miclle/discora/hardware/enclosure/README.md

# Discora V4 · 三主体 PLA 外壳

当前操控布局采用 [ADR-0047](../../docs/decisions/0047-control-spacing-and-knob.md)，四键左移4 mm、旋钮右移4 mm并向提手移2 mm，十字增至28 mm。主体配套版本为 **ADR-0046 P3 短渐扩口 + ADR-0045 P2 圆角梯形开放侧口**。三主体、声道连通、左右镜像、装配路径和切片已检查；完整件的打印、支撑清理、装配、强度、温升、密封及声学仍待实测。P3 喇叭安装座试片已打印并确认装配无问题。

- [正式打印套件：11 件 STL、6 盘 3MF](print/README.md)
- [唯一彩色尺寸与装配图册：12 页 A3](drawings/Discora-V4-drawing-book-color.pdf)
- [可编辑 FreeCAD 模型](Discora.FCStd)
- [打印设置、装配顺序与验收](../../docs/enclosure-printing.md)
- [图册内容与生成方式](../../docs/enclosure-drawings.md)

## 当前结构

P1 合并前壳、提手、护网及操控安装座；P2 合并后壳、侧壁、圆角梯形开放侧口、底托与固定座；P3 承担双声腔、独立转弯导管、喇叭安装座和电子托架。P2 是外部箱体，不构成 P3 导管壁，不对 P2/P3 接口增加密封圈或跨件粘接。

P3 双声腔背面齐平，可直接贴打印板。后侧洞洞板固定点为（A，O），世界坐标 X=54、Y=58.56 mm。安装框后缘及螺柱采用斜面与永久连接筋承接，保留已经试装通过的座面、8 个螺柱及盲孔。两根各 Ø1.8 mm 的喇叭线从顶部出线，安装座外周及出线处采用可移除封堵。见 [ADR-0039](../../docs/decisions/0039-p3-flat-back-printing.md)、[ADR-0041](../../docs/decisions/0041-p3-speaker-sealing-and-wire-exits.md)、[ADR-0042](../../docs/decisions/0042-p3-printable-frame-transitions.md)。

主通路名义面积 400 mm²、中心线路径约 46.8 mm，末端最后 4 mm 渐扩至约 587.22 mm²；圆角 R2.2，横截面口沿名义厚 1.8 mm。P2 外口为圆角梯形，外口包络约 38.48×28.20 mm、R5.6；P2/P3 保持 0.7 mm 滑配间隙。原内凹饰片、连接筋及 P2 长短管已经取消。结构尺寸不代表已完成声学调谐。见 [ADR-0043](../../docs/decisions/0043-independent-speaker-ducts-and-open-outlets.md)、[ADR-0045](../../docs/decisions/0045-trapezoid-exterior-outlets.md)、[ADR-0046](../../docs/decisions/0046-p3-terminal-mouth.md)。

P2 四处 P3 固定座保留 8×8×4 mm 三角筋，后斜面两处背锁座保留短加强筋；图册第 10、11 页给出尺寸与工具通路。下方背锁通道深 78.8 mm，需细长螺丝刀，螺钉头径不超过 4 mm。实际扭矩和反复拆装寿命待验。

## 打印件清单

| 成品 ID | 功能 | 数量 |
| --- | --- | --- |
| `FrontShell` / P1 | 前壳、提手、护网、屏幕及四键安装座 | 1 |
| `RearShell` / P2 | 后壳、侧口、底架、电池与光驱固定结构 | 1 |
| `SpeakerCarrier` / P3 | 双声腔、独立导管、喇叭座、功放与洞洞板托架 | 1 |
| `PlayPauseKey` / `EjectKey` / `PrevKey` / `NextKey` | 橙色键体、齐平白色符号 | 4 |
| `ButtonRetainer` | 四键焊线支架 | 1 |
| `DisplayRetainer` | OLED 可拆压框 | 1 |
| `DriveRetainer` | 光驱可拆压条 | 1 |
| `Knob` | 黑色十字旋钮、齐平白色指示条 | 1 |

共 11 件刚性 PLA；软脚垫、OLED 自带玻璃、电子模块、螺钉、绑带和导线另购。正式 3MF 保留材料分区、摆放及支撑设置；P2 两项支撑限制关闭，P3 开启，不能互相套用。

## 尺寸与布局

单位 mm；X 向右、Y 向后、Z 向上，中心面 X=0。除既有操控布局外，外壳、提手、格栅和声学结构按左右镜像设计；内部 SATA 和电子接口按实际位置避让。

| 对象 | 当前名义尺寸或位置 |
| --- | --- |
| 整机 | 宽 170 × 深 93 × 高 243.263，含脚垫；不含脚垫高 240.263 |
| 主体壁厚 | 前壳、后壁、侧壁、底板及后斜顶 5；局部安装结构另计 |
| 前／后斜肩 | 水平宽 44，斜宽 53.976，角度 35.395° |
| 提手 | 净开口 90×24，上下横梁各 10.5，顶面 Z=241.263，厚 5 |
| 碟口 | 水平投影 124×5.5，中心 Y=79.05，竖直退碟 |
| 中央格栅 | Ø130 正面圆口；护网底片 Ø136、内凹 2.5、厚 2.5；孔径 Ø1.88、孔距 2.9 |
| 单只喇叭包络 | X/Y/Z=45/41/80，中心 X=±26、Z=76，贴合面 Y=10；前深 2、后深 39 |
| 喇叭安装座 | 开口 71.5×39.3（Z×X）、R12.5；孔距 70×36；Ø2.3 盲底孔深 10.5 |
| 单侧声腔及导管外包络 | 79.3×57.5×89，Z=31.5…120.5；这不是净声学容积 |
| UJ-898 | 最大包络 128×10.8×130，Y=76.2…87、Z=29.5…159.5；后壁垫片预留 1 |
| SATA 接头与线缆 | 接头 37.7×7、后伸 20.4；线缆侧伸 14.5，侧壁净空 1.5；实际弯折待验 |
| 电池 | 平排 5600 mAh，112×70×20，X=±56、Y=6…76、Z=8…28 |
| 洞洞板 | 主板形 100×55×1.6；含左耳整体宽 111，右前缺口 16.75×32；板底 Z=142.8 |
| PCB 音量模块 | 板 35×26.2×1.5；含插头／引脚总厚 15，整体绕轴转 90° |
| OLED | PCB 35.4×33.5×1.2；玻璃内退 1，四点定位、可拆压框 |

光驱测量见 [UJ-898](../MATSHITA-UJ-898/README.md)；喇叭数据及试片结果见 [喇叭](../Speaker-80x45-4ohm-10W/README.md)；板卡与线束见[洞洞板布局](../../docs/perfboard-layout.md)。模型中的最大硬件包络、工具包络和线缆预留用于几何检查，不能代替实际接口、线规和弯折测量。

## 验证与重现

当前 CAD SHA-256：`2d704f403a48870832338c8d0ac6c0f71b357f08b3bdcb7c0f777cb0e19f9003`。

- [正式打印包检查](print-release-checks.json)：11 个闭合网格、六盘 1180 层、材料与支撑参数、文件摘要、零网格修复。
- [整机检查](validation.json)：44 个成品对象、有效实体、已定义干涉及左右对称检查。
- [七条拆装路径](assembly-paths.json)：断线、卸紧固件及对应前置拆卸条件下通过；抬升和旋转采样不等于连续运动证明。
- [当前洞洞板与线束检查](current-perfboard-checks.json)：三点固定、导线预留、60 mm 维护位及按序拔插；实际线束应力和手指握持未测。
- [P3 声道及末端](p3-terminal-mouth-checks.json)：有效连通气路、独立声腔、完整出口投影、座面保持和原 18 处悬空复核。
- [P2 开放侧口](p2-trapezoid-outlet-checks.json)：侧口收口支撑审核；通过 P3 报告的 P2 零差集衔接至当前版本。

历次 ADR 与检查报告保留设计取舍和对应版本的证据，不作为当前打印文件入口。图册以当前保存实体重新投影，通过 [操控布局检查](control-layout-checks.json) 衔接历史图册证据；旋钮的材料面序由当前双色导出检查记录。

整机生成入口为 [build.FCMacro](build.FCMacro)，保存模型后用 [validate.FCMacro](validate.FCMacro) 及相关检查脚本验证。导出、切片命令见[打印说明](../../docs/enclosure-printing.md#重现)，出图命令见[图纸说明](../../docs/enclosure-drawings.md#更新图册)。日常复查输出到 `tmp/`，不要覆盖含调整前基线的历史报告。所有切片脚本仅在本机运行，不连接打印机。
