miclle/discora/hardware/Potentiometer-B50K-Switch/README.md

# B50K 双联带开关电位器／PCB 插接模块

## 当前选型：PCB 插接模块（2026-11-14）

用户改选照片中的 B50K 插接模块，并确认以下尺寸。此前裸电位器商品链接及特性表属于历史选型，**不是新模块的商品来源或额定值证明**。

| 项目 | 用户确认值 |
| --- | --- |
| PCB 宽 × 沿轴深度 × 板厚 | 35 × 26.2 × 1.5 mm |
| 垂直 PCB 的总厚度 | 15 mm，已含引脚和插好后的插头；不额外叠加插头厚度 |
| 轴 | 总长 15 mm，其中花轴长 10 mm |
| 对齐 | 轴线沿 PCB 宽度居中；PCB 靠轴端板边与电位器安装面齐平 |

照片中 PCB 与轴平行。CAD 将组件绕固定轴线转 90°，使板宽沿前斜面上下方向展开，避开主控元件包络。安装前断开线束，先将组件和螺母固定，再按实物关断止挡对准旋钮指示条压入；插拔时托住 PCB。拆卸时先取下整个前壳，再拆旋钮、螺母并将模块向内退出，不在机内直接后拔。板上两个孔没有尺寸依据，不增加假定孔位或螺柱。

主体 9.5×14.5×11.2、轴径 Ø5.8、螺纹 Ø6.8×5、螺母及主体引脚侧偏心 2.7 mm 沿用旧选型名义值，尚未作为新模块实测确认；PCB 示意贴靠原主体引脚面。插座及板底引脚使用矩形预留体，不代表真实针序、轮廓或焊盘。干涉检查填满完整 35×26.2×15 包络，不利用简化形状空隙；远端线束走线、拔插操作行程及电气兼容性仍需实物确认。

当前机械适配和检查见 [ADR-0036](../../docs/decisions/0036-pcb-volume-module.md)、[检查报告](../enclosure/volume-pcb-checks.json)。新模块尚未实物装配或通电验收。

## 历史裸电位器资料

记录日期：2026-11-10。用户选定用于 Discora 音量调整的[淘宝商品及 SKU](https://item.taobao.com/item.htm?id=630267024761&skuId=4742190163296)。页面自动读取失败；型号和尺寸来自用户提供的数据及[商品参考图](supplier-reference.png)，不视为独立核验的厂家图纸。

## 尺寸依据

单位 mm。用户确认可旋转花轴外径为 5.8，轴心到主体引脚侧外壁距离为 2.7；随后补充螺母对边 9.8、厚 1.9。

| 项目 | 用户提供尺寸 |
| --- | --- |
| 型号／结构 | B50K，双联，8 脚，带开关 |
| 从主体安装面到轴端 | 15 |
| 螺纹段 | 长 5，外径 6.8；牙距未提供 |
| 可旋转花轴 | 长约 10，齿顶外径 5.8；齿数／齿形未提供 |
| 主体 | 长 11.2 × 宽 9.5 × 高 14.5 |
| 引脚 | 在宽 9.5 的侧面，向外伸出 3.5；精确脚距和排布未提供 |
| 轴偏置 | 轴心距引脚侧外壁 2.7 |
| 六角螺母 | 对边 9.8，厚 1.9；对角由正六边形推导约 11.316 |

CAD 将 14.5 解释为沿轴方向的主体高度，9.5 为引脚面的横向宽度，11.2 为从引脚侧到对侧的长度。局部 X 向右、Y 向壳内、Z 沿斜面朝上：主体 X=−4.75…4.75、Y=3.6…18.1、Z=−2.7…8.5；引脚朝斜面下方。该方向是安装设计，不是从图片推断的引脚编号。

## 电气、机械与耐久特性原图

用户随后补充了[商品特性表原图](supplier-characteristics.png)，包含电气、机械和耐久三部分。**表中总阻值为 10K，而本次选定型号为 B50K；两者不是同一标称阻值，尚未确认该表是否覆盖所选 SKU。** 下表只转录图片，不将其全部升格为 B50K 的已确认规格，也不改动已选型号。原图哈希与差异说明已补入 `source.json`。

| 图片项目 | 图片所列值／说明 |
| --- | --- |
| 总阻值／容差 | 10K；±20% |
| 阻值曲线 | B taper；未附完整曲线图 |
| 电阻体额定功率 | B taper：0.05 W；其它 taper：0.02 W |
| 最大工作电压 | 50 V AC / 10 V DC；与开关额定值是不同条目 |
| 残留电阻 | R1-2 ≤10 Ω；R2-3 ≤20 Ω；编号不能直接映射实物引脚 |
| 旋转杂音 | ≤100 mV；测量电路／条件未随图提供 |
| 双联同步误差 | “/”，未提供指标 |
| 绝缘与耐压 | 绝缘电阻图示 >100 MΩ，DC 250 V；耐压 AC 250 V，1 分钟 |
| 开关接触电阻 | ≤100 mΩ |
| 开关额定负载 | 1 A at DC 12 V；尚未确认适用本次 B50K |
| 总旋转角度 | 300° ±10° |
| 旋转力矩 | 20～200 gf·cm |
| 开关旋转角度／作动力 | ≤50°；≤500 gf·cm |
| 止挡强度 | 图示 >4 kgf·cm |
| 轴推拉强度 | 原图写作 >10 kgf·cm，推拉力使用力矩单位存在疑点，保留原文待供应商确认 |
| 轴摆动 | ≤0.7 × L / 20 mm（p-p），L = shaft length；L 的具体取值基准未提供 |
| 旋转寿命 | 图示 >10,000 次；试后阻值变化 ±15% 内、旋转杂音 ≤150 mV |
| 开关寿命 | 图示 >10,000 次 |
| 工作温度 | −10～+70 °C |
| 焊接耐热条件 | 自动焊：260±10 °C、3±1 秒；手工焊：300±5 °C、3±1 秒；测试位置见原图 |

以上均为供应商图示值，非 Discora 实测。1 A / DC 12 V 是开关条目，不能用电阻体的 50 V AC、耐压 AC 250 V 或绝缘测试 DC 250 V 替代。该表未解决 B50K 型号对应、整机启动电流或主电源开关选型问题；本次只归档，不改变供电方案。CAD 的连续 360° 外包络检查保守覆盖图示 300°±10° 行程，不以此声明实际电位器可无限旋转。

## 项目接入与状态

- 选型及几何适配为 `implemented`；实际安装、接线和音量／开关功能尚未 `bench-tested`。
- 此元件替代此前“拆下功放原电位器”的机械占位方案；与功放原焊盘的电气替换关系仍待核对。
- 照片标注双联 8 脚、带开关；不从照片指定 L/R、滑动端或开关脚号。上电前用万用表确认两组三端及开关触点、旋转方向、阻值变化和断开位置。
- 补充特性表给出开关 1 A / DC 12 V，但该表为 10K 且与 B50K 的对应未确认，不把开关直接定义为整机电池主电源开关；本次没有修改供电接法或固件。
- B50K 标识不替代实测阻值曲线、双联跟踪误差与功放输入兼容性验证。

## 安装

前壳通孔 Ø7.2，外侧凹位底径 Ø24.8、深 1.6，入口 0.4 倒角扩至 Ø25.6；主体安装面在深度 3.6，因此凹位底与主体之间仍保留 2 mm 夹持面。螺纹 5 − 面板 2 − 螺母 1.9 = 1.1 mm 伸出余量，不含另加垫圈。主体侧隙名义 0.3；引脚 3.5 mm 包络外再留 3.8 mm 焊线区域。矩形主体槽辅助限转，螺母承担夹紧，实际锁紧力及 PLA 抗蠕变待验证。

旋钮改为 Ø24×1.4 薄底盘、跨度 24／臂宽 6.8 的细圆角十字。底盘下沉 1 mm，顶面高出面板 12.9，零件总高 13.9；凹位底间隙 0.6、径向间隙 0.4。短锥形根部封闭螺母腔，底部 Ø12 避让腔包容螺母及螺纹。顶部 0.7×2.2 mm 指示条采用深 0.6 mm、与顶面齐平的白色 PLA 实体，与黑色主体双色打印。

按用户要求取消侧面螺钉孔，直接压入花轴。Ø6.0 基孔内有六条 0.6 mm 宽压配筋，筋尖内切直径 5.6；对 Ø5.8 花轴圆柱包络形成最大 0.1 mm 径向名义过盈，实际由花轴局部压溃／咬合筋尖，不伪造未知的齿形和齿数。孔顶距轴端 0.3、顶部最薄 1.2。先用 5.5／5.6／5.7 三档筋尖直径试片核对松紧，再试印完整旋钮验证开关力矩、保持力及反复旋转；不能只凭 CAD 过盈声明压配成功。

模型、检查及装配顺序见 [ADR-0032](../../docs/decisions/0032-b50k-cross-knob.md)。图像原样保存，来源与哈希见 [source.json](source.json)。
