miclle/discora/hardware/TPA3118D2/README.md

# TPA3118D2 功放板资料

整理日期：2026-11-03。用户已有并选为当前首选的 [淘宝商品](https://item.taobao.com/item.htm?id=591057362413)，随附图片标识为 SKU 009169。图片来自用户导入的卖家资料；与实物的版本对应关系仍待核对。2026-11-07 台架 PCM5102A → 本功放 → 双喇叭已完成短时立体声试听，完整功率、散热和整机验收未完成，见[音频记录](../../docs/records/2026-11-07-cybertrack-audio-crosscheck.md)。

## 保留文件

| 文件 | 用途与边界 |
| --- | --- |
| [卖家参数表](amplifier-supplier-specifications.jpg) | 保留商品标称及来源证据，不作为实测指标 |
| [背面尺寸图](amplifier-back-dimensions.jpg) | PCB 标称 66 × 53 mm，背面接口丝印和安装孔位置参考；不提供精确孔距或整板总包络 |
| [正面接口图](amplifier-front-connections.jpg) | 音量旋钮、3.5 mm／三针音频输入、电源口和左右喇叭端子位置参考 |
| [原件校验与整理记录](readback.json) | 原图名称、当前名称、字节数、SHA-256 和归档统计 |

## 使用边界

- 参数表中的“2 × 45 W”“DC12V–28V（推荐 24V）”“3A”等均为卖家标称，负载、失真、持续输出及散热条件未核实；不据此确定工作电压或电源规格。
- 需实物核对芯片丝印、PCB 版本、电源极性、输入引脚顺序、端子、总高度及安装孔距。照片不能替代实物逐项检查。
- 66 × 53 mm 是卖家标注的 PCB 尺寸，不包括旋钮等突出部分；2026-11-05 的 [V4 紧凑布局](../enclosure/README.md)已改用横置 66 × 53 mm PCB，板上元件高度暂留 15 mm、两侧接头各留 15 mm；这些额外尺寸是设计预留，未实测。
- 既定连接为 DAC 模拟 L/R 输出接功放输入，BTL 喇叭端按各自正负极接线；具体电源与接入验收以 [硬件清单中的功放选型](../../docs/hardware.md#功放选型tpa3118d2短时试听通过) 和 [音频验收说明](../../docs/audio-output.md) 为准。

## 分离音量电位器的布局规划

此前允许将板上原电位器拆下并引线安装；2026-11-10 用户改为选定独立的 [B50K 双联带开关电位器](../Potentiometer-B50K-Switch/README.md)。前壳与十字旋钮已按用户提供的尺寸适配，见 [ADR-0032](../../docs/decisions/0032-b50k-cross-knob.md)。机械模型不证明与本板原电位器的阻值、曲线或焊盘一致；两组三端、开关触点、排线和原板接入方式仍需实物核对，尚未拆焊或完成新电位器通电验收。补充的 10K 特性表标注开关 1 A / DC 12 V，但与所选 B50K 对应未确认，本次不确定其整机供电用途。

冗余宣传主图已移出项目。整理前四张原图及逐文件清单保存在仓库外归档 `discora-hardware-2026-11-03`，具体位置见本次交付记录。保留图片仅重命名，内容及权利标识不变；不将卖家资料视为本项目实测证据。

2026-11-14 用户改选带 PCB 插座的 B50K 模块（35×26.2×1.5，含插接总厚15）；机械适配见 [ADR-0036](../../docs/decisions/0036-pcb-volume-module.md)。插座不改变上述电气核对要求，也不证明开关可直接承担整机供电。
