miclle/discora/hardware/OLED-1.3-128x64/README.md

# 1.3 英寸 OLED 模块资料

整理日期：2026-11-03。来源为用户导入的中景园厂商资料及商品图片，对应采购记录的 [淘宝商品](https://item.taobao.com/item.htm?id=535844615619)。商品页未独立核实，所选 SKU 和到货实物仍待确认。以下内容属于供应商资料，不代表 Discora 已完成硬件验收；2026-11-04 已实现 SH1106 显示驱动，2026-11-08 用户确认实物为 SH1106，通信及无介质画面通过。

## 保留文件

| 文件 | 用途与边界 |
| --- | --- |
| [模块规格书](datasheets/ZJY130I0400WG02.pdf) | 带 PCB 的四针 IIC 模块；第 6 页为结构图，第 7 页为接口和地址选择图片 |
| [SH1106 控制器手册](datasheets/SH1106.pdf) | 控制命令、显存及通信协议参考；不能单凭随附手册确认实物芯片 |
| [裸屏规格书](datasheets/1.3-ZJY130-2864KSWLG01.pdf) | 裸屏及 FPC 的尺寸、电气和接口资料；不等于带 PCB 的模块尺寸或供电条件 |
| [商品规格图](oled-module-specifications.webp) | 型号、显示区域、板尺寸及 SKU 差异的卖家说明 |
| [正反面与接口图](oled-module-interfaces.webp) | 排针顺序、地址选择焊桥、板卡外观；保留原始错误标注供追溯 |
| [尺寸与接线图](oled-module-dimensions-wiring.webp) | 安装孔、显示区域、排针和侧视包络参考 |
| [原件校验与整理记录](readback.json) | 原始文件名、当前路径、字节数、SHA-256 和归档统计 |

## 供应商资料与待确认项

- 模块结构图标注 SH1106、128 × 64、IIC，PCB 35.4 × 33.5 mm，显示区域 29.42 × 14.7 mm；这些是图纸值，不是实测尺寸。
- 模块规格书第 6 页标注 SH1106，第 24 页注意事项却出现 SSD1306；商品规格图还提到可向客服选择 SSD1306。不能把不同型号的命令和初始化序列混用，最终以所选 SKU、实物及显示测试确认。
- 模块图示排针顺序为 VCC、GND、SCL、SDA；商品图另说明可提供 GND、VCC 顺序的版本，接线前须看实物丝印。
- 商品接口表将 SCL、SDA 写成 SPI 信号，与模块 IIC 标注不一致；不能据此改接为 SPI。
- 模块结构图标注 3.3 V，商品图写 3.3–5 V；板级稳压、上拉电源和信号电平均待确认，商品供电范围不等于 ESP32-S3 GPIO 可承受的电压。
- 驱动采用 7-bit 地址，默认 0x3c、可配置 0x3d；不填含读写位的 0x78／0x7a。2026-11-04 已实现 GPIO10 SDA／GPIO11 SCL 的 SH1106 驱动，2026-11-08 的 0.12.2 配置在 0x3c 初始化成功，用户确认无介质画面文字清晰完整，见[记录](../../docs/records/2026-11-08-buttons-oled.md)。

## 外壳机械适配

2026-11-10 已按[尺寸与接线图](oled-module-dimensions-wiring.webp)的结构图更新 CAD：PCB 35.4 × 33.5 × 1.2 mm，四孔 Ø3、孔距 30.4 × 28.5，玻璃 34.5 × 23 × 1.4，有效区 29.42 × 14.7，以及 14 × 4 下缘缺口。有效区中心比 PCB 中心高 2.05 mm，保持机身 X=0 居中；内喉口 30.42 × 15.7、R0.6，外口 32.82 × 18.1、R1.8；玻璃前面内退 1.0 mm。

内侧沉槽、四个 Ø2.6 定位柱、可拆压框和弯针接头包络已加入模型；压框两侧用名义 M2×6 锁紧，避免近外表面安装时螺钉穿透正面。侧视 11.3 mm 按玻璃前面至针尖解释；接头塑壳截面、插线空间和螺钉／工具尺寸另标为设计预留。详见 [ADR-0028](../../docs/decisions/0028-oled-mechanical-mount.md)及[保存模型检查](../enclosure/oled-checks.json)。这仍是供应商图纸与 CAD 证据，实际模块尺寸、插头、打印孔补偿和螺钉配合待试装。

## Discora 接线规划

2026-11-04：规划 ESP32-S3 **3V3 → VCC、GND → GND、GPIO11 → SCL、GPIO10 → SDA**。GPIO10／11 已在主控供应商图纸引出，未占用当前音频与按键引脚；接线对应 `implemented` 的 SH1106 驱动，播放器配置默认启用；2026-11-05 的未接屏配置探测超时；2026-11-08 已接屏并重新启用，0x3c 初始化与无介质画面通过，随后盘尾 TRACK 01／STOPPED 也获确认；完整动态显示待验收，见 [显示说明](../../docs/oled-display.md)。

上电前确认模块支持 3.3V、实物 VCC/GND 顺序、板载上拉连接到 3.3V，以及主控供电余量。SDA/SCL 不得上拉到 5V，不能从 DAC 的 A3V3 给屏幕供电。控制器、实际地址和显示效果仍待核对。逐线说明及唯一展示的整机接线图见 [整机文档](../../docs/wiring.md#13-英寸-oled-四线接线implemented实屏待验收)。

OLED 可以从开发板 3V3 取电；接入后检查负载下电压、主控复位与稳压器温升。它与 DAC 的 5V 分支可以共享同一上游电源，不要求两个独立电源。开发板的 5Vin／IN-OUT 限制只涉及相应 5V 路径，不能把 5Vin 当成 OLED 的 3.3V 接点，详见 [开发板取电说明](../../docs/wiring.md#开发板取电3v35vin-与-in-out)。

## 已归档内容

`02-1.3OLED程序源码/`、`03-OLED取模教程/` 及 `.DS_Store` 已移出项目。跨平台例程、配套库、构建产物、IDE 配置和 Windows 取模工具不作为本项目依赖。抽查 Arduino 例程声明只供学习、其他用途需作者许可；不直接复制到固件或作为公开仓库源码发布。

整理前完整原件及逐文件清单保存于仓库外归档 `discora-hardware-2026-11-03`，具体位置见本次交付记录。保留 PDF 和图片仅重命名或保持原路径，内容及原有权利声明不变；资料留存不代表新增再分发授权。采购与验证边界见 [硬件清单](../../docs/hardware.md)。
