miclle/discora/hardware/ESP32-S3-N16R8/README.md

# Discora — ESP32-S3 N16R8 板卡资料

整理日期：2026-10-31。本目录只保留 Discora 接线、引脚分配和尺寸核对所需的资料。供应商图纸标注 `ESP32-S3-COREBOARD` / `V1.4`；当前实物的 PCB 修订版尚未确认，不能直接套用乐鑫官方 DevKitC-1 的板级定义。第三方资料保留原始字节，其标识和权利不变。

## 保留文件

| 文件 | 用途与边界 |
| --- | --- |
| [V1.4 原理图](ESP32-S3-SCH-V1.4.pdf) | USB、供电、串口桥及排针连接的主要参考；不代表实物逐网一致 |
| [另一版本原理图](ESP32-S3-SCH.pdf) | Discora 首次上板记录已引用；与 V1.4 文件不同，保留用于图纸对照与历史追溯 |
| [毫米尺寸图](ESP32-S3-Metric.pdf) | 板轮廓、排针间距和图示天线伸出；不含整板高度、安装孔径和装配公差 |
| [芯片技术规格书](ESP32-S3开发板.pdf) | 实际内容为 ESP32-S3 系列芯片技术规格书 v2.2，不能替代板级图纸 |
| [正面参考照片](ESP32-S3-front.jpg) / [背面参考照片](ESP32-S3-back.jpg) | 随资料导入的板卡外观、接口和丝印参考；未确认与当前 Discora 实验板为同一实物 |
| [结构化板卡摘录](board-data.json) | 图纸排针、标称尺寸、资源限制及本项目候选音频引脚；不继承其他项目的验证结论 |
| [原件校验清单](readback.json) | 六份原件的 SHA-256、大小及压缩包成员比对结果 |
| [清理记录](cleanup-record.json) | 删除文件的路径、大小、哈希及原因；此清单不包含可恢复的文件内容 |

## Discora 使用的接口

方位以元件面朝向观察者、天线在上、USB 口在下为准；背面视图左右相反。

| 接口或资源 | 图纸连接 / 当前用途 |
| --- | --- |
| COM / USB1 | 图纸经 CH343P 接 UART0 GPIO43/44；Discora 用作电脑烧录及日志口 |
| USB / USB2 | D− 接 GPIO19，D+ 接 GPIO20；Discora 用作原生 USB Host |
| USB-OTG | 0 Ω 支路与 D2 并联，连接 USB2 VBUS 与板上 5V；**不是 GPIO3 接地选项** |
| USB-JTAG | 另一条 GPIO3 配置支路，经 R11 10 kΩ 接 VDD33 |
| IN-OUT | 与排针 5Vin 支路 D3 并联；与 USB-OTG 为不同支路 |
| GPIO4 / 5 / 6 | 当前 I²S 诊断的候选 BCLK / LRCK / DATA；可配置，尚未完成 DAC 接线验收 |
| GPIO35 / 36 / 37 | N16R8 八线 PSRAM 资源，不能因图纸引到排针便用于外设 |
| GPIO0 / 3 / 45 / 46 | 启动绑带，保留；GPIO48 为板载 RGB，GPIO39–42 涉及 JTAG |

完整排针顺序见结构化摘录和原理图。供应商毫米图的底板标称长宽为 57.15 × 27.94 mm，含图示天线总长 63.39 mm，两排针中心距 25.40 mm，22 针首末间距 53.34 mm。它们不是当前实验板的实测包络。

旧索引误将 USB-OTG 归入 GPIO3 接地配置，本次已按原理图纠正。供电桥接会改变隔离路径；实际接线和已测边界以 [组装说明](../../docs/assembly.md)、[首次上板记录](../../docs/records/2026-10-31-m1-first-boot.md) 和 [空 Hub 记录](../../docs/records/2026-10-31-m1-empty-hub.md) 为准。音频接线见 [DAC 输出准备](../../docs/audio-output.md)，工程进度见 [当前状态](../../docs/status.md)。

## 外设取电与 5Vin 注意事项

V1.4 图纸的 J1-21（5Vin）经 D3 向板内 5V 供电，`IN-OUT` 并联旁路 D3。**仅 COM USB 供电且 IN-OUT 断开时，不能默认从 5Vin 排针向外供电。**IN-OUT 接通会取消这一路二极管隔离，不是稳压或限流；不要为取电直接短接，也不要与 USB-OTG（D2 旁路）混淆。实物版本、焊装和通断须核对。

OLED 可从 3V3 取电；DAC 使用已确认的 5V 支路。先核对输入供电和稳压余量，测量空载及接入模块后的电压、观察复位和温升。无可用 5Vin 输出时，可从同一已确认的稳压 5V 电源分支供 DAC 并共地；不同电源正极不直接并联。完整条件见 [整机供电说明](../../docs/wiring.md#开发板取电3v35vin-与-in-out)。

## 已清理的内容

- 供应商 ZIP/RAR 套包：所需图纸已独立保留，V1.4 原理图和毫米图已重新逐字节核对包内成员一致。
- MicroPython 固件、Python/Arduino 例程和环境安装说明：Discora 使用自己的 ESP-IDF 固件。
- 商品宣传图、通用模组对比图、重复的 mil 尺寸图，以及本地过时元数据。
- 随目录导入的其他项目启动、内存和 BOOT 停止验证报告及日志：不能作为 Discora 验收证据。

Discora 自身的实验记录保留在 `docs/records/`。本次只整理资料，没有连接设备、烧录或新增硬件验收结论。

## GPIO7 退盘输入

Discora 0.9.0 默认查询/播放器使用 GPIO7（图纸 J1-7）作为内部上拉输入，常开轻触按键接到 GND。它与 GPIO4/5/6 音频默认值不冲突；基本按键触发及实际退盘已获用户成功反馈；板卡逐网、电气测量及其余场景未验收。见[接线与配置](../../docs/eject-button.md)。

## GPIO8／GPIO9 换轨输入

Discora 0.9.1 播放器模式使用 GPIO8（J1-12）上一曲、GPIO9（J1-15）下一曲，分别常开按键接 GND、内部上拉。查询模式禁用；软件时钟播放器已部署，三路 GPIO 初始化通过，实体按键换轨未验收，排针位置依据供应商资料，以实物丝印为准。见[换轨接线与配置](../../docs/track-buttons.md)。

## 四键相邻排针（0.12.1）

当前四键 profile 使用右排 J2-4～7，依次 GPIO1 播放／暂停、GPIO2 上一曲、GPIO42 下一曲、GPIO41 退碟；J2-1 为公共地。连续四个信号可合成排线，GPIO41／42 配成普通上拉输入，不与外部 JTAG 共用；无需改变 eFuse 或供电焊桥。旧查询／播放器默认针序仍保留，部署须选择匹配的四键 overlay。实物接线与测试待后续，见[四键说明](../../docs/playback-controls.md)。
