miclle/discora/docs/hardware.md

# 实验硬件与电源

## 硬件清单（选型与验收分开记录）

当前台架接法及实验结论见[工程状态](status.md)；商品标称、电气测量和最终机内装配分别记录。

| 部件 | 候选 | 现状与注意 |
| --- | --- | --- |
| MCU | ESP32-S3 开发板，4 MB Flash 或以上 | 选有 USB OTG 引出的型号；部分接口仅为 USB-UART |
| 光驱 | [MATSHITA DVD-R UJ-898](../hardware/MATSHITA-UJ-898/README.md) | 已有；吸入式、SATA/ATAPI、支持光盘刻录；2026-11-11 实物照片与 A–F 尺寸已归档，2026-11-12 CAD 已按实测适配，采用后壁贴靠和两螺钉压条，实物装配仍待验证 |
| 桥接器 | SATA → USB 光驱适配器 | 已有；确认可透传 SCSI/MMC |
| DAC | PCM5102 / PCM5102A 立体声 I²S 模块 | 已记录 PCM5102 商品，见下方采购清单；用户已确认到货，已保存正反面参考图，确切模块待核对，线路输出需接有源设备 |
| 功放 | TPA3118D2 双声道模拟输入 Class-D 功放板 | 用户已有；已接 PCM5102A 完成短时立体声试听，额定功率、温升及整机验收仍待测 |
| 喇叭 | 80 × 45 × 42 mm 全频大动态钕磁单元 | 单只标称 4 Ω、10 W、峰值 18 W；用户资料已记录，商品参数及新箱体声学未验收，概念 CAD 已有双声腔 |
| 5V 供电 | DCE001 固定 5V 降压模块 × 2 | 用户已选定，分别供主控与光驱；接入为 planned，自然散热按商品要求在 2A 内，光驱峰值与温升待测，见[模块资料](../hardware/DCE001-5V/README.md) |
| 电池包 | 18650 三串两并，5600mAh 成品包 | 用户已选定淘宝 SKU，报价 ¥59.22；标称 11.1V、约 62.16Wh，接入为 planned，详见[电池资料](../hardware/Battery-3S2P-5600mAh/README.md) |
| 输入 | 12 × 12 mm 轻触按键 × 4，音量操控另计 | 播放／暂停、上一曲、下一曲、退碟；用户提供整体厚 6、凸起高 2.8、引脚长 3.7 mm，见[按键尺寸与照片](../hardware/Tactile-Switch-12x12/README.md)；6 mm 已确认包含凸起，本体按 3.2 mm；四键 CAD 已实施，实际圆头、引脚和装配待核对，非 M0 必需 |
| 音量 | [B50K 带开关 PCB 插接模块](../hardware/Potentiometer-B50K-Switch/README.md) | PCB 35×26.2×1.5、含插头／引脚总厚15、轴长15／花轴长10；绕轴90°安装；原主体、轴径与螺纹沿用名义值，电气及实物配合待验收 |
| 刻录源 | microSD 模块 | 仅 M4 研究时需要 |

## 硬件采购清单

| 记录日期 | 商品名称 | 商品链接 | 用途 | 数量／实付价格 | 采购与验收状态 |
| --- | --- | --- | --- | --- | --- |
| 2026-11-03 | PCM5102 音频立体声数模转换器 DAC 解码板 | [淘宝商品（967516294822）](https://item.taobao.com/item.htm?id=967516294822) | 用于 ESP32-S3 I²S 转双声道模拟线路输出 | 未提供 | 用户已确认到货；已保存参考图和 31 × 17 mm 图示尺寸，短时台架立体声输出已实测；独立电气指标与完整稳定性未验收 |
| 2026-11-03 | 1.3寸OLED显示屏12864液晶屏模块IIC接口 sh1106 sd1306串口屏 | [淘宝商品（535844615619）](https://item.taobao.com/item.htm?id=535844615619) | 拟用于曲目与播放状态显示 | 未提供 | 已接入 SH1106 驱动，用户确认无介质及盘尾停止画面；完整动态显示待验收 |
| 2026-11-03 | TPA3118D2数字功放板2.0双声道2\*45W发烧音频放大板高清DC24V | [淘宝商品（591057362413）](https://item.taobao.com/item.htm?id=591057362413) | 接 DAC 模拟 L/R 输出，驱动左右无源喇叭 | 未提供 | 用户确认已有；短时台架试听通过，功率／温升等指标待测 |
| 2026-11-05 | 全频大动态钕磁喇叭／双单元无源音箱 | [淘宝商品（1021101388923）](https://item.taobao.com/item.htm?id=1021101388923) | 拟使用其中的左右单元，为 CD 机重新设计箱体 | 未提供 | 已记录用户参数及三张参考图；下单、到货状态未提供，电气与声学未验收 |
| 2026-11-05 | 12V 18650 锂电池组，5600mAh 成品包 | [淘宝商品／SKU 5651022295757](https://item.taobao.com/item.htm?id=733234510026&skuId=5651022295757) | 便携播放供电，外围另配 Type-C 充电及稳压模块 | 数量未确认；用户提供报价 ¥59.22，非已确认实付 | 用户已选定；下单及到货未确认，容量、持续电流、保护功能和装配未验收 |
| 2026-11-07 | DCE001 迷你 DC-DC 降压模块，输入 5.5–30V、固定输出 5V | [京东商品（10228520023322）](https://item.jd.com/10228520023322.html) | 电池降压，主控和光驱各用一块 | 选定 2 块；实付未提供 | 用户已选定；已读取所选 SKU 并保存用户参数截图，下单、到货及带载未确认，见[模块资料](../hardware/DCE001-5V/README.md) |

商品名称与链接由用户提供；此前淘宝商品页未能读取，DCE001 京东所选规格已于 2026-11-07 读取，参数截图已归档；供应商标称均不等于实测验收。具体芯片型号（PCM5102 / PCM5102A）、板级供电、I²S 引脚与电平、模拟输出接口及跳线设置，按卖家资料和到货实物核对；接线与验收步骤见 [音频输出准备与到货验收](audio-output.md)。

显示屏商品名称按用户提供的标题记录，其中同时出现 OLED、液晶屏及 `sh1106`、`sd1306` 字样；商品标题不作为芯片身份依据。当前已按 SH1106 128×64、I²C 0x3c 驱动，并获得无介质及盘尾停止画面的用户确认；接线为 3.3V、GPIO10／11。独立芯片鉴定和所有动态画面未完成，见 [OLED 显示说明](oled-display.md)。

2026-11-03 已整理用户导入的 [OLED 模块资料](../hardware/OLED-1.3-128x64/README.md)、[DAC 芯片手册](../hardware/PCM5102-DAC/README.md) 和 [功放板图片](../hardware/TPA3118D2/README.md)。保留原件内容、来源说明及摘要校验，跨平台例程和取模工具归档到仓库外。OLED 资料存在芯片、接口和供电标注不一致；DAC 手册正文为 PCM510xA 系列，尚不能确认实物芯片后缀。资料核对不改变硬件验收状态。

2026-11-10 新增音量元件：[淘宝 B50K／SKU 4742190163296](https://item.taobao.com/item.htm?id=630267024761&skuId=4742190163296)，用户选型、尺寸及图片已归档；数量、实付及到货状态未提供。

## 功放选型：TPA3118D2（短时试听通过）

2026-11-03，用户确认已有 TPA3118D2 和 TPA3116D2 两款功放板，并决定先选 **TPA3118D2** 用于 Discora。随后本板与 PCM5102A、双喇叭完成短时原始 CD 立体声试听，记为 `bench-tested`；完整功率、热与整机可靠性未验收，见[音频对照](records/2026-11-07-cybertrack-audio-crosscheck.md)。

- **选型理由**：当前 [V4 小型双喇叭布局](../hardware/enclosure/README.md)优先考虑安装空间、散热与实际聆听音量，尚无需要大功率持续输出的实测依据。优先验证现有 TPA3118D2；TPA3116D2 保留为较大外接音箱或后续实测需要更大输出时的备选。不能仅凭芯片型号断言成品板更小、底噪更低、更省电或音质更好。
- **商品标称**：标题中的“2 × 45 W”“DC24V”为用户提供的商品描述，卖家页面未能读取，未核实其负载、失真、散热或持续输出条件，不能作为实测功率或直接上电依据。
- **芯片规格参考**：[TI TPA3118D2 官方资料](https://www.ti.com/product/TPA3118D2)列出 24 V、8 Ω 下的 2 × 30 W 配置；具体条件与功率／失真曲线见 [TI 数据手册](https://www.ti.com/lit/ds/symlink/tpa3118d2.pdf)。这是芯片级资料，不证明本板可达到相同输出，也不替代板级供电和散热核对。
- **接入方案**：ESP32-S3 → I²S → PCM5102 / PCM5102A → 模拟 L/R → TPA3118D2 → 左右喇叭。该芯片为模拟输入 Class-D 功放，不能直接连接 I²S。功放使用足额电源支路，不从 ESP32 开发板取大电流；模拟输入信号地按实际板卡接线。BTL 喇叭输出的 L−、R− 不得互连或接 GND。

| 待确认项 | 当前记录 |
| --- | --- |
| 板卡型号／版本、芯片丝印及数量 | 待确认，需实物正反面核对 |
| PCB 长宽、含散热片／端子的总高度、安装孔位 | [供应商图片](../hardware/TPA3118D2/amplifier-back-dimensions.jpg)标称 PCB 66 × 53 mm，实物及完整包络待确认；V4 已改为横置 66 × 53 mm PCB，占位厚度与 15 mm 元件高度预留仍待实测 |
| 板级供电范围、极性、端子与电源额定电流 | 待确认；最终工作电压未定 |
| 模拟输入接口／引脚、增益、音量调节、静音控制 | 待确认 |
| 喇叭阻抗、额定功率、灵敏度与最大允许输出 | 单只商品标称 4 Ω、10 W、峰值 18 W，见[单元资料](../hardware/Speaker-80x45-4ohm-10W/README.md)；功率测试条件、灵敏度及实际允许输出待确认 |
| 左右声道、底噪、开关机爆音及失真 | 短时试听左右清晰、无明显杂音；底噪、爆音及失真指标未测 |
| 目标音量下电流、温升、连续播放及光驱动作时干扰 | 测试结果待确认，未完成整机联调 |

确认板级接线、电源与喇叭参数后，从低音量的独立左右测试音开始，再测试真实 CD 播放。记录实际板卡、供电、负载、音量／增益、测试时长与结果；音频验收入口见 [音频输出准备与到货验收](audio-output.md)。

整机连接与各供电支路见 [整机接线说明与示意图](wiring.md)。

## 喇叭与箱体重设计

2026-11-05 记录用户提供的全频大动态钕磁喇叭：单只长 80 × 宽 45 × 总高度 42 mm，42 mm 指最前方振膜到最后方磁铁的总高度；单只标称 4 Ω、10 W、峰值 18 W。商品资料称原箱体内含两只单元，箱体约长 235 × 高 115 × 宽 65 mm，不含功放。详细来源、三张原图及待测项见 [喇叭资料](../hardware/Speaker-80x45-4ohm-10W/README.md)。

用户认为原商品箱体过大，已开展独立箱体 CAD 设计；实物装配仍为 planned。V4 以竖放的宽 45 × 高 80 mm 双单元包络布置，P3 已按实测 2 / 39 mm 前后深度和四孔间距制作试装座，当前整机尺寸统一见 [CAD 说明](../hardware/enclosure/README.md)，功放横置于喇叭上方，主控置于光驱上部前方，DAC 侧立；提手保留，光驱底面朝后壁，中央底托配两螺钉压条，SATA 接头按实测放在光驱下端，整机 170×93×243.263 mm，左右后腔与外壳轮廓保持对称；音量控制改用带 PCB 的 B50K 双联带开关模块，安装位更新见 [ADR-0036](decisions/0036-pcb-volume-module.md)，十字旋钮保留，电气引线尚待核对；PLA 结构已合并为前壳、后壳、喇叭／电路板支架三个主体，两侧孔并入后壳，前障板功能并入支架；CAD 与 0.4 mm 喷嘴切片通过，实物打印与拆装未验收；见 [CAD 说明与几何检查](../hardware/enclosure/README.md)。盆架角部、固定孔配合、振膜行程和接线余量仍待试装，新箱体的声学表现未验收，不能用台架短时试听替代。

## USB 接线与电源注意

2026-11-05，用户选定 [5600mAh 成品电池包](../hardware/Battery-3S2P-5600mAh/README.md)，参数依据用户提供的商品图和报价，未独立核实在线 SKU。该包为三串锂电原始电压输出，不能当作恒定 12V 电源；Type-C 三串充电、12V 升降压模块尚未定型，边充边播未确认。2026-11-07 已选定两块 [DCE001 固定 5V 降压模块](../hardware/DCE001-5V/README.md)，分别供主控和光驱，接入为 planned；两路输出不得并联，USB VBUS 防回灌路径及光驱带载能力待确认，见 [ADR-0018](decisions/0018-dual-5v-buck.md)。用户已明确选择平排 112 × 70 × 20mm，V4 已适配其商品标称包络并重跑静态几何检查；线材、插头、固定方式及外围电源板仍未完成实物装配验证。机械取舍见 [ADR-0015](decisions/0015-flat-battery-enclosure.md)。取舍见 [ADR-0014](decisions/0014-5600mah-battery-pack.md)。

组装拓扑、UART0、Type-C Hub 角色和首次上电顺序见 [M1 组装说明](assembly.md)。用户已有 ESP32-S3、UJ-898、Type-C Hub 和电源；板卡、Hub、桥接器的具体型号与接线仍待确认。

- ESP32-S3 原生 USB OTG D− / D+ 常对应 GPIO19 / GPIO20；必须核对**具体开发板原理图**是否已经连接到板载 USB 接口。
- USB Host 需要向光驱/桥接器提供合规 **5V VBUS**。不能直接将 USB 光驱挂在 3.3V GPIO 或未经校验的开发板弱供电上。
- 使用独立供电、带电流余量的 USB 接口或供电 Hub 作为最初的实验路径；保持 USB 数据连接与公共地正确。
- 上电、吸盘、加速旋转和读盘过程中测量 5V 是否跌落，监控 ESP32-S3 brownout/reboot。
- 确认桥接器在 Full-Speed 模式下可枚举；检查接口是 BOT (0x50) 还是不受首版支持的 UAS (0x62)。
- 原生 USB PHY 用于 Host 时，日志走 UART0；如板上没有独立 USB-UART，需要 3.3V 逻辑的外接转接器。PD 供电口不等于 Host 数据口。
- 音频 L/R 从 DAC 输出；需要驱动 4Ω/8Ω 无源喇叭时增加双声道功放。
- 光驱电机供电、模拟音频接地布线和功放电源噪声应分别评估。

## 成本目标

目标是相比 Linux SBC 显著降低控制器成本，但**不预先承诺具体人民币 BOM 金额**。明确记录 MCU、USB 供电、DAC、功放、接口、PCB 及光驱成本；已拥有的零件仍应标明重置成本。

## 必填硬件测试记录

| 字段 | 记录 |
| --- | --- |
| ESP32-S3 开发板与内存规格 | 具体板型待确认；目标 COM 读取到 ESP32-S3 rev v0.2、16 MB Flash，芯片报告内置 8 MB PSRAM，PSRAM 未独立测试 |
| ESP-IDF 版本 | 首次 UART0 启动为 v5.4 |
| 光驱固件/型号 | INQUIRY 返回 MATSHITA DVD-R UJ-898，固件 HC10 |
| 桥接器 VID:PID 与芯片 | `13fd:0840`，桥接芯片具体型号待确认；Hub 为 `05e3:0610` |
| USB 速度/MSC 协议 | 光驱 Full-Speed，interface `08/02/50`（MSC / SFF-8020i / BOT），LUN 0 |
| 供电电压/最大实测电流 | 待测 |
| 测试 CD-R/RW 品牌/额定速率 | 待测 |
| DAC/功放型号 | 台架 PCM5102A + TPA3118D2 已有短时立体声证据；板级完整电气与热指标待测 |

## USB 故障与后续对照

移除 Hub 后仍曾发生寻道失败；后续既有整盘成功，也有 DATA STALL／03/02/00、CSW 超时和根端口断连，不能合并归因。最新一次真实有界恢复成功与限制见[STALL 诊断](records/2026-11-09-usb-stall-diagnostic.md)，下一步按[路线图](roadmap.md)逐项比较介质、负载供电及数据连接。现有数据不支持直接认定更换某一硬件就能修复。

## 音频与按键接线

台架使用 GPIO15→BCK、GPIO16→LCK、GPIO7→DIN，PCM5102A 模块 SCK 接 GND，DAC 模拟 L／GND／R 接功放，已完成短时立体声试听。仓库默认 GPIO4／5／6 与该台架 profile 不同，配置和模块核对见[音频输出](audio-output.md)，不照默认构建推断当前实物接线。

四键方案使用 GPIO1 播放／暂停、GPIO2 上一曲、GPIO42 下一曲、GPIO41 退碟，常开接 GND。GPIO7 保留给 DAC DIN，禁止混用旧 GPIO7 退盘接法。当前基本操作已获用户确认；接线、J2 排针位置、profile 与剩余专项验收统一见[四键控制](playback-controls.md)。
