miclle/discora/docs/decisions/0028-oled-mechanical-mount.md

# ADR-0028：OLED 结构图适配与靠外安装

- 日期：2026-11-10。
- 状态：implemented（CAD）；实物和打印装配未验收。
- 来源：[OLED 尺寸与接线图](../../hardware/OLED-1.3-128x64/oled-module-dimensions-wiring.webp)的“结构图纸”；尺寸为供应商名义值。
- 本次修正：用户指出显示面陷入太深。上一版玻璃前面位于外斜面内侧 5.4 mm，只检查法向视线，斜视仍被孔壁遮挡。本版向外移 **4.4 mm**，玻璃前面内退 **1.0 mm**，采用背面沉槽、窗口倒角及可拆压框。

## 图纸值与定位

局部原点为有效区中心在外斜面上的投影：X 向右、Z 沿斜面朝上（排针方向）、Y 沿法向朝壳内。原点全局坐标仍为 **X=0、Y=18、Z=177.789474 mm**，斜面倾角 35.395°。有效区、PCB、玻璃和安装结构保持左右居中；四键与旋钮位置不变。

| 项目 | 图纸尺寸 / mm | 当前局部位置 / mm |
| --- | --- | --- |
| PCB | 35.4 × 33.5，厚 1.2 | X=±17.7；Z=−18.8…14.7；深度 2.4…3.6 |
| 四安装孔 | 4×Ø3，中心距 30.4 × 28.5；铜环外径标注 Ø4.5 | X=±15.2；Z=−16.3 / 12.2；距相邻板边 2.5 |
| 下缘缺口 | 宽 14、深 4，两侧各 10.7 | X=±7；Z=−18.8…−14.8 |
| 玻璃面板 | 34.5 × 23，厚 1.4；距板左边 0.45、顶边 5.25 | X=±17.25；Z=−13.55…9.45；深度 1.0…2.4 |
| 有效显示区 | 29.42 × 14.7；距板左边 2.99、顶边 7.35 | X=±14.71；Z=±7.35；比 PCB 中心高 2.05 |
| 四针 | 间距 2.54；首针距板左边 13.89，距顶边 2 | X=−3.81 / −1.27 / 1.27 / 3.81；Z=12.7；VCC / GND / SCL / SDA |
| 侧视总深度 | 11.3，从玻璃前面到针尖 | 玻璃前面深度 1.0，针尖深度 12.3 |

`DisplayHeader` 保留宽 10.16、高 2.54 的接头截面预留；这些不是图纸给出的塑壳尺寸，不虚构未标注的针截面。四针中心及顺序存于对象属性。`Window` 表示 OLED 自带玻璃，没有额外保护片、胶层或密封结构。

## 内侧沉槽与窗口倒角

玻璃沉槽 **34.9 × 23.4**，从深度 **0.8** 朝壳内开出，玻璃边缘每侧留 0.2，玻璃前面距槽底 0.2。PCB 沉槽 **36 × 34.1**，从深度 **2.2** 开出，板边每侧留 0.3；四个孔周承压面位于深度 2.4，避免玻璃承担锁紧压力。其余斜面仍厚 5 mm，沉槽周边前缘名义厚 0.8 mm，需打印试片确认薄边强度。

外表面开口 **32.82 × 18.1、R1.8**，向内 0.8 mm 收至 **30.42 × 15.7、R0.6** 的喉口；喉口相对有效区每边放宽 0.5。该倒角为真实切除几何，不移动显示内容来伪装安装深度。

视线检查从深度 1.0 的完整 29.42 × 14.7 有效区面向外扫掠：横向／纵向角度各取 −45°、0、45°的九种组合，另检查纵向 ±55°和与机身正前方对应的 ±54.605°。各指定方向均无壳体遮挡；这是 nominal CAD 的整面投射检查，不等同于 OLED 本身的光学视角、装配公差或任意角度保证。

## 四孔定位与可拆压框

原来直接锁 PCB 的四个盲孔柱改为 **Ø4.5 承压座＋Ø2.6 定位柱**。支承面深度 2.4，定位柱高 1.6；配 Ø3 PCB 孔，名义径向间隙 0.2。左右构造源仍用原生 `Part::Mirroring`。

新增一件 `DisplayRetainer`，为下方开放的 U 形压框。四个环形承压面只接触 PCB 背面孔周 Ø4.5 区域，内孔 Ø3.2 避开定位柱；接触面深度 3.6，背梁位于 6.4…8.4，PCB 背面与背梁之间留 2.8。中央、排针和底部缺口保持开放；实际焊点和器件高度仍需实物核对。

压框两侧在 **X=±20.5、局部 Z=−7** 锁紧，孔位下移以避开主控元件前方的工具轴线。名义 **2 枚 M2×6**，压框通孔 Ø2.2；前壳 Ø5 螺柱支承面深度 6.4，Ø1.6 盲底孔从深度 2.0 至 6.4，孔深 4.4。压框厚 2，螺钉名义进入柱体 4，孔底余量 0.4；螺钉头预留 Ø4×1.6，工具通路 Ø4×20。螺钉 SKU、螺纹、孔补偿和锁紧扭矩需试片确定。

三主体不变，刚性 PLA 打印件由 11 件增至 **12 件**。压框平整背面朝下打印，四个承压环向上；模型承压面为名义贴合，应核对 PCB 厚度与打印尺寸，不得通过过度拧紧把 PCB 压弯。

## 接头和拆装

接头深度 3.6…12.3；针尖后继续保留 **12.16 × 6 × 4.54** 的插线空间（X × 内法向深度 × 沿斜面高度）。实际插头、焊点、线径和弯曲半径仍待测量。

OLED 随前壳一起拆下。先断线、卸两枚压框螺钉，沿内法向取下压框，再沿同方向把模组从四个定位柱上取下；两步各检查 0…25 mm、每 0.5 mm 一步的 51 个姿态。装配按相反顺序，先确认玻璃不压前缘、四孔定位平整、插线不受压，再锁紧压框。

## 验证与交付

[check-oled.py](../../hardware/enclosure/check-oled.py)从保存模型独立读回板形、孔位、缺口、玻璃深度、沉槽、倒角两端尺寸、定位柱和压框，并检查视线、左右对称、螺钉头／工具、接头预留及两步取出路径。[oled-checks.json](../../hardware/enclosure/oled-checks.json)记录实际结果和周围净距。

与上一版比较，前壳、玻璃、显示内容、PCB 和接头这五个既有成品对象改变，新增压框；其余 28 个成品对象保持。整机干涉、对称、四键、背锁和拆装检查，以及 12 件网格／四盘本地切片均应以本版模型摘要为准。唯一六页图册的第 6 页同步模组、安装中剖和压框参数。

CAD、预览和切片不替代实际打印、薄边强度、面板光学、线束与螺钉装配验收；固件和电气接线不在本次修改范围内。
