miclle/discora/docs/status.md

# 当前工程状态

**正式机械交付：** [11 件 STL／6 盘 3MF](../hardware/enclosure/print/README.md)与[12 页图册](enclosure-drawings.md)已统一至当前 P2/P3，文件读回、1180 层统计、材料及支撑配置检查通过；完整件实装和声学待测。

2026-11-14 P2/P3 当前配套：P3 最后 4 mm 更新为圆角梯形短渐扩口，出口约 587.22 mm²，原 400 mm² 主通路、已试装安装座及双背板贴板面保留；P2 沿用圆角梯形外口。新口投影无遮挡、0.7 mm 间隙保持，气路连通、左右镜像、静态碰撞及七条拆装路径通过。P3 287 层重新核对，无声腔／导管内支撑，原 18 处悬空位置复查通过；P2 保持原 440 层结果和开放侧口支撑。当前 CAD、配套文件与证据见 [ADR-0046](decisions/0046-p3-terminal-mouth.md)，P2 沿用 [ADR-0045](decisions/0045-trapezoid-exterior-outlets.md)。完整件打印、支撑拆除、气密和声学仍待实测，不再打印试片。

更新时间：2026-11-14。本文只维护当前结论；完整经过与失败窗口见[实验记录索引](records/README.md)，未完成工作见[路线图](roadmap.md)。

`planned` 表示计划，`implemented` 表示源码已实现，`bench-tested` 表示指定条件下有实验或用户反馈，`verified` 表示满足相应完整验收条件。编译、日志计数、用户听感和实物验收分别记录，不互相替代。

## 当前源码与最近部署

- 当前源码版本：**0.12.8-read-speed-probe**，增加默认关闭的读取限速实验；4×／2× 候选分别请求 708／354 kB/s，命令在完整 TOC 校验后、开放播放前执行。协议与失败回退测试、完整主机检查、17 项 bench 工具检查以及默认查询／4×／2× 三配置 ESP-IDF v5.4 构建通过，见[限速记录](records/2026-11-09-read-speed-probe.md)。
- 最近部署版本：**0.12.8-read-speed-probe，2× 实验配置**，9063 主控、UJ-898／HC10、`13fd:0840` Full-Speed 桥接器。两档限速命令均被接受；用户反馈 4× 噪声差别不明显、音乐正常，**2× 噪声明显降低、音乐正常**。实际主轴倍速没有测量，短窗口不代表整盘稳定性。
- 部署配置：GPIO15／16／7 I²S，25% 数字幅度，2 MiB PSRAM 队列、3 秒预填、欠载重缓冲、每次启动一次的寻道恢复；四键 GPIO1／2／42／41、SH1106 0x3c（GPIO10／11）。READ CD CSW 仍为 3 秒，读取批量与供数节奏未改；CD-Text 探测关闭。
- 2× 候选仅写入应用 `0x10000`，写入校验及独立新应用／原前 65536 字节核验通过；启动 ELF SHA-256 `8ec852dda8635ce0eb608990fa8c24bb7006f2eed8234370055c710e26e1b7c8`。0.12.6 原应用与两轮写入前备份均保留，恢复路径见[限速记录](records/2026-11-09-read-speed-probe.md)。
- 本轮默认／4×／2× 各约 100 秒的第 1／7／13 曲及暂停恢复对照均无读取失败、软件欠载或 I²S 写入错误。2× 完成 985 次读取；最后已停止、I²S 关闭，串口释放。该次限速对照在末曲 EOF 前结束。
- 此前 0.12.7 的默认关闭 CD-Text 探测及介质变化保护保留在源码；当前 13 曲盘查询返回空文字包，曲名解码／滚动尚未实现，见[CD-Text 记录](records/2026-11-09-cdtext-probe.md)。0.12.6 的中文 OLED 与进度条已有用户实屏确认。

此前 0.12.5 的四键基本操作已获用户确认；原验证范围及退碟 CSW 未捕获的限制保留在[恢复边界实现及部署记录](records/2026-11-09-usb-offline-recovery.md)。仓库默认构建仍为查询模式；复现上述有声配置须使用[四键控制说明](playback-controls.md)中的 profile，并追加[限速说明](cd-player.md)中的 2× profile，不能把默认引脚 GPIO4／5／6 或旧退盘 GPIO7 接法直接套用。

## 验证结论

| 能力 | 已有证据 | 未完成边界 |
| --- | --- | --- |
| USB 枚举与基础查询 | UJ-898／HC10、13fd:0840 已实测；历史连续 61.2 秒、13 次 TUR 就绪 | 冷启动、受控插拔及异常清理待验；见[查询记录](records/2026-10-31-m1-optical-probe.md) |
| TOC／CD-DA 数据 | 单张 13 轨 TOC 与电脑一致；600 秒／105840000 字节与电脑完整摘要一致；软件时钟整盘 594221040 字节两端摘要一致 | 不推断其它盘或桥接器兼容；见[连续读取](records/2026-10-31-m2-stream.md)、[软件时钟整盘](records/2026-11-01-m3-whole-disc.md) |
| 模拟立体声 | 用户确认 CD → 光驱 → ESP32-S3 → PCM5102 DAC → TPA3118D2 反复播放通过，见 [#4](https://github.com/miclle/discora/issues/4) | 此次反馈未指定限速配置或测试时长。DAC 端时钟计数与短时双声道听感见[音频对照](records/2026-11-07-cybertrack-audio-crosscheck.md) |
| 连续播放 | 2026-11-08 单次恢复候选三轮均完成 13 轨、594221040 字节、31586 次读取；无读取失败、欠载或写入错误，26 次事件溢出均在轨尾 | 三轮均未触发恢复，不证明间歇故障修复；见[整盘跟进](records/2026-11-08-track13-followup.md) |
| 读取限速降噪 | UJ-898／HC10 接受 4×、2×；用户确认 2× 噪声明显降低、音乐正常 | 默认关闭。实际主轴倍速未测，见[限速对照](records/2026-11-09-read-speed-probe.md) |
| PSRAM 欠载重缓冲 | 受控 15 秒供数暂停后自动恢复已实测 | 不等于无缝播放，也不修复 USB 失联；见[缓冲记录](records/2026-11-07-buffered-playback.md) |
| 真实寻道恢复 | 2026-11-09 诊断候选在 DATA STALL／03/02/00 后首次捕获一次重读成功；处理约 16.019 秒，发生一次欠载及重缓冲 | 原始故障根因未确认；0.12.5 新增取消／断连分类分支只有离线覆盖；见[STALL 诊断](records/2026-11-09-usb-stall-diagnostic.md) |
| 四键基本操作 | 0.12.5 播放／暂停／上一曲／下一曲／退碟获用户确认 | 长按、上电按住、组合键、无盘／重插盘及暂停中首尾循环的实体键场景待专项验收；见[验收反馈](records/2026-11-09-usb-offline-recovery.md#四键基本操作验收2026-11-09用户实测反馈) |
| 盘尾复位与循环选曲 | 0.12.3 的 UART 共用核心已验证首尾循环、暂停保持、末轨完整 EOF 后回首曲停止、再次 toggle 从首曲播放；用户确认尾音完整 | UART 证据不替代实体键手势或整盘稳定性；见[盘尾验证](records/2026-11-09-disc-rewind-reconnect.md) |
| OLED | 0.12.6 中文显示及进度条获用户实屏确认；历史无介质与盘尾英文画面也有用户反馈 | 各异常状态、计时精度及长时间有声并行未完整验收；见[中文进度验收](records/2026-11-09-oled-progress.md)、[盘尾验证](records/2026-11-09-disc-rewind-reconnect.md) |
| 外壳及供电集成 | 三主体 PLA 外壳、四键及背锁已有 CAD／网格／切片检查；提手高出斜肩已由 25 增至 45 mm，开口收至 90×24 mm、上下横梁各 10.5 mm，见 [ADR-0031](decisions/0031-taller-handle.md)；P2 采用开放梯形侧口、P3 采用独立导管，见 [ADR-0046](decisions/0046-p3-terminal-mouth.md)；后壳侧视轮廓保持对称，前壳以 5 mm 等厚贴合并取消顶部台阶，见 [ADR-0033](decisions/0033-uniform-front-side-seam.md)；后壳主体厚 5 mm，按光驱实测更新为 170×93×243.263 mm；光驱底面靠后壁，采用中央底托及两螺钉压条，实测线缆侧伸 14.5 并留 1.5 余量，见 [ADR-0035](decisions/0035-measured-drive-rear-wall-mount.md)；双路固定 5V 降压方案已记录；B50K 已改用 PCB 插接模块，完整包络绕轴90°并扩大内槽；四键左移4 mm、旋钮右移4 mm并向提手移2 mm，十字扩大至28 mm，见 [ADR-0047](decisions/0047-control-spacing-and-knob.md)，见 [ADR-0036](decisions/0036-pcb-volume-module.md) | 洞洞板托架与 XH2.54 线束维护空间已纳入 CAD；P3 按喇叭实测增加安装开口和每只四处盲底孔，几何与切片通过。用户已打印喇叭试片并确认装配无问题（`bench-tested`），见 [ADR-0038](decisions/0038-measured-speaker-trial-mount.md#2026-11-14-试片结果)。P3 后横梁收齐后，Bambu Studio 首层检查确认双声腔背面直接贴板，见 [ADR-0039](decisions/0039-p3-flat-back-printing.md)。完整 P3 与整机的实物配合、承载、散热和负载供电待验证；见[外壳](../hardware/enclosure/README.md)、[布局](perfboard-layout.md)、[供电决策](decisions/0018-dual-5v-buck.md) |
| CD-R／CD-RW 刻录 | 研究目标，未实现 | 须先通过桥接兼容性、最低写速与实测吞吐门槛 |

## 仍然有效的失败证据

- **根端口失联**：2026-11-07 曾在首条读取前及约 23 分 20 秒时断开；后者无在途命令且仍有约 11.82 秒缓冲。不能归因于软件欠载，见[两轮整盘失败](records/2026-11-07-full-disc-usb-disconnect.md)。Mac 的一次快速整盘读取成功不等于 S3 实时播放通过，见[USB 诊断与电脑对照](records/2026-11-07-usb-disconnect-diagnostics.md)。
- **读取／寻道失败**：2026-11-08 在 LBA 233783、244135 返回 03/02/00；后续成功窗口不覆盖失败，见[整盘失败](records/2026-11-08-full-disc-read-failure.md)和[末轨跟进](records/2026-11-08-track13-followup.md)。
- **DATA STALL 后 CSW 超时**：0.12.3 在 LBA 242415 未到自然 EOF；后续诊断在另一位置 clear 后仅 245 µs 即收到失败 CSW，不能据此证明延长 CSW 期限有效。根因与下一步单变量对照见[STALL 诊断](records/2026-11-09-usb-stall-diagnostic.md)。

## 软件验证与证据保存

2026-11-10 限速固件提交前审查未发现可确认缺陷；审查轮完整主机 ASan／UBSan 再次通过，已有三配置构建产物及摘要复核通过。本轮只更新相关文档，无新增固件改动或烧录；详见[审查记录](records/2026-11-09-read-speed-probe.md#提交前审查2026-11-10)。

2026-11-09 CI 跟进：[文档整理提交 5a949ad 的运行](https://github.com/miclle/discora/actions/runs/42632993933)中 13 个 ESP32-S3 构建配置全部通过，主机测试因循环换轨表达式混用 `int`／`size_t` 被 GCC 的 `-Werror=sign-compare` 拒绝。该表达式来自 `657ac8c`，前一提交的 CI 也有同一失败。现将末轨索引运算显式统一为 `size_t`，不关闭警告或改变换轨语义。GCC 对照检查确认旧表达式失败、新表达式通过；完整主机 ASan／UBSan、17 项 bench 工具检查及 ESP-IDF v5.4 四键有声／OLED 配置的 `set-target esp32s3`／`build` 通过。新源码未烧录，设备部署记录不变；修复提交的远端结果以对应 CI 为准。

0.12.5 已有完整主机检查及默认查询／四键有声／独立寻道三配置的 ESP-IDF v5.4 构建证据。停止／换曲后拒绝旧读取恢复、超时清理期间断连分类已获离线覆盖；真实故障分支尚待验收。具体环境、摘要和限制保存在[对应记录](records/2026-11-09-usb-offline-recovery.md)，本页不把历史构建结果视为未来改动的验证。

2026-10-31 的 M1 原始日志、原 ELF 及首次烧录前备份曾被 `set-target`／`fullclean` 误删；后取的 M1 Flash 只能回退到 Discora M1，不能恢复首次烧录前固件。历史摘录与摘要保留，但原文件不可复核，见[证据可用性更正](records/2026-10-31-m1-offline.md#原始证据可用性更正2026-10-31)。后续日志、镜像及备份放在忽略目录 `.local/bench/`；其保留与清理规则见[贡献约定](../CONTRIBUTING.md#文件与实验产物维护)。
