miclle/discora/docs/perfboard-layout.md

# 机内洞洞板、固定托架与 XH2.54 线束

更新：2026-11-14。**机内装配 CAD 已实现，实物试装待验收。** ESP32-S3、PCM5102 和两块 DCE001 共用洞洞板，功放仍在下层。状态、孔位和拆装依据见 [FreeCAD 模型](../hardware/enclosure/Discora.FCStd)、[检查报告](../hardware/enclosure/current-perfboard-checks.json)和 [ADR-0037](decisions/0037-perfboard-carrier-and-front-harness.md)。

[装配图册](../hardware/enclosure/drawings/Discora-V4-drawing-book-color.pdf)第 8 页为载板板形与装配布局，第 9 页为前壳线束和 60 mm 维护位。

## 板形与托架

机身坐标 X 向右、Y 向后、Z 向上，单位 mm。文档原 100 × 55 mm 基准板水平转 180°，原 u/v 原点落在机身右前，换算为 **X=57−u、Y=20+v**，载板底面 **Z=142.8**、标称厚 **1.6**。绝对坐标用于 CAD，裁线须和现有实物板、焊点和铜皮逐一核对。

| 部位 | 名义边界 |
| --- | --- |
| 基准矩形 | X=−43…57，Y=20…75 |
| 音量板避让缺口 | 右前角 X=40.25…57，Y=20…52，16.75 × 32 |
| 2 芯插座延伸边 | 左侧 X=−54…−43，Y=40.86…50.86，11 × 10 |
| P3 洞洞板托架 | 三个支承与螺钉座、后连梁及左侧插座承压面，与双声腔支架一体 |
| 名义固定位置 | （G₂，A）、（Q，N）、（A，O）；载板 Ø2.2 通孔、托架 Ø1.6 导孔，名义 M2×4 |

后侧固定点从（A，P）朝机身前方移 2.54 mm 至（A，O），机身坐标为 X=54、Y=58.56 mm。后横梁与声腔背面齐平，详见 [ADR-0039](decisions/0039-p3-flat-back-printing.md)。

三处固定点使用空孔附近的铜箔区域，留出 Ø5 mm 承压环和顶部刀杆通道。扩孔前确认该圆周内没有排母、线路或焊点。板底预留 2 mm，三处压脚及边缘支承接触区留空。后缘到光驱名义净距 1.2 mm；板底的走线包络到功放元件为 1.2 mm。若实物已裁成 100 × 55 mm，左侧 2 芯插座的候选位置会超出现有板边。

| 部件 | 原布局 u / v | 本体平面尺寸 |
| --- | --- | --- |
| ESP32-S3 | 17.71 / 1.73 | 63.39 × 27.94 |
| PCM5102 | 6.29 / 33.87 | 31 × 17 |
| DCE001 A | 53 / 35 | 17.5 × 12 |
| DCE001 B | 77.5 / 35 | 17.5 × 12 |

ESP32-S3 与 DAC 采用 8.5 mm 排母、1.6 mm 模块 PCB 和 7 mm 元件的名义叠高。DCE001 本体及绝缘支承共按 7.5 mm，附近短线和支承按 25 × 22 × 12 mm 预留。两块半孔模块用绝缘材料固定并接短引线，孔距、焊点高度、安装方式与散热仍需按实物确认。

## 原模块排母与板上接线

按用户确认的**元件面、左上为原点**绘图：

- **X 向右：A～Z，再 A～P，共 42 列。** 图中将第二段写为 A₂～P₂，实物仍是 A～P；例如 E₂ 表示第二段 E，不是第一段 E。
- **Y 向下：A～Z，再 1～4，共 30 行。** 不反向编号、不交换两轴。
- 所有接线坐标统一写为 **（X，Y）**。例如（N，R）就是 X=N、Y=R 的交点。

[原模块排母图](diagrams/discora-wiring.html#perfboard-layout)展示完整原板孔阵列，右侧放大 DAC 和 P1。接插件与螺钉孔以本页表格为准，淡色孔仅供定位。

孔距 2.54 mm；几何试算中候选载板的首孔仍暂取 u=v=3 mm。若 X/Y 对应原点起第 n 列／第 m 行，孔中心为 `u=3+(n−1)×2.54`、`v=3+(m−1)×2.54`。u/v 是 100 × 55 mm 基准轮廓的毫米坐标，不是整块原板的已测边距；原板切线仍需按实物核对，不能把总图边框当作切线。

| 插座 | 候选孔位（板上 X / Y） | 首针与依据 |
| --- | --- | --- |
| ESP32 J1 | Y=K，X=J～E₂ | X=J 为 J1-1，向右经过 Z、A₂，至 E₂ 为 J1-22；转向后位于机身后排 |
| ESP32 J2 | Y=A，X=J～E₂ | X=J 为 J2-1，向右至 E₂ 为 J2-22；转向后位于机身前排 |
| DAC 输入 | X=N，Y=N～S | 从上向下依次 VIN、GND、LCK、DIN、BCK、SCK |
| P1：DAC 独立 5V | （Q，Q）、（Q，R） | 前者 +5V，后者 GND；8 × 12 mm 外壳／引线区暂定 |

主控两排中心距为 10×2.54=25.40 mm；每排 22 针首末距为 53.34 mm。主控首针离天线端 8.15 mm、侧边 1.27 mm 按供应商尺寸图推导，模块包络为 u/v=17.71/1.73。DAC 暂将排针距右板边设为 1.27 mm、六针沿 17 mm 边居中（两端各 2.15 mm），包络为 6.29/33.87；**DAC 的这些边距是布局假设，不是已测尺寸**，须试插后确认或调整。

| 信号 | 主控／入口孔（X / Y） | DAC 孔（X / Y） |
| --- | --- | --- |
| BCK | GPIO15 / J1-8：Q / K | N / R |
| LCK | GPIO16 / J1-9：R / K | N / P |
| DIN | GPIO7 / J1-7：P / K | N / Q |
| 公共地 | GND / J2-1：J / A | N / O |
| SCK 接地 | DAC SCK：N / S | DAC GND：N / O |
| DAC 独立 +5V | P1-1：Q / Q | VIN：N / N |
| DAC 电源 GND | P1-2：Q / R | GND：N / O |

P2 音频接头仍在板外线束中。DCE001 本体不分配半孔焊盘孔号。上表没有定义背面导线的实际路径，裁剪和焊接前按实物核对。背面焊接仍保留同一个孔的 X/Y 身份，不重新编号。历史台架图的观察方向及排母位置均不同，只供追溯，不能与新表混用。

## 三组接插件

以下孔位为元件面，丝印第二段用下标 ₂ 表示。编号顺序须根据手中接头锁扣及线序确认，插合包络包含 PCB 侧插座与插头。

| 用途 | 载板侧插座 | 候选孔位（X，Y） | 信号 |
| --- | --- | --- | --- |
| 四键 | 5 芯侧插，朝机身左侧 | （J₂，B～F） | 公共地、播放／暂停、上一曲、下一曲、退碟 |
| OLED | 4 芯直插，向上拔，线向前转 | （H₂～K₂，J） | 3V3、GND、GPIO11 SCL、GPIO10 SDA，按 OLED 丝印逐芯对照 |
| B50K 开关 | 2 芯直插，向上拔，线向前转 | （O₂～P₂，J） | 两根开关触点线，音量 L/R 经独立线束接功放 |

四键 P3 保留 GND、GPIO1、GPIO2、GPIO42、GPIO41 的定义，原 ESP32 排母焊脚（J，A）和（M～P，A）接到机内的 5 芯座。开关触点的电气用途及载流能力未验收。

CAD 给 5 芯侧插、4 芯直插和 2 芯直插的插合包络分别为 **18 × 16 × 8、13.5 × 8 × 11、8.5 × 8 × 11 mm**（机身 X/Y/Z）。另建出线转弯及拔出通道。孔位按 2.54 mm 洞洞板排位，JST 原厂 XH 系列图纸为 2.50 mm；到手先比孔距及插合外形。见 [JST XH 图纸](https://www.jst-mfg.com/product/pdf/eng/eXH.pdf)。

## 光驱连接与供电

ESP32 的 USB 和 COM 插座在整机运行时留空。按 V1.4 针表，光驱桥接器 D− 接 GPIO19（J2-20，（C₂，A）），D+ 接 GPIO20（J2-19，（B₂，A）），GND 接主控 GND，例如 J2-21（D₂，A）。DCE001 A 接 5Vin（J1-21，（D₂，K））和 GND（J1-22，（E₂，K））；B 接桥接器 VBUS 和光驱支路地，两路共地且正极分开。差分线保留原线对，剥开末端尽量短。模型有数据线与 DAC 至功放的走线预留，实际桥接连接、供电线及 DAC 5V 来源按[整机接线](wiring.md#电池双路-5v-降压规划planned)核对。

## 拉开前壳与拔插

[60 mm 维护位预览](../hardware/enclosure/perfboard-service.png)中蓝色为四键、紫色为 OLED、橙色为音量开关。

1. 断电、卸下四枚背锁螺钉，从正面托住前壳沿 −Y 平移。前壳和载板仍通过三组 XH 线束连接。
2. 拉开 **60 mm** 后，各插头都有 **12 × 10 mm** 的直线工具／手指入口包络。先向上拔音量开关并把线移到前壳侧，再向上拔 OLED，最后向机身左侧拔四键插头。音量开关的余线经过 OLED 的拔插入口。
3. 断开其余前壳线束后再将前壳移走。拆载板时先断主控数据、供电及 DAC 音频线，松开三枚 M2 螺钉后可从支承面上取下载板，也可先将 P3 随板整体向前拆出。

模型树 **05 · 洞洞板线束和拔插预留** 默认隐藏，可打开三组线束的合壳、60 mm 维护位以及插拔包络。三组柔性路径按 2 mm 步长检查，CAD 中心线路径约为四键 121 mm、OLED 115 mm、音量开关 201 mm。制作线束时在该长度上另计端子压接、实际出口和固定余量。打印后核对弯曲半径、前壳拉开余量、卡扣握持和合拢时压线情况。功放到音量旋钮的模拟线束及最终电源线还需按实物留量。

复算命令：

```bash
mkdir -p tmp/perfboard-baseline
"$DISCORA_FREECAD_PYTHON" hardware/enclosure/check-perfboard.py   --output tmp/perfboard-current-checks.json
```

## 历史机箱包络复核（2026-11-07）

当时依据 [Discora.FCStd](../hardware/enclosure/Discora.FCStd)，模型 SHA-256 为 `360b79141afac0870da58e5b7ca17ba631e3d888896ddd13e4742edac3664306`。当时仅只读计算，没有改动模型。以下结果只对应所列历史模型。当前模型和维护检查见上文。

包络数据保存于 [layout.json](../hardware/perfboard/layout.json)，结果见 [analysis.json](../hardware/perfboard/analysis.json)。用可导入 FreeCAD／Part 的 Python 运行 `hardware/perfboard/check-layout.py` 可复算；脚本不保存源 CAD。

试算条件：载板厚度暂按 1.6 mm、底面 Z=143.6、下方导线／焊点占用 2 mm；主控和 DAC 在载板以上按 8.5 mm 排母＋1.6 mm 模块 PCB＋7 mm 元件，共 17.1 mm。DCE001 按 4.5 mm 本体＋3 mm 支撑，共 7.5 mm；其支撑／短引线预留区向上按 12 mm。除供应商本体尺寸外，这些均为**未实测的设计预留**。

| 检查 | 结果与边界 |
| --- | --- |
| 四个模块的平面包络 | 均位于 100 × 55 mm 板内，彼此不重叠；不包括完整连接器或原板实物孔位对照 |
| 放入现有机箱 | 与前壳／屏幕安装座、显示接头、音量电位器等碰撞；不通过 |
| 前壳及显示／操控组件临时上移 20 或 22 mm | 对列出的保留部件，无超过 0.001 mm³ 的交叠，也无小于 1 mm 的净距；这只是上部空间试算 |
| 保留现有喇叭／电子支架 | 载板、底部导线及主控包络仍与支架碰撞；上层托板与连接柱必须重做 |

历史临时平移前壳实验未完成壳体闭合、连接柱、碟口导向、操控位置及提手的重新设计；旧 MCU／DAC 占位由候选替换，现有支架单列为不通过项。检查不覆盖最终线束、螺钉工具、低排母选型、支架强度、拆装路径、温升或射频。若后续调整外壳，应维持左右外轮廓、提手、格栅和声学结构对称，不能单侧鼓包。
