miclle/discora/docs/eject-button.md

# 轻触按键退盘

`0.12.1-buttons-row` 将退碟 GPIO 配置化；四键有声方案使用 **GPIO41**，GPIO7 保留给 DAC DIN。默认查询配置仍保留历史 GPIO7，不能将其接法用于 GPIO15/16/7 有声配置。引脚迁移见[连续排针记录](records/2026-11-08-buttons-row.md)，当前部署与实体验收见[0.12.5 记录](records/2026-11-09-usb-offline-recovery.md#四键基本操作验收2026-11-09用户实测反馈)，完整四键接线见[四键控制](playback-controls.md)。

当前 0.12.5 四键有声配置的基本退碟为 **bench-tested（用户实测通过，2026-11-09）**。用户确认退碟正常；日志仅捕获请求和命令发出，未捕获退碟 CSW。空闲／播放中等各状态、长按及重插盘场景尚未完整验收。

历史基本退盘已有 **bench-tested（用户实测反馈，0.9.0 默认查询配置）** 证据：用户确认按键触发及实际光盘退出，但该动作未采集串口返回。此历史证据不等同于当前播放器全部退盘场景通过；详见[退盘实现记录](records/2026-11-01-button-eject.md)和[0.9.0 部署及用户反馈](records/2026-11-01-button-eject-deploy.md)。

## 接线

选用**常开、按下接通、松开复位**的轻触按键。四键有声 profile 使用 **GPIO41**，内部上拉，低电平有效。

```text
ESP32-S3 GPIO41 ───── 常开轻触按键 ───── ESP32-S3 GND
```

- 按键一个触点接开发板丝印 `41` / `IO41` / `GPIO41`，另一个触点接 `GND`。不接 5V，也不必另外接 3.3V。
- 四脚轻触按键通常是两组内部相连的脚；断电用万用表确认选中的两脚是“松开不通、按下导通”，不要凭外观选两只脚。
- 先断电接线，保持线短。内部上拉已由固件启用；若实际长线环境有干扰，可在所选 GPIO 与 3.3V 之间加 10 kΩ 上拉后重新验证。
- 依据本项目 [V1.4 板卡资料](../hardware/ESP32-S3-N16R8/README.md)及[排针摘录](../hardware/ESP32-S3-N16R8/board-data.json)，GPIO41 为 J2 第 7 针：元件面朝向观察者、天线向上、USB 向下时的右排，从顶部数。五芯线束 GND 使用同排 J2 第 1 针。**以实物丝印为准，板修订号尚未逐网核实。**
- GPIO41 不占用当前有声 I²S GPIO15/16/7、USB GPIO19/20 或 UART GPIO43/44。部署须加载匹配当前 GPIO15/16/7 音频接线的有声四键 profile。

## 固件配置与行为

`menuconfig → Discora eject button → Enable active-low eject button` 对应 `CONFIG_DISCORA_EJECT_BUTTON`，`CONFIG_DISCORA_EJECT_GPIO` 选择引脚（默认 7，四键 overlay 覆盖为 41）。新配置默认开启，适用于默认查询、CD 软件时钟和 CD I²S 模式；有界 READ CD bench 与独立测试音模式自动禁用。已有 sdkconfig 应核对该项并重新构建、烧录；接线本身不会使旧固件拥有退盘功能。

输入任务约每 10 ms 采样，以实际单调时间做 30 ms 消抖。上电先等一次稳定松开，长按不重复触发，释放也要稳定 30 ms 才能重新触发。未识别光驱、断连、传输故障或退盘处理中不保留新的退盘请求；已排队请求在断连时清除，不转移给下一个设备。没有定时、上电或 UART 自动退盘入口。

单次流程：

1. 输入任务只投递一个请求；唯一 USB client 在当前命令结束后领取，绝不在中断或按键任务中操作 USB。
2. 检查可用 CD/DVD 身份及连接健康状态，不要求存在有效音频 TOC，所以无盘或数据盘也能请求退盘。
3. 清除 TOC；播放模式使介质失效、取消连续播放并丢弃旧队列，最多等 1 秒由输出任务确认 I²S 已关闭。未确认关闭或发生断连则不执行机械命令。
4. 发送 `PREVENT ALLOW MEDIUM REMOVAL (0x1E, Prevent=0)`，成功后发送 `START STOP UNIT (0x1B, IMMED=0, LoEj=1, Start=0)`。两个命令都没有数据阶段，LUN 为 0；不提供任意 CDB、装盘、写入或擦除入口。
5. 驱动拒绝时读取并保留真实 sense；传输错误沿用 BOT 恢复/隔离策略，不自动重放退盘。重新查询目录后也保持停止，需要显式播放操作。

正在执行的读取不被按键强行取消，因此异常时按键到退盘可能受已有 READ CD / sense 超时影响。退盘的每次 CSW 接收等待上限为 30 秒，STALL 后保留既有一次 CSW 接收重试；这不是总操作耗时保证。其余 CBW 和控制传输仍使用原有截止。USB 已故障时按键不能替代重新连接。

## 上板验收

保持光驱正常独立供电；首次使用不需要连接 DAC。记录 ESP32 板型号、固件/IDF 版本、光驱型号/版本、桥接 VID:PID 与介质。

1. 启动日志应包含 `GPIO41 active-low internal pull-up; debounce=30ms`，等待目标 UJ-898 / HC10 的 INQUIRY 身份成功。
2. 空闲有盘时按一下，应记录一次 `press accepted GPIO41`，随后 ALLOW 与 eject 的真实 CSW；肉眼确认碟片实际退出。
3. 长按 2 秒只执行一次；释放后再次按可发起新请求。上电一直按住不应退盘，松开后再按才触发。
4. 播放时退盘应停止输出和读盘，重新插盘只刷新目录、不自动播放；分别检查软件时钟和已验证接线的 I²S 模式。
5. 无盘、数据盘、断连时按键及重连后不误退盘分别记录。遇到传输超时保留原日志，不把“命令完成”或“无盘”独立当成机械退盘证据。

`eject command completed; physical disc removal requires observation` 只表示有效成功 CSW；按键接通、真实机械动作与供电稳定性必须另行观察。当前 UJ-898 + `13fd:0840` 已获用户实际按键退盘成功反馈；未采集此次 CSW，不据此认定上述全部场景通过。
