miclle/discora/docs/decisions/0047-control-spacing-and-knob.md

# ADR-0047：操控件外移与 28 mm 十字旋钮

- 日期：2026-11-15。
- 状态：implemented，CAD 与软件验证完成范围见报告；整机尚未打印。
- 依据：用户要求分析四键和旋钮外移及旋钮加大，确认尚未打印，要求由 CAD 验证后继续落实。

## 布局

四键组向左移 4 mm，前后两排中心分别为 X=-63/-45、Y=9/26。列距 18 mm，沿斜面行距 20.854 mm。旋钮轴心移至 X=52、Y=20、Z=179.211，向右移 4 mm，朝提手方向的水平投影移 2 mm，对应沿斜面约 2.453 mm。

十字跨度 28 mm、臂宽 6.8 mm，端部 R3.4。底盘 Ø24 mm、下沉 1 mm、顶面高出面板 12.9 mm。延长臂下侧采用 45°过渡接回底盘。轴孔、六条压配筋、螺母空腔与中心半径 7 mm 内的安装核心沿用原几何。

四键定位座、压板与开孔随键帽整体移动，B50K 完整模块、轴和内槽随轴心移动。操控细节仍为既有左右对称例外，前壳其余区域、后壳及声学结构通过镜像复查。

## 线束和维护

按键线束末端两点随四键左移。音量开关线束末端四点随模块移动并额外向外绕 1 mm，避免旧折线穿过模块。当前回环中心线长度约为四键 122.0 mm、OLED 114.8 mm、音量开关 205.7 mm。实际裁线须包含端子短尾及接线余量。

前壳拉开 0…60 mm、每 2 mm 一个位置的线束检查通过。依次断开音量开关、OLED、四键接头后，前壳沿机身 -Y 拆出。模块退出检查以已拆下的前壳为基准。

## 验证与交付

- 四键 0…0.8 mm、每 0.2 mm 的按压采样无碰撞；四键安装组件至后壳最近净距由 0.7 增至 4.7 mm。
- B50K 完整插接包络到主控元件净距由 2.21 增至 6.21 mm。
- 28 mm 旋钮连续整圈包络无干涉，至机身前沿净空下界 1.116 mm；凹位径向和底部间隙分别为 0.4 和 0.6 mm。
- 保存模型与已验证候选的 62 个成品及线束形状逐件一致，静态、对称和拆装报告据此衔接；正式模型重新运行线束、旋钮包络与网格检查。
- 正式前壳及旋钮重新切片。其余打印件按不变形状或刚体平移复用原项目。图册从当前模型重新投影和渲染。
- 证据见 [布局变更](../../hardware/enclosure/control-layout-checks.json)、[当前旋钮](../../hardware/enclosure/control-layout-current-checks.json)、[模块安装](../../hardware/enclosure/control-volume-checks.json)、[线束](../../hardware/enclosure/current-perfboard-checks.json)及[打印包](../../hardware/enclosure/print/manifest.json)。

本轮未导出试片。按键回弹、旋钮插入力和保持力、线束实际弯折、整机打印装配仍待实物验证。
