miclle/discora/docs/decisions/0040-wide-chambers-flush-side-ports.md

# ADR-0040 P3 局部加宽与 P2 齐平侧孔

日期为 2026-11-14。用户授权直接修改正式零件，采用完整件几何和切片验证。

## 结构

P2 两侧管段收至侧壁内面 X=±80 mm，取消原来向内伸出的 14.7 mm。外侧 5 mm 范围的侧壁、内凹饰片和四条连接筋逐件差集为零。

P3 在 Z=38…118 mm 区域对称扩宽至 X=±79.3 mm，每侧增加 14.3 mm，留 0.7 mm 滑动间隙。上下安装区避让原后壳螺丝座和加强筋。加宽区域的背板、顶底壁和侧壁厚 2.5 mm，前壁采用相对打印底板约 63.4° 的斜面，法向厚度 2.5 mm。每增加 0.2 mm 打印高度，内侧斜边横向推进 0.1 mm。双声腔和后横梁背面仍为 Y=62.5 mm。P3 侧口改为与 P2 内口相同的 63×18 mm 胶囊形，中心 Y=49、Z=80。

P3 的已试装喇叭安装区域、安装座、前障板、四处固定耳、洞洞板支架和电子模块通过几何差集复核。P1 与其余成品零件差集为零，双色件逐面几何和颜色资源保留。P3 仍从前方装入和抽出。

## 验证

- `wide-chamber-checks.json` 记录与修改前模型的差集、外侧饰片保留及背板面积。每侧贴板平面面积 6929 mm²。
- `validation.json` 检查三个主体各为一个有效实体、整机静态碰撞、左右镜像、喇叭安装和左右空气通路。
- `assembly-paths.json` 检查支架、前壳、电池、光驱和接头维护。声腔按中央部分及加宽部分分别构造连续保守扫掠，覆盖实际退让外形。前壳及光驱转动沿用报告中的离散采样边界。
- `wide-chamber-port-checks.json` 检查两侧接口均为 0.7 mm 间隙、端口归属和对称性。
- `wide-chamber-perfboard-checks.json` 复核螺钉工具、线束和插拔预留。此报告使用当前模型副本作基线以执行现有接口检查，跨版本不变性由 `wide-chamber-checks.json` 单独验证。
- `wide-chamber-print-checks.json` 记录 Bambu Studio 2.9.1.70、P2S 0.4 mm、Generic PLA、0.20 mm 层高、仅底板树状支撑及仅关键区域支撑的完整件结果。两个 3MF 内嵌 G-code 摘要与实际切片文件一致。

P2 估计 8 小时 28 分 30 秒、278.96 g。P3 估计 5 小时 2 秒、164.57 g。首层 Z=0.20 mm 左右背板采样区域分别有 228 和 221 条底面走线，支撑走线均为零。P3 声腔内部采样包络中没有支撑挤出移动。切片器标为 Bridge 的两条 77.485 mm 前壁路径，其前一层位置全部处于实体壁包络内，下方为壁内填充。最终前壁斜面逐层收拢。

P2 饰片周围仍有位于侧壁厚度范围内的浅支撑，从内侧可直接到达侧孔背面。完整件打印和拆除力仍待实物验证。切片日志保留安装版本官方结束代码的 `T65535` 解析提示，两个切片进程均成功退出。

## 文件与边界

正式模型为 `hardware/enclosure/Discora.FCStd`，重建源为 `build.FCMacro`。完整 STL 位于 `tmp/cad-wide-chambers/print/RearShell.stl` 与 `SpeakerCarrier.stl`，带切片 3MF 分别位于同目录上级的 `RearShell/RearShell.3mf`、`SpeakerCarrier/SpeakerCarrier.3mf`。

CAD 与切片验证已完成。解除锁屏后，用户协助在 Bambu Studio 中完成最终加宽版切片并切到首层、第 110 层（22.0 mm）及完整走线状态；画面核对双背板直接贴板、侧孔附近支撑位于外侧。截图及工程保留在 `tmp/cad-wide-chambers/SpeakerCarrier/`。没有发送打印任务。现有十一页图册对应 ADR-0039 版本，侧孔和声腔尺寸以本记录为准；随后新增顶部出线孔的当前打印文件见 [ADR-0041](0041-p3-speaker-sealing-and-wire-exits.md)。

0.7 mm 间隙用于滑动装配；后续按用户选择保留开放接口，不加软密封，详见 ADR-0041。PLA 收缩、完整件配合、支撑拆除力和气密仍待实物验证。声腔容积及通道长度已改变，声学调谐与听感仍待测量。
