miclle/discora/docs/records/2026-11-14-p3-channel-layout-study.md

# P3 声腔与侧导管布局比较

> 后续已按用户授权落实为 [ADR-0043 配套 P2/P3](../decisions/0043-independent-speaker-ducts-and-open-outlets.md)。本记录保留当时的研究状态与未改 P2 的对照，不作为当前打印文件入口。

日期：2026-11-14。状态：**布局研究及候选 CAD／切片已完成，未替换正式 P2/P3，未确定声学调谐，也不是新的打印发布版。**

## 输入与目的

用户指出当前喇叭后腔经侧向空腔较直接地通往侧孔，并补充原箱出口约 20 × 20 mm、折返路径中有两段各约 50 mm、其中一处转向约 90°。这些是原箱的参考测量；不能据此认定整管都是 400 mm²，也不能把两段长度之和当作含转角、端部修正的有效管长。

用户明确要求以 Discora 的结构与声道合理性为优先，不追求绝对无支撑，不照搬原箱，也不追加打印试片。喇叭试装通过的安装座、双芯线单根 Ø1.8 mm、可拆装要求继续保留。

直通本身并不能证明声学错误。倒相结构需要同时考虑单元、净腔容积、端口截面和有效长度；折弯只是容纳管长的一种方法。参考 [KICKER 箱体设计资料第 8–9 页](https://www.kicker.com/app/misc/support/tech/tech_papers/docs/BoxDesigns.pdf)。本研究没有单元 T/S 参数、阻抗或频响测量，不判断两个候选的低频响应孰优。

## 当前模型测量

基线为 ADR-0042，SHA-256：`b7a0ae893055d53e53d775522b112aef683b7cced73069f6f60b74c9f59b85f8`。

临时封住喇叭前口、侧出口和出线孔后，每侧封闭空气域约 **291.38 cm³**；再将整个 CAD 喇叭包络作为实心扣除，余量约 **183.76 cm³**。前者未扣单元，后者把盆架等内部空隙也全部扣掉，二者是空间预算口径，均不当作实测净声学容积。没有把侧腔整体当作已有的等截面倒相管。

## 比较与选择

| 方案 | 空间／结构结果 | 判断 |
| --- | --- | --- |
| 保留当前开放侧腔 | 主腔空间最大、零件少；安装框开口允许后腔进入侧腔，不能用视觉上的绕行距离充当管长 | 保留为比较基线，不能仅因直通而判定声音不好 |
| 外侧独立导管，单次 90° 转向 | 候选直段截面 400 mm²、名义轴线路径 46.8 mm；主腔预算减少约 24.39 cm³；避开已试装安装座、喇叭包络与线材走廊 | **选择为下一版布局方向**，有明确入口、管段与出口；400 mm² 和 46.8 mm 是研究参数，不是已定调谐尺寸 |
| 按 400 mm²、100 mm 作长管预算 | 仅管内空气就需 40 cm³，另计管壁与转角；相当于当前两种预算口径的约 13.7%／21.8% | 未建成完整候选；没有足够依据为凑原箱长度付出这些空间，不据此宣称长管无法容纳或声音更差 |

## 单次转弯候选

每侧导管布置在外侧空腔内。入口位于 Z=98 mm，距顶壁内面 20 mm；沿侧边向下，到 Z=65 mm 转向侧出口。有效出口相对原侧孔中心 Z=80 mm 下移 15 mm。两侧镜像，喇叭、安装座、P3 固定及电子件位置不变。隔板围成独立导管，仍保留一个相连的主后腔，不另造多级耦合小腔。

管道净宽 20 mm，名义直段法向面积 400 mm²。沿竖直管段将屋脊在 Y 方向缓变 1.5 mm，肩部作相反补偿，保持直段面积；打印时逐段合拢，避免整个约 42 mm 长的管顶在同层封口。此处为了修复实际切片问题，没有通过内部支撑、封堵、缩孔或削弱支撑检测实现。

候选主腔（扣导管、未扣单元）约 **266.99 cm³**；扣完整喇叭包络后约 **159.37 cm³**。管内空气约 **18.12 cm³**，数值按分析封口平面截取；名义 46.8 mm 轴线路径不含 P2 外壁、端部修正或弯头修正。

当前布局与候选的真实 CAD 剖面

箭头只表示连通方向，不是声场、速度场或声线追踪。灰色为保守喇叭包络；它不表示真实磁路、盆架或内部空气的形状。

## P2 出口是必要的联合修改项

P3 候选与现有 P2 **没有实体碰撞**，但原饰片会遮住新导管的出口投影。在 X=-82.5 mm 截面，候选 400 mm² 投影内的直通自由面积仅约 **99.52 mm²**。这不等于 P2 整个开口的通流面积，也未把侧向绕行计入，但足以说明不能直接配用旧 P2，或把“无碰撞”当作“无阻挡”。

下一版应由 P3 承担完整导管，P2 在其外侧提供不遮挡的出口及保护结构；出口位置、饰片与边缘过渡共同调整。0.7 mm 拆装间隙不充当导管的一段管壁。此研究没有为解决声道而增加永久胶合接缝。

## 候选验证及交付边界

- CAD：有效单实体、左右镜像；原安装框及其余非组对象差集为零；喇叭占位无碰撞；现有线材走廊通过；临时封闭唯一管道入口后，主腔与导管确实断开，没有绕过管道的旁路。
- 装配：沿用既有保守扫掠与离散采样方法，7 条拆装路径通过；这不证明实物装配。
- Bambu Studio CLI：P2S／0.4 mm／Generic PLA／0.20 mm，沿用原树状支撑设置。287 层没有切片器告警、新增无支撑孤岛或超过既有阈值的新增悬挑区域；保守声腔包络内支撑挤出线段为零。单次转弯管顶初稿的约 41.63 mm 桥接路径已消除。
- 候选 P3 切片估计 5h 37m 4s、180.86 g；原 P3 约 5h 4m 14s、161.60 g。导管带来的额外材料和时间是本方案的代价，不能以无腔内支撑为由忽略。
- 剖面和 G-code 检查仍不能证明实际气密、桥接表面、气流噪声或声音质量。转角及入口边缘还需在定稿阶段细化；**没有声学仿真结果，也没有新 P2 的联配打印发布文件**。

汇总证据：[p3-channel-study.json](../../hardware/enclosure/p3-channel-study.json)。候选及复现脚本均在忽略目录 `tmp/cad-p3-channel-study/`：`measure.py`、`candidate.py`、`outlet.py`、`slice.py`、`review.py`、`finalize.py`；拆装检查使用仓库 `check-assembly.py`。运行环境为 FreeCAD 1.1.4 所带 Python，包含 Part、MeshPart、Shapely 和 Matplotlib；运行目录为仓库根目录。候选未在 GUI 重开核对外观，剖面图来自保存模型的真实 B-rep。

候选模型 `Discora-P3-L-Duct-Study.FCStd` 和 `SpeakerCarrier/Discora-P3-L-Duct-Study.3mf` 仅用于布局／切片审查。正式 `hardware/enclosure/Discora.FCStd` 仍为 ADR-0042；该正式版的打印检查有效，但不能视为已完成本轮声道定型。没有发送打印任务。
