miclle/discora/docs/records/2026-11-14-p3-overhang-audit.md

# P3：18 条未支撑区域逐处核对

> 后续更新：本页记录的旧 P3 悬空问题已在 [ADR-0042](../decisions/0042-p3-printable-frame-transitions.md) 中修复并重新切片。以下告警及打印文件属于初版历史证据，当前请使用 ADR-0042 文件。

日期：2026-11-14。结论：**18 条告警对应 10 个实际位置，当前切片中没有一处可以直接按可靠桥接放行。完整 P3 需先调整几何。** 本次仅审计，正式 CAD、STL 和 3MF 未修改；不打印试片、不发送打印。

## 定位方法与完整性

使用正式顶部出线版 3MF、相同 P2S 0.4 mm / Generic PLA / 0.20 mm 配置，保持仅底板、仅关键区域的自动树状支撑。命令行基准复现 `18 of 26 region(s) uncovered, 1442.03 mm2, lowest_z=10.8`。

从同一 3MF 创建临时诊断副本，仅添加指定位置的支撑屏蔽体，再分别切片：左右安装框各屏蔽一次，告警均从 18 降至 17；8 个螺柱分别屏蔽，均从 18 降至 16。合并屏蔽这 10 个位置，未支撑计数为零。这证明已覆盖原始全部 18 条，而不是凭截图猜测位置。

**屏蔽体只用于定位，绝不是消除缺陷的方法。所有诊断副本位于 `tmp/p3-overhang-audit/`，不得用于打印。** 正式文件及支撑参数保持原样。

[Bambu Studio 对应版本的检测源码](https://github.com/bambulab/BambuStudio/blob/v02.09.01.70/src/libslic3r/PrintObject.cpp#L5947-L6340)按逐层候选区域累计；单区面积至少 3 mm²、支撑覆盖不足 5% 才计入，累计至少 20 mm² 时通知。候选列表并不保证物理位置唯一；本件每个螺柱对应两条同位置计数，不能把它们当成两个螺柱。源码同时收集 cantilever 和 sharp-tail 候选，与本次重复计数相符；实际位置及数量以逐个屏蔽试验为证据。

## 18 条逐项对应

下列编号是本次审计编号，并非 Bambu Studio 的内部 ID。X、Z 为 CAD 坐标；层高为背面朝下的打印高度。成对编号表示同一物理位置的两条计数，已在 JSON 中逐条展开。

| 审计编号 | 实际位置 | CAD 位置 / mm | 层 / 高度 mm | 单独屏蔽后剩余告警 | 结论 |
| --- | --- | --- | --- | --- | --- |
| 01 | 左安装框后缘 | 框外侧直边 X≈−50 | 54 / 10.8 | 17 | 需调整几何 |
| 02 | 右安装框后缘 | 框外侧直边 X≈+50 | 54 / 10.8 | 17 | 需调整几何 |
| 03、04 | 左喇叭外侧下螺柱 | X=-44，Z=41 | 206 / 41.2 | 16 | 需调整几何 |
| 05、06 | 左喇叭外侧上螺柱 | X=-44，Z=111 | 206 / 41.2 | 16 | 需调整几何 |
| 07、08 | 左喇叭内侧下螺柱 | X=-8，Z=41 | 206 / 41.2 | 16 | 需调整几何 |
| 09、10 | 左喇叭内侧上螺柱 | X=-8，Z=111 | 206 / 41.2 | 16 | 需调整几何 |
| 11、12 | 右喇叭内侧下螺柱 | X=8，Z=41 | 206 / 41.2 | 16 | 需调整几何 |
| 13、14 | 右喇叭内侧上螺柱 | X=8，Z=111 | 206 / 41.2 | 16 | 需调整几何 |
| 15、16 | 右喇叭外侧下螺柱 | X=44，Z=41 | 206 / 41.2 | 16 | 需调整几何 |
| 17、18 | 右喇叭外侧上螺柱 | X=44，Z=111 | 206 / 41.2 | 16 | 需调整几何 |

## 为什么不能直接桥接

### 01–02：两侧安装框后缘

第 54 层首次生成安装框后缘。实际 G-code 的外侧长边有 **83.6 mm 连续走线**，前一层挤出包络在其下方为空，线段两端也没有前一层材料承接。其它框边与腔壁局部相连，不足以让这条长边可靠起印。不能用“框很薄”或 `Bridge` 分类代替承接检查。

建议保留已通过试装的前部座面、入口和盆架避让，将框后部改成逐层展开的斜面，辅以必要的永久连接筋，从已成形腔壁承接。不能直接把完整框圈延长到背板：原框后缘 Y=52 mm、声腔内背面 Y=60 mm，后方约 8 mm 通路需要保留，否则可能切断内外隔间的导音路径。具体斜面、筋位和通道净空仍须设计后验证，本次未宣称方案已验证。

### 03–18：8 个喇叭盲孔螺柱的后端

第 206 层同时出现 8 个约 Ø8 mm 的底端孤岛。它们与前一层的安装框不相接；每个圆盘内部虽有约 5.28 mm 的 `Bridge` 走线，但两端落在同层的悬空圆周上，没有下层承接，因此不能按“小跨距可桥接”放行。

建议从已有安装框向螺柱后侧增加逐层长出的永久斜筋，消除底端孤岛；保留座面、孔距、Ø2.3 mm 导孔、10.5 mm 孔深及盲底，不改已试装的盆架轮廓。斜筋必须避开喇叭、端子和线束，并检查不会显著收窄声道。它们是零件本体，不是需要从声腔内拆除的打印支撑。

## 其它部位及验收边界

- 这 18 条告警不来自新增出线孔或侧导音孔；这不是对所有未告警悬挑的额外打印保证。
- 原首层双背板贴板、声腔内零支撑等局部检查仍成立，但不足以推出“完整 P3 可以打印”。此前报告的笼统通过结论在打印说明、状态页及 JSON 中已更正。
- 本次没有开启腔内支撑，也没有把支撑屏蔽写入正式 3MF。建议通过本体几何解决这些起印问题。
- 修改后的验收应包含：全部 18 条原问题消失且没有新增孤岛、关键悬挑逐层有承接、声腔内无难拆支撑、左右对称、原座面和孔位保持、喇叭与线束拆装净空、后方导音通路连续、首层双背板仍直接贴板。切片无告警不能单独代替这些检查。

## 证据

- [结构化核对表与逐次计数](../../hardware/enclosure/p3-overhang-audit.json)，包含正式 CAD、STL、3MF、G-code 的 SHA-256。
- 实际走线叠图：`tmp/p3-overhang-audit/overhang-regions.png`。灰色为前一层、蓝色为当前层、绿色为支撑。
- 原始切片日志、逐位置诊断 3MF、`diagnostic.py` 与 `gcode_audit.py` 位于 `tmp/p3-overhang-audit/`。
- 走线承接分析使用 G-code 线宽构建前一层包络，并增加 0.03 mm 容差；它不模拟熔融挤出，也不证明实物桥接质量。
