miclle/discora/docs/decisions/0024-rear-access-front-cover-fasteners.md

# ADR-0024：前壳螺丝改为背面操作

- 日期：2026-11-08
- 状态：implemented（CAD）；打印配合、工具和连接强度待实测。
- 依据：用户要求取消前壳正前方外露螺丝孔，改到背后。

**2026-11-14 上方孔座加强。**在 X=±29、Z=179 的两个上方深孔座上侧，各用一条 X 向宽 4 mm 的短三角筋把孔座接到后斜面内侧，关于 X=0 镜像。筋条融合后，新增材料沿 Y 约长 11 mm。下方两处深孔座沿深度方向与 5 mm 侧壁融合，现有结构没有独立三角筋。

四处深孔均通过 Ø4 mm 刀杆包络检查。上方两条筋距该包络最近 1.50 mm，原 Ø4.4 mm 工具孔保留。断线并卸下背锁螺钉后，前壳总成沿 −Y 前移 140 mm，按 1 mm 步长检查无干涉；新增筋到前壳总成的最小采样净距 2.878 mm，按步长推得的连续净距下界为 2.378 mm。整件后壳仍为一个左右对称的实体。锁紧强度、工具实际配合和拆装寿命待试装。 [工具通路](../../hardware/enclosure/fastener-checks.json) · [加筋净距](../../hardware/enclosure/backlock-rib-checks.json)

## 结构

取消原来 X=±65、Z=18 / 140 的四个正面通孔和沉头孔。前壳正面恢复完整 5 mm 面板，内侧增加四个盲孔连接柱；P2 增加从后方接近的螺丝座和导向通道。仍为三个主要结构件，不新增独立后盖。

四处均沿 Y 从后向前锁紧，左右对称：

| 位置 | 轴线 X / Z | 外表面轴心 Y | 螺钉承压座 Y | 轴向通道深度 |
| --- | --- | --- | --- | --- |
| 后壁下方两处 | ±67.4 / 18 | 80 | 14.2 | 65.8 |
| 后斜面两处 | ±29 / 179 | 60.296 | 39.2 | 21.096 |

上方开口位于后斜面，因轴线沿 Y，表面轮廓为斜切椭圆。其通道在光驱、DAC 和主控上方，并避开四键压板和碟口。下方通道沿侧壁位于电池两侧。没有采用穿过整个机身的超长螺钉；采用深孔接近短螺钉。

名义连接：螺钉直径 2、头下长 8 mm；通孔 Ø2.2，头部及工具通道 Ø4.4，按螺钉头径不超过 4 mm 检查；前壳盲底孔 Ø1.6，有效啮合约 4.8 mm。前柱与后座间留 0.4 mm；连接柱外径 4.6、避让孔 Ø5.1。具体螺钉牙型、打印底孔补偿、长度和扭矩需样件确定，不作为采购验收。

下方深孔要求细长螺丝刀至少约 66 mm 有效伸入长度，轴径须适合 Ø4.4 通道。模型用 Ø4 实体圆柱检查螺钉头及工具通路；实际批头、刀杆和手柄未建模。下方导向壁与侧壁连成一体，上方通道与后斜面连成一体，仍须检验打印支撑清理和承载。

## 拆装与验证

拆卸时从后方取出四个深孔内的螺钉、断开前壳操控线，再把整个前壳向前退出。前壳不再先上抬，避免连接柱横向卡在定位孔里。支架、侧孔、电池、光驱的拆卸次序沿用既有方案。

`fastener-checks.json` 检查原四处正面孔已补实、盲孔未穿透、四条工具通道无实体交叠。`validation.json` 检查静态交叠、对称和三主体连通；后斜面归属核对扣除新增背锁开孔后进行。`assembly-paths.json` 对前壳向前退出以 1 mm 步长检查，其余路径保留既有检查方法。闭合网格、本地切片、配色重开和图册同步更新。

以上仅为 CAD 与本地切片证据。实际拧紧强度、反复拆装寿命、打印孔径及工具可用性需要实物核对；线缆和紧固件未作为完整实体装配建模。
