miclle/discora/docs/decisions/0037-perfboard-carrier-and-front-harness.md

# ADR-0037：一体洞洞板托架与前壳可拔线束

- 日期：2026-11-14
- 状态：CAD 已实现，实物装配待验收

## 决定

在原 100 × 55 mm 机内候选的基础上，将焊有 ESP32-S3、PCM5102 和两块 DCE001 的洞洞板水平转 180°，在机身右前角避让 B50K 和线束，在左边保留一小段板边安装 2 芯插座。P3 上层改为一体托架，三枚名义 M2×4 定位，左侧插座下方增加承压面。侧置 DAC 的旧支撑已从 P2 移除。整机外轮廓及声学结构保持左右对称。

装配后主控 USB／COM 插座留空。光驱桥接器的 D−、D+、GND 直连 GPIO19、GPIO20、主控 GND，DCE001 A 供主控 5Vin，DCE001 B 供光驱／桥接器 VBUS。B50K 开关触点、OLED 和四个按钮各使用一组载板端 XH2.54 可拔接插件。音量调节的双声道模拟线束接功放，开关触点的电流用途和新 B50K 的额定值仍待确认。

## 前壳维护

断电并取出四枚背锁螺钉，托住前壳，沿机身前方平移到 60 mm 维护位。三组线束在合壳时各有一个 U 形回环，拉开时释放余量。到位后先向上拔音量开关并移开线，再向上拔 OLED，最后向机身左侧拔四键插头。随前壳移动的功放音量模拟线束也需要留出服务余量或能从该位置断开。

位置、孔位、校核与复现见[洞洞板布局](../perfboard-layout.md)和[检查报告](../../hardware/enclosure/perfboard-checks.json)。候选孔、插头和线束依据名义包络，实物脚距、给线长度、焊点高度、手指握持、装配应力及螺钉配合仍需试装。

图册已同步当前模型：第 8 页为洞洞板板形、孔位及布局，第 9 页为合壳／60 mm 维护位及拔插顺序，见[图册说明](../enclosure-drawings.md)。
