miclle/discora/docs/decisions/0032-b50k-cross-knob.md

# ADR-0032：B50K 带开关电位器与圆角十字旋钮

- 日期：2026-11-10。
- 依据：用户选定双联 8 脚 B50K 带开关电位器，提供主体、轴、偏心位置、引脚及六角螺母尺寸，并要求薄圆盘＋圆角十字造型；后续要求取消旋钮侧螺钉，收细十字并将底盘略微下沉。
- 状态：CAD 已实现；几何、拆装及切片证据见下列报告。实物装配、锁紧、音量与开关电气功能未验收。

> 2026-11-14：电位器组件及内槽已由 [ADR-0036](0036-pcb-volume-module.md) 的 PCB 模块方案替代；外部旋钮、轴心和夹持基准保留。以下裸电位器参数和报告是历史证据。

## 元件与安装基准

来源及全部尺寸见 [B50K 元件记录](../../hardware/Potentiometer-B50K-Switch/README.md)。旋钮轴心仍在 X=48、Y=18、Z≈177.789 的前斜面，屏幕、四键及主体外形不移动。沿斜面局部 X 向右、Y 向内、Z 向上；主体 9.5×14.5×11.2，轴心到朝下的引脚侧外壁为 2.7。

原 Ø8.8 占位孔改为 Ø7.2，容纳 Ø6.8 螺纹。因螺纹长 5，原 5 mm 前壳没有螺母锁紧余量，内侧开主体沉槽。外侧另设底径 Ø24.8、深 **1.6 mm** 的圆形凹位，入口 0.4 mm 倒角扩至 Ø25.6；主体安装面同步内移至 3.6 mm，凹位底与主体之间仍保留 **2 mm** 夹持面，其余斜面仍厚 5。主体侧隙名义 0.3；引脚侧开口容纳 3.5 mm 引脚并再留 3.8 mm 焊线区域，不虚构 8 脚脚距。引脚及线材区域是保守矩形包络。

六角螺母按对边 **9.8**、厚 **1.9** 建模。安装面在局部 Y=3.6，螺纹向外到 Y=−1.4，螺母位于 Y=−0.3…1.6，尚余 1.1 mm 螺纹长度；不含未指定的垫圈。矩形主体槽提供辅助限转，螺母夹紧需要实物确认；不把 PLA 薄壁的几何有效当作抗蠕变或承载验证。

## 旋钮

- 黑色薄底盘 Ø24、厚 1.4；圆角十字跨度最终改为 **24**，四个端部与底盘外径齐平、臂宽从 9 收至 **6.8**，端部 R3.4、内角 R0.8、顶边 R0.5；握持部底边 R0.25，避免与同径底盘相切产生网格接缝。
- 底盘底面下沉到面板内 **1 mm**，上表面仅高出面板 0.4；底面到凹位底留 0.6，径向留 0.4。入口倒角使边缘形成细窄环形过渡。
- 电位器和轴向内移 1.6，旋钮顶面由 14.5 降至 **12.9**，旋钮自身总高仍为 13.9，不截短金属轴。
- 根部有高 3.2、半径由 7.2 收至 6.2 的短锥形过渡，封闭细十字臂之间的螺母腔；腔顶处径向壁厚大于 0.57。底部 Ø12 避让腔仍让开六角螺母及螺纹。
- 取消侧孔、攻丝和紧定螺钉。Ø6.0 基孔内增加 **6 条压配筋**，各宽 0.6，主接触段长 6、入口渐变长 1；筋尖内切直径 **5.6**，对 Ø5.8 花轴包络形成最大 **0.1 mm 径向名义过盈**。实际花轴压入后筋尖允许局部压溃／咬合；并非已知齿数的匹配花键，也不是带锁扣槽的卡簧结构。
- 轴端到孔顶 0.3，顶部最薄 1.2。顶面指示标记改为 **0.7×2.2、深 0.6 mm 的白色 PLA 实体**，与黑色顶面齐平。黑色主体与白色标记为同一 `Knob` 对象中的两个不重叠实体，合并后连续；使用双色 3MF 共同打印。
- 压配筋参数是试配起点。`export-volume-fit-samples.py` 导出筋尖直径 5.5／5.6／5.7 三种试片；先选可手压插入、可传递开关力矩且无明显晃动的一档，再调整 `volume_shapes(grip_tip_diameter=...)` 并重建。试片用于比较松紧，不代表完整旋钮已通过扭矩、拔出力或寿命验收。

保留 32 个成品对象和 10 件刚性 PLA 打印件；`Encoder` 名称为历史对象 ID，此处是实际电位器的轴／螺母组合包络，并非电子编码器。螺母与轴合并表示不意味着采购件焊接为一体；真实安装必须先锁螺母再装旋钮。

## 装配和电气边界

前壳卸下后，从内侧将主体放入沉槽、螺纹穿过 Ø7.2 孔；在凹位内锁紧螺母，再对准最小音量／开关位置与指示线，沿轴压入旋钮；压入时支撑电位器主体，不通过 PCB 或焊脚承受装配推力。先确认 0.6 mm 凹位底间隙、0.4 mm 径向间隙、整个旋转角度、末端开关动作和焊线不受拉扯，再合壳。拆卸按反序执行。

选定 B50K 替代此前拆焊原功放电位器的机械占位；功放焊盘、两组三端和开关触点对应仍需实测。本次不修改固件与供电线路，不指定未经核对的引脚编号，补充特性表标注开关 1 A / DC 12 V，但其总阻值为 10K，与 B50K 的适用关系未确认，不将该开关触点当作已定型电池主开关。

## 验证

- `volume-checks.json`：按保存实体核对用户尺寸、偏置、夹持面、螺母、轴孔与顶部余量、引脚／焊线和工具空间；连续圆柱包络检查整圈旋转；31 个 0.5 mm 间隔姿态检查电位器沿轴退出。对照首次音量适配前基准，28 个其它成品保持，前壳差异限定在安装区域，双色键帽面序保持。
- `validation.json`：整机静态干涉（六条压配筋与花轴圆柱包络的限定过盈单独记录）、三主体连通、外形尺寸、退碟与通气、左右对称性。电位器沉槽属于既有操控布局例外，纳入 `CowlTool` 的精确镜像豁免；不会将整个右半壳排除检查。
- `assembly-paths.json`：带新电位器的前壳拆装及既有内部件路径。
- `knob-span-checks.json`：24 mm 十字修订前后 31 个其它成品的 B-rep 一致；半径 7 mm 安装核心保持，测量双向跨度、臂宽及原旋转包络，重新检查实际静态干涉。
- `volume-fit-checks.json`：三档压配试片的闭合网格、源脚本摘要及本地切片；未发送打印。
- `dual-color-knob-checks.json`：黑白两个闭合网格、无体积重叠、保存的分面材质及 Bambu Studio 的材料分配；0.4 mm 喷嘴／0.12 mm 层高生成 5 层白色标记路径。31 个其它成品几何保持，标记区域外的旋钮几何保持；未实物打印。
- `print-checks.json`：当前模型单色包络网格及三主体／两个压框支架的单色切片；旋钮与四键分别使用双色记录；切片不代表压配保持力、夹紧力、表面质量或实体耐用性验收。
- 图册、操控区预览及 `volume-detail.png` 从同一保存模型生成。FreeCAD GUI 服务不可连接，保留其它 GUI 资源并更新旋钮分面材质数组，检查键帽面序；未完成 GUI 关闭重开颜色读回。

电气型号与外观图不能替代花轴齿形、主体安装面细节、脚位、实际线径弯折和制造公差。优先打印旋钮及安装试片，再确认整件打印。
