miclle/discora/docs/decisions/0033-uniform-front-side-seam.md

# ADR-0033：对称后壳与等厚贴合前壳

- 日期：2026-11-11
- 依据：用户要求消除前斜面侧缘上部变薄与后壳顶部凸出的收口，后壳侧视左右对称，前壳贴在后壳上，允许前壳斜面起点高于后壳。
- 状态：CAD 实现；几何、对称、拆装路径、背锁通路、网格及本地切片检查通过，实物配合未验收。

> 后续：[ADR-0034](0034-five-mm-rear-shell.md) 将后壳主体加厚至 5 mm 并外扩，当前尺寸以该记录为准；本文保留 3 mm 版历史证据。

## 侧轮廓与分件

早期接缝从前内壁折角直接连到提手后侧外根部，比外斜面更陡，导致侧缘向上收窄；保存实体在 Y=37 处沿斜面法向测得约 3.104 mm。第一轮改成 5 mm 平行接缝，但保留原后斜面高度，在提手背面形成 2.581 mm 竖直台阶。用户随后要求取消这个凸出的收口。

最终以后壳独立侧轮廓为基准：

| 位置 | Y / mm | Z / mm |
| --- | --- | --- |
| 后壳前斜面起点 | 5 | 162.419020 |
| 后壳对称顶点 | 42.5 | 189.063757 |
| 后壳后斜面终点 | 80 | 162.419020 |
| 前壳外斜面起点 | 0 | 165 |
| 前壳外斜面终点／提手前根部 | 37.5 | 191.644737 |

后壳侧轮廓以 Y=42.5 为对称轴，前后斜肩水平宽均为 37.5、高差均为 26.644737、斜角均为 35.394796°。前壳以 5 mm 法向厚度覆盖后壳前侧，斜面起点比后壳高 2.580980 mm；其内斜面在提手后平面直接接到后壳顶点，无竖直台阶或额外尖角。左右机身侧面按 X=0 镜像处理。

前壳外表面、提手上部外轮廓与开口、操控件和硬件位置保持。后斜面及后壁上沿下降 2.580980 mm，仍保持后顶板 3 mm 法向厚度；碟口水平位置与开口不变，导向框上沿随内顶面降低。提手根部中央内轮廓随屋顶交汇重建，侧缘仍保持 5 mm。整机宽深高仍为 142 × 80 × 236.645 mm。

左右侧孔及内凹饰片整体向后移 2.5 mm，使其中心位于后壳侧轮廓的 Y=42.5；P3 对应的声腔侧向开孔同步移动，喇叭及声腔外包络保留。孔口、短管、四点连接和饰片自身尺寸不变，P2/P3 仍保留 0.3 mm 轴向名义间隙。内部 DAC 支撑与背锁等功能结构不要求沿侧视中线镜像。

## 检查与边界

- [专项检查](../../hardware/enclosure/side-seam-checks.json)：后壳外侧薄层（含可见导音孔）沿 Y=42.5 镜像差集为零；两侧 10 个法向截线均为 5 mm，后壳最高点正好为接缝终点；前后壳无体积交叠，后顶板与光驱包络最小距离为 2.501 mm。前后壳及 P3 之外的 29 个成品对象几何不变，双色件面序与 GUI 材质资源顺序保留。
- [整机检查](../../hardware/enclosure/validation.json)：32 个成品有效，三个主体各为一个连续实体，左右对称、静态干涉、退碟、空气通路与接头净距检查通过。
- [拆装检查](../../hardware/enclosure/assembly-paths.json)与[背锁检查](../../hardware/enclosure/fastener-checks.json)：前壳与光驱拆装路径、螺钉和工具通路通过；离散姿态不等于连续运动证明。上方背锁通道随新后斜面缩短，螺柱、螺钉座与紧固件位置保留。
- [打印检查](../../hardware/enclosure/print-checks.json)：三个主体重新切片；两个单色小件凭相同 STL、配置、切片器版本及原 G-code 摘要复用，四键与旋钮沿用各自双色记录。未连接打印机。
- [侧视前后对比](../../hardware/enclosure/side-seam-comparison.png)与尺寸图册已更新。GUI 接口不可用，模型、投影和检查均从保存文件读回。

接缝仍为名义贴合，打印补偿、提手承载、支撑清理、真实线束和实际拆装需实物确认；侧孔几何连通不等于声学调谐或气密验收。本次不改变固件与电气连接。
