miclle/discora/docs/decisions/0021-five-mm-front-panel.md

# ADR-0021：前壳面板与提手统一为 5 mm

- 日期：2026-11-08
- 依据：用户确认竖直面板和顶部斜面均改为 5 mm，并允许机身深度由 78 增至 80 mm。
- 状态：CAD 实现；保存模型的厚度、干涉、对称、装配路径和配色检查及本地切片通过，实物未验收。

> 2026-11-08 后续：[ADR-0023](0023-four-button-front-panel.md) 将单键改为四键，增加 P1 定位座与可拆压板。三个主体、5 mm 前面板和 80 mm 深度保留；当前共 33 个成品对象、11 个刚性 PLA 打印件。下面的单键布局和件数为本阶段历史记录，当前报告已更新。

> 后续 [ADR-0024](0024-rear-access-front-cover-fasteners.md) 取消前壳正面螺丝孔，改为四处背面深孔锁紧；前壳拆卸改为卸螺钉后向前退出。当前报告按新连接更新。

> 2026-11-09：[ADR-0026](0026-recessed-front-grille.md) 将护网正面内凹 2.5 mm，背面保持 Y=5，因此护网局部厚度改为 2.5 mm；其余前壳与顶部斜面仍厚 5 mm。

> 2026-11-11：[ADR-0033](0033-uniform-front-side-seam.md) 将两侧接缝改为平行于前斜面的 5 mm 内偏移线，修正侧缘上部收窄；后壳侧轮廓改为以 Y=42.5 对称，后斜面降低 2.581 mm，取消顶部台阶；侧孔居中于新对称轴。前壳外形与整机最大包络不变。

## 几何与布局

前壳竖直面板、顶部斜面主体采用 5 mm 法向壁厚，格栅厚度也改为 5 mm，提手厚度仍为 5 mm。屏幕安装座保留加强结构，侧缘与提手根部沿原有直线接缝过渡；不把融合安装座或根部过渡区当作等厚平板测量。后斜面与侧后壁保留 3 mm 名义壁厚，后斜面和碟口导向仍归 P2，提手归 P1。

外宽 142 mm，深度 80 mm，总高 216.644737 mm（不含脚垫 213.644737 mm）。前后斜面角度均为 35.394796°，水平宽均为 37.5 mm、实际斜宽 46.002087 mm，高差 26.644737 mm。提手 Y=37.5…42.5，左右侧孔中线同步为 Y=40。

电池改为 Y=6…76，前内壁 Y=5、后内壁 Y=77，保留前后各 1 mm 间隙。声腔、喇叭、内部板卡及相关安装结构向后让位 2 mm，声腔接口重新对齐侧孔；光驱 Y=63…72.5、碟口中心 Y=67.75，Z 坐标保留。外部按钮、屏窗、旋钮位置不变；电位器本体沿斜面内法向后退 2 mm，轴占位相应加长 2 mm，实际选型和轴长仍需实测。前壳通孔延长以穿透 5 mm 面板。

## 验证

[validation.json](../../hardware/enclosure/validation.json) 用保存实体的法向截线核对 5 处竖直面、5 处斜面、格栅和提手的 5 mm 厚度，检查三主体单一实体、26 个成品对象、静态干涉、左右镜像、退碟、通气与接头预留。[assembly-paths.json](../../hardware/enclosure/assembly-paths.json) 重新检查拆装：前壳上提 40 mm 后前移，支架和电池向前拆出；光驱先前移 11.5 mm，再侧转 −30°并前移 15.75 mm 后抽出。前壳及光驱转动为离散姿态检查，其余报告注明的平移采用连续保守扫掠。

[appearance-checks.json](../../hardware/enclosure/appearance-checks.json) 检查 FreeCAD GUI 关闭并重新打开后的颜色。[print-checks.json](../../hardware/enclosure/print-checks.json) 对新模型重新导出七件网格、完成四盘本地 PLA 切片。历史 `repartition.json`、`seam-checks.json` 保留对应阶段模型摘要，不作为本版材料量的报告。

面板和护网增厚不代表已验证声学、承载或打印支撑清理。真实线束、电位器、紧固件、提手和实物配合仍需验证；不改变固件及电气方案。
