miclle/discora/docs/decisions/0031-taller-handle.md

# ADR-0031：提手竖直部分加高 20 mm

- 日期：2026-11-10
- 依据：用户对照[参考效果图](https://cdn.sanity.io/images/gtd4w1cq/production/60fae3c6c35bc7aca00800b5c6dec681bb8084d9-4000x2250.webp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)，指出 Discora 提手高度比例偏低。
- 状态：CAD 已实现；几何、拆装及打印检查见对应报告，实际握持和承载未验收。

## 尺寸取舍

提手高出斜肩的竖直部分从 25 增至 **45 mm**，约占 142 mm 机身宽度的 31.7%（此前 17.6%）。参考图含透视，不将图中像素比例当成产品尺寸；45 mm 是本轮外观调整值。

提手仍宽 142、厚 5，位于 Y=37.5…42.5；保留 X=0 左右对称及居中长圆孔。最初加高时采用 90×36 mm 开口，用户指出上横梁偏薄后，收至 **90×24 mm**。开口中心保持 Z=214.145、X=0，端部 R12；最低点 Z=202.145、最高点 Z=226.145，上下横梁最薄处均由 4.5 增至 **10.5 mm**。长圆孔包络不等于同尺寸矩形握持空间。

肩部仍为 Z=191.645，提手顶升至 Z=236.645。整机包络为 **142×80×236.645 mm**（含脚垫），不含脚垫高 **233.645 mm**。前后斜面、屏幕、四键、旋钮、背锁连接、后壳和内部布局保持原位置；提手继续与 P1 一体打印。

## 验证与限制

- `hardware/enclosure/handle-checks.json` 对照调整前模型，检查其它 31 个成品几何不变、前壳差异仅在提手区域、提手左右镜像一致，并核对双色键帽的面序。
- `validation.json` 检查保存模型的有效实体、三主体连接、干涉、镜像、退碟通路及加高后的提手净空。
- `assembly-paths.json` 复查既有拆装路径；`print-checks.json` 记录网格、256³ 打印空间与本地切片。加高前壳的自动排版失败；调试日志显示树状支撑排版每边预留 12 mm，可用宽度仅 232 mm，小于零件长边 233.645 mm。保持正面朝下并在打印板内旋转 90°以避开后缘保留区，打印包络为 233.645×142×42.5 mm；关闭 P1 自动排版与自动定向，保留经过网格检查的居中位置，再由切片器检查实际支撑和路径。图册及整机预览使用同一保存模型。

提手前后厚度仍为 5 mm，上横梁最薄名义截面由 4.5×5 增至 10.5×5 mm；不能将截面积增加直接换算为承载提升比例。加高仍会改变侧向受力力臂。几何与切片通过不等于承载能力已验证，仍需确认 PLA 层间强度、握持舒适度、根部抗弯、支撑清理与实物跌落行为。
