miclle/discora/docs/decisions/0016-three-part-pla-enclosure.md

# ADR-0016：外壳收敛为三个主要 PLA 结构件

- 日期：2026-11-05
- 状态：模型已实现，CAD 与切片检查通过；实物打印、装配和承载未验收。
- 继承：[ADR-0015 平排电池](0015-flat-battery-enclosure.md)的 142 × 78 × 202 mm 外包络及硬件位置；替代其独立侧壳、后盖、底架、前障板和上固定耳方案。

> 2026-11-08：[ADR-0019](0019-matched-top-shoulders.md) 统一顶部前后斜面，替代本记录的旧总高与侧孔 Y 坐标；三主体分件原则保留；同日 [ADR-0020](0020-rear-roof-shell-ownership.md) 又将后斜面及碟口导向划入 P2，替代本记录的相关归属和顶部取光驱路径。当前检查报告已按新模型更新。

> 2026-11-08 后续：[ADR-0023](0023-four-button-front-panel.md) 将单键改为四键，增加 P1 定位座与可拆压板。三个主体、5 mm 前面板和 80 mm 深度保留；当前共 33 个成品对象、11 个刚性 PLA 打印件。下面的单键布局和件数为本阶段历史记录，当前报告已更新。

> 后续 [ADR-0024](0024-rear-access-front-cover-fasteners.md) 取消前壳正面螺丝孔，改为四处背面深孔锁紧；前壳拆卸改为卸螺钉后向前退出。当前报告按新连接更新。

> 2026-11-09：[ADR-0026](0026-recessed-front-grille.md) 将齐平护网改为 Ø130 圆口内凹 2.5 mm，厚度 2.5 mm；三主体分件不变。

> 2026-11-10：[ADR-0029](0029-integral-side-ports.md) 将左右导音孔与饰片并入 P2，短管止于声腔外侧以保留 P3 前向拆装路径，取消两侧安装螺钉；当前共 10 件刚性 PLA 打印件。下文侧孔后装约束为历史设计。

## 决策

用户希望减少 PLA 打印件，设备为拓竹 P2SC，有效成型空间 256 × 256 × 256 mm，具有 0.4 和 0.2 mm 喷嘴。采用三主体：P1 前壳合并提手、格栅装饰圈、通孔护网、屏幕座和碟口导向；P2 后壳合并侧壁、后壁、底架、电池托盘、光驱导轨和 DAC 支撑；P3 喇叭支架合并双声腔、前障板、喇叭预留框、功放／桥接器／主控托板与连接柱。

两个喇叭及电子板仍为可安装的采购件。前障板的隔离、定位功能保留在 P3 中，没有独立打印件。硬件安装孔尚待实物测量，模型只保留已知包络和支撑位置。

左右侧孔保留两个镜像小件。其横向管段伸入声腔，会阻碍 P3 向前装入；不能只按成品静态无干涉就将侧孔焊死在壳体上。侧孔从外侧插入、各两螺钉固定，拆 P3 前先拆侧孔。连同键帽和旋钮，共 7 件刚性 PLA 零件；脚垫与透明窗片另计。

P1 和 P3 各用四处前向连接，取消旧后盖孔。P1 从原位先上抬 40 mm，再向前移出；P3 前向抽出，光驱从顶部抽出，电池松绑后向前取出。移动前需卸紧固件、断开对应线束。连接底孔为名义设计，牙型、长度、打印补偿和密封材料须试片确认。

## 为打印和接线作的调整

- 护网正面与前壳平齐，厚度由 1.2 增至 2 mm；装饰圈外径增至 130.5 mm，与壳体、护网有实际体积连接。保留 Ø1.88 孔和 2.9 mm 孔距。
- P3 主控托板增加连接柱和横梁，柱移至功放左右接线预留区之外；不是在成品组中保留悬空实体。
- 电池托盘并入底架，增加四处绑带槽；光驱导轨并入后壳，左右各留 0.3 mm 名义侧隙。
- 左右侧孔竖直中心线由 Y=44 向前移 3.5 mm 至 Y=40.5，与提手的 Y=38…43 厚度中线对齐；开口、声腔接口和固定连接同步移动。
- 侧孔环和声腔接口各留 0.3 mm 名义间隙；上方固定柱避让 DAC 输入预留区及导音管。
- 前壳正面朝下、后壳背面朝下、P3 声腔背面朝下打印。三主体均需可移除支撑，不宣称免支撑。

## 证据和边界

[外壳说明](../../hardware/enclosure/README.md)链接同一 FCStd 摘要的静态检查、拆装检查及切片报告。26 个成品对象有效，三个主体各为一个实体；左右对称、成品干涉、退碟和预留接线区通过。除既有操控布局外，外部轮廓保持 X=0 对称；内部左侧 DAC、桥接器位置是记录的例外。

支架、光驱、电池和侧孔采用连续保守扫掠，前壳路径采用 0.5 / 1 mm 步长的实体抽样，不把它写成连续证明。检查没有完整导线、螺钉工具或软材料变形模型。

使用本机 Bambu Studio 的 P2S / 0.4 mm / 0.20 mm 层高配置完成 PLA 切片，七个网格闭合并适合 256³ 空间；0.2 mm 喷嘴未切片。估计时间和耗材见[打印说明](../enclosure-printing.md)，不是实际成型数据。未向打印机发送任务。

仍需试片和实测确认提手强度、支撑可清理性、螺钉反复拆装、孔位、气密、声学、散热、电池线材与外围板、桥接连接及真实进退碟。没有修改供电拓扑、固件或电气连接。
