miclle/discora/docs/decisions/0029-integral-side-ports.md

# ADR-0029：左右导音孔与饰片并入后壳

- 日期：2026-11-10
- 依据：用户要求左右导音孔及饰片与后壳一体打印，省去额外装配。
- 状态：CAD 已实现；验证结果见下列当前模型报告。实物打印、支撑清理、气密和声学未验收。
- 替代：[ADR-0016](0016-three-part-pla-enclosure.md) 中侧孔必须后装的分件约束，保留三个主要结构件及既有内部硬件位置。

> 后续 [ADR-0030](0030-side-inset-support-and-port-sizing.md) 将饰片改为四点连接、厚 2 mm；原分件与管口尺寸保留，净通流面积随加强筋减少。

## 几何与装配

左右导音孔及内凹饰片融合到 P2 `RearShell`，成为一个连续实体。隐藏构造组保留 `LPort` 和原生镜像 `RPort`，成品及打印清单不再包含它们；刚性 PLA 打印件从 12 件减至 10 件。两侧固定耳、凹槽、沉头孔和底孔取消，旧孔位置恢复连续侧壁。

原侧孔外环高 73.4、宽 28.4，位于 74 × 29 的侧壳开口中，存在装配间隙；现外环改为 74.6 × 29.6、厚 3 mm，与开口四周各重叠 0.3 mm，确保真实材料连接。饰片仍为 12 × 56 mm、外表面内凹 1.5 mm，中心维持 Y=40、Z=80，左右按 X=0 镜像。

原管段伸至 X=±59，会阻挡 P3 向前拆装。现短管止于 X=±65.3，声腔外侧壁为 X=±65，轴向留 0.3 mm 名义间隙；管口仍为 63 × 18，管段外轮廓 67 × 22。现有声腔开口为 67.6 × 22.6，最近实体距离约 0.424 mm。保留声腔内外空气连通，但不宣称原导音长度、调谐或密封性能保持；尚未建模密封垫，间隙漏气和声学效果需样件确认。

装配时直接把 P3 总成从前方推入后壳并固定四颗支架螺钉，取消两侧插入与锁紧步骤。拆卸时先取下前壳、断线并卸四颗支架螺钉，P3 向前抽出；导音孔和饰片始终留在后壳。光驱、电池及前壳的既有拆装路径保持。

## 证据

- [side-port-checks.json](../../hardware/enclosure/side-port-checks.json)：P2 有效且只有一个实体，侧孔完整归属、原四处螺孔补实、间隙及镜像检查；与修改前模型比较，其余 31 个成品对象保持。
- [validation.json](../../hardware/enclosure/validation.json)：32 个成品对象、三主体连通、静态碰撞、侧向空气路径、左右对称、退碟和接头预留。
- [assembly-paths.json](../../hardware/enclosure/assembly-paths.json)：侧孔作为 P2 固定部分参与检查；P3 前向连续保守扫掠无碰撞。前壳仍为离散姿态检查，光驱转动段仍为 0.5° 采样，不声称连续证明。
- [print-checks.json](../../hardware/enclosure/print-checks.json)：十件闭合网格、256³ mm 空间及 5 mm brim 余量、本地单色切片。四键继续使用已有双色 3MF 流程，未发送打印任务。

后壳仍以后壁外面朝下打印；侧孔和饰片周围的支撑需从外侧开口及后壳前方清理。切片成功不代表窄筋、支撑可达性、层间强度或实物装配通过。没有修改固件、供电、操控布局或其它硬件位置。
