miclle/discora/docs/decisions/0030-side-inset-support-and-port-sizing.md

# ADR-0030：侧饰片四点加强与导音孔尺寸边界

- 日期：2026-11-10
- 依据：用户指出侧饰片连接偏少，并要求按已选喇叭分析开口大小、必要时调整；用户确认没有更多喇叭参数。
- 状态：CAD 已实现，见当前几何和切片报告；实物承压、打印清理与声学未验收。
- 继承：[ADR-0029](0029-integral-side-ports.md) 的后壳一体打印、左右镜像及 P3 前向拆装间隙。

## 连接调整

上一版 56 × 12 mm 饰片厚 1.5 mm，仅靠中部左右两条连接筋，每侧截面 1 × 2 = 2 mm²；两端距中央连接边约 27 mm。实体连通及切片成功并不能证明这些细筋耐受手指按压或支撑清理。

现保留中部横向连接，并在上、下端各增一条纵向连接，形成四点支撑。四处连接的名义截面均为深 2 × 宽 3 = 6 mm²；这是截面积增加，不解释为强度提高三倍。饰片向内加厚到 2 mm，外表面仍内凹 1.5 mm，56 × 12 mm 外形保持。加强筋从外侧面内退 2 mm，末端到内退 4 mm，仍在短管的 5.7 mm 内伸范围内，不侵入 P3 拆装路径。左右保持 X=0 镜像。

外侧导音口仍为 67 × 22 mm，短管内口为 63 × 18 mm；不增加打印件或装配步骤，也不改变喇叭、声腔及其它硬件位置。

## 根据已选喇叭的分析

[现有单元资料](../../hardware/Speaker-80x45-4ohm-10W/README.md)只有 80 × 45 × 42 mm 包络、每只标称 4 Ω／10 W，缺少 Fs、Qts、Vas、Sd、Xmax、磁路／盆架排量和频响。80 × 45 mm 是外框尺寸，不能直接作为有效振膜面积 Sd，也不能用外框面积的某个比例确定倒相孔。

从模型按不同深度截取流道并扣除饰片、管壁和连接筋，单侧最窄采样截面从 **411.37 mm²（4.11 cm²）** 降到 **384.24 mm²（3.84 cm²）**，减少 **6.59%**。按面积换算的圆直径从 22.89 降到 22.12 mm，仅便于比较面积；长窄、多通道开口的阻力、端部修正和共振不能等同于该圆管。最窄区由两个通道变为四个通道。

内腔构造长方体为 61 × 50.5 × 84 mm，体积 0.258762 L。把喇叭的完整长方体占位当实心扣除，剩余 0.107562 L；真实盆架并非实心长方体，这两个数只是空间预算，**均不是已测得的声学净容积**。真实安装面、密封垫、线材排量和声腔接口尚未闭合；P2/P3 之间还有 0.3 mm 名义装配间隙，不能按理想密闭箱加单根管直接给出调谐频率。

因此，本轮没有可靠依据把导音口进一步缩小，保留外轮廓与短管尺寸，仅接受结构加强带来的约 6.6% 净面积减少。当前仍称未调谐侧向通道，不宣称低频增强或适配该单元的倒相设计已经完成。孔径、管长、净容积与单元参数必须一并确定：扬声器厂商 [Stetron 的箱体说明](https://www.stetron.com/effectofanenclosure/)说明了这一依赖；[KICKER 的箱体设计说明](https://www.kicker.com/how-to-build-a-subwoofer-box)指出缩小通流面积会增加气流速度及端口噪声风险。这里只采用一般原理，没有套用其低音单元的具体尺寸建议。

样件阶段先落实喇叭安装与密封，再以相同音量比较开放、部分遮孔和封闭状态，检查低频响应及气流噪声；优先取得阻抗／频响测量，再决定是否缩孔或更改管长。临时遮孔可使用可移除材料，不增加本次 CAD 的装配件。

## 检查与边界

- [port-reinforcement-checks.json](../../hardware/enclosure/port-reinforcement-checks.json)：四处连续连接截面、饰片厚度、修改仅增加侧孔区域材料、对其它成品无新增干涉、不同深度净开口面积和空间预算。
- [side-port-checks.json](../../hardware/enclosure/side-port-checks.json)：一体后壳、对称、原侧孔螺孔补实与 0.3 mm 轴向间隙；其余 31 个成品对象保持。
- [validation.json](../../hardware/enclosure/validation.json)、[assembly-paths.json](../../hardware/enclosure/assembly-paths.json)：当前模型静态、导音探针及拆装路径检查。
- [print-checks.json](../../hardware/enclosure/print-checks.json)：加强后的后壳重新切片；其余单色盘仅在 STL 字节、配置摘要和切片器版本全部相同后复用前次结果。四键沿用双色记录。

没有负载、材料各向异性或疲劳试验，不给出可承受按压力；没有声学测量，不认定开口大小已最优。

FreeCAD GUI 的本次 `reload_document` 超时，RPC 报告界面派发停滞；桌面处于锁屏状态，无法补做界面检查。未重启应用。FCStd 在重载前已保存，以上几何、网格、切片与图册检查均直接读取该保存文件。
