miclle/discora/docs/decisions/0023-four-button-front-panel.md

# ADR-0023：前斜面四键与独立键帽

- 日期：2026-11-08
- 状态：implemented（CAD）；尚未实物打印或装配验收。
- 依据：用户要求播放／暂停、上一曲、下一曲、退碟四键；提供 12 × 12 mm 本体平面尺寸、整体厚 6 mm、凸起 2.8 mm、引脚长 3.7 mm，并确认 **6 mm 包含 2.8 mm 凸起**。原图和尺寸来源见[按键资料](../../hardware/Tactile-Switch-12x12/README.md)。

> 后续 [ADR-0024](0024-rear-access-front-cover-fasteners.md) 取消前壳正面螺丝孔，改为四处背面深孔锁紧；前壳拆卸改为卸螺钉后向前退出。当前报告按新连接更新。

> 2026-11-09：[ADR-0025](0025-open-button-wire-retainer.md) 根据引脚面照片和直接焊线要求，将下述整片压板／中央圆柱支点替换为两侧敞开的双点支承架。下面原压板的 0.8 mm 余量为历史方案，当前脚端后设计预留为 2 mm。

## 布局与传力

保留 5 mm 前壳、80 mm 机身深度、屏幕和音量旋钮位置。四键集中在屏幕左侧，避免移动内部主控、桥接器或光驱。前排 Y=9：X=−59 为播放／暂停，X=−41 为退碟；后排 Y=26：X=−59 为上一曲，X=−41 为下一曲。列距 18 mm，行距沿斜面为 20.854 mm（Y 投影 17 mm）。键心均在 Z=165+(27/38)Y 的前斜面上。按键属于外壳左右对称约束的操控例外。

采用四个独立打印键帽和凹刻功能图标。面板孔 Ø10.5，帽身 Ø10，径向名义间隙 0.25；键帽外露 1.2，背面止退沿 Ø12.8、厚 0.8。面板自身保持 5 mm。以外表面为深度 0、沿法向朝内为正：键帽从 −1.2 至 6.0；开关凸起从 6.0 至 8.8；12 × 12 mm 开关本体从 8.8 至 12.0，因此本体厚 3.2。

圆形按压头直径尚未测得。模型使用 **Ø12 × 2.8 的保守包络**，不是声称实物直径为 12 mm。面板孔由独立键帽决定，实物圆头留在面板内侧。CAD 检查键帽向内 0…0.8 mm 的五个姿态，排除同键未压缩的按压头包络；这只验证设计余量，不确认实物开关行程、按压手感或公差链。

## 定位与固定

四个 15.6 × 15.6 mm 定位座和压板螺柱并入 P1。开关方孔 12.4 × 12.4，单侧名义间隙 0.2；开关顶面四角抵住定位台阶。Ø13.2 内腔容纳键帽止退沿，Ø12.4 过孔为按压头留空间。

一件可拆压板位于法向深度 16.5…18.5，四个 Ø4 中央支点从深度 12 支承本体背面。两处名义 M2 连接使用 Ø2.2 通孔／Ø4.2 沉头和 Ø1.6 底孔；螺钉牙型、长度、扭矩及打印孔补偿未定。压板局部避让 DAC 原有输出接头预留，额外留 0.5 mm。

引脚暂按从本体背面再伸出 3.7 mm 预留，至深度 15.7，距压板名义平面 0.8 mm。**引脚尺寸基准、排列、截面和焊点尚未确认；中央支点必须以实际无引脚的承压面为准。** 模型未虚构四根引脚位置，不把该轴向预留视为已验证的焊接／线缆空间。若支点与实际引脚冲突，需要改压板支点；不得直接据此制作 PCB 孔位。

装配时，从前壳内侧依次装键帽、开关，再固定压板；先核对回弹、焊点和线缆空间，再合上前后壳。四键和压板随 P1 一起拆下。外壳仍为三个主体；计四键帽、压板、旋钮及两侧孔，共 11 个刚性 PLA 打印件。

## 验证边界

保存后的 FCStd 重新读回进行静态交叠、主体连通、对称、退碟、接头预留、拆卸路径、键帽余量和闭合网格检查。脚本与结果见 `hardware/enclosure/` 的 `validation.json`、`button-checks.json`、`assembly-paths.json`、`print-checks.json`；配色通过 GUI 关闭并重开读回。保留的屏幕与旋钮位置不变。

以上为 CAD／本地切片证据，不替代实际开关直径、行程、引脚和安装承压面测量，也不代表电气功能、实际打印或装配通过。固件与接线状态分别由对应控制文档记录，本决策不修改这些状态。
