miclle/discora/docs/decisions/0025-open-button-wire-retainer.md

# ADR-0025：四键直接焊线与镂空支架

- 日期：2026-11-09
- 依据：用户补充开关引脚面照片，确认按键直接焊导线。
- 状态：implemented（CAD）；实际焊接、支承接触、回弹和打印强度待实测。

## 调整

保持四键位置、独立键帽、前壳定位座和两颗固定螺钉。只改变 `ButtonRetainer`：取消覆盖四键背面的整片底板和四个中央 Ø4 圆柱，改为中间连接梁、三条横梁及八个小支承面，仍为一个可拆打印件。其他 32 个成品对象的几何不变，前壳和外观轮廓不变。

每键由两个 2×3 mm 矩形支承面接触塑料底面，沿键心左右 ±3.8 mm 放置。中央留出 5.6 mm 宽避让区域，避免压住照片中的中央局部凹凸。支承面位于斜面内法向深度 12 mm，支柱延伸到 16.5 mm；连接梁厚 2 mm，深度 16.5…18.5 mm。中间纵梁宽 3 mm，两条按键横梁宽 3 mm，螺钉横梁宽 4.8 mm。支架外包络约 34×23.854 mm，原两孔中心距 28 mm 保留。

开关安装时，两排引脚朝向前斜面的上下方向（各开关局部 ±Z），不横向朝屏幕。每侧连续开放整个 12.4 mm 宽的区域，不依赖未测量的脚距，不增加穿线小孔。

## 焊线与空间

引脚仍暂按本体背面另伸出 3.7 mm，末端为法向深度 15.7 mm。八个引脚侧区域的检查范围为局部 X=−6.2…6.2、Z=±4…±8、深度 12.3…17.7 mm，脚端后额外预留 2 mm。它是设计余量，不是实测焊点、热缩管或导线弯曲半径。

上一曲键靠 DAC 的一侧不能向机身深处任意延长线束：更深的宽区域会进入已有 DAC 输出接头预留。按当前范围检查避开了该接头；导线应向机身中央引出，并在装配时实测线径、绝缘和弯折。未确定线径，不宣称完整线束路径已验收。

先对开关焊线、检查绝缘，再装入前壳定位座并固定支架；两侧开口可让线束直接退出，拆卸不需要将焊好的线穿过封闭孔。支架只承压塑料本体，不以金属引脚或焊点承受按压力。应先打印局部样件检查支承平整、装配松紧及回弹，不以拧紧螺钉补偿尺寸误差。

## 验证边界

`button-checks.json` 检查双支承面、中央避让、八个引脚侧区域、DAC 输出接头预留和键帽 0…0.8 mm 的五个姿态。整机静态交叠、左右对称、拆卸路径、保存后配色、打印网格与图册随模型复核。照片只支持两侧各两脚与底面局部形状的识别，不提供脚距、引脚尺寸或塑料高度差的测量值。实际开关行程、焊点／线束、螺钉配合和支架强度仍需样件验收。
