miclle/discora/docs/decisions/0019-matched-top-shoulders.md

# ADR-0019：顶部前后斜面统一角度和宽度

> 同日后续：[ADR-0021](0021-five-mm-front-panel.md) 将前壳主体加厚至 5 mm、机身深度增至 80 mm；本记录中的旧尺寸与材料转移报告保留为阶段历史，当前尺寸和验证以 ADR-0021 及模型报告为准。

- 日期：2026-11-08
- 状态：CAD 实现；保存实体的尺寸、干涉、左右对称与既有拆装路径检查通过；实物未验收。
- 依据：用户要求前后斜面角度、宽度一致，并选择较陡、允许顶部增高的方案。

> 同日后续：[ADR-0020](0020-rear-roof-shell-ownership.md) 将后斜面和碟口导向并入 P2，并将光驱整件改为前向拆装；本记录的斜面尺寸与外包络保留。

## 决策

保留原前斜面斜率 27/38，即相对水平面 35.394795845°。机身深度 78 mm、提手厚度 5 mm，前后斜面各分配水平宽度 (78−5)/2 = 36.5 mm；高差均为 25.934210526 mm，实际斜宽均为 44.775364606 mm，横向宽均为 142 mm。前后共用参数，内表面按 3 mm 法向壁厚偏移，侧壁上沿和碟口导向随之更新。

保留后端檐口 Z=165 与光驱包络位置，为后斜面下的光驱留空间。前端檐口相应升至 Z=165，肩部 Z=190.934210526，提手顶 Z=215.934210526；整机宽深仍为 142 × 78 mm，总高增加 13.934 mm，不含脚垫高 212.934 mm。

提手移至 Y=36.5…41.5，左右侧孔、声腔接口、安装耳和螺孔同步移至中线 Y=39。前斜面角度保留，按钮、屏幕、旋钮及其安装源件沿 Z 上移 15 mm；斜面内布局和自身几何保留。碟口中心仍为 Y=65.75，水平投影仍为 124 × 3.2 mm，光驱仍为 Y=61…70.5、Z=32…161。

## 检查与边界

[validation.json](../../hardware/enclosure/validation.json) 从保存模型读回两侧斜面，核对角度、水平宽度和实际斜宽一致。26 个成品对象有效，三主体各一个连续实体；成品交叠、退碟、空气通路、接头预留和握持空间检查通过。8 项左右镜像差集为零，4 组原生镜像有效；8 项操控／显示源件相对旧版上移 15 mm 后差集为零。

[assembly-paths.json](../../hardware/enclosure/assembly-paths.json) 重新检查既有拆装顺序：前壳先抬高 40 mm 再前移，采用 0.5 / 1 mm 步长抽样；其余项目采用报告注明的连续保守扫掠。紧固件、绑带和线束按前提拆除，不代表带线整机可直接拆装。

本次不变更供电或固件。100 × 55 mm 洞洞板候选尚未并入 CAD，其安装空间不能据此视为通过。真实线束长度、光盘可抓取范围、提手承载、打印补偿和实际装配仍需实测。
