miclle/discora/docs/decisions/0014-5600mah-battery-pack.md

# ADR-0014：采用 5600mAh 成品电池包，外围处理充电和稳压

- 日期：2026-11-05
- 状态：用户已选定商品；电池接入为 planned，未采购确认或实测验收

> 后续更新（2026-11-07）：[ADR-0018](0018-dual-5v-buck.md) 已选定两块 DCE001 固定 5V 模块，分别供主控与光驱；下文“具体模块尚未选定”保留为本决策当时状态。充电和功放稳压模块仍未定型，5V 接入及带载能力未验收。

## 背景与决策

便携播放目标为日常音量 3–4 小时并兼顾体积。用户认为摄影成品电池价格过高，要求电芯已焊接封装，接受自行接入 Type-C 充电和升降压模块。

选用[淘宝 5600mAh 电池包，SKU 5651022295757](https://item.taobao.com/item.htm?id=733234510026&skuId=5651022295757)，用户报价 ¥59.22。商品图为 6 节 2800mAh 18650、标称 11.1V，推定 3S2P，标称能量约 62.16Wh。相比报价 ¥81.72 的 6800mAh 款，价格低 ¥22.50；选择较低成本方案，续航仍以整机实测为准。电芯及保护板不自行组装。

## 后果与待验证边界

电池原始电压不是稳定 12V，外围另配三串 Type-C 充电管理、12V 升降压和 5V 降压；具体模块尚未选定。边充边播尚无证据。XT30 接头变更、持续放电及均衡保护仍待确认，不因用户选定商品而标记为已到货或 verified。

选型时块状图示为 58 × 41 × 67mm，可选平排为 112 × 70 × 20mm，均大于当时 V4 的 82 × 21 × 22mm 旧占位。后续用户已明确选择平排；模型已按该标称包络重排并同步图册，详见 [ADR-0015](0015-flat-battery-enclosure.md)。该机械适配不改变电气接入为 planned、外围模块尚未定型的状态。完整参数、估算和验收项见[电池资料](../../hardware/Battery-3S2P-5600mAh/README.md)。
