miclle/discora/docs/decisions/0018-dual-5v-buck.md

# ADR-0018：采用两块 DCE001 固定 5V 降压模块

- 日期：2026-11-07
- 状态：用户已选定型号和数量；接入为 `planned`，未确认采购或实测验收

## 背景与决策

[ADR-0014](0014-5600mah-battery-pack.md) 已确定成品三串电池包，主控和光驱均需 5V 支路。用户选定[京东商品 10228520023322](https://item.jd.com/10228520023322.html) 的固定 5V DCE001，决定使用两块：A 供 ESP32-S3 开发板，B 供光驱／桥接器。

两块输入来自同一电池保护输出，各自降压、独立配线；两路输出正极不并联。选择两块便于分别安排主控和电机负载的电源回路，不代表共享电池的干扰已隔离。DAC 最终电池供电归属、功放稳压及充电模块不在此次决定内。

## 后果与待验证边界

所选 SKU 输入为 5.5–30V、输出固定 5V。商品标称 3A，但不加散热要求在 2A 内；光驱启动峰值和封闭机壳温升未测，光驱支路适用性仍需验证，必要时更换足额模块。17.5 × 12 × 4.5mm 为商品尺寸，未完成 CAD 安装布局。

接入前必须核对光驱辅助电源与数据口 VBUS 是否互通、主控 USB-OTG／IN-OUT 焊桥及 COM 供电路径，避免两路输出经 USB 并联或向电脑回灌。USB 电源隔离接法仍待确认，不能把两块模块直接接到现有台架就视为完成。当前台架供电、接线及固件不因本记录改变，已有 USB 失联也未被证明解决。

供应商参数、原图和带载验收要求集中在[模块资料](../../hardware/DCE001-5V/README.md)，整机规划入口见[接线说明](../wiring.md#电池双路-5v-降压规划planned)。
