miclle/discora/docs/records/2026-11-05-dac-no-sound.md

# 2026-11-05：DAC 接入后的无声排查

本文按发生顺序保留早期失败与当时判断，文中“下一步”不是当前操作要求。2026-11-07 后续对照已在更换 DIN 连接后完成约 60 秒清晰立体声 CD；当前结论见[对照记录](2026-11-07-cybertrack-audio-crosscheck.md)。未将历史无声推定为 DAC 损坏。

## 初始条件与当时结论

用户反馈已按整机图连接 PCM5102 DAC、光驱及音乐 CD，最初耳机直插 DAC 的 3.5 mm 口，随后改接功放，并确认功放供电、喇叭连接及低音量已准备好。具体 VIN 接点、电压、焊桥连通性、实际功放型号及独立音源测试结果仍待核对；用户接线反馈不能替代电气测量。

原板上 `0.10.0-oled` 为软件时钟播放器，不输出 I²S，且上电 stopped。切换独立测试音后，左右各约 2 秒的 I²S 运行计数正常，但用户明确反馈“两次都没有声音”。因此声音验收失败，不能将软件提交成功标为 DAC 或功放通过；尚未定位无声的电气原因。

## 光驱与原固件状态

本次只读串口窗口重新确认：ESP-IDF v5.4；MATSHITA DVD-R UJ-898 / HC10；桥接器 VID:PID `13fd:0840`，Full-Speed / BOT；音乐 CD 目录为 13 条音频轨、0 条数据轨，lead-out LBA 252645。介质标题及桥接芯片具体型号未重新确认。

`status` 为 `state=stopped sink=software-clock-no-I2S media=1 track=1 reads=0`。目录读取成功不代表音频播放成功；没有 READ CD，光驱不持续旋转不能单独判作故障。OLED 仍返回探测超时，但播放器状态正常响应。

原始日志在忽略目录 `.local/bench/2026-11-05-dac-no-sound/`。

## 备份与测试音部署

- 核对唯一目标 COM：VID:PID `1a86:55d3`、序列号 `5CF9109063`，ESP32-S3 rev v0.2；打开前未被占用。
- Secure Boot / Flash Encryption 均关闭。备份 `[0x0, 0x110000)`，SHA-256 为 `9660aae6dbfc37ca023a38bffe45aaa516764b9333cce47003aba567565834f9`；原应用与已记录的 0.10.0 clock 镜像逐字节相同，设备分区表与测试音候选一致。
- 使用 [2026-11-04 已构建验证的 tone 镜像](2026-11-04-oled.md)，256032 字节，SHA-256 为 `ba1ccaeeb8ae5bdc9c02de6321284cd9f9a6e77227990ce53ebba6ddcd031be8`；镜像格式与摘要检查通过。本次未修改固件源码，未重新构建。
- 仅在 `0x10000` 写入应用；写入校验及独立 `verify_flash` 通过。未写 bootloader、分区表、NVS 或 eFuse。
- 启动确认独立测试音、GPIO4 BCLK / GPIO5 LRCK / GPIO6 DATA、上电 stopped；USB optical service inactive。该配置不运行光驱、三个按键或 OLED 服务。

备份、候选、写入／校验与启动日志在忽略目录 `.local/bench/2026-11-05-dac-tone/`，不提交二进制产物。

## 有界左右测试

用户明确确认低音量准备好后，依次发送 `left`，约 2 秒后 `stop`，停顿后 `right`，约 2 秒后 `stop`。目标测试音为左 441 Hz、右 882 Hz，峰值 4096（约 −18 dBFS）；频率为软件目标，不是波形测量。

两次均观察到 `state=playing tx=running`，最终 `state=stopped tx=closed handle=0`。累计 `pcm_submitted=730296`、`dma_blocks=406`、`opens=2 closes=2`；`write_errors=0`、`event_overflows=0`、`bad_dma_sizes=0`、`underruns=0`。这些只证明固件与 I²S 驱动的运行窗口，不证明引脚波形、模拟电压或声音。

用户反馈两次均无声。已停止并释放串口，设备暂留测试音固件，上电不会自动出声；未切换到 CD I²S，也未重复运行测试音。

## 下一步

先核对 VIN 的实际接点，测量带电 VIN→GND、A3V3→AGND、XSMT→GND；尤其不能默认 COM USB 供电时开发板 5Vin 排针可向外供电。再根据测量结果核对供电与静音焊桥，并用独立音源验证功放／喇叭。断电后检查连通性，不在未确认供电状态时盲目改焊桥。通过独立左右测试音后，再恢复 CD I²S 播放验证。

## 用户补充：VIN 接在开发板 5Vin

用户随后确认 DAC VIN 实际接在 ESP32 的 5Vin，且功放和喇叭已用其他音源验证能出声。重新查看供应商 V1.4 原理图确认 D3 的方向：5Vin 可向板内 5V 输入；IN-OUT 断开时，板内 5V 无法通过 D3 反向给该排针供电。因此若实物符合此版本、仅 COM USB 供电且 IN-OUT 断开，当前接法不能为 DAC 正常供电。实物焊桥状态与电压仍未测，尚不能把缺电标为已确认根因。

建议断电后移除 DAC VIN 到 ESP32 5Vin 的连线，改由已确认适合该模块的稳定 5V 支路供给 VIN，电源负端与 DAC GND、ESP32 GND 共地；不将新电源正端同时并到开发板 5Vin。不改接 3V3，不盲目短接 IN-OUT。等待实际改线及电压结果后再做有界测试音；本次未再次操作串口。

## 独立 5V 改线后的复测

用户确认 DAC 已改接独立 5V 电源并与 ESP32 共地，明确要求再次播放测试音；尚未提供电压测量值。核对同一串口身份及未占用后，在现有测试音固件上再次执行左 441 Hz、右 882 Hz 各约 2 秒，中间停止，结束后停止并释放串口，未重新烧录。

本轮累计 `pcm_submitted=732060`、`dma_blocks=407`、`opens=2 closes=2`；写入错误、事件溢出、异常 DMA 长度及软件欠载均为 0。最终 `state=stopped tx=closed handle=0`，无 panic 或 brownout 日志。用户随后明确反馈“都没有声音”，改接独立 5V 后仍未通过声音验收；电源轨电压和解除静音状态仍待测，不能仅凭改线认定供电已正常。

日志与命令时间保存在 `.local/bench/2026-11-05-dac-tone/external-5v-1793885512094252000/`。

用户再次要求复测后，重复左右各约 2 秒并停止，未改固件或接线。该轮 `pcm_submitted=732060`、`dma_blocks=407`、`opens=2 closes=2`，写入错误、事件溢出、异常 DMA 长度及软件欠载均为 0，最终 stopped／closed，串口已释放；用户随后反馈“还是没有声音”，并询问电压和静音焊桥检查方法。证据在 `.local/bench/2026-11-05-dac-tone/repeat-1793885595104722000/`，保留此前两轮无声反馈。下一步为用户测量 VIN、A3V3、XSMT 并断电检查 H3 连通性，尚无测量结果。

## 用户电压测量反馈与串口暂时不可用

用户报告 VIN→GND 为 5V、A3V3→AGND 为 3.3V，而 XSMT→GND 没有电压。后续在检查 H3 的指导后，用户报告 XSMT→GND 已为 3.3V；具体改焊动作、H 端测量值及连通性未提供。上述均为用户测量反馈，支持 XSMT 已达到解除静音的电平条件，不等于声音已验收。

准备再次执行有界左右测试时，串口身份检查未找到目标 `1a86:55d3 / 5CF9109063`；系统仅列出三个非目标端口。脚本在打开端口或发送命令前退出，因此本次没有播放测试音、没有重新烧录。需将 ESP32 的 COM 口接回电脑后继续验证。

用户接回 COM USB 后，重新核对唯一目标身份且端口未占用，确认测试音固件 stopped，再执行左 441 Hz、右 882 Hz 各约 2 秒并停止。最终 `pcm_submitted=732060`、`dma_blocks=407`、`opens=2 closes=2`，写入错误、事件溢出、异常 DMA 长度及软件欠载均为 0；最终 stopped／closed，串口已释放。没有重新烧录；这是用户报告 XSMT=3.3V 后首次实际执行的左右测试，用户再次反馈没有听到声音。证据在 `.local/bench/2026-11-05-dac-tone/xsmt-high-1793887848994448000/`。

复查生产适配器使用 Philips I²S、44.1 kHz、16-bit stereo；TI PCM510xA SLAS859C 表 11 支持 44.1 kHz / BCK 1.4112 MHz 的三线 PLL 组合，要求 SCK 保持接地。配置层面未发现该组合不兼容的证据，但尚未测量真实引脚波形，驱动计数不能证明信号到达 DAC。下一步先测 FMT 对 GND（目标低电平），断电检查 SCK→GND 连通性，再核对实物接线和焊点；本次不重复播放或更换固件。

## BCK 误接 RST，修正后的复测

用户随后确认 SCK 与 GND 在通断档持续蜂鸣，FMT→GND 为 0V。逐项检查 GPIO4→BCK、GPIO5→LRCK、GPIO6→DIN、ESP32 GND→DAC GND 时，用户发现 BCK 原先误接到 RST，已改接并确认四条连接均导通。这是用户提供的接线故障与修正证据；未获得实物照片或引脚波形。

用户要求再次播放后，核对唯一 Discora 串口身份及未占用状态，在既有测试音固件上执行左 441 Hz、右 882 Hz 各约 2 秒，中间停止，最后停止并释放串口。最终 `pcm_submitted=732060`、`dma_blocks=407`、`opens=2 closes=2`；写入错误、事件溢出、异常 DMA 长度及软件欠载均为 0，最终 stopped／closed。未重新烧录，用户随后再次反馈没有听到声音。BCK 接线修正尚未解决无声，下一步需核对实物照片及 DAC 端的实际时钟信号，先确认用户仪表能力后安排有界测量窗口。

日志和命令时间在 `.local/bench/2026-11-05-dac-tone/bck-corrected-1793888720274389000/`。BCK 误接会使 DAC 缺少预期位时钟，能够解释无声，但此时仍不把修正接线或软件计数标为声音验收通过。

## 时钟脚直流电压辅助测量窗口

用户提供的仪表照片为 VICTOR VC890D，面板未见 Hz 档；DAC 背面实物照片中 H1/H2/H4 接 L、H3 接 H 的方向看起来符合目标，但照片不能证明焊接连通性。用户已完成四条 ESP32↔DAC 连接的通断验证，不重复要求相同检查。直流电压档只能辅助观察时钟脚平均电压，不能证明频率、占空比或波形有效。

用户确认准备好后，核对同一 Discora COM 身份及空闲状态，启动双声道测试音约 30 秒供测量 DAC BCK／LRCK 对 GND 的直流电压，自动停止后释放串口。最终 `pcm_submitted=5302584`、`dma_blocks=3002`、`opens=1 closes=1`，写入错误、事件溢出、异常 DMA 长度及软件欠载均为 0，最终 stopped／closed。电压读数及听音结果待用户反馈；未重新烧录。日志与命令时间在 `.local/bench/2026-11-05-dac-tone/clock-voltage-1793889138769719000/`。

用户随后报告 LRCK=3.3V、BCK=0V，但尚未确认读数是在播放窗口内还是停止后取得；该组合也可能是关闭通道后的静态电平，不能直接判断运行时无时钟。用户要求一次只测一个点，避免来回换表笔；后续按单测点窗口执行，不重复已完成的接线通断检查。

单独 BCK 窗口：双声道测试音运行约 60 秒，启动提示后用户报告 DAC BCK→GND 为 **1.64V**（VC890D 直流 20V 档）。这是播放期间的平均电压反馈，与 3.3V 时钟的约半电源平均值相符，但不是频率或波形验证，不据此认定 DAC 已正确锁定。窗口自动停止、串口已释放；最终 `pcm_submitted=10591056`、`dma_blocks=6000`、`opens=1 closes=1`，写入错误、事件溢出、异常 DMA 长度及软件欠载均为 0。证据在 `.local/bench/2026-11-05-dac-tone/bck-only-1793889321623623000/`。下一轮仅测 LRCK，等待用户准备。

单独 LRCK 窗口：用户准备好后，双声道测试音运行约 60 秒；启动提示后用户报告 DAC LRCK→GND 同样为 **1.64V**。窗口自动停止、串口已释放；最终 `pcm_submitted=10594584`、`dma_blocks=6002`、`opens=1 closes=1`，写入错误、事件溢出、异常 DMA 长度及软件欠载均为 0。证据在 `.local/bench/2026-11-05-dac-tone/lrck-only-1793889430794977000/`。两个时钟脚的直流平均电压与时钟活动相符，但仍无频率、边沿或 DAC 锁定证据；下一步准备在固定 DIN 测点比较测试音数据与数字静音。

DIN 固定测点对照：用户准备后，在同一串口连接中先输出双声道测试音，收到 **DIN→GND=1.52V** 的反馈后切换数字静音（时钟保持运行），用户报告 **0V**。收到第二段读数后主动停止，各段有 60 秒上限；实际测试音命令到静音命令约 28.5 秒，静音到停止约 35.4 秒。最终 `pcm_submitted=11287836`、`dma_blocks=6391`、`opens=2 closes=2`，写入错误、事件溢出、异常 DMA 长度及软件欠载均为 0，最终 stopped／closed，串口已释放。证据在 `.local/bench/2026-11-05-dac-tone/din-compare-1793889551950181000/`。

上述对照支持 DIN 测点电平随 PCM 内容变化，不能证明数据位序、时序或 DAC 解码正确。下一步计划断开功放音频线，在固定 LROUT→AGND 测点用交流电压档比较测试音与静音，区分 DAC 板上模拟输出与外接音频链路；仪表交流带宽、精度未验证，不凭单个读数判定 DAC 损坏。

## 左声道模拟输出交流电压对照

用户在关闭功放、拔掉 DAC 3.5 mm 音频线、VC890D 切换交流 2V 档并固定 LROUT→AGND 测点的步骤后确认准备好。首次窗口用户未及时读表，按其要求结束并重开；首轮日志保留在 `.local/bench/2026-11-05-dac-tone/left-analog-1793891732285620000/`，不作为电压测量证据。

重开后左 441 Hz 测试音阶段，用户报告 **0V**；收到反馈后在同一连接切到数字静音，用户仍报告 **0V**。随后停止并释放串口；最终 `pcm_submitted=11681208`、`dma_blocks=6614`、`opens=2 closes=2`，写入错误、事件溢出、异常 DMA 长度及软件欠载均为 0，最终 stopped／closed。测试音到静音命令约 35.3 秒，静音到停止约 30.9 秒，各段上限 60 秒。证据在 `.local/bench/2026-11-05-dac-tone/left-analog-retry-1793891816130765000/`。

在用户确认的测量接法下，未观察到脱离外接音频负载的左输出交流电压随测试音变化。该结果支持继续检查 DAC 板供电／转换链路，但仪表带宽与精度未核验、I²S 频率和时序未测，不能单独断言模块损坏或数字链路完全正常。下一步需要 DAC 正面元件照片来识别可安全接触的板级测点，不要求直接探测密集芯片引脚；暂不重复相同测试音。

## 芯片附近去耦电容测量

用户提供正面元件照片后，在图上标出 LCK 字样右侧、220 排阻正下方第一颗横放电容；黑表笔接左端、红表笔接右端，直流 20V 档、未播放测试音。用户报告 **+1.87V**。该读数与 PCM5102A 内部约 1.8V 逻辑电源相符，但该电容至 LDOO 的实际网络尚未经连通性确认，不能仅据照片及电压把所有数字供电或芯片状态判为正常。测量为用户反馈，本次未打开串口。

## 2026-11-06：右侧候选电容检查

另在照片上标出芯片右侧、音频插座中间大焊脚左边的横放电容（其下方还有一颗电容，再下方为 102 电阻），仅作为待确认网络的候选测点。断电通断检查时，用户报告右端对 GND 不蜂鸣、共用档显示 `.472`；该显示不当作 0.472Ω，也不认定右端直接接地。用户报告左端对 GND 持续蜂鸣。上述仅确认接地端反馈，尚未通过至芯片 VNEG 的连通性核定该电容网络。

用户切回直流电压档、上电后报告右端对 GND 为 **0.46V**；此时测试音尚未启动，作为未播放时的基线记录，不据此判断负压电源故障。随后安排同一测点的有界播放窗口，等待运行中读数。

同一测点双声道测试音窗口运行约 60 秒，达到上限后自动停止，串口释放；最终 `pcm_submitted=10591056`、`dma_blocks=6000`、`opens=1 closes=1`，写入错误、事件溢出、异常 DMA 长度及软件欠载均为 0，最终 stopped／closed。用户在运行中读数问题下回复“0.46V，没有变化”，记录为用户报告的运行中结果，与此前未播放基线相同；不是由工具直接采集的电压。证据在 `.local/bench/2026-11-06-dac-voltage/capacitor-right-1793894608695196000/`。

候选点没有观察到负压，但该点尚未确认为 VNEG，不能据此认定电荷泵损坏。现有万用表的平均电压读数也无法验收 I²S 频率及位时序；下一步优先确认是否具备逻辑分析仪／示波器或已知正常的 DAC 对照条件，避免继续依据照片猜测未确认网络。

## 2026-11-06：64fs 软件对照准备

用户指出 DAC 为新购，继续排查不应默认模块损坏，并授权继续推进软件复核与可回退对照。现有电容测点未核定网络，不能据 0.46V 归因于 VNEG 故障。用户已确认重新接好已验证能出声的功放、调低音量并移开表笔；本轮计划单纯听音，不重复既有四条接线通断或更换万用表测点。

复核 ESP-IDF v5.4 的 `i2s_std.c`、`i2s_hal.c` 与 Philips slot 默认值，现有 PCM16LE stereo、MSB-first、1-bit shift 配置未发现明确错误；DMA 按 data bit width 分配，时钟按 slot width 计算。TI PCM5102A 数据手册表 11 同时支持 44.1 kHz 下的 32fs 和 64fs，因此后者仅作为对照，不能事先声明为修复。

新增默认关闭、仅独立测试音可用的 `CONFIG_DISCORA_DIAG_I2S_64FS`，将 slot 和 WS 宽度一起设为 32，目标 BCLK 2.8224 MHz；保留采样率、16 位 PCM、测试音、幅度、GPIO 和 DMA 大小。默认及 CD 路径仍为 16-bit slot。主机 ASan/UBSan 检查通过：原十一组保留，I²S 适配器分别执行默认、64fs 及非诊断保护三种配置，共十三次测试可执行文件运行；此结果仅为离线证据。

此前临时目录中的 ESP-IDF 已被清理，重新取得官方 tag v5.4（`67c1de1eebe095d554d281952fde63c16ee2dca0`），避免用现有 v5.5.1 改变实验条件。新构建、备份与设备日志存放 `.local/bench/2026-11-06-dac-64fs/`。

核对唯一目标 UART `1a86:55d3 / 5CF9109063` 且未占用，Secure Boot / Flash Encryption 均关闭。已备份 `[0x0, 0x110000)`，SHA-256 `ec0631415dd3290b91291407ab278e72103eb81b19e6e1a7e4a03786060883be`；原应用与已知 32fs 测试音镜像逐字节一致。此阶段未写入新应用，设备停留 bootloader，待构建完成后应用级写入与校验。

### 构建与部署

两种独立测试音配置均完成 `idf.py set-target esp32s3` 与 `idf.py build`，使用官方 v5.4、Xtensa GCC 14.2.0 和隔离的 sdkconfig／build 目录；源码版本标识保持 0.10.0-oled。生成配置逐行比较，仅 `CONFIG_DISCORA_DIAG_I2S_64FS` 不同。两镜像均 256064 字节：32fs SHA-256 `8e4d65cb4ea20d7c0c93cea3c184434d33d55506a1ddd6e61b25bfa146622f33`；64fs SHA-256 `5e82dfaf7b88d6ae3f8b10a639da8cf0828d12d61c7fc4a647dc7600c9496827`。新功能未提交或推送，未运行远端 CI。

核对设备分区表与构建一致、镜像 checksum／validation hash 有效后，仅在 0x10000 写入 64fs 应用，独立 `verify_flash` 通过；未写 bootloader、分区表、NVS 或 eFuse。启动日志确认 ESP-IDF v5.4、GPIO4/5/6、`slot_bits=32 nominal BCLK=2822400Hz`，初始 stopped／closed、计数为零。该数值是软件配置目标，尚无引脚频率测量证据。原应用备份与新 32fs 构建均保留，便于回退；设备暂为 64fs 独立诊断，不运行光驱、按键或 OLED。

### 64fs 听音结果

用户确认功放接好后，执行左右各约 10 秒的有界测试，中间停止，结束后停止并释放串口。最终 `pcm_submitted=3707928`、`dma_blocks=2094`、`opens=2 closes=2`，写入错误、事件溢出、异常 DMA 大小及软件欠载均为 0，最终 stopped／closed。证据在 `.local/bench/2026-11-06-dac-64fs/listen-1793895637689814000/`。用户明确反馈“两次都没有声音”，64fs 配置未改善听音结果；不能据此排除时序／电气问题或认定模块损坏。

用户确认手边没有示波器、逻辑分析仪或另一块 I²S DAC。后续不重复上述时隙宽度对照，也不要求重复已验证的四条连线通断。完整断电后的启动状态尚未形成受控记录，可在回退后单独验证；该操作不能替代引脚波形测量。

### 回退完成

64fs 对照失败后，已把应用恢复为实验前原始 32fs 镜像（SHA-256 `ba1ccaeeb8ae5bdc9c02de6321284cd9f9a6e77227990ce53ebba6ddcd031be8`），仅写 0x10000，并完成独立校验。启动确认名义 BCLK 1.4112 MHz、stopped／closed、计数零；串口已释放。写入／校验／启动日志分别为同目录 `restore-write.log`、`restore-verify.log`、`restore-boot.log`。64fs 选项保留在源码中供复现，未成为默认配置。

下一步已请用户关闭功放与 DAC 独立电源、拔掉 ESP32 所有 USB，完整断电 10 秒，再先供 DAC 5V、后接 COM，暂不接光驱 USB，最后低音量开启功放；等待实际操作确认后再启动有界测试音。串口复位本身不会切断 DAC 的独立 5V，因此不算已执行这项冷启动对照。

### 完整断电重启后的听音窗口

用户明确确认已按上述顺序完成完整断电及重新上电，并准备听音。重新核对唯一目标 UART 身份与未占用状态，启动日志确认原版名义 BCLK 1.4112 MHz、stopped，再执行左、右各约 10 秒测试并停止；打开 COM 时 MCU 会复位，因此本窗口不等同于捕获 MCU 最初上电瞬间，DAC 断电操作为用户反馈。

最终 `pcm_submitted=3709692`、`dma_blocks=2095`、`opens=2 closes=2`；写入错误、事件溢出、异常 DMA 大小及软件欠载均为 0，最终 stopped／closed，串口已释放。未再次烧录；证据在 `.local/bench/2026-11-06-dac-64fs/cold-start-1793896039424155000/`。听音结果待用户反馈，不能由软件计数推定有声。

用户随后反馈完整断电重启后的左右测试“两次都没有声音”，本次冷启动操作未改善听音结果。下一步仅检查模块板内 BCK 排针至 PCM5102A 第 13 脚的直流通路，不重复 ESP32 至模块排针的既有四条通断。TI 数据手册第 5 页确认 BCK=13；按用户原照片方向与右下角 pin-1 标记定位，13 脚位于大芯片左侧从上往下第 3 根。拟在整机断电后使用 200Ω 档读取具体阻值，串联电阻可能使结果非零；尚无测量结果。生成的照片标注箭头偏移，已明确告知用户不能按其圆圈落笔，改用原图方向与文字简图；该生成图不作为硬件证据。

### BCK 板内通路测量反馈

用户报告 200Ω 档读数为 **22.1Ω**，并明确纠正生成图箭头看起来指向左侧第 6 根，实际按文字测量的是大芯片左侧从上往下第 3 根（PCM5102A pin 13，BCK）。该反馈与 22Ω 串联通路相符，支持 BCK 排针至芯片接通；不证明时钟频率、边沿或接收正确。生成标注图继续作废，不用于后续定位。

下一单点拟测模块 LCK／LRCK 排针至大芯片左侧从上往下第 5 根（pin 15，LRCK），保持整机断电和 200Ω 档；尚无此项读数。不重复外部线束通断，不启动播放。

### LRCK、DIN 板内通路反馈

用户按完全断电、200Ω 档的步骤，报告 LCK／LRCK 排针至大芯片左侧从上往下第 5 根（pin 15）为 **22.4Ω**；随后报告 DIN 排针至左侧第 4 根（pin 14）同样为 **22.4Ω**。结合 BCK 的 22.1Ω，三条板内输入通路均有与 22Ω 串联电阻相符的用户测量反馈，但不构成波形或 DAC 接收验收。

下一单点拟测 GND 至大芯片左侧从上往下第 2 根（pin 12，SCK），保持完全断电与 200Ω 档，以确认芯片端 SCK 的接地通路；此前只确认过 SCK 排针与 GND 导通。尚无该项读数。

### SCK、FMT、XSMT 芯片端通路反馈

用户在完全断电、200Ω 档下依次反馈：GND 至芯片左侧第 2 根（pin 12，SCK）为 **23Ω**；GND 至左侧第 6 根（pin 16，FMT）为 **00.2Ω，即 0.2Ω**；XSMT 通孔至左侧第 7 根（pin 17）为 **00.2Ω，即 0.2Ω**。SCK 与约 22Ω 串联接地路径相符，FMT 低阻接地，XSMT 通孔至芯片接通；这些是用户报告的静态通路证据，不能替代运行中的数字电平、波形或 DAC 解码验收。

下一单点为芯片 pin 1（按原照片方向，大芯片右侧最下面一根、圆点标记旁）CPVDD 对 GND 的直流电压。TI PCM5102A 数据手册第 5–6 页将其定义为电荷泵供电，推荐 3.1–3.3–3.46V。计划切换直流 20V 档后仅给 DAC 接通独立 5V，不启动测试音；尚无该测点读数。此前 A3V3=3.3V 不作为已在 CPVDD 引脚实测的替代证据。

### CPVDD 引脚电压与 VNEG 测量准备

用户在直流 20V 档、仅 DAC 独立 5V 供电时报告芯片右侧最下方 pin 1（CPVDD）对 GND 为 **3.28V**，在 TI 推荐的 3.1–3.46V 范围内。该项为芯片引脚位置的用户测量反馈，与此前未核定电容网络的读数区分记录。

随后用户确认已把红表笔移至芯片右侧从下往上第 5 根（pin 5，VNEG）、黑表笔保持 GND、直流 20V 档，接回 COM USB，准备进行时钟运行窗口测量。核对唯一目标 UART、空闲状态及原版 32fs 测试音启动日志后，已启动有界约 60 秒 stereo 窗口；本次未重新烧录。VNEG 的运行中读数待用户反馈，证据目录 `.local/bench/2026-11-06-dac-64fs/vneg-pin5-1793897483790911000/`。

VNEG 窗口达到预设上限后已自动停止，串口释放；最终 `pcm_submitted=10511676`、`dma_blocks=5955`、`opens=1 closes=1`，写入错误、事件溢出、异常 DMA 大小及软件欠载均为 0，最终 stopped／closed。运行中电压读数尚未收到；停止后的读数不能冒充该窗口的运行中测量。

### VNEG 读数存在测量不确定性

用户在运行窗口读数问题下回复“数字会变，有 0、-0.01 ~ 0.05”，随后明确补充“不确定测量有没有问题”。因此将该反馈记为 **VNEG 测量待确认**：不能把近零读数当作已确认的 VNEG 电压，更不能据此判定电荷泵或 DAC 损坏。设备已停止，串口释放。

下一步先核实实际落笔位置：请用户完全断电后，以表笔指示刚才接触的那根脚拍清晰近照，画面保留整颗芯片、右下角圆点与右侧一排引脚；不重复带电探测，不使用此前偏移的生成标注图。尚未取得此照片。

### 用户更换 DAC 后复测

用户主动报告已更换另一块 DAC，并明确要求重新测试。此前旧模块的供电、跳桥及板内通路测量不自动沿用为新模块的实测证据；本次未取得新模块型号／照片及单独电压记录。

核对唯一目标 COM 身份与空闲状态，确认当前原版 32fs 测试音固件的名义 BCLK 1.4112 MHz 和 stopped 状态后，执行左、右各约 10 秒有界测试，中间停止，结束后停止并释放串口。未更改或重新烧录固件。最终 `pcm_submitted=3722040`、`dma_blocks=2102`、`opens=2 closes=2`，写入错误、事件溢出、异常 DMA 大小及软件欠载均为 0，最终 stopped／closed。证据在 `.local/bench/2026-11-06-dac-64fs/replacement-dac-1793898234558735000/`。实际听音结果待用户反馈，不能以软件计数判定新 DAC 有声或旧 DAC 损坏。

用户随后明确反馈更换 DAC 后“两次都没有声音”。更换模块未改善本轮听音，但新模块的静音／格式跳桥及供电未独立核定，不能把此次对照解释为已排除 DAC 设置或确认 ESP32 故障，也不能据此判定任一模块损坏。

下一步仅核对新模块 XSMT 通孔对 GND 的直流电压：DAC 供电、万用表直流 20V 档，无需播放、不探测芯片细脚。旧模块 XSMT=3.3V 的反馈不沿用到新模块。新板读数待反馈。

### 新 DAC 补焊 H3 后复测

用户澄清新 DAC 首轮测试前尚未焊 H 端，因此首轮更换后无声不能用于排除模块静音设置。随后用户确认“已焊好，重新测试”；尚未提供新板 XSMT 电压、具体焊桥照片或其它焊桥的独立核定证据，不能把焊好直接写成电平验收通过。

按用户要求，核对唯一目标 COM 身份与空闲状态、原版 32fs 测试音固件的名义 BCLK 1.4112 MHz 及 stopped 状态后，再执行左右各约 10 秒，间隔停止，最终停止并释放串口。没有重新烧录。最终 `pcm_submitted=3720276`、`dma_blocks=2101`、`opens=2 closes=2`；写入错误、事件溢出、异常 DMA 大小及软件欠载均为 0，最终 stopped／closed。证据在 `.local/bench/2026-11-06-dac-64fs/replacement-dac-h3-1793898835060683000/`。听音结果待用户反馈。

用户反馈新 DAC 补焊 H3 后的左右测试仍“两次都没有声音”。新板 XSMT 的实际电压仍未提供，不能把补焊操作当作已验证解除静音。下一步仅请求新板 XSMT 通孔对 GND 的直流电压（直流 20V 档、DAC 供电、无需播放），不重复芯片细脚测量。设备保持原版测试音 stopped，串口释放。

### 新 DAC 控制电平反馈

用户在新板供电、直流 20V 档下报告 XSMT 通孔对 GND 为“3，28”（记录为 **3.28V**），随后报告 FMT 通孔对 GND 为 **0V**。这两项分别符合解除静音高电平和 Philips I²S 格式低电平要求；均为新模块通孔位置的用户测量，不自动沿用旧模块芯片端通路证据。

下一单点检查新板 SCK 排针到 GND 的断电电阻，使用 200Ω 档。旧模块 SCK 接地测量不替代新模块实测。当前设备仍停止、串口释放，未重复播放或烧录。

### 新 DAC SCK 接地与时钟计数诊断准备

用户报告新板 SCK 排针对 GND 在完全断电、200Ω 档下为“00.9”，记录为 **0.9Ω**，支持新板 SCK 接地。新板 XSMT=3.28V、FMT=0V、SCK 接地三项已获得用户测量反馈。用户同时确认已接回 COM、DAC 独立 5V 供电、功放关闭、表笔移开。

为取得 MCU 端实际时钟活动证据，新增默认关闭、仅独立诊断可用的 PCNT `clocks` 命令。复核官方 ESP-IDF v5.4 驱动：PCNT 配置追加 GPIO 输入及矩阵输入路由，不覆盖既有 I²S 输出；显式关闭驱动添加的上拉，每次采集重新使能 pad 输入，处理 I²S 重开可能清除输入使能的情况。以两组 ±30000 限值事件累加硬件计数，在不少于一秒的实际耗时内计数上升沿；异步轮询不会阻塞音频供数。此项不验收 DAC 端波形、DIN 格式或模拟输出。

主机 ASan/UBSan 检查通过，共十六次可执行文件运行，包括探针门控、取消、输入重启用、资源复用、读取失败，以及部分初始化／启动失败后禁止重复分配。探针配置和关闭探针的基线配置均完成 `idf.py set-target esp32s3` 与 `idf.py build`（ESP-IDF v5.4 / Xtensa 14.2.0）。首次构建因条件化 CMake 依赖导致 PCNT 头文件缺失而失败，改为声明原生组件静态依赖后构建通过；未掩盖失败日志。

再次核对唯一目标 UART 和未占用状态、Secure Boot／Flash Encryption 关闭，备份 `[0x0,0x110000)` 的 SHA-256 仍为 `ec0631415dd3290b91291407ab278e72103eb81b19e6e1a7e4a03786060883be`，原应用逐字节匹配此前原始测试音镜像。构建、备份和后续采集日志位于 `.local/bench/2026-11-06-clock-probe/`；没有提交或推送。

### MCU 时钟计数部署与实测

探针应用大小 264288 字节，SHA-256 `ae50f86a3115370318f525107ebf1196a8bf0c7a04dedf9b2d49225a7a0d009b`。核对分区表、镜像 checksum／validation hash 后，仅在 0x10000 写入应用，独立 `verify_flash` 通过；未写 bootloader、分区表、NVS 或 eFuse。启动确认 ESP-IDF v5.4、`slot_bits=16 nominal BCLK=1411200Hz`、`clock_probe enabled`、初始 stopped／closed、GPIO4/5/6。当前设备暂留此 0.10.0-oled 探针配置，不运行 USB 光驱、按键或 OLED；原始无探针镜像与备份保留。

在用户确认功放关闭、DAC 供电条件下，完成首次停止状态、三次 stereo、一段数字静音、输出停止后和重开 stereo 的计数采集。记录在 `.local/bench/2026-11-06-clock-probe/capture-1793899832821522000/`，原始脉冲数、实际耗时与换算值见 `captures.json`：

| 窗口 | GPIO4 BCK 估计 Hz | GPIO5 LRCK 估计 Hz |
| --- | ---: | ---: |
| stopped-before | 3456.372 | 4012.153 |
| stereo-1 | 1411179.002 | 44099.693 |
| stereo-2 | 1411196.909 | 44100.393 |
| stereo-3 | 1411196.733 | 44100.480 |
| silence | 1411178.585 | 44099.402 |
| stopped-after | 0.000 | 0.000 |
| stereo-reopened | 1411178.761 | 44099.314 |

运行时 BCK 约 1.41118–1.41120 MHz、LRCK 约 44.0993–44.1005 kHz，与目标 32fs / 44.1 kHz 相符；切数字静音后时钟保留，停止后计数归零，重开恢复。首次 I²S 尚未初始化的 stopped-before 出现数千次输入边沿，应视为当时未驱动输入路径的杂散活动，不能解释为有效音频时钟，不隐去该结果。该计数受共同 MCU 时基和 API 开销影响，不作为独立频率精度、占空比、边沿质量、DAC 端时序或 DIN 解码验收。

最终 `pcm_submitted=1811628`、`dma_blocks=1015`、`opens=3 closes=3`，写入错误、事件溢出、异常 DMA 大小及软件欠载均为 0，最终 stopped／closed，串口释放。此次功放关闭，不进行听音验收。下一步只补测新模块 A3V3 对 AGND，旧模块曾有 3.3V 反馈但不沿用至新模块；尚无新板该项读数。

### 新 DAC 左声道输出测量

用户报告新板 A3V3 对 AGND 为 3.28V。按功放关闭、拔掉 DAC 音频线、交流 2V 档固定 LROUT 对 AGND 的步骤，用户确认准备好。现有固件已响应 `left` 和 `status`，确认 `state=playing tone=left-441Hz tx=running`。本次串口记录目录为 `.local/bench/2026-11-06-clock-probe/new-dac-lrout-1793926542178492000/`。

左声道窗口自动停止并释放串口。用户报告播放期间新板 LROUT 对 AGND 的交流电压为 **0.13～0.15V**。功放断开时该测点首次有明确非零读数。随后另开有界数字静音窗口，在同一测点、同一量程请求对照读数。串口报告 `state=playing tone=silence tx=running`，日志目录为 `.local/bench/2026-11-06-clock-probe/new-dac-lrout-silence-1793926635164065000/`。

用户在数字静音运行中报告同一测点为 **0.07～0.08V 交流**。收到读数后停止，串口已释放。测试音期间读数较高，静音仍有残余读数，仪表带宽和测量背景待区分。下一步沿实际音频线检查功放端插头的左声道信号。

### 新 DAC 音频线末端左声道

用户按交流 2V 档，在功放端拔出的插头上固定测量尖端对套筒。左 441 Hz 与数字静音两次均报 0.09V。串口确认两段分别以 left-441Hz 和 silence 运行，各段结束后 stopped／closed，写入错误与软件欠载为零。日志分别在 `.local/bench/2026-11-06-clock-probe/cable-tip-left-1793926879398174000/` 与同目录下 `cable-tip-silence-1793926929472738000/`。板上 LROUT 曾报 0.13～0.15V（测试音）及 0.07～0.08V（静音）。插头端读数相同，线缆与插座仍待单独核对。下一项为完全断电后测量模块 AGND 到线末端套筒的电阻。

### 整机 CD 第 1 轨试听尝试

用户要求接通整机直接测试播放。先前测得 AGND 至线末套筒 2.4Ω、LROUT 至尖端约 1Ω，单独线缆尖端对套筒在 2kΩ 档超量程。按用户要求转入实际音乐 CD。已备份探针应用并核对原镜像，采用 11 月 4 日已构建的 0.10.0-oled CD I²S 镜像，SHA-256 为 `d694a943489b7e969cc3c9b75f429341eafe67cae4d6224ce35d67ca176d7f4d`。仅写入 0x10000，独立校验通过。

播放器以 I²S 输出模式启动。约 90 秒观察期间 13fd:0840 重新枚举 28 次，每轮识别 MATSHITA UJ-898 HC10，TEST UNIT READY 均返回失败，28 次 sense 均为 06/29/00（上电或复位类提示）。播放器始终 media=0、track=0、reads=0、delivered=0，未取得目录，因此未发送 play，实际音乐试听待完成。串口已释放，当前设备保留 CD I²S 应用，启动状态 stopped。原始记录位于 `.local/bench/2026-11-06-cd-listen-1793927398432657000/play.log`。

用户要求重试后，沿用板上 CD I²S 播放器。此次取得目录，play 被接受。第 1 轨连续运行约 31 秒，最终累计完成 303 次读取，向 I²S 提交 5561892 字节，write_errors、underruns 均为 0。最后 stop 成功，通道关闭，串口释放，用户反馈整段未听到声音。日志在 `.local/bench/2026-11-06-cd-retry-aTlqfB/play.log`。

### ESP32-S3 测试音音量与引脚样本回读

独立测试音应用以 44.1 kHz、Philips I²S、双声道 16 位、32fs 运行。光驱服务未启动。使用原 441 Hz 左声道测试音表和生产 I²S 发送函数。前约 4.5 秒保持峰值 4096（−18.1 dBFS），后约 4.5 秒在入队前将样本乘以 4（峰值 16384，−6.0 dBFS），右声道目标为零。功放端听感由用户反馈，两段均无声。

临时诊断应用用 ESP32-S3 的另一个 I²S 外设作为从机，经 GPIO 输入矩阵回读 GPIO4/5/6 的 BCK、LRCK 和 DATA。两段各采集 256 个立体声帧。两次的首帧都有一个样本落在右槽，接收器均在发送过程中启用。每段随后连续 255 帧逐样本匹配正弦表和右声道零值。实测左声道峰值分别为 ±4096、±16384。发送完成 900 个 DMA 块，写入错误和软件欠载均为零。上述数据验证了 MCU 引脚侧两次采样窗口中的声道排列、样本值与振幅，DAC 引脚处的信号和模拟输出仍待定位。

测试应用自动停止。恢复测试前的 CD 播放器后，已按原镜像独立校验应用分区。临时构建、串口采样、比较脚本和恢复校验记录在 `.local/bench/2026-11-06-tone-audit/`。

### ESP32-S3 测试音从启动起连续回读

在发送使能前启动第二个 I²S 外设，采样 GPIO4、GPIO5、GPIO6 的输入路径。左 441 Hz、右 882 Hz、双声道和数字静音四种模式分别运行约 4 秒。每种模式从相位 0 开始回读 399 个完整块，每块 441 个立体声帧。共 703836 帧，1596 个块的 CRC32 均与相同位置的期望样本匹配，四段首帧及其后的启动序列符合预期。各模式平均块间隔为 9999.96～9999.97 µs，以 MCU 定时器记录。完整块覆盖每段约 3.99 秒，停止前不足一块的尾部未计入比较。采样证据止于 MCU 引脚，未测 DAC 端边沿和模拟输出。

发送结束后四次通道均已关闭，写入错误和 DMA 事件溢出均为零。已恢复并独立校验测试前的 CD 播放器应用。固件副本、串口原始日志、按块比对和恢复校验位于 `.local/bench/2026-11-06-tone-continuity/`。

### 更换 ESP32-S3 后复测独立测试音

新板的 USB 串口序列号与旧板不同。芯片识别为 ESP32-S3 rev v0.2，16 MB flash、8 MB PSRAM。先备份将涉及的 flash 区域，再临时运行与前一块板相同的 32fs 音量对照应用，光驱服务未启动。通过 UART 分别启动左声道 441 Hz、右声道 882 Hz，每段约 9 秒，各段后半程将 PCM 振幅提高至 4 倍。两个声道均按时停止，写入错误、软件欠载及发送事件队列溢出均为零。用户反馈换板后左、右两段均未听到声音。

每个声道、每个音量在 MCU 引脚侧采样 256 帧，每次从机中途启动的首帧均与参考序列不同，紧随的 255 帧全部匹配。后一段的有效采样峰值从左 4096、右 4088 分别升至左 16384、右 16352。测试后已恢复这块新板测试前的引导程序、分区表和应用所涉扇区，三个区段分别校验通过。串口日志与回读比对结果在 `.local/bench/2026-11-06-new-s3-7goX3s/`。

### DAC 板端 DIN 回读

保留 GPIO6 到 DAC DIN 的发送线，从 DAC 排针的 DIN 焊点另引一线至 ESP32-S3 的 GPIO15 输入。第二个 I²S 外设使用 GPIO15 作为数据输入，BCK 和 LRCK 分别取自 ESP32-S3 本地 GPIO4 和 GPIO5。功放关闭，独立生成左 441 Hz、右 882 Hz 的双声道测试音。连续回读 399 个完整块（175959 个立体声帧，约 3.99 秒），从相位 0 开始的全部块 CRC32 与预期匹配。DAC 板端 DIN 焊点收到预期数据，DAC 端两条时钟及芯片内部解码仍待验证。

测试已自动停止，临时写入的三个 flash 区段均已恢复并独立校验，校验后设备停留在下载模式。日志及比对结果在 `.local/bench/2026-11-06-dac-din-MKl8ts/`。

### DAC 板端 BCK 回读

将 GPIO15 回读线的 DAC 端从 DIN 移至 BCK 焊点。第二个 I²S 外设使用从 DAC 焊点返回的 BCK 作为接收位时钟，LRCK 与 DATA 取自 ESP32-S3 本地 GPIO5、GPIO6。功放关闭，播放独立双声道测试音。从相位 0 开始的 399 个完整块（175959 个立体声帧，约 3.99 秒）均与预期 CRC32 匹配。该结果确认测试期间 DAC 的 BCK 焊点能提供可用于解码的位时钟。DAC 板端 LRCK 尚待单独回读。

测试自动停止，原固件受影响的三个 flash 区段已恢复并逐段校验，设备停留在下载模式。日志和比对结果在 `.local/bench/2026-11-06-dac-bck-PYRiDH/`。

### DAC 板端 LCK 回读

GPIO15 回读线接 DAC 排针 LCK 焊点，第二个 I²S 外设使用这个信号划分左右声道，位时钟与数据分别来自 ESP32-S3 本地 GPIO4、GPIO6。功放关闭。左 441 Hz、右 882 Hz 测试音从起始相位连续回读 399 个完整块（175959 个立体声帧，约 3.99 秒），全部块的 CRC32 与预期相符。至此，DIN、BCK、LCK 均已在 DAC 排针处分轮回读；这些测试没有采集 DAC 的模拟输出。

原固件的三个受影响 flash 区段均已恢复并独立校验，设备停留在下载模式。日志和比对结果在 `.local/bench/2026-11-06-dac-lck-G7duYW/`。

### 新主控与新 DAC 的左声道强测试音对照

拆除 GPIO15 临时线，功放关闭，DAC 的 3.5 mm 口空载。万用表固定在交流 2 V 档，测 LROUT 对相邻 AGND。左声道 441 Hz 正弦峰值为 16384（约 −6 dBFS），用户报告 0.160～0.285 V；切换到持续发送零样本的数字静音后，用户报告 0.006～0.007 V。两段均由 UART 确认运行，表笔及量程保持不变。这组结果显示板上左声道测点的交流读数随测试信号明显变化；仪表未验证频谱，且该次未测音频线末端。

测试结束后已停止输出并恢复新主控原固件，受影响的三个 flash 区段均独立校验通过。串口和恢复校验日志在 `.local/bench/2026-11-06-lrout-strong-UwEHi8/`。

### 强测试音与数字静音在线末端的交流读数

同一诊断镜像、同一交流 2 V 档，3.5 mm 线插在 DAC 上，功放端悬空。用户测线末端尖端对套筒，左声道 441 Hz 强音一项报 0.008～0.028 V，数字静音报 0.007 V。强音窗口约 100 秒后自动停止，第一项回复在停止后收到，读表时刻没有独立时间戳。数字静音另行启动，读数在运行期间收到。此前拔线时板上 LROUT 对 AGND 的强音读数为 0.160～0.285 V。两次强音测点和插线状态均不同，无法仅据此判断衰减位置。

两段均确认停止，原固件恢复并校验通过。日志在 `.local/bench/2026-11-06-plug-strong-oIi7eG/` 和 `.local/bench/2026-11-06-plug-silence-KOpcFM/`。

### 线末端强测试音复测

用户要求重播相同的左声道 441 Hz 强测试音，并确认红表笔在 3.5 mm 插头尖端。播放期间收到交流读数 0.095～0.309 V，随后停止。此前同一测点数字静音为 0.007 V。此次读数的时间已确认，说明线末端在空载时有随测试音升高的交流信号；该测量未涵盖插头接入功放后的状态。已恢复并校验原固件。日志位于 `.local/bench/2026-11-06-strong-replay-fK55z1/`。

### 更换 3.5 mm 线并直连耳机

新主控独立播放左 441 Hz、右 882 Hz，各约 10 秒。此次采用约 −18 dBFS 电平，未启用 4 倍振幅。用户报告耳机两段均未听到。线材和负载同时更换，耳机输入阻抗未知。串口确认两段均进入 playing，随后停止，写入错误和软件欠载均为零。原固件已恢复并独立校验。日志位于 `.local/bench/2026-11-06-headphone-v89gIZ/`。

### 新线接功放 AUX 的听音对照

沿用上次直连耳机时的新线、诊断镜像和电平（约 −18 dBFS），将线接到功放 AUX。左声道 441 Hz、右声道 882 Hz 各播放约 10 秒，用户反馈喇叭两段均无声。串口确认两段分别进入 playing 后停止，写入错误和软件欠载均为零；本轮未测接入功放时 DAC 的模拟输出。原固件已恢复并校验。日志在 `.local/bench/2026-11-06-new-cable-aux-atpWHf/`。

### 2026-11-07 三线直连功放试听

按 LROUT → INL、AGND → 功放输入 GND、ROUT → INR 三线直连，沿用 AUX 试听的测试镜像与约 −18 dBFS 电平。先播左 441 Hz，再播右 882 Hz，各约 10 秒。用户确认听到右边的高音，对左边是否出声没有把握。右路在该接法下已获听音确认，左路待确认。此对照同时绕过两个 3.5 mm 插座和线缆，无法单独归因于某个插座。两段均已停止，原固件恢复校验通过。日志在 `.local/bench/2026-11-07-three-pin-yo4KgP/`。

### 2026-11-07 三线直连同频复听

使用相同的 882 Hz PCM 波形和约 −18 dBFS 数字电平，先右后左各播放约 10 秒。用户提出引脚接触可能不稳并要求重播。按同一条件重播后，用户报告两段均未听到测试音，只听到一直存在的干扰声。此前对右侧高音的听感此次未复现；接触不良尚未证实。复听日志在 `.local/bench/2026-11-07-equal882-replay-cYN4wx/`。

### 2026-11-07 三线直连状态下的 CD 试听反馈

开始准备时，串口尾号 8636 的开发板已备份、写入并校验临时 CD 播放器。读取目录前该板从电脑断开；恢复程序未能打开串口，未执行恢复写入。原始备份及日志在 `.local/bench/2026-11-07-three-pin-cd-UUvXWb/`。重新连接同一板时可据此恢复。

之后电脑识别到串口尾号 9063 的开发板，其现有固件已是 CD I²S 播放器。该板读到 13 条音轨，实际读取第 1 轨约 31 秒。停止时累计 301 次读取、向 I²S 提交 5528376 字节，写入错误和软件欠载均为零，最终 stopped／closed。用户报告全程只有原先持续存在的干扰声，未听到可辨认音乐。日志在 `.local/bench/2026-11-07-cd-oldboard-v2R0FA/play.log`。

同一块 9063 开发板再次播放 CD 第 1 轨约 31 秒，累计完成 301 次读取，向 I²S 提交 5528376 字节。停止后通道关闭，写入错误和软件欠载均为零。用户再次报告只有持续干扰声，没有可辨认的音乐。日志在 `.local/bench/2026-11-07-cd-relisten-yMg6su/play.log`。

同一块 9063 开发板随后又进行了三轮第 1 轨试听，每次约 31～32 秒。三轮均完成读取并向 I²S 提交音频，写入错误和软件欠载为零，最终停止并关闭通道。最后一轮换上 3.5 mm 线缆。用户确认这几轮均只有持续干扰声，未辨认出音乐。对应日志依次为 `.local/bench/cd-replay-us7DQc/play.log`、`.local/bench/cd-replay-KArP47/play.log`、`.local/bench/cd-cable-Ipsnqf/play.log`。
