miclle/discora/docs/records/2026-11-07-cybertrack-audio-crosscheck.md

# 2026-11-07 CyberTrack 面包板音频对照

用户授权先备份 CyberTrack 的固件和配置，再用已能出声的面包板验证 Discora 音频输出；随后授权用这块板测试 CD。执行器功率已由用户确认断开。

## 最终结论与当前设备状态

**CD → ESP32-S3 → PCM5102A → TPA3118D2 → 双喇叭的基础立体声播放已调通，状态为 bench-tested。** 最终换板后使用 COM 尾号 8636 的 ESP32-S3，GPIO15/16/7、16-bit slot；原 DIN 连接存在数据传递／取样异常，更换为已验证的线后，右声道测试音对应正确，双声道测试音响度接近，原始立体声 CD 约 60 秒左右连续清晰。未分辨原线芯、端子或焊点的具体故障，不能推定 DAC 损坏。

- 成功 CD 窗口：60010 ms、10592820 字节、570 次读取；写入错误、软件欠载、stale 均为 0，一次初始 USB 枚举，播放期间无掉线。用户确认无明显杂音。
- 范围：同张 13 轨音乐 CD 第 1 轨的短时播放；前轮 USB 掉线仍保留为失败证据，完整曲目／整盘、冷启动与重复启停未验收。
- 8636 板：保留临时 CD 诊断候选，最后为 stopped；GPIO4 测量线已移除，原应用备份保留。不是已恢复的 0.10.0 OLED 部署。
- CyberTrack 板：原 2.0.3-ct78 固件及配置已恢复，完整 Flash 校验一致；不作为 Discora 产品依赖。
- 成功应用 SHA-256：`0cb0a6b211d6064d8f0c3334bd740961e5f1a200999cb3a26e08e29f688dafe5`。本地源码为 `.local/bench/cybertrack-audio-j_7896v7/cd-stereo-src/`，构建产物为同目录下 `cd-stereo-build/discora.bin`；在 8636 板写入 factory 应用偏移 `0x10000`，保留原启动及配置区域。

候选对原始左右声道分别缩放至 25%，约 60 秒自动停止，关闭按键和 OLED；这些临时入口、增益／截止控制未合入仓库主固件。源码默认 GPIO4/5/6，成功接法为 GPIO15/16/7，详见[配置差异](../audio-output.md#已通过的接法与默认配置差异)。所有本地备份、构建与原始日志均在忽略目录，不包含在提交中；未保存或提交 CD 音频转储。

下文按时间顺序保留失败、恢复和当时待办，历史“当前”不覆盖本节最终状态。

## 备份和写入范围

设备身份与 CyberTrack 历史部署记录一致。原应用版本为 2.0.3-ct78，16 MiB Flash 已完整读取，每 1 MiB 与设备端 MD5 独立核对。完整备份 SHA-256 为 `63a6347916085d7a58002c9233eb658a75f0e621be8e9d84442cd136aafe2148`。

备份、构建和串口日志保存在本地忽略目录 `.local/bench/cybertrack-audio-j_7896v7/`，文件访问权限限制为当前用户；配置内容不进入仓库。有效应用位于 0x20000，仅临时覆盖应用所需扇区。每轮恢复后核验覆盖区、配置区和其余全部 Flash，重启前与该轮基线一致。

临时程序使用 BCLK=GPIO15、LRCK=GPIO16、DATA=GPIO7，GPIO8/9/10/11/12/13/17/18/21 控制输出置低。第一阶段使用原生 USB 日志；CD 阶段改为独立 UART0 串口，以释放原生 USB 给光驱。功放芯片型号尚未确认。

## 测试音结果

- A 轮采用 CyberTrack 板级源码中的 24 kHz、32 位单声道左槽格式，生成 882 Hz，PCM16 等效峰值为 4096。用户确认听到声音。主机收到开始回执，但没有收到预期的自动停止回执，随后恢复原应用并完成全 Flash 校验。此轮只记录听感成功，自动停止未验收。
- 补充进度和输出刷新日志后，B 轮使用当前 Discora `audio_i2s.c/h` 的逐字节副本，44.1 kHz、16 位立体声、16 位槽、Philips I²S，在左右槽填入相同的 882 Hz、峰值 4096。用户确认听到声音。运行约 12 秒后收到自动停止回执，提交 2122092 字节、写入错误 0、结果 ESP_OK。
- B 轮结束后恢复原 CyberTrack 应用，重启前完整 Flash 与备份一致。以上结果证明 Discora 的 I²S 输出实现能在这套面包板硬件上播放合成测试音；没有验证 PCM5102A 模块及其到原功放的模拟链路，也没有验证立体声分离。

测试候选位于本地独立源码快照，主项目 I²S 实现没有为此改写。ESP-IDF v5.4 下 set-target esp32s3 和 build 完成。临时测试入口和板级保护代码单独构建，不运行语音、网络或机器人控制业务。

## CD 对照准备

CD 候选沿用 Discora 真实 USB/READ CD 和播放链路，使用面包板音频 GPIO，关闭默认退盘键、换轨键及 OLED，以免占用已有音频和执行器引脚。单声道混合在音频输出前执行，左右有符号 16 位样本扩宽相加后除以 8，等价于 (L+R)/2 再乘 25% 增益，结果复制到两个 I²S 槽。源校验位于混合之前，未保存 CD PCM。

CD 候选已完成 set-target esp32s3 和 build。电脑经独立 COM 连接，原生 USB 接入独立供电的光驱，实际结果见下文。

独立 COM 已通过芯片身份核验。首次加载辅助程序及后续大块 Flash 写入出现校验错误，自动恢复也遇到同样错误；改用 57600 baud、256 字节 RAM/Flash 传输块后，成功恢复原应用并通过写后摘要校验。随后沿用小块传输再次部署 CD 候选。该问题属于本次串口传输证据，不能据此推定之前音频故障的原因。

首次 CD 实机运行成功识别 UJ-898 / HC10、13fd:0840 Full-Speed BOT，并取得同一张 13 轨目录，lead-out LBA 252645。play 被接受，但第一个 LBA=0、8 扇区 READ CD 在约 1618 ms 后发生 ESP_ERR_INVALID_STATE，随后设备重新枚举并报告 06/29/00。没有完成音频读取，I²S 提交字节为 0，未开始音乐试听。原应用恢复及整片 Flash 对该轮基线校验通过。日志位于本地目录下 `cd-1794019827381393000/`，其中 `play.log` 为串口原始记录。

延长启动后的等待时间后进行一次重试。光驱取得同张 13 轨目录，第 1 轨进入 playing，用户在播放期间明确确认“听到音乐了”。播放约 31 秒后已停止，I²S 通道关闭，累计完成 300 次读取并提交 5514264 字节，写入错误和软件欠载均为 0；stale=1 保留，停止时清空队列。该轮日志位于本地目录下 `cd-1794019981790224000/play.log`。

本轮听感验收覆盖面包板单喇叭、左右混合、25% 数字幅度、CD 第 1 轨的短时播放。它支持 Discora 的 USB/CD 读取、PCM 消费和 44.1 kHz I²S 输出在这套硬件上能够实际播放音乐。PCM5102A 与原功放组合的无声原因仍待定位，不能直接判定模块损坏或宣称立体声／整盘验收通过。

CD 重试结束后，原 CyberTrack 应用已恢复，重启前完整 Flash 与该轮原应用／新鲜配置快照／未修改尾区逐段校验一致。随后 UART0 启动日志再次识别到 2.0.3-ct78。备份和测试程序仅保存在本地忽略目录，未提交或推送。

## CyberTrack 主控接 PCM5102A 与原功放

用户确认断电后移除原 Discora 主控到 DAC 的三根信号线及面包板原音频小板的 I²S 信号线，改为 GPIO15→BCK、GPIO16→LCK/LRCK、GPIO7→DIN、公共 GND。PCM5102A 使用独立 5V，通过 3.5 mm 线缆接原功放（用户在本轮结束后明确），低音量，执行器功率断开。

候选音频源码与有声 B 轮逐字节一致，仅将主控制台从原生 USB 切换为 UART0，完成独立 set-target esp32s3 和 build。使用新的配置快照并核对原应用后，临时写入应用区，44.1 kHz／16 位立体声／16 位槽、882 Hz、PCM16 峰值 4096、左右相同信号运行约 12 秒。用户报告“完全安静”。日志确认自动停止，累计提交 2113272 字节，写入错误 0，结果 ESP_OK。记录位于本地目录 `pcm-1794020781152251000/`。

此对照进一步降低主控或通用 I²S 发送逻辑作为首要原因的可能性，但此次新接线的 DAC 排针信号尚未独立采集。剩余范围包括换接的 I²S／地线、PCM5102A 的配置与供电、模拟输出到原功放的连接及功放输入状态，不能单凭本轮无声判断 PCM5102A 芯片损坏。

本轮结束后原 CyberTrack 应用已恢复；重启前配置区、应用覆盖区和其余 Flash 均独立校验通过，与该轮基线一致。

用户随后确认已将 SCK 接到 DAC GND，要求再次测试。沿用相同主控、GPIO15/16/7、44.1 kHz／16 位立体声／16 位槽、左右同为 882 Hz、PCM16 峰值 4096、3.5 mm 输出接原功放，约 12 秒后自动停止。用户反馈“仍然完全安静”。提交 2111508 字节、写入错误 0、结果 ESP_OK。此轮说明新增 SCK 接地后声音未恢复，未单独测量 DAC 其他配置脚或模拟输出。日志位于本地目录 `pcm-1794021073057553000/`。

SCK 接地复测结束后已恢复 CyberTrack 原应用，重启前配置区、应用覆盖区和其余 Flash 均通过独立校验。

用户随后将 DAC 输出从 3.5 mm 线缆改为直接连接原功放输入接线端，再次要求复测。按三线直连 INL／GND／INR 的上下文执行相同候选，GPIO15/16/7、44.1 kHz／16 位立体声／16 位槽、左右 882 Hz、峰值 4096，约 12 秒后自动停止。用户反馈“完全安静”。累计提交 2111508 字节、写入错误 0、结果 ESP_OK。日志位于本地目录 `pcm-1794021256055071000/`。绕过插座和线缆后仍未恢复声音，不能将 3.5 mm 路径作为本轮唯一解释；该结果未独立验证 DAC 模拟输出和功放输入电压。

三线直连复测后已恢复 CyberTrack 原应用，重启前配置、应用覆盖区和其余 Flash 均通过独立校验。

用户进一步确认把原功放输入 GND 接至 DAC AGND 后，要求再次运行相同 882 Hz 对照。两声道约 12 秒后自动停止，提交 2113272 字节、写入错误 0、结果 ESP_OK，用户反馈“仍然完全安静”。本次只确认改接音频地后的听感，未测功放输入端的实际信号。日志位于本地目录 `pcm-1794021447706483000/`。

AGND 改接复测后，原 CyberTrack 应用已恢复，重启前配置区、应用覆盖区和其余 Flash 均通过独立校验。

用户要求按当前接法再次复测，沿用同一候选和数字音量，882 Hz 双声道约 12 秒后自动停止。用户明确反馈“听到清晰高音，并随测试结束消失”。提交 2111508 字节、写入错误 0、结果 ESP_OK，日志位于本地目录 `pcm-1794022127491863000/`。本次确认当前 PCM5102A→原功放→喇叭链路能传出受控测试音；用户随后确认左右两边均有声音，相邻两轮之间接线、电源、焊桥和音量均未手动调整。重复稳定性仍待确认，不能据此将恢复归因于某根线或判定单一根因。尚未在这套 PCM5102A 输出链路上验证 CD 音乐。

本次双喇叭有声复测结束后，CyberTrack 原应用已恢复；重启前配置区、应用覆盖区和其余 Flash 均通过独立校验。

## PCM5102A 与原功放的 CD 音乐试听成功

用户要求在刚刚双声道测试音出声的接法下测试 CD，沿用 CyberTrack 主控 GPIO15/16/7、PCM5102A、三线直连原功放输入且输入地接 AGND、SCK 接 GND。使用已在面包板原音频硬件上成功的 CD 候选，44.1 kHz／16 位立体声槽，左右混合后 25% 数字幅度复制至两个槽。

同张 CD 第 1 轨运行约 31 秒后明确停止，用户确认“听到了音乐”。累计完成 300 次读取、提交 5514264 字节，写入错误和软件欠载均为 0，stale=1 保留，最终 stopped、I²S closed。日志位于本地目录 `cd-1794022337209752000/play.log`。

本轮实际验证当前主控→PCM5102A→原功放→喇叭链路能够短时播放 CD 音乐。由于使用左右混合输出，原生左右声道分离、完整曲目／整盘、反复启停与冷启动稳定性尚未验证。此前间歇无声的根因仍未确定。

PCM5102A CD 试听成功后，CyberTrack 原应用已恢复；重启前配置区、应用覆盖区和其余 Flash 均通过独立校验，完整备份保留。

## 独立左右声道测试

用户要求原生左右声道分开试听，先左后右。独立临时候选沿用已出声的 I²S 实现、GPIO15/16/7、44.1 kHz／16 位立体声／16 位槽；882 Hz、PCM16 峰值 4096，只在所选声道写入测试音，另一声道全零。主机测试校验两种缓冲区对应槽全零且有效槽幅度相同，set-target esp32s3 与 build 通过。

首轮左声道约 12 秒自动停止，提交 2107980 字节、写入错误 0、ESP_OK。用户确认有声音，但无法明确辨别来自哪边，因此声道对应关系尚未通过。日志包含 IDLE0 任务看门狗告警，无重启且最终明确停止；此前双声道有声候选日志中也存在同类告警，不应将写入错误为零表述为日志无异常。日志位于本地目录 `split-1794023314664954000/play.log`。

用户要求换成便于感知振膜的信号，故取消尚未开始的右声道，停止主机等待进程并执行恢复。原 CyberTrack 应用及本轮配置、其余 Flash 已全部独立校验通过。后续独立候选改用 200 Hz、峰值 8192、半秒响／半秒静音；音频任务每 100 ms 主动让出一个 tick，避免诊断循环长期占用 CPU。主机检查所选槽、另一槽全零、静音半周期和幅度上限通过，构建通过；物理测试结果另行记录。

200 Hz 间歇候选在同一次启动中依次执行左声道、按用户要求重复左声道、右声道，每段约 12 秒。每段提交 2123856 字节、写入错误 0、ESP_OK，均有明确停止日志；该候选本轮日志无 task_wdt 告警。左声道复测用户确认“只有左边”，随后右声道测试确认“只有右边”。另一槽全零，因此本轮验证的是独立左右输出，而非复制单声道。日志位于本地目录 `pulse-1794023573457724000/play.log`。

当前 CyberTrack 主控→PCM5102A→原功放→两只喇叭的声道分离与对应关系通过本次短时实测。此结论不覆盖 CD 原生立体声内容、反复冷启动稳定性，也未定位此前间歇无声的根因。

独立左右测试结束后，原 CyberTrack 应用已恢复；重启前配置区、应用覆盖区和其余 Flash 均通过独立校验，完整备份保留。

## CD 原始左右声道各 60 秒对照

用户要求延长 CD 左右分开试听，约定从第 1 轨开头先左后右、每段约 60 秒，另一槽全零。新临时候选保留 CD 原始所选声道，以 25% 数字幅度输出，移除此前 `(L+R)/8` 混合复制；输出任务内增加 60 秒限时停止，仅在 stopped 时允许切换声道。固定的不同左右有符号样本验证缩放、通道保留和另一槽全零通过，set-target esp32s3 与 build 通过。

首次主机脚本误将 `track 1` 当作仅选轨，但该命令实际会进入 prefill 并自动播放，导致播放早于听音门控。启动时间校验发现不符，主动 stop，确认 I²S closed。此轮约 18 秒，提交 3173436 字节、写入错误与 underruns 为 0，不计入约定的 60 秒试听结果。日志位于本地目录 `cd-split-1794023977350223000/play.log`。已修正主机脚本：保持上电的第 1 轨 stopped 状态，门控后才显式 play；固件 stop 会将读取位置复位到本轨开头，后续右声道不再调用会自动播放的选轨命令。

首次提前播放的失败轮次结束后，原 CyberTrack 应用、配置区及其余 Flash 已独立恢复校验通过。修正主机脚本后重新执行，日志位于本地目录 `cd-split-1794024157964710000/play.log`。沿用原 CD 候选的 USB／光驱路径和现有 PCM5102A→原功放三线接法，无需变更接线或音量。

第 1 轨原始左声道与原始右声道分别从轨首输出，均在首次 I²S 启动后 60010 ms 触发固件限时停止。每段提交 10592820 字节，合计 21185640 字节；每段完成 570 次读取，合计 1140 次。最终 I²S closed、opens=2/closes=2、write_errors=0、underruns=0、stale=0，日志无任务看门狗告警。用户先确认“只有左边，音乐正常”，后确认“只有右边，音乐正常”。

本轮确认当前 CyberTrack 主控、PCM5102A、原功放与喇叭组合能分别播放 CD 原始左右声道，各约 60 秒、25% 数字幅度，另一槽全零。完整原生双声道同时播放、完整曲目／整盘、冷启动及反复启停稳定性仍未在本轮验收；此前间歇无声的根因仍未知。

本次左右各 60 秒 CD 试听结束后，CyberTrack 原应用已恢复；重启前配置区、应用覆盖区及其余 Flash 全部通过独立校验。原始完整备份保留。

## 换回串口尾号 8636 主控的同二进制对照

本节及后续 `8636-cd-native-20261107/…` 日志路径均相对于仓库 `.local/bench/`，不位于前述 CyberTrack 备份目录内。

用户更换主控并确认 GPIO15→BCK、GPIO16→LCK、GPIO7→DIN，要求运行刚才成功的 CD 程序。实时识别串口 VID:PID=1a86:55d3、序列号 5C82128636、芯片 MAC=b8:1f:3f:d6:08:88，16 MiB Flash／8 MiB PSRAM；与 CyberTrack 主控不同。该板当前分区为 factory@0x10000/1 MiB、NVS@0x9000/0x6000。读出并独立校验完整 factory 分区，以及前 64 KiB 启动／分区／配置区，原应用版本为 0.10.0-oled。

使用上一轮 CD 原始左右各 60 秒测试的同一二进制，SHA-256=`523f9986c58b0b0645fbc14c4033e0d1b9ed5b39757d6a6006c953f5107c22f0`，仅按本板既有 factory 地址写入 0x10000，未移植 CyberTrack 的分区表或配置。首轮日志位于本地目录 `8636-cd-native-20261107/test-1794025509646851000/`。

首轮识别到桥接器 13fd:0840、MATSHITA UJ-898/HC10 和第 1 轨，但首次 READ CD 运行 1666 ms 后报 ESP_ERR_INVALID_STATE，媒体丢失并重新枚举，随后 sense=06/29/00。I²S opens=0、pcm_submitted=0，尚未输出音乐，不计为音频链路无声结论。主机停止测试后恢复该板原 0.10.0-oled 应用，factory 分区和前 64 KiB 均独立校验通过。该轮明确失败在 CD 数据源进入音频输出之前，不能据此认定 DAC 或功放故障。

第二轮对照日志位于本地目录 `8636-cd-native-20261107/test-1794025639279076000/`，候选二进制未改变。左声道完成 60010 ms、提交 10592820 字节、570 次读取，用户确认左边音乐连续，但有较多杂音，感觉与光驱转动频率相关。该相关性为用户听感，未以电压／频谱测量确认，不能直接定为电源或地线耦合。

右声道启动后 4570 ms 出现 READ CD ESP_ERR_INVALID_STATE，媒体丢失并重新枚举，随后 sense=06/29/00。右段提交 816732 字节，累计提交 11409552 字节、620 次读取，write_errors=0、underruns=0、I²S opens=2/closes=2；用户反馈右段“没有听到声音”。右段未完成 60 秒且听音未通过，不能依据 MCU 提交数据宣称右声道正常。

本次更换主控的同二进制对照未通过：左段能持续出音乐但有杂音，右段短时输出后因 USB 源丢失停止且用户未听到声音。该板上的两次播放尝试均观察到光驱掉线／重新枚举，已停止重复试听。尚未确认掉线和杂音是否同源。测试结束后恢复此板原 0.10.0-oled 应用，完整 factory 分区及前 64 KiB 启动／分区／配置区域独立校验通过；CyberTrack 已恢复的板子未被再次写入。

用户要求继续定位右声道。单独重试右声道 CD（`8636-cd-native-20261107/right-1794026071924051000/`）仍在约 5 秒输出后因媒体丢失停止，提交 829080 字节、写入错误 0、软件欠载 0，光驱再次枚举并报告 sense=06/29/00；未完成 60 秒。

随后使用先前在 CyberTrack 上确认两边可听到的同一 200 Hz 间歇低音二进制，绕开 USB/CD 源，在 8636 板分别测试右、左声道。右段日志 `right-pulse-1794026165009172000/`、左段 `left-pulse-1794026259135852000/`，每段约 12 秒、提交 2123856 字节、write_errors=0、ESP_OK，均明确停止。用户对两段分别确认“完全没有声音”。因此当前无声并非只发生在右声道，且不能由 CD 读取中断单独解释；该结果仍不确定 DAC 端波形、供电／共地或模拟输出路径的故障位置。

为获得新证据，在临时低音程序中加入现有 PCNT 时钟探针，保持 GPIO15/16/7 和既有 I²S 实现，使用数字静音运行约 2 秒；set-target esp32s3 与 build 通过。记录位于 `padcheck-1794026457312439000/`：GPIO15 计数 1424546、窗口 1009471 us，约 1411180.71 Hz；GPIO16 计数 44517、窗口 1009465 us，约 44099.60 Hz。测量限于 MCU GPIO 输入回读，不证明 DAC 端电压幅度、线路连通、DIN 时序或模拟输出正常。用户已被询问换主控后 DAC GND 是否确实接至当前板 GND，待确认。

本阶段为便于继续排查，保留了当前板的低音／时钟诊断固件，开机保持 stopped；末次写入及前 64 KiB 启动／配置区校验通过。原 0.10.0-oled factory 完整备份仍保留，此时不应描述为已恢复原固件或正在运行 CD 播放器。CyberTrack 板未改动。

用户随后明确确认 DAC GND 已直接接至当前 ESP32-S3 GND；该项按用户确认记录，未重复要求测量。为验证实际 DAC BCK 接点而非仅 MCU 自回读，临时诊断扩展为 GPIO15 源时钟参考、GPIO4 外部输入计数。GPIO4 在启动时显式配置为 INPUT，关闭上下拉；启动寄存器转储确认 InputEn=1、OutputEn=0。set-target esp32s3 与 build、应用写入和启动／配置校验通过，日志位于 `8636-cd-native-20261107/endpoint-1794026679415084000/`。未启动测量，已请用户断电后新增 DAC BCK 接点→GPIO4 的临时线，原 GPIO15→BCK 连线保留，待用户接好确认。临时线在位时不能恢复会驱动 GPIO4 的原应用；应先移除临时线。

用户确认临时线已从 DAC BCK 接点接至 GPIO4，并已上电、功放关闭。未改写固件，测量前再次从启动转储确认 GPIO4 InputEn=1、OutputEn=0。数字静音下计数约 1 秒，随后关闭 I²S：GPIO15 1424523 edges/1009456 us，约 1411178.89 Hz；GPIO4（DAC BCK 接点回线）1424534 edges/1009451 us，约 1411196.78 Hz。两处频率相符，确认在该测量窗口内 BCK 时钟到达用户接取的 DAC BCK 排针接点；不代表波形幅度／完整性或芯片内部接收已验收。日志位于 `8636-cd-native-20261107/endpoint-bck-1794026816429292000/`。

BCK 测量已明确停止，未重刷原应用。下一项仅将临时线 DAC 端移至 LCK/LRCK、GPIO4 端不动，以同一程序检查 DAC 端帧时钟，待用户接好确认。

用户确认临时线 DAC 端已移至 LCK/LRCK。沿用外部输入诊断，GPIO15 1424523 edges/1009456 us，约 1411178.89 Hz；GPIO4（DAC LCK/LRCK 回线）44517 edges/1009451 us，约 44100.21 Hz，符合 44.1 kHz 帧时钟。测量已停止，日志位于 `8636-cd-native-20261107/endpoint-lrck-1794027632312249000/`。至此两根时钟均已在用户接取的 DAC 排针接点测得预期频率，但未验收波形电压／完整性或 DAC 芯片内部接收。

下一步改为 DIN 外部输入对照：GPIO7 作为发送端回读参考，GPIO4 继续为输入；分别发送全零 PCM 和固定 PCM16LE（左槽 0、右槽 1），预期 DIN 从无上升沿变为每帧一个上升沿。两段各有约 1 秒计数窗口，约 2 秒后自动关闭 I²S。临时诊断 set-target esp32s3 与 build 通过，写入及启动／配置校验通过，启动再次确认 GPIO4 InputEn=1、OutputEn=0，尚未启动测量。部署记录 `8636-cd-native-20261107/dincheck-1794027718227558000/`。已请用户断电后将临时线 DAC 端从 LCK/LRCK 移到 DIN，GPIO4 端及原 GPIO7→DIN 线保留，待确认。此状态下仍不能刷回会驱动 GPIO4 的原应用。

用户确认临时线已从 DAC DIN 接点接到 GPIO4 并上电后，执行两段固定数据对照，均自动停止，写入错误 0。日志位于 `8636-cd-native-20261107/endpoint-din-1794027979735093000/`。全零段：GPIO7 0 edges/1009471 us、GPIO4 0 edges/1009461 us。固定数据段（左槽 0、右槽 1）：GPIO7 44537 edges/1009924 us，约 44099.36 rising edges/s；GPIO4 0 edges/1009917 us。主控 DIN 输出回读符合每帧一个上升沿，但用户连接的 DAC DIN 外部测量回线上未检测到上升沿。此差异将下一项检查限定为 GPIO7→DIN 数据线、DIN 接点与 GPIO4 测量回线的连接／接触，不能直接归因为 DAC 损坏，也不能将零上升沿等同于已测得 0 V。

已请用户断电确认 DAC DIN 同时接着 GPIO7 数据线和 GPIO4 测量线，GPIO4 不能替代 GPIO7；重插或更换数据线并确认测量线接触后再上电。两根时钟不重复测量，待用户反馈。当前保留输入 GPIO4 的 DIN 诊断固件、stopped，临时测量线在位时不得恢复会驱动 GPIO4 的原应用。

用户确认两根线原本均接着，已重插或换线后上电。未改写固件，复测同一 DIN 回线：全零段 GPIO7 和 GPIO4 均为 0；固定数据段 GPIO7 44537 edges/1009925 us（约 44099.31 rising edges/s），GPIO4 0 edges/1009917 us。两段均明确停止、写入错误 0。记录位于 `8636-cd-native-20261107/endpoint-din-reseat-1794028105583429000/`。结果未改变，尚不能区分数据路径不通与测量线／接点未有效取样。

为检验测量回路，已请用户断电后仅将临时测量线的 DAC DIN 端移至当前 ESP32-S3 GPIO7 接点，GPIO4 端不动，原 GPIO7→DAC DIN 数据线保留，以同一程序进行发送端物理回环对照。待接好确认后测量；GPIO4 保持输入，功放保持关闭。

用户确认临时线已改为 GPIO7→GPIO4 直接回环，原数据线仍接 DAC。同一程序全零段两端均 0；固定数据段 GPIO7 44537 edges/1009925 us（约 44099.31 Hz），GPIO4 44537 edges/1009916 us（约 44099.71 Hz）。两处脉冲数一致，测量后明确停止。日志位于 `8636-cd-native-20261107/gpio7-loopback-1794028336333578000/`。此对照确认主控物理 GPIO7 接点、该临时线和 GPIO4 测量输入能传递／检测测试数据；与 DAC DIN 接点两次 0 edges 对照，问题范围收窄至原 GPIO7→DAC DIN 连接及其取样接点，不据此判定线芯、端子或板焊点中的具体故障。

已请用户断电取下原 GPIO7→DAC DIN 线，利用刚刚验证成功的回环线：GPIO7 端保留，将 GPIO4 端改接 DAC DIN，GPIO4 留空；其余线路不动。待恢复供电、功放低音量后，仅重试右声道低音。现有固件支持该试听，无需重新烧录。

用户确认已取下原 DIN 数据线，将验证过的回环线改为 GPIO7→DAC DIN，GPIO4 留空，功放已准备试听。沿用板上现有诊断固件，无烧录，运行仅右声道 200 Hz、半秒响／半秒停、峰值 8192 的低音约 12 秒。日志明确 RIGHT stopped，提交 2123856 字节、写入错误 0、ESP_OK。记录位于 `8636-cd-native-20261107/right-after-din-1794028466210279000/play.log`，实际听感待用户反馈；不能仅凭日志宣布换线修复。

换线后的右声道低音，用户选择“只有左边响，或两边都响”。该反馈表明听到了声音，但选项合并了两种不同声道表现，不能据此宣称右声道对应正确或左右均通过。已请求用户仅澄清刚才是左边单独、两边都有，还是无法分辨，不重播、不改线；软件仍为仅右槽有低音、左槽全零。

用户对换线后的首次低音进一步澄清为“听到了低音，但无法分清哪边”，随后主动要求重播观察。沿用现有固件、当前 GPIO7→DAC DIN 新连线及数字幅度，无烧录，右声道 200 Hz 间歇低音约 12 秒自动停止；提交 2123856 字节、write_errors=0、ESP_OK。日志位于 `8636-cd-native-20261107/right-after-din-repeat-1794028639204371000/play.log`。用户明确确认“只有右边”。

当前证据确认：在 8636 主控上，将已验证的回环线改作 DIN 数据线后，右声道合成测试音已实际从右喇叭正常发出。结合此前 DAC DIN 回读无上升沿、主控直接回环正常，支持原 DIN 连接／接触路径存在问题；尚未区分具体线芯、端子或接点。换线后的左声道和 CD 试听尚未复测，USB 掉线及杂音仍为未解决项，不将本次测试音通过扩大为完整 CD 播放验收。测试结束为 stopped，GPIO4 已由用户留空，诊断固件和原应用备份均保留。

用户要求同时测试左右声道。独立临时候选在既有低音／DIN 诊断上新增 b 命令，两槽同时写入相同 200 Hz 间歇低音，单声道峰值保持 8192、半秒响／半秒停、约 12 秒限时；原单声道与输入 GPIO4 诊断保留。实际 C 生成函数主机检查确认双槽内容相同、各自与原单声道幅度相同、静音半周期全零，set-target esp32s3 与 build 通过。

在当前 GPIO15/16/7、换好的 DIN 线、PCM5102A 与原功放接法下，双声道同时输出约 12 秒后明确 BOTH stopped，提交 2123856 字节、write_errors=0、ESP_OK。用户确认“左右都有清晰低音，响度接近”。日志位于 `8636-cd-native-20261107/both-1794028793170201000/`。本轮验证该板换线后两路可同时清晰出声且主观响度接近；不代表完整频响／失真测量或 CD、USB 稳定性通过。当前保留支持双声道的诊断固件、开机 stopped，应用写入与前 64 KiB 启动／配置区域校验通过，原应用备份保留。

## 换 DIN 连接后的原始立体声 CD 试听

用户要求左右同时播放 CD。临时 CD 候选保留原始左右声道，分别按 25% 数字幅度缩放后送入对应槽，不混合、不复制，新增 bench-stereo 选择，沿用 60 秒自动停止。使用不同左右正负样本验证独立缩放、单侧静音模式和立体声输出，通过 set-target esp32s3 与 build；应用和启动／配置区域独立校验通过。

首次立体声运行记录 `8636-cd-native-20261107/cd-stereo-1794030196771432000/`：提交 823788 字节（约 4.67 秒音频）、51 次读取后媒体丢失，USB 桥接器重新枚举并报告 06/29/00，I²S closed、write_errors=0、underruns=0，未完成 60 秒。用户确认听到声音、没有杂音，但来不及区分声道。

随后沿用板上同一候选、未重新烧录，重试记录 `8636-cd-native-20261107/cd-stereo-retry-1794030335017579000/`。日志包含启动过程，不能将其视为已证明无复位的同一启动会话。第 1 轨原始立体声完成 60010 ms 后自动停止，提交 10592820 字节、570 次读取；write_errors=0、underruns=0、stale=0、opens=1/closes=1。日志仅一次 USB 初始枚举，没有播放期间重新枚举、fault 或任务看门狗告警。用户明确确认“左右都有连续清晰音乐，没有明显杂音”。

本轮确认当前 8636 主控 GPIO15/16/7→PCM5102A→原功放／两喇叭，在换好的 DIN 连接下能短时播放原始立体声 CD。约 60 秒听感通过；之前掉线未根治，完整曲目／整盘及冷启动、反复启停稳定性未验收。当前保留原始立体声 CD 诊断固件，stopped；原 0.10.0-oled 完整 factory 备份仍保留，GPIO4 留空。
