miclle/discora/docs/decisions/0013-speaker-envelope-enclosure.md

# ADR-0013：按 80 × 45 × 42 mm 喇叭包络优化 V4 箱体

- 日期：2026-11-05
- 状态：概念 CAD 已实现，静态几何已检查；实物安装和声学验收未完成

> 后续状态：本文保留此前 142 × 74 × 202 mm 收紧方案的决策与检查记录。已选平排电池的适配将深度调整为 78 mm，并重新布置光驱、桥接器及后盖固定座；当前模型和新检查见 [ADR-0015](0015-flat-battery-enclosure.md)。

## 背景

用户提供的全频钕磁单元为 80 × 45 × 42 mm，单只标称 4 Ω、10 W、峰值 18 W；42 mm 是振膜最前端至磁铁最后端的总高度。原商品箱体约 235 × 115 × 65 mm，用户要求为 CD 机重新设计箱体。来源见[单元资料](../../hardware/Speaker-80x45-4ohm-10W/README.md)。

V4 原来的单只宽 24 × 高 84 × 入箱深 16 mm 仅为估算。适配真实包络后的初步方案深度为 110 mm，重新排布后曾收紧到 160 × 78 × 236 mm。用户进一步要求宽、高、厚三个方向都优化，保留原操控左右布局、外壳与声学结构左右对称，并确认保留提手但缩小开口和压低顶部。

## 决策

1. 单元长边竖放，使用完整的宽 45 × 深 42 × 高 80 mm 长方体包络，不从照片虚构盆架、磁铁或安装孔形状。两只单元朝前，中心 X=±26、Z=76，Y=6…48。
2. 整机收紧至宽 142 × 深 74 × 高 202 mm（含脚垫与提手），相比 160 × 78 × 236 mm 分别减少 18、4、34 mm，外包络体积减少约 27.9%。缩窄两侧后，后盖固定座分到光驱上下；光驱降低至 Z=18…147，桥接器占位转为 24 × 24 × 10 mm 放在下方，电池占位前移。桥接器转向是否能用现有接口或短转接线实现仍待核对，不宣称已有硬件可直接按此装配。
3. 提手净开口从 104 × 29 缩至 90 × 16 mm，顶部降低至 Z=202。前斜面及播放键、屏幕、旋钮整体下降 13 mm，保留各自形状、左右位置及相互关系。握持舒适性、提手强度与进退碟均未实测。
4. 正面格栅开口为 Ø130 mm，前障板和预留框适配双单元包络。左右后腔按 X=0 镜像，单侧外包络宽 65 × 深 52 × 高 89 mm，Z=31.5…120.5；后壁内侧 Y=52.5，喇叭后方保留 4.5 mm。侧孔缩至高 74 × 宽 29 mm，中心 Y=44、Z=80。容积减少，不假定声音与大箱体相同；孔道、气密性和调谐待验证。
5. 功放横置于喇叭上方，主控横置于光驱上方，DAC 在左侧立放。PCB 标称长宽分别为 66 × 53、63.39 × 27.94、31 × 17 mm；厚度暂设 1.6 mm，元件高度预留为功放 15 mm、主控和 DAC 各 7 mm。外壳轮廓与声学结构保持镜像，功能操控及内部电子板不要求镜像。
6. 按用户允许的方式，计划将功放原音量电位器拆下，用排线接至外壳旋钮后方；本体暂留 14 × 14 × 12 mm。未实施拆焊，不凭图片指定引脚、排线长度或固定螺纹。
7. 功放两侧各留 15 mm、主控两端各留 5 mm、DAC 两端留 5／10 mm 接头空间，并检查旋钮排线路径。电池仍为原 82 × 21 × 22 mm 旧占位，尚未适配已选的 5600mAh 成品包；本轮外壳对称调整不包含电池及充电／供电板的布局验收。

## 对称规则落实

外壳以 X=0 为中心面，原按钮与音量旋钮布局为明确例外。模型将对称主体（含提手及居中开孔）与操控切孔拆成前后两个布尔特征；右侧壳、导音孔、声腔、喇叭包络和预留框改为关联左侧源件的原生镜像。此调整固定对称建模关系，保留 142 × 74 × 202 mm 外包络及现有操控位置，没有为制造视觉差异而改变已经对称的外形。

验证覆盖完成开孔后的壳体：仅扣除按钮／旋钮切孔及其镜像的精确体积，剩余区域必须对称；居中显示窗和五组镜像源关系也纳入检查。

## 验证与限制

FreeCAD 1.1.4 重新读取保存后的模型，检查 45 个成品对象的实体有效性、两两相交体积、120 × 1.2 × 300 mm 退碟扫掠，以及左右后腔到侧面的探针通路。相交容差为 0.001 mm³；16 项镜像差集与 8 项操控件差集（补偿整体下降 13 mm 后）均为 0。所列接头、排线预留与提手开口探针无干涉。数值及对应模型 SHA-256 见 [CAD 验证报告](../../hardware/enclosure/validation.json)。这些检查不包含未确定的桥接转接线，也不替代公差、散热及装配工具空间分析。

固定当前布局做有限比较：72 mm 深度干涉，73 mm 净距仅 0.25 mm，74 mm 为 1.25 mm；140 mm 宽度时光驱导轨接触侧壁，142 mm 时净距 1 mm。以选定部件间 1 mm 概念净距筛选，采用当前宽深。高度缩减依赖桥接转向和压低提手，不能将这些有限检查称为全局最优或实物装配通过。

真实安装面与孔位、振膜行程、接线突出、气密性、声学参数、打印装配和退碟姿态仍需实测。喇叭预留框及板卡支撑仅为布局示意，不能直接作为生产安装结构。
