miclle/discora/docs/decisions/0015-flat-battery-enclosure.md

# ADR-0015：底部适配 5600mAh 平排电池，机身深度调整为 78mm

- 日期：2026-11-05
- 状态：CAD 名义包络适配已实现并静态验证；电气接入及实物装配未验收
- 依据：用户明确选择平排；[用户提供的商品介绍图](../../hardware/Battery-3S2P-5600mAh/5600mah-pack-dimensions.webp)标称 112 × 70 × 20mm，未含已验证的线材和插头包络。

> 后续结构更新：同日 [ADR-0016](0016-three-part-pla-enclosure.md) 将外壳收敛为三主体，替代下文旧后盖连接与分件方案；下文 45 对象检查记录属于当时电池适配版本，当前验证报告已随三主体模型更新。电池位置和 142 × 78 × 202 mm 外包络保持。

## 决策

电池沿 X/Y/Z = 112/70/20mm 平放在底部，居中于 X=0，位置 X=−56…56、Y=4…74、Z=8…28。前后各 3mm 壳壁加 70mm 电池、各 1mm 名义净距，要求机身深度 78mm；因此在 [ADR-0013](0013-speaker-envelope-enclosure.md) 的 142 × 74 × 202mm 外形基础上增深 4mm，宽度和高度不变。总高含脚垫 202mm、不含脚垫 199mm，均包含提手；既有前斜面、操控布局和喇叭包络不变。

底部采用 118 × 70 × 2mm 托盘，底面 Z=6，左右各 2mm 厚、12mm 高侧壁，距电池各 1mm。托盘以 X=0 对称，电池顶面距左右声腔底面 3.5mm。托盘目前提供支承和左右限位，尚未按实物确定压持、缓冲及引线出口，不据此宣称可靠固定。

为释放底部空间并保持总体高度：

- 光驱上移 14mm 至 Z=32…161，中心 Y=65.75，厚度方向 Y=61…70.5；导轨与两侧内壁各留 1mm。碟口随光驱后移 1.75mm，光盘扫掠距提手后面 22.15mm。
- 桥接器原 24 × 24 × 10mm 占位侧立为 X/Y/Z = 10/24/24mm，置于 X=−61…−51、Y=6…30、Z=124…148；功放托板增加左侧延伸和支承。连接方向、线长和弯折空间仍未验证。
- 主控及托板向前、向下各移 1mm，PCB 为 Y=31.56…59.5、Z=148.7…150.3，元件预留顶面 Z=157.3；避开抬高后的光驱，同时保留与显示安装座的净距。
- 后盖下固定座移至 X=±64，上固定耳前部收窄至 X=±54…±63，后部向侧壁延伸至 X=±68；阶梯形让位距光驱导轨 1mm；上孔横距 116mm、下孔横距 128mm，孔高仍为 Z=157/10。光驱后面距上固定耳 1mm。

外壳、提手、侧孔、声学结构和电池托盘按 X=0 对称。桥接器与 DAC 位于左侧是利用内部剩余空间的布局选择，不引入新的外壳不对称；原按钮和旋钮仍为既有操控例外。

## 验证与边界

[validation.json](../../hardware/enclosure/validation.json) 对保存后模型重新读取验证：45 个成品对象实体有效、两两无超过 0.001mm³ 的重叠；120 × 1.2 × 300mm 退碟扫掠、侧面通路、既有接头设计预留和提手检查通过；18 项镜像差集为零，5 组原生镜像关联有效。与适配前模型相比，8 项外部操控／显示组件无平移的几何差集为零。记录中的选定关键净距均不小于 1mm；支承接触面不属于净距要求。

[单份五页彩色图册](../../hardware/enclosure/drawings/Discora-V4-drawing-book-color.pdf)同步外形尺寸、上下固定孔、剖视、电池包络及两层爆炸图，保留双基准高度对照和合并页面。

本次只适配商品标称电池外包络。电池线材、接头、保护板出线、最终固定方式及外围充电／稳压模块仍不完整；名义余量需结合实物尺寸、打印误差和装配方式再确定。桥接器必须可通过合适软连接接入光驱，此条件尚未验证。没有改变供电拓扑、接线或固件，也不据此确认电池容量、电流、续航、热安全、打印可制造性或实际进退碟。
