miclle/discora/docs/records/2026-11-01-m2-otg-direct.md

# 2026-11-01：OTG 直连就绪故障与电脑对照

结论：用户已移除 Hub，使用 USB-C 公头 → USB-A 母口 OTG 转接头直连光驱，辅助供电开启。直连识别到桥接器和 UJ-898，但反复离线，未取得就绪或目录。**寻道、完整首轨、60 秒缓冲均未进入，不能判断 Hub 是否导致此前的寻道失败。**

后续使用同一个新 OTG 改接电脑，已取得目录和三段与既有参考一致的数据，40 秒采样中桥接器保持同一枚举实例。电脑路径为 High-Speed，不代表 ESP32-S3 Full-Speed 已通过；下一轮先检查电脑初始化后接回 MCU 的就绪。

## 设备与软件

- ESP32-S3，芯片 rev v0.2、8 MB PSRAM；COM 仅匹配 `1a86:55d3`、序列号 `5CF9109063`，未操作其它项目串口。
- 拓扑：ESP32-S3 native USB → 新 OTG 转接头 → 光驱主数据 USB-A；辅助供电保持开启，Hub 已移除。用户确认连接；转接头的实际型号及带载供电波形未测。
- 桥接器 `13fd:0840`，Full-Speed，接口 `08/02/50`，IN `0x81` / OUT `0x02`、MPS 64、LUN 0；INQUIRY 为 `MATSHITA` / `DVD-R   UJ-898` / `HC10`、PDT `0x05`。
- 沿用音乐 CD。此次未取得 TOC，未重新确认其曲目或内容。
- 实验应用 `0.5.0-audio-prep`，复用上一轮已完成 set-target / build 的 `otg-direct` 配置，实际产物 SHA-256 见下表。烧录前重新核对 manifest、配置和源码基线，没有修改固件源码或重新构建。
- ESP-IDF v5.4 (`67c1de1eeb`)、Xtensa GCC 14.2.0；音频诊断及欠载注入关闭，计划运行 12 位置寻道、完整首轨及 60 秒软件缓冲。没有 I²S 输出或写入介质命令。

## 备份、实验和恢复

先读取 Flash `0x0–0x110000`（1114112 字节），确认当前应用与已保存的默认关闭实验 `0.4.3-underrun-bench` 逐字节一致，分区表一致。此备份不是完整 16 MB Flash 备份。仅向 `0x10000` 更新应用，未写 bootloader、分区表或 NVS；写入校验成功。

| 窗口 | 结果 |
| --- | --- |
| 0.5.0 直连实验，UART 至启动后 43.041 秒 | 单次 MCU 启动，16 次光驱枚举、15 次 device closed；16 次 TUR 失败后 sense `06/29/00`，TUR 成功 0、有效 TOC 0、READ CD 0 |
| 恢复 0.4.3 后独立采集 25.160 秒 | 单次 MCU 启动，9 次枚举、8 次 device closed；9 次相同 sense，TUR 成功 0、有效 TOC 0、READ CD 0；明确 `CDDA probe enabled=0` |
| 用户确认光驱完整断电重接后，0.4.3 采集约 30 秒 | 单次 MCU 启动，10 次枚举、10 次 device closed，10 次相同 sense；有效 TOC 0、READ CD 0 |

实验轮连续枚举间隔为 2740–2870 ms。身份查询成功，但就绪前反复断开，未进入 READ CD 短探测，也没有进入扩展阶段。为避免无意义地等待 420 秒上限，主机主动中断实验采集，`finally` 恢复已保存的 0.4.3 应用并完成校验和 25 秒采集。脚本退出码 130 来自此次主动中断，不是烧录失败；实验采集没有正常生成时长元数据，因此只报告原始 UART 时间戳，不推造主机精确采集时长。

两轮启动均通过串口 RTS 操作，不是主控完整断电冷启动。恢复默认后仍有相同现象，说明本次离线发生在 READ CD 之前；不能归因于音频读取、判定 Hub 是唯一原因，或直接认定转接头、电源、桥接器中某一项损坏。`06/29/00` 的原始响应与反复重新枚举共同保留，根因尚未定位。用户收到保持连接不动的要求，但窗口内是否存在实际操作尚无独立反馈。

## 后续检查

用户已回复“已重新上电”，确认按要求将光驱主数据头与辅助供电头同时拔下，等待 5 秒，再接回直连和辅助供电并开启输出。确认后另采集约 30 秒，仍有 10 次枚举、10 次离线，未取得就绪或目录，未发送 READ CD。未显式追加 RTS 脉冲，但打开 UART 后日志仍包含 MCU 启动，不把该轮称为严格保持 MCU 不复位的光驱单独冷启动。当前不能进入寻道验收。

请求之后另开 UART 观察，未显式发送 RTS 复位脉冲，但原始日志包含一次 MCU 启动，不将该观察称为“主控未复位”。66.365 秒采集仍未取得 TOC，最后因串口 `Device not configured` 结束；随后相同 COM 身份重新出现。这段是否包含用户断电操作及其时间尚未确认，不能把其中的断连计入受控无操作故障统计。

下一项隔离是供电来源对照：已询问当前辅助供电型号/输出规格，以及是否有持续 5V 的 USB-A 电源适配器，暂未改接。此问题不等于已确认电源故障；带载电压、峰值电流、数据线和桥接器仍未独立排除。

### 用户补充：插入主数据头后反复启停

用户报告：光驱接 OTG 时“转一下停一下”；从 OTG 的 USB-A 母口拔掉光驱主数据头、保持辅助供电时，光驱反而能持续旋转。这是用户观察，未测量电压、电流或转速，也不等于持续读取正常。接入主数据头同时改变 USB VBUS/地的连接及主机通信，不能据此单独排除供电，或认定是固件主动停止电机。

核对当前默认探测路径：只发送身份/就绪/sense/目录查询，没有 START STOP UNIT；`device closed` 是处理 USB `DEV_GONE` 后释放 handle，不是定时主动断开。确认重接后的原始日志另有启动后 606 ms 的 `HUB: Root port reset failed`；这是 ESP-IDF 的 root-port 日志，不表示外部 Hub 仍在链路中，也不足以确定掉线根因。

已请求无需换电源或改固件的复位键对照：COM 与辅助供电保持连接，在光驱主数据头拔出时按住 RST/EN，再接回主数据头，观察约 10 秒；松开 RST 后再观察约 10 秒，分别记录是否启停。供应商原理图中 RST 接 CHIP_PU，5V VBUS 不是由该按键切断。本次不打开串口，避免串口控制信号影响这组观察。

用户随后明确反馈：按住 RST 和松开后的两个阶段光驱都没有转。该轮没有复现此前接入时反复启停的现象，也没有电压或总线记录；旋转与否不等于有电/无电或就绪/未就绪，不能将其判为已排除主控影响或已确认供电故障。随后恢复“拔掉插在 OTG 母口的 USB-A 插头、只留辅助供电”的基线，用户确认光驱持续转动，且充电宝指示灯亮或不亮时都转动。因此不把该指示灯作为输出开启/关闭的判据；这也不是带载读盘供电合格的证据。

该对照仅帮助区分物理连接即出现的现象和主控运行后出现的现象；即使后者才失败，也仍需区分初始化/桥接兼容性与运行时供电压降，不能据此确认某个根因。当前辅助电源型号/规格仍待补充，没有改接或新增焊接。

随后改为电脑对照：保留当前新 OTG 转接头、光驱和辅助供电，只将 OTG 的 Type-C 端由 ESP32-S3 native USB 移至电脑，COM 保持连接，不接 Hub。用户已确认“OTG 已接电脑”，但确认后的两次 IORegistry 检查均只有 COM `1a86:55d3`，未出现光驱桥接器 `13fd:0840`；`drutil list` 没有光驱条目，`drutil status` 无介质信息。没有取得目录或执行音频读取，不能将这次电脑对照记为成功。设备信息见本地 `pc-after-user-confirm.json`。

已请求在 OTG 的 Type-C 端保持接电脑的情况下，将光驱两个 USB-A 插头都拔下 5 秒，再先恢复辅助供电、开启输出，最后接回 OTG 数据口；如果 macOS 提示配件访问则允许。用户随后再次回复“OTG 已接电脑”，此次检查已出现桥接器和光驱。没有独立确认具体操作时序或是否出现系统提示，因此不把恢复归因于某一个动作。主机替换同时改变 USB 主机和 VBUS 条件，不能单独区分 MCU 协议与供电原因。

### 电脑端成功窗口

- IORegistry 实际取得 `13fd:0840`、480000000 bit/s、High-Speed，枚举实例 `4298335283`；`drutil` 为 UJ-898 / HC10，13 轨 CD-ROM。
- 40.281 秒按约 1 秒间隔采样，桥接器每次均存在，实例未改变。只说明采样窗口未观察到掉线/重枚举，不代替长时稳定验收。
- `drutil toc` 的 13 个 INDEX 01 位置及 lead-out 换算 LBA 后与此前完全一致，lead-out LBA 252645。
- 通过 macOS Audio CD 的 AIFF-C / `sowt` 接口读三个 8 扇区窗口，每段 18816 字节。均为 44.1 kHz、16-bit、stereo，申请 `F_NOCACHE` 成功；没有 USB/SCSI 抓包或排除光驱内部缓存，不等同于三条可逐条追溯的 READ CD 命令。
- 三段摘要均与此前同位置参考一致，没有保存 PCM，文件已关闭。耗时包含文件打开及解析，不直接称为机械寻道延迟。

| 位置 | 绝对 LBA | 字节数 | 本轮耗时 ms | SHA-256 |
| --- | --- | --- | --- | --- |
| 轨 1 / 相对 0 | 0 | 18816 | 780 | `c858b21ce4b78945461aee9c8afc83c58d75f20f0971d70b4407538abb3f8af6` |
| 轨 13 / 相对 150 | 223917 | 18816 | 395 | `d638921c166885d310b28e6f9457c706d7c20f6d95299df64d865f3f7af90e91` |
| 轨 1 / 相对 150 | 150 | 18816 | 479 | `077f4fd78614582d1ef63501e42329222724ffe230882aa765f561f51bf2ee80` |

此次表明新 OTG 能在电脑上建立数据连接，并读取先前 MCU 失败的两个位置；没有证明 MCU 连接条件下供电或协议合格。

### 电脑初始化后接回 MCU：默认查询成功

用户确认按要求只将 OTG 的 Type-C 端接回 ESP32-S3，两个 USB-A 插头及辅助供电保持不动。0.4.3 默认关闭 READ CD 配置取得有效 13 轨目录；一次桥接器枚举、零 device closed、4 次 TUR 成功、READ CD 数 0。最初两次 TUR 后分别收到 `06/29/00` 和 `06/28/00`，随后就绪，没有据此断言物理掉电。

主机采集 78.193 秒，前段光驱仍接电脑；MCU 日志在 47.346 秒枚举光驱、57.736 秒首次就绪、57.826 秒目录有效，最后一次成功 TUR 在 73.276 秒。不能将整个 78 秒都记为 MCU 已连接稳定窗口。此轮 RTS 复位在光驱仍接电脑时执行，不是独立断电冷启动。

该结果显示在本次电脑初始化后保留辅助供电的条件下，MCU 基础查询可以成功；没有证明此前反复离线的根因。接着另存一轮备份和日志，在相同供电连接下复用 0.5.0 直连实验镜像，短探测通过，但仍在末轨 LBA 223917 返回命令失败、REQUEST SENSE 超时，完整首轨和缓冲未进入。结束恢复默认关闭实验的 0.4.3，5 次 TUR 成功。详见 [后续直连记录](2026-11-01-m2-otg-after-pc.md)。首次直连失败日志继续保留，不覆盖。

此前 0.4.2 的 600 秒顺序读取、105840000 字节与电脑摘要一致仍是独立历史结果，见 [长时记录](2026-10-31-m2-stream.md)。本次没有覆盖或扩大该结论。

## 原始证据

本地忽略目录 `.local/bench/2026-11-01-m2-otg-direct/` 保存原始 UART、备份、烧录日志、配置、源码及镜像。没有保存音乐 PCM。未执行提交或推送，已有 README / CAD 修改保留。

| 文件 | SHA-256 |
| --- | --- |
| `direct.log` | `2f2a2ac7e0395b754edef27ac8711fa7e8f5ecc7ebf0b29e7a210c876002622b` |
| `final-default.log` | `eb6e286441804df2539b6dc11a724782dfb480dbf28079850956b58e0a30a5d9` |
| `confirmed-powercycle.log` | `4f67d9b35459945b8ef5c08606e7bdbec1809b154b5d6636fd3c8ff929c35665` |
| `direct-build/discora.bin` | `0d14a381bb58050e997d31a96eb56cf08ebfd076030bdeb67a69dd61630fae47` |
| `restore-build/discora.bin` | `b1878225b49fdf2c07816343b0159f714d5fee29902b9b39337e9b6b340a5c7e` |
