miclle/discora/docs/records/2026-10-31-m1-empty-hub.md

# 2026-10-31：USB-OTG 桥接后的空 Hub 枚举

结论：**空 Hub 在 ESP32-S3 上成功以 Full-Speed 枚举（bench-tested）。** 尚未接回光驱和辅助供电，未执行光驱 INQUIRY、TUR 或 sense。

## 条件与证据

- 用户按前述桥接步骤复测，报告 `USB-OTG` 焊盘 A、B 对 GND 均为 **4.83 V**，当时只连接 COM，USB 口没有其它连接。焊盘电压为用户测量，不是自动采集。
- 仅打开 Discora 的目标 COM（USB Single Serial），没有打开其它项目的原生 USB 串口。串口采集代码未主动发出复位脉冲；打开端口后捕获到一次启动日志，不能据此把它记作真实断电冷启动。
- 用户随后确认空 Hub 上行已接到开发板 USB；Hub 下游全部拔空，光驱与充电宝断开。
- 固件仍为 v5.4 / `61b8229-dirty`，ELF SHA-256 `2a1a3d89bba7655f05edd8c508119a9fbad5a57394fd5a78b3096d44f2bfcb90`，没有为本次实验重新烧录或修改代码。

## 真实串口摘录

```text
I (15265) usb_probe: USB address=1 VID:PID=05e3:0610 speed=Full-Speed config=1 device_class=0x09
I (15265) usb_probe: interface=0 alt=0 class=0x09 subclass=0x00 protocol=0x00
W (15275) usb_probe: no supported Full-Speed BOT interface (hub/UAS/other/malformed); skipped
I (15275) usb_probe: device closed; free internal heap=369092
```

class `0x09` 是 Hub。M1 的 BOT client 跳过 Hub 接口是预期行为，不代表 Hub 枚举失败；底层 IDF Hub 驱动处理下游端口。日志中的 device closed 是探测 client 释放自身打开的 Hub handle，不是让 Hub 断电。

整个串口采集窗口为 180 秒，未观察到 panic、abort、brownout 或第二次启动记录。这不是长时稳定性、下游设备兼容性或带载供电验收。

原始日志当时存放于被忽略的 `firmware/build/bench-2026-10-31-9k2eyvtm/uart-empty-hub-195934.log`，3,813 字节，SHA-256 为 `d60c04c5897352d93e6bea43560072c785189123c5271290eda7c4a2b2f0d9dd`。首次未枚举记录继续保留在 [首次上板记录](2026-10-31-m1-first-boot.md)，不能用本次成功覆盖此前失败条件。

## 下一步

光驱适配器为双 USB-A 分叉供电线。接回充电宝前，先在完全断电状态确认两插头 5V 是否直连、是否存在隔离；USB-OTG 桥接改变了 VBUS 与板上 5V 的连接关系。不要把空 Hub 枚举成功当作批准未知双电源并联的依据。

供电路径确认后，再接光驱进行真实 BOT / INQUIRY / 介质查询；尚未开始 M2 CD-DA。

## 后续供电路径观察与实验范围调整

USB-A 触点不便测量，后续改用已桥接的 USB-OTG 焊盘观察。按指导拔下电脑 COM，仅保留开发板 USB→Hub、光驱数据→Hub、光驱辅助供电→充电宝；用户报告焊盘对 GND 为 **0 V**。这只说明该次状态下没有测得回送至开发板的电压，不能区分线材隔离、Hub 电源开关、充电宝输出状态等原因，也不能作为两路电源完全隔离的证明。

用户提供适配器商品链接 `https://item.taobao.com/item.htm?id=658676383469&skuId=4745196312366`；当前工具未能读取商品详情，浏览器站点安全策略阻止访问，未采用商品规格作为供电隔离证据。

用户随后明确选择暂缓线材内部测量，先按现有接法推进实际只读光驱探测。本轮不再把隔离确认作为开始查询的前置阻塞；供电隔离仍记录为未验证项，不以“通用供电线”替代证据。恢复 COM 后仅运行已部署的 INQUIRY / TUR / REQUEST SENSE；出现 brownout、panic 或反复重启时停止实验并断开测试电源。后续实际返回值另行记录，不预填光驱识别成功。

## 原始证据可用性更正（2026-10-31）

推进 M2 时，执行 `idf.py set-target esp32s3` 触发 fullclean，误删了放在 `firmware/build/` 内的 M1 原始串口/构建日志、统计文件及首次烧录前的备份。本文原有摘录、统计及校验值仍保留，但**不能再据原始文件复核这些历史窗口**；首次烧录前的原固件已无可用备份，不能声称仍可恢复。后续从设备重新读取的 M1 Flash 备份只用于回退到 Discora M1，不是首次烧录前固件的恢复。M1 应用从 Flash 提取后与本文历史 bin SHA-256 一致；原 M1 ELF 未恢复。

新的原始采集、烧录前备份、构建产物快照均放在被 Git 忽略的 `.local/bench/`，不再存放于会被构建清理的目录。详见 [M2 TOC 记录](2026-10-31-m2-toc.md)。
