miclle/discora/docs/records/2026-10-31-m1-offline.md

# 2026-10-31：M1 离线固件验证

## 适用范围

本轮交付为 M1 只读查询源码、离线测试及组装文档。工作区基线是 `61b8229`，本轮代码尚未提交，不能用该提交号独自标识本轮实现。下面记录具体源码和产物 SHA-256。

未连接或烧录 Discora 设备；已连接的其它项目串口没有被打开、复位或烧录。用户已有 ESP32-S3、UJ-898、Type-C Hub 和电源，但具体板卡、Hub、桥接器型号未确认。设备 VID:PID、光驱固件、介质、供电读数均为**未测**。

## 构建环境和结果

| 项目 | 记录 |
| --- | --- |
| 主机 | macOS arm64 |
| ESP-IDF | 官方 tag `v5.4`，commit `67c1de1eeb`；独立环境，不切换已有 v5.5.1 checkout |
| Python | 3.9.6；独立 v5.4 虚拟环境 |
| 编译器 | Xtensa GCC 14.2.0，`esp-14.2.0_20241119` |
| 目标 | esp32s3 |
| 配置 | UART0，secondary console none，main stack 6144，Hub / multi-level enabled；其余为 IDF 默认值 |
| 命令 | `idf.py set-target esp32s3 && idf.py build`，最后源码变更后再次 `idf.py build` |
| 结果 | 通过；应用 277,008 字节（`0x43a10`），app 分区 1,048,576 字节，约 74% 空闲 |
| 构建日志 | 本地 `firmware/build/m1-build.log`，不提交含主机路径的原始日志 |

环境准备遇到 Python 3.9 标准库 metadata 对新版 `ruamel.yaml` / `ruamel.yaml.clib` 包名识别不兼容。安装工具依赖时在该独立环境使用 `ruamel.yaml==0.17.40`、`ruamel.yaml.clib==0.2.8` 后依赖检查通过；未更改项目 SDK 基线或第三方组件依赖。旧 SDK 的 CMake 兼容性弃用提示不影响本次构建。

## 主机侧协议测试

运行 `python3 firmware/tests/run_host_tests.py`，以 C11、`-Wall -Wextra -Werror -pedantic` 和 AddressSanitizer / UndefinedBehaviorSanitizer 直接编译 `probe_protocol.c`。

结果：通过。覆盖 CBW 精确字节布局、SCSI/ATAPI 查询长度、无任意命令入口、描述符截断与错误长度、接口/端点筛选、CSW 长度/signature/tag/status/residue、标准 INQUIRY、固定与描述符 sense，以及 10,000 组按真实输入长度分配的异常字节缓冲。

测试输入是合成 fixtures，不是 UJ-898 响应，不是 CD-DA 或刻录日志。未测试原生 Host 调度、真实 USB STALL、传输截止/取消、断连恢复、Hub 或电源。

## SHA-256 快照

路径相对于 `firmware/`。重新构建的时间、工具环境、路径等可影响二进制，校验值用于识别本次产物，不承诺不同机器逐字节可重现。

| 路径 | SHA-256 |
| --- | --- |
| `main/main.c` | `9760c76909e37482a4faaa3fcf4c6a34bf13bd32dba9aff0468fbb22fc0f5aac` |
| `main/usb_probe.c` | `bb41898919fc7d68fe891151ed1b37323bd5d8f1a0ddc9a1d824070b2d76073f` |
| `main/usb_probe.h` | `ad4d0539894ac73e2b4f903196370ee2e71762361657469fa7ba55a3d558e8f7` |
| `main/probe_protocol.c` | `5b7b56270d29c02223d216d57f822d4ed8074e4fa655d420b158b2b2b05a2000` |
| `main/probe_protocol.h` | `82d3e21dbd904df4d9489d9683e12629904b07035ab9ac88e083913b4c17f49a` |
| `main/CMakeLists.txt` | `b26bfbbe61c9b1d0e1f7a5a345f98f2c5c6882d5cb7c762654a1948dc324d9cd` |
| `CMakeLists.txt` | `c2d8ea19549774436e8796e12f3d62f6e364d3369d9a38ed61cf491bdfb65671` |
| `sdkconfig.defaults` | `036df143f1a7ee65c4bfdbac1d5e60e770a15e00287d7bd39b84b402d2722480` |
| `build/discora.bin` | `f9a7f0efa33ade4ec661927009ecf0d50a1973b82e49f87ac7070c6788648a38` |
| `build/discora.elf` | `2a1a3d89bba7655f05edd8c508119a9fbad5a57394fd5a78b3096d44f2bfcb90` |

固件启动会打印应用版本与 ELF SHA-256，便于后续把真实串口日志关联到本次构建。

## 下一轮实机验收

按 [组装说明](../assembly.md) 和 [M1 验证矩阵](../validation.md) 执行。先确认独立 UART0 和 VBUS，再依次检查空载启动、无盘身份/真实 sense、Audio CD 就绪、至少 10 次插拔、至少 5 次冷启动。未能触发的故障路径保留“未测试”，不得填为通过。

## 原始证据可用性更正（2026-10-31）

推进 M2 时，执行 `idf.py set-target esp32s3` 触发 fullclean，误删了放在 `firmware/build/` 内的 M1 原始串口/构建日志、统计文件及首次烧录前的备份。本文原有摘录、统计及校验值仍保留，但**不能再据原始文件复核这些历史窗口**；首次烧录前的原固件已无可用备份，不能声称仍可恢复。后续从设备重新读取的 M1 Flash 备份只用于回退到 Discora M1，不是首次烧录前固件的恢复。M1 应用从 Flash 提取后与本文历史 bin SHA-256 一致；原 M1 ELF 未恢复。

新的原始采集、烧录前备份、构建产物快照均放在被 Git 忽略的 `.local/bench/`，不再存放于会被构建清理的目录。详见 [M2 TOC 记录](2026-10-31-m2-toc.md)。
