miclle/discora/hardware/enclosure/drawings/Discora-V4-drawing-book-color.pdf

# DISCORA 整机外观尺寸

## V4 / 01 彩色版

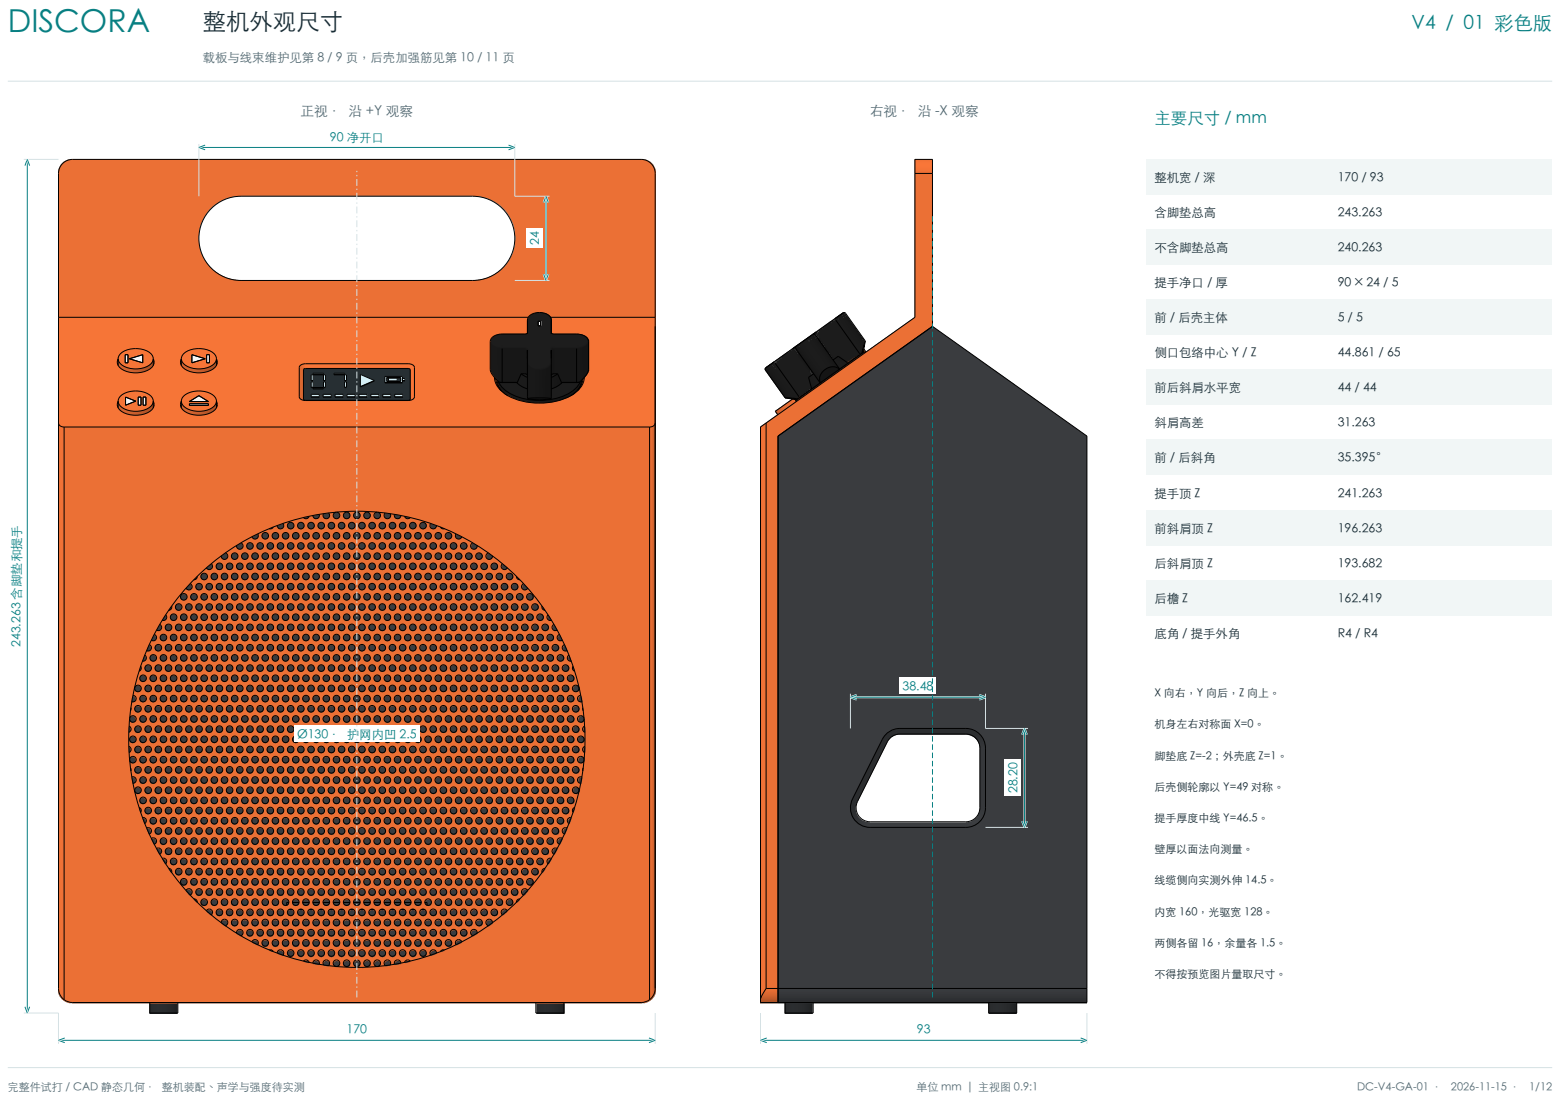
[picture p17: page 1]
载板与线束维护见第 8 / 9 页，后壳加强筋见第 10 / 11 页; 完整件试打 / CAD 静态几何 · 整机装配、声学与强度待实测; 单位 mm | 主视图 0.9:1; 243.263 含脚垫和提手; 90 净开口; Ø130 · 护网内凹 2.5; 主要尺寸 / mm; 整机宽 / 深; 含脚垫总高; 不含脚垫总高; 提手净口 / 厚; 前 / 后壳主体; 侧口包络中心 Y / Z; 前后斜肩水平宽; 斜肩高差; 前 / 后斜角; 提手顶 Z; 前斜肩顶 Z; 后斜肩顶 Z; 底角 / 提手外角; 机身左右对称面 X=0。; 脚垫底 Z=-2；外壳底 Z=1。; 后壳侧轮廓以 Y=49 对称。; 提手厚度中线 Y=46.5。; 壁厚以面法向测量。; 线缆侧向实测外伸 14.5。; 内宽 160，光驱宽 128。; 两侧各留 16，余量各 1.5。; 不得按预览图片量取尺寸。

# DISCORA 顶面、背面与操控开孔

## V4 / 02 彩色版

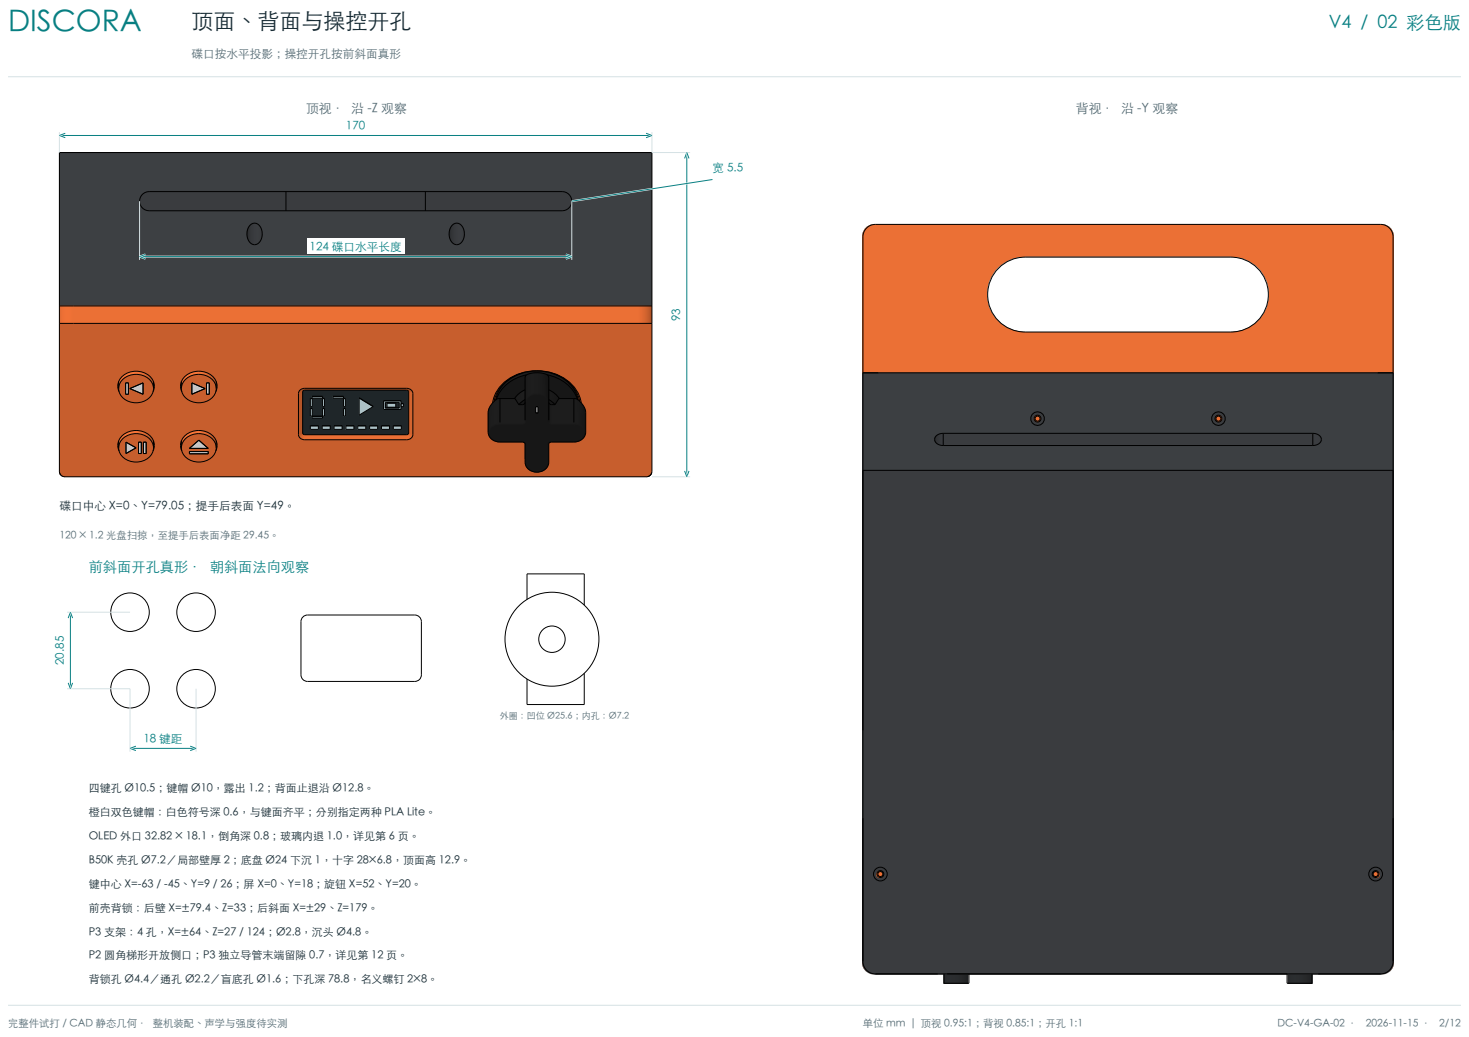
[picture p18: page 2]
碟口按水平投影；操控开孔按前斜面真形; 完整件试打 / CAD 静态几何 · 整机装配、声学与强度待实测; 124 碟口水平长度; 碟口中心 X=0、Y=79.05；提手后表面 Y=49。; 120 × 1.2 光盘扫掠，至提手后表面净距 29.45。; 前斜面开孔真形 · 朝斜面法向观察; 键中心 X=-63 / -45、Y=9 / 26；屏 X=0、Y=18；旋钮 X=52、Y=20。

四键孔 Ø10.5；键帽 Ø10，露出 1.2；背面止退沿 Ø12.8。

橙白双色键帽：白色符号深 0.6，与键面齐平；分别指定两种 PLA Lite。

OLED 外口 32.82 × 18.1，倒角深 0.8；玻璃内退 1.0，详见第 6 页。

B50K 壳孔 Ø7.2／局部壁厚 2；底盘 Ø24 下沉 1，十字 28×6.8，顶面高 12.9。

前壳背锁：后壁 X=±79.4、Z=33；后斜面 X=±29、Z=179。

P2 圆角梯形开放侧口；P3 独立导管末端留隙 0.7，详见第 12 页。

背锁孔 Ø4.4／通孔 Ø2.2／盲底孔 Ø1.6；下孔深 78.8，名义螺钉 2×8。

# DISCORA 整机爆炸图 / 外壳与内部

## V4 / 03 彩色版

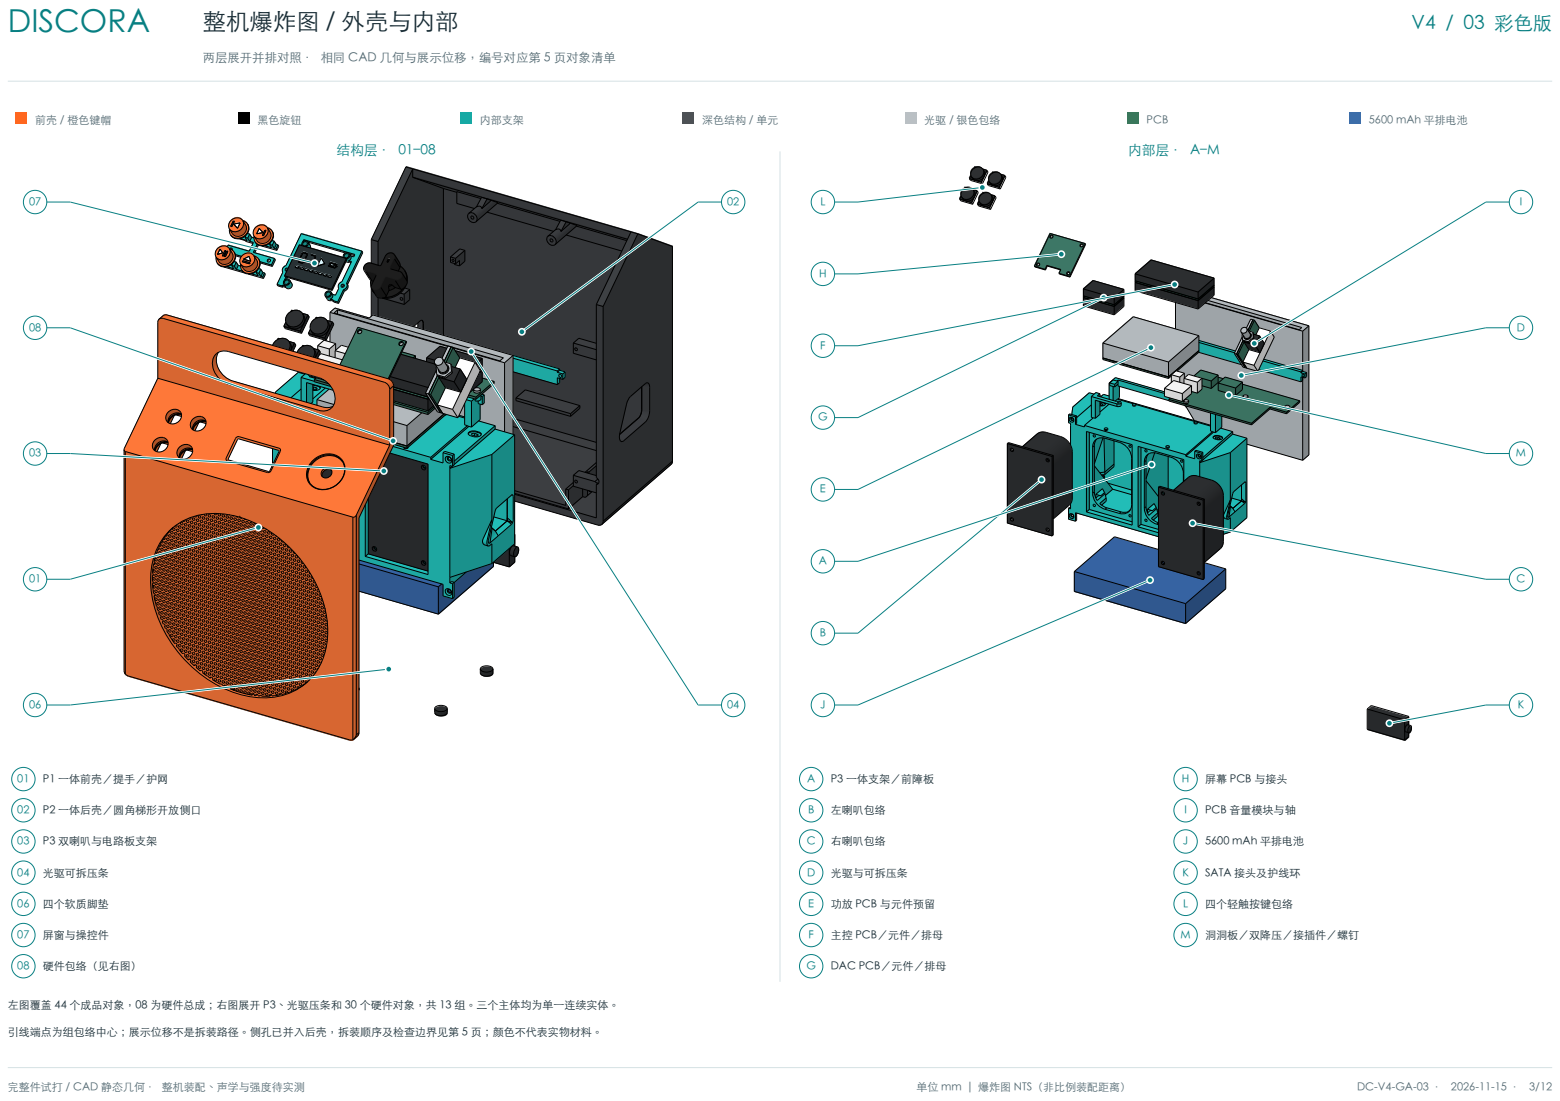
[picture p19: page 3]
完整件试打 / CAD 静态几何 · 整机装配、声学与强度待实测; 单位 mm | 爆炸图 NTS（非比例装配距离）; 前壳 / 橙色键帽; 黑色旋钮; 内部支架; 深色结构 / 单元; 光驱 / 银色包络; PCB; 5600 mAh 平排电池; 结构层 · 01–08; P1 一体前壳／提手／护网; P2 一体后壳／圆角梯形开放侧口; P3 双喇叭与电路板支架; 光驱可拆压条; 四个软质脚垫; 屏窗与操控件; 硬件包络（见右图）; 内部层 · A–M; P3 一体支架／前障板; 左喇叭包络; 右喇叭包络; 光驱与可拆压条; 功放 PCB 与元件预留; 主控 PCB／元件／排母; DAC PCB／元件／排母; 屏幕 PCB 与接头; PCB 音量模块与轴; SATA 接头及护线环; 四个轻触按键包络; 洞洞板／双降压／接插件／螺钉

两层展开并排对照 · 相同 CAD 几何与展示位移，编号对应第 5 页对象清单

左图覆盖 44 个成品对象，08 为硬件总成；右图展开 P3、光驱压条和 30 个硬件对象，共 13 组。三个主体均为单一连续实体。

引线端点为组包络中心；展示位移不是拆装路径。侧孔已并入后壳，拆装顺序及检查边界见第 5 页；颜色不代表实物材料。

# DISCORA 侧剖与内部空间

## V4 / 04 彩色版

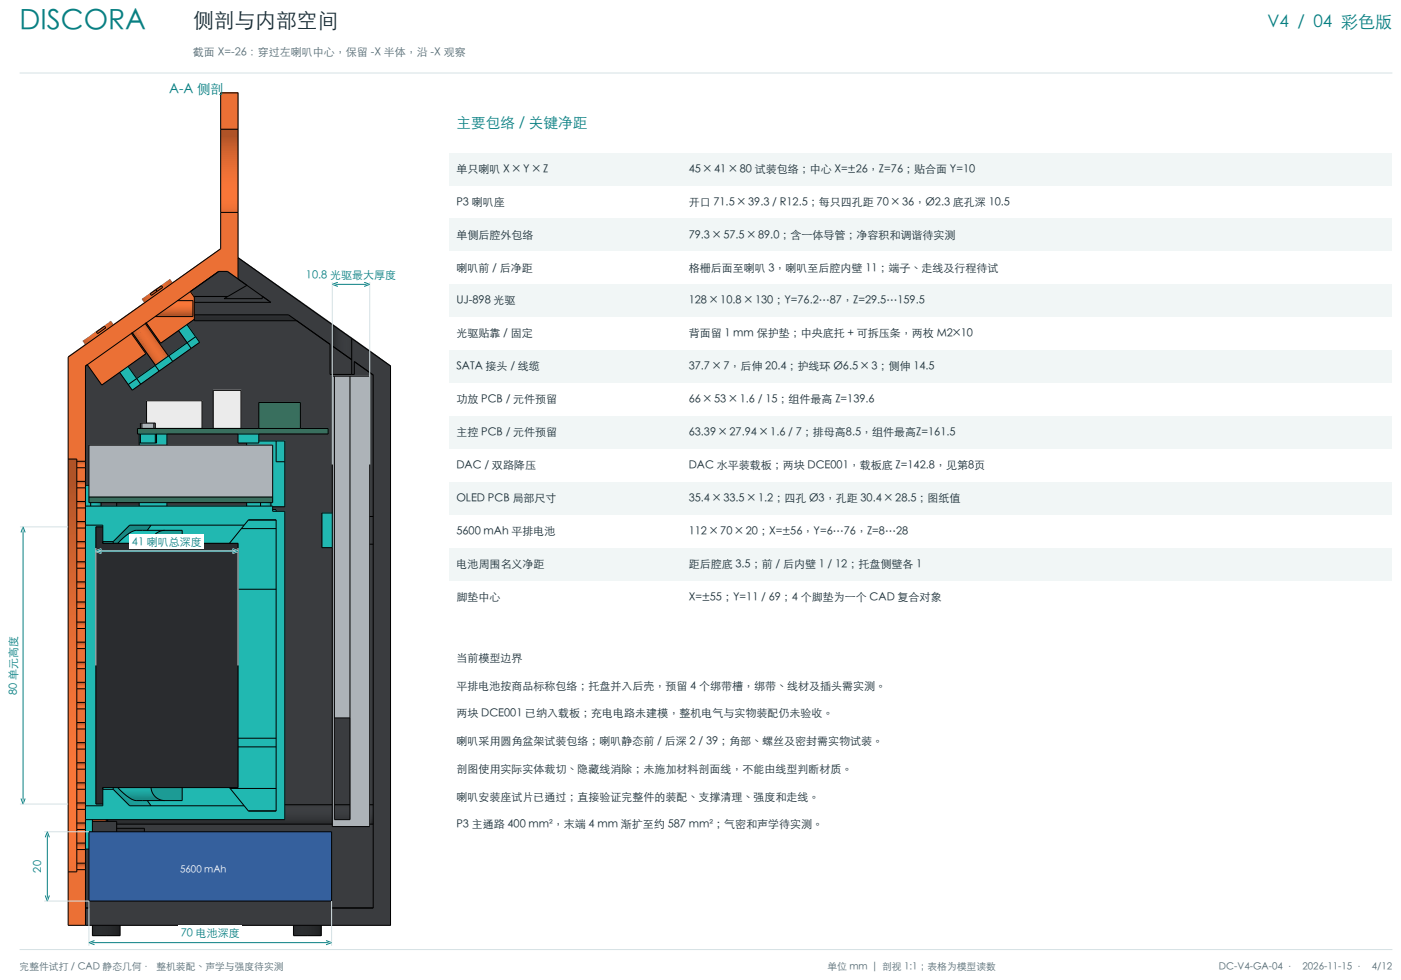
[picture p20: page 4]
完整件试打 / CAD 静态几何 · 整机装配、声学与强度待实测; 单位 mm | 剖视 1:1；表格为模型读数; 41 喇叭总深度; 10.8 光驱最大厚度; 元高度; 70 电池深度; 5600 mAh; 主要包络 / 关键净距; 单只喇叭 X × Y × Z; 45 × 41 × 80 试装包络；中心 X=±26，Z=76；贴合面 Y=10; P3 喇叭座; 开口 71.5 × 39.3 / R12.5；每只四孔距 70 × 36，Ø2.3 底孔深 10.5; 单侧后腔外包络; 79.3 × 57.5 × 89.0；含一体导管；净容积和调谐待实测; 喇叭前 / 后净距; 格栅后面至喇叭 3，喇叭至后腔内壁 11；端子、走线及行程待试; 光驱贴靠 / 固定; 背面留 1 mm 保护垫；中央底托 + 可拆压条，两枚 M2×10; SATA 接头 / 线缆; 37.7 × 7，后伸 20.4；护线环 Ø6.5 × 3；侧伸 14.5; 功放 PCB / 元件预留; 66 × 53 × 1.6 / 15；组件最高 Z=139.6; 主控 PCB / 元件预留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

截面 X=-26：穿过左喇叭中心，保留 -X 半体，沿 -X 观察

平排电池按商品标称包络；托盘并入后壳，预留 4 个绑带槽，绑带、线材及插头需实测。

两块 DCE001 已纳入载板；充电电路未建模，整机电气与实物装配仍未验收。

喇叭采用圆角盆架试装包络；喇叭静态前 / 后深 2 / 39；角部、螺丝及密封需实物试装。

剖图使用实际实体裁切、隐藏线消除；未施加材料剖面线，不能由线型判断材质。

喇叭安装座试片已通过；直接验证完整件的装配、支撑清理、强度和走线。

P3 主通路 400 mm²，末端 4 mm 渐扩至约 587 mm²；气密和声学待实测。

# DISCORA 对象清单、打印与拆装

44 个成品对象 · 尺寸为装配坐标系 X × Y × Z 的轴对齐包络，非展开尺寸

## V4 / 05 彩色版

完整件试打 / CAD 静态几何 · 整机装配、声学与强度待实测 | 单位 mm | 清单尺寸 mm；无制造数量承诺 | DC-V4-GA-05 · 2026-11-15 · 5/12
图号 · 对象 ID / 名称 | X × Y × Z

01 FrontShell
P1 前壳 / 提手 / 格栅 / 屏幕座 | 170 × 49 × 240.26
02 RearShell
P2 一体后壳 / 碟口 / 开放侧口 / 底架 | 170 × 88 × 192.68
06 Feet
脚垫复合件（4 个） | 118 × 66 × 3
07 Window
OLED 玻璃面板 | 34.5 × 19.56 × 14.46
07 StatusArt
显示内容示意 | 26.7 × 9.5 × 6.81
07 PlayPauseKey
播放／暂停键帽 | 12.8 × 13.46 × 12.47
07 EjectKey
退碟键帽 | 12.8 × 13.46 × 12.47
07 PrevKey
上一曲键帽 | 12.8 × 13.46 × 12.47
07 NextKey
下一曲键帽 | 12.8 × 13.46 × 12.47
07 ButtonRetainer
四键焊线支架（两侧敞开／双点支承） | 34 × 23.21 × 19.12
07 Knob
音量旋钮 · 黑白双色 | 28.56 × 29.94 × 26.34
07 DisplayRetainer
OLED 可拆压框（四点承压／两侧锁紧） | 47 × 33.55 × 23.5
D DriveRetainer
光驱可拆压条（两枚名义 M2×10） | 136 × 3 × 10
A SpeakerCarrier
P3 双声腔 / 前障板 / 电子托架 | 158.6 × 57.5 × 119.8
B LDriver
左喇叭总包络 | 45 × 41 × 80
C RDriver
右喇叭总包络 | 45 × 41 × 80
L PlayPauseSwitch
播放／暂停开关包络 | 12 × 13.26 × 11.84
L EjectSwitch
退碟开关包络 | 12 × 13.26 × 11.84
L PrevSwitch
上一曲开关包络 | 12 × 13.26 × 11.84
L NextSwitch
下一曲开关包络 | 12 × 13.26 × 11.84
I Encoder
B50K 轴／六角螺母 | 11.32 × 13.89 × 15.88
I VolumePot
B50K PCB 插接模块 / 含插头包络 | 15 × 43.71 × 41.63
图号 · 对象 ID / 名称 | X × Y × Z

D Drive
UJ-898 包络 | 128 × 10.8 × 130
K Bridge
SATA 接头 / 护线环 | 40.7 × 7 × 20.4
H DisplayPCB
OLED PCB／四孔与缺口 | 35.4 × 28 × 20.38
H DisplayHeader
OLED 弯针接头预留 | 10.16 × 7.11 × 8.56
E Amp
功放 PCB | 66 × 53 × 1.6
E AmpChip
功放元件预留 | 66 × 53 × 15
M Perfboard
洞洞板／右前缺口／左侧延伸 | 111 × 55 × 1.6
F MCU
主控 PCB | 63.39 × 27.94 × 1.6
F MCUChip
主控元件预留 | 63.39 × 27.94 × 7
F MCUSockets
主控排母高度包络 | 63.39 × 27.94 × 8.5
G DAC
DAC PCB | 31 × 17 × 1.6
G DACChip
DAC 元件预留 | 31 × 17 × 7
G DACSockets
DAC 排母高度包络 | 31 × 17 × 8.5
M BuckA
DCE001 A／主控5Vin | 17.5 × 12 × 7.5
M BuckB
DCE001 B／光驱及桥接器VBUS | 17.5 × 12 × 7.5
M XHButtons
四键5芯侧插包络 | 18 × 16 × 8
M XHOLED
OLED 4芯直插包络 | 13.5 × 8 × 11
M XHVolumeSwitch
音量开关2芯直插包络 | 8.5 × 8 × 11
M PerfboardScrew1
M2×4／G(2)-A | 4.3 × 4.3 × 5.55
M PerfboardScrew2
M2×4／Q-N | 4.3 × 4.3 × 5.55
M PerfboardScrew3
M2×4／A-O | 4.3 × 4.3 × 5.55
J Battery
5600 mAh 平排电池 | 112 × 70 × 20

### PLA 打印：3 主体 + 4 键帽 + 焊线支架 + 旋钮 + OLED 压框 + 光驱压条 = 11 件

P2SC / P2S配置 · 0.4喷嘴 / 0.20层高 / 3壁 / 15%填充 / 树状支撑；P3 双声腔背面直接贴板

P1 前壳 · 正面朝下 / 板内转 90° · 打印包络 240.26 × 170 × 49 mm · 切片估重 156.7 g（含支撑）

P2 后壳 · 背面朝下 · 打印包络 170 × 192.68 × 88 mm · 切片估重 286.8 g（含支撑）

P3 支架 · 声腔背面朝下 · 打印包络 158.6 × 119.8 × 57.5 mm · 切片估重 181.0 g（含支撑）

前壳：断电卸4枚背锁螺钉，托住并前移60；按开关、OLED、四键次序拔线后移走，见第9页。

光驱维护：拆 P3、两螺钉压条和电池；先前移 12，再前移 3 并抬高 9.5，进入接头拆卸位置。

SATA 向下脱离、向内取出；光驱再前移 13，侧转 -30°并同步前移 20，最后抽出；安装逆序。

光驱最大包络：抬升 31 姿态、侧转 61 姿态；前壳按 1 mm 抽样，其余直线段连续保守扫掠，实物未验收。

四键双色：0.4 喷嘴 / 0.12 层高；白色 0.6 深；使用双色 3MF。实际色彩、配合与按压行程待测。

音量模块：绕轴转 90°；拆卸先取下整个前壳，再拆旋钮和螺母，按第 7 页退出；旋钮保持原黑白双色 3MF。

FCStd SHA-256: 2d704f403a48870832338c8d0ac6c0f71b357f08b3bdcb7c0f777cb0e19f9003 | 来源：Discora.FCStd / build.FCMacro / drawings/geometry.json

# DISCORA OLED 沉槽与可拆压框

依据供应商结构图；玻璃面向外移 4.4；沉槽、倒角与压框来自保存 CAD；有效区虚线标注

## V4 / 06 彩色版

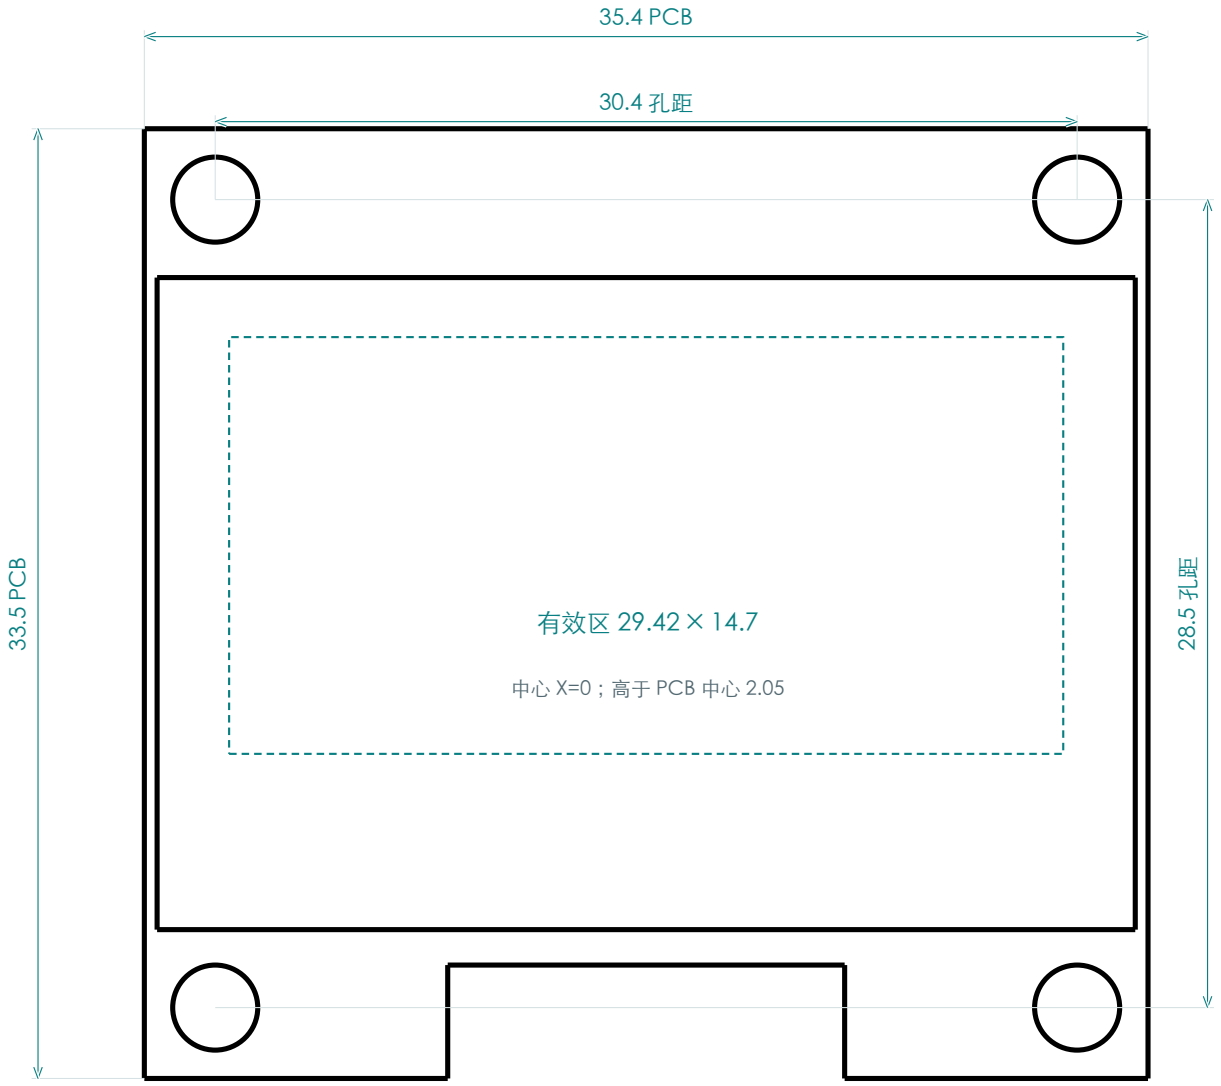
[picture p21: figure]
35.4 PCB; 33.5 PCB; 有效区 29.42 × 14.7; 中心 X=0；高于 PCB 中心 2.05

完整件试打 / CAD 静态几何 · 整机装配、声学与强度待实测 | 单位 mm | 模组正视 4:1；安装中剖 3:1 | DC-V4-GA-06 · 2026-11-15 · 6/12

### 模组正面 · 排针朝斜面上方

4 × Ø3 通孔；铜环外径图示 Ø4.5；底部缺口 14 × 4。

有效区距 PCB 左边 2.99、顶边 7.35；玻璃距左边 0.45、顶边 5.25。

### 安装中剖（局部）

11.3 图纸总深度

玻璃面距外斜面 1.0

玻璃 1.4 / PCB 1.2

外口 / 内喉口 | 32.82×18.1 / 30.42×15.7
倒角 / 前缘厚度 | 深0.8；圆角R1.8→R0.6
外斜面基准 | X=0，Y=18，Z=177.789
玻璃前面 / PCB 前面 | 法向向内 1.0 / 2.4
PCB 背面 / 针尖 | 法向向内 3.6 / 12.3
四孔定位柱 | Ø2.6；PCB 孔 Ø3
可拆压框 | 四点承压；背梁深6.4…8.4
压框双侧固定 | X=±20.5、局部Z=-7
盲孔 / 名义螺钉 | Ø1.6深4.4 / 2枚M2×6
针尖后的插线预留 | 12.16 × 6 × 4.54
工具通路预留 | Ø4 × 20；两处无交叠

深度从外斜面沿内法向量取。

玻璃与前缘间隙0.2；PCB 孔周四点承压。

按第9页先拉开、拔线并卸前壳；取下压框，

再沿内法向取出模组；两步均按0.5采样。

尺寸来源：oled-module-dimensions-wiring.webp。沉槽、倒角、定位柱和压框为外壳设计值。

接头塑壳截面、插线和工具包络是设计预留；线材弯折、实际螺钉、打印孔补偿及装配配合仍须实测。

Window 表示 OLED 自带玻璃面板；本版没有另设透明保护窗片。正前方及选定斜视方向无遮挡；不代表面板光学、密封或实物验收。

# DISCORA PCB 音量模块与安装槽

用户确认板尺寸及插接总厚度；插头 / 引脚为保守包络，未做实物验收

## V4 / 07 彩色版

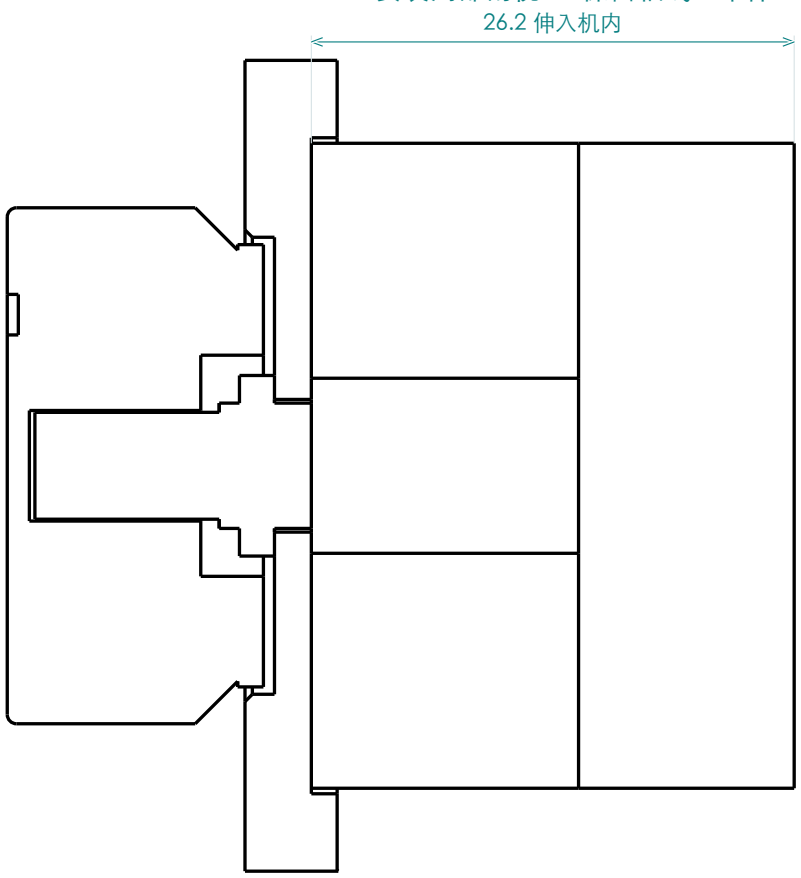
[picture p22: figure]
26.2 伸入机内

完整件试打 / CAD 静态几何 · 整机装配、声学与强度待实测 | 单位 mm | 板面投影 3:1；安装剖视 2.6:1 | DC-V4-GA-07 · 2026-11-15 · 7/12

### 板面投影 · 转向前的尺寸基准

35 PCB 宽

26.2 沿

轴深度

板厚 1.5；轴线沿板宽居中；前边与安装面齐平

### 安装局部剖视 · 保留轴线左半体

PCB 宽 / 深 / 板厚 | 35 / 26.2 / 1.5
完整插接总厚度 | 15，已含引脚及插好的插头
组件安装朝向 | 绕轴 90°，板宽沿斜面上下展开
局部包络 X / Y / Z | 15 / 26.2 / 35
内槽 X / Y / Z | 15.6 / 26.5 / 35.6
夹持面 / 内槽底厚 | 2 / 3.6；横向与后端余量0.3
轴总长 / 花轴长 | 15 / 10；轴径与螺纹沿用名义值
完整包络至支架 | 19.757
至主控元件预留 | 6.210
至后壳 | 10.970
至光驱 | 25.291
至洞洞板 | 5.264；十字28，轴心X52/Y20

拆卸：按第9页拉开60并断开前壳线束，取下整个前壳；再拆旋钮、螺母，沿轴退出模块。

安装：先锁螺母，再按实物关断止挡对准指示条并压入旋钮；插拔线束时托住 PCB。

原主体、轴径、齿形、螺纹和 PCB 相对轴的高度仍为名义假设；模拟音量线束与开关额定值待确认。

# DISCORA 洞洞板板形、布局与固定

从保存 CAD 读取 · 顶视沿 -Z；上方为机身后方 +Y，右方为 +X

## V4 / 08 彩色版

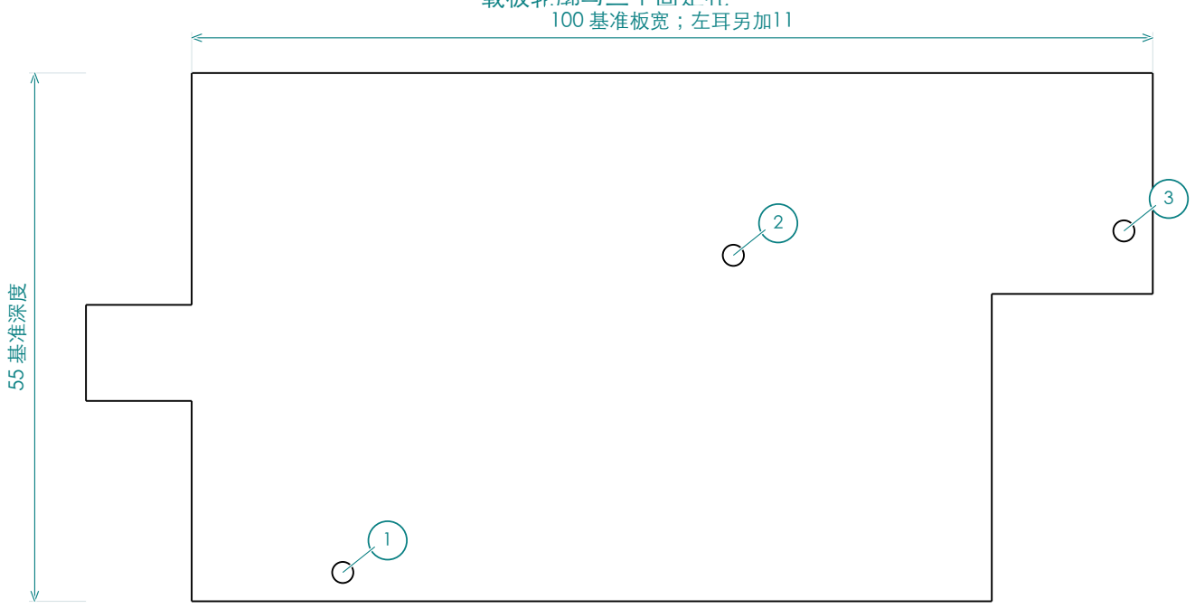
[picture p23: figure]
100 基准板宽；左耳另加11; 55 基准深度
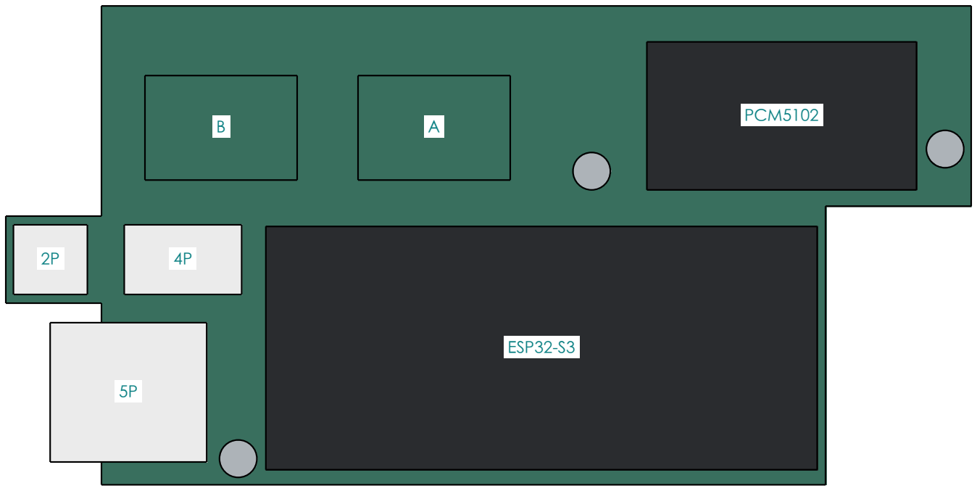
[picture p24: figure]
ESP32-S3; PCM5102

完整件试打 / CAD 静态几何 · 整机装配、声学与强度待实测 | 单位 mm | 板形与布局 1.5:1 | DC-V4-GA-08 · 2026-11-15 · 8/12

### 载板轮廓与三个固定孔

### 装配布局 · 接插件为插合包络

载板底面 / 厚度 | Z=142.8 / 1.6
右前避让缺口 | X40.25…57，Y20…52；16.75×32
左侧延伸耳 | X-54…-43，Y40.86…50.86；11×10
1 · G(2) / A | X=-27.28，Y=23.00
2 · Q / N | X=13.36，Y=56.02
3 · A / O | X=54.00，Y=58.56
固定孔与螺钉 | 板Ø2.2／托架导孔Ø1.6；3枚M2×4
排母 / 模块PCB / 元件 | 8.5 / 1.6 / 7；顶部Z=161.5
双路 DCE001 A / B | 本体各17.5×12；含支承高7.5
四键 5P | 18×16×8；向机身左侧拔
OLED 4P | 13.5×8×11；向上拔
开关 2P | 8.5×8×11；向上拔
板至光驱 / B50K | 1.200 / 5.264
板下走线至功放元件 | 1.200；板底走线深度预留2

孔名为原板元件面丝印：X向右A至Z再A至P，图中第二段加(2)；Y向下A至Z再1至4。

布局水平转180°；原板毫米坐标换算 X=57-u、Y=20+v。三处支承留Ø5承压环，扩孔前核对铜皮与焊点。

5P候选孔：J(2) / B…F；4P：H(2)…K(2) / J；2P：O(2)…P(2) / J。不是原板切割模板。

XH类接插件按2.54孔位排布；实际针距、锁扣、脚位和插合尺寸须核对。DCE001绝缘固定、散热与短线待试装。

主控USB／COM插座留空；桥接数据与供电按接线文档连接。板上孔位与电气线序见 docs/perfboard-layout.md。

# DISCORA 前壳线束与 60 mm 维护位

## V4 / 09 彩色版

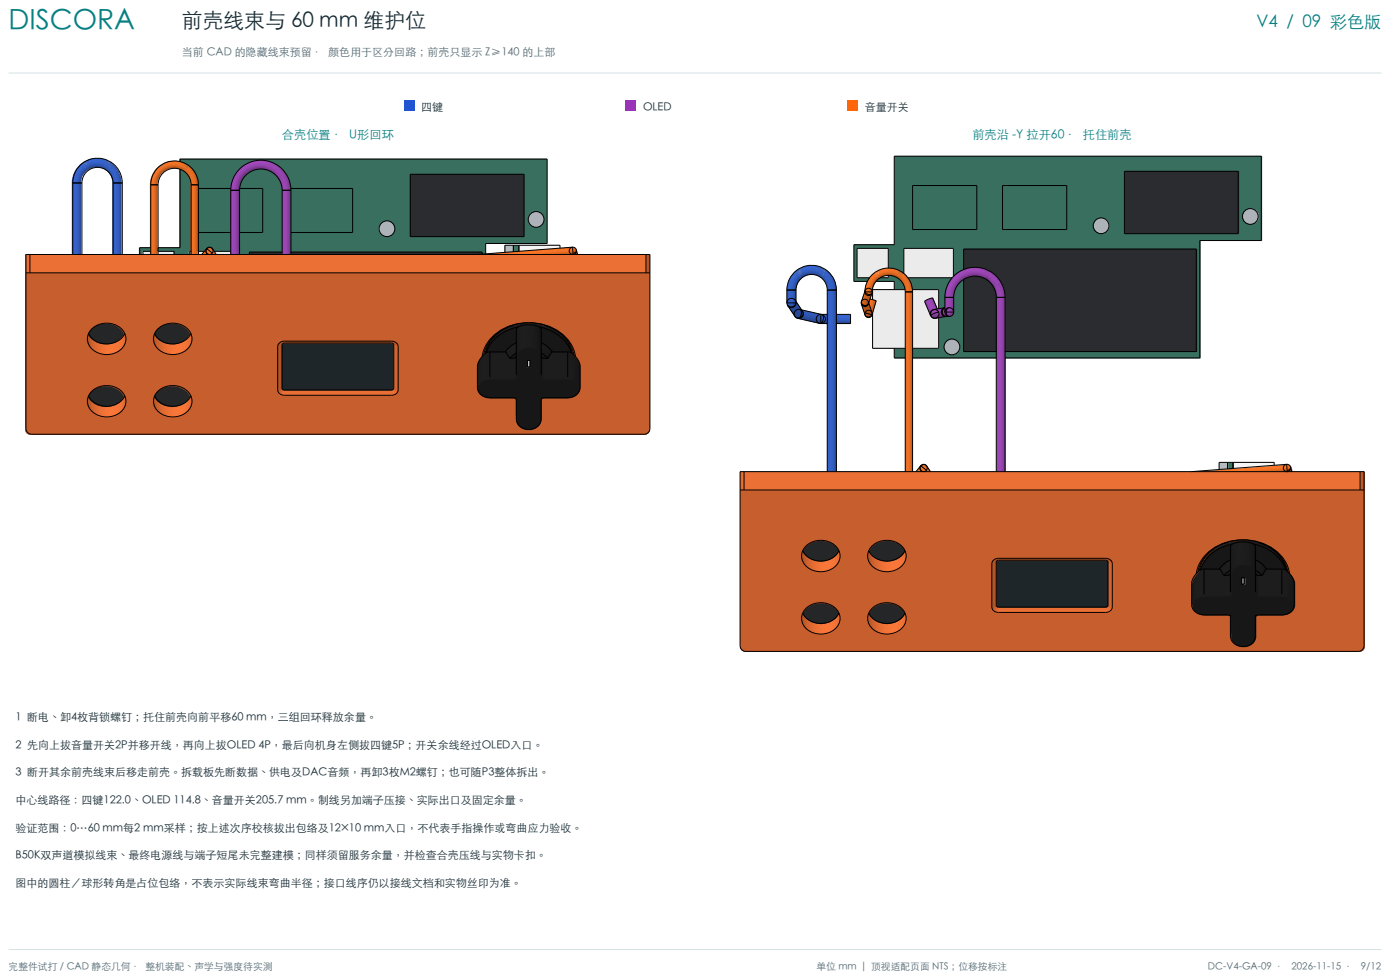
[picture p25: page 9]
完整件试打 / CAD 静态几何 · 整机装配、声学与强度待实测; 单位 mm | 顶视适配页面 NTS；位移按标注; OLED; 音量开关; 合壳位置 · U形回环; 前壳沿 -Y 拉开60 · 托住前壳; 2 先向上拔音量开关2P并移开线，再向上拔OLED 4P，最后向机身左侧拔四键5P；开关余线经过OLED入口。

当前 CAD 的隐藏线束预留 · 颜色用于区分回路；前壳只显示 Z≥140 的上部

1 断电、卸4枚背锁螺钉；托住前壳向前平移60 mm，三组回环释放余量。

3 断开其余前壳线束后移走前壳。拆载板先断数据、供电及DAC音频，再卸3枚M2螺钉；也可随P3整体拆出。

中心线路径：四键122.0、OLED 114.8、音量开关205.7 mm。制线另加端子压接、实际出口及固定余量。

验证范围：0…60 mm每2 mm采样；按上述次序校核拔出包络及12×10 mm入口，不代表手指操作或弯曲应力验收。

B50K双声道模拟线束、最终电源线与端子短尾未完整建模；同样须留服务余量，并检查合壳压线与实物卡扣。

图中的圆柱／球形转角是占位包络，不表示实际线束弯曲半径；接口线序仍以接线文档和实物丝印为准。

# DISCORA 后壳 P3 螺丝座加强筋

从机身正面看 P2 内侧 · 四处定位与右上座剖面详图

## V4 / 10 彩色版

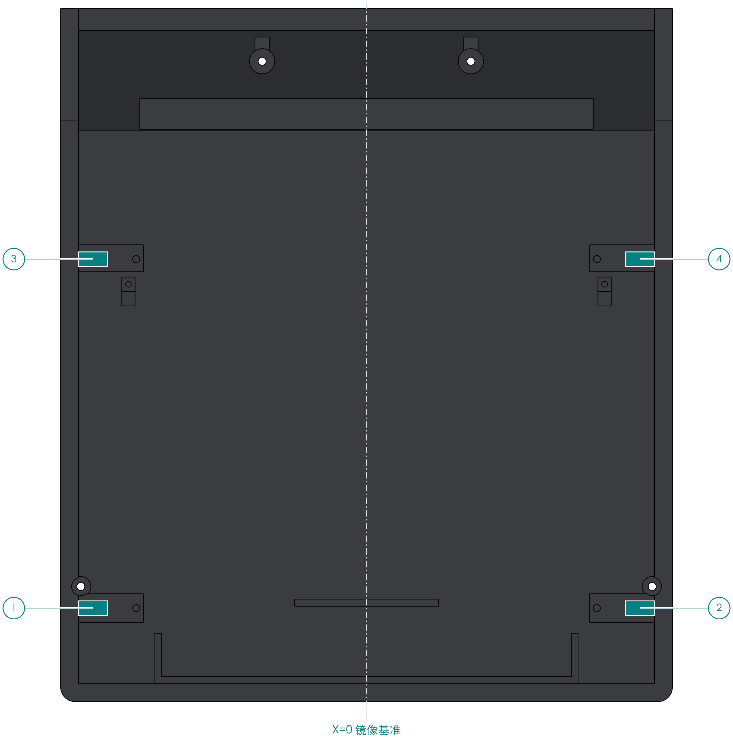
[picture p26: figure]
X=0 镜像基准
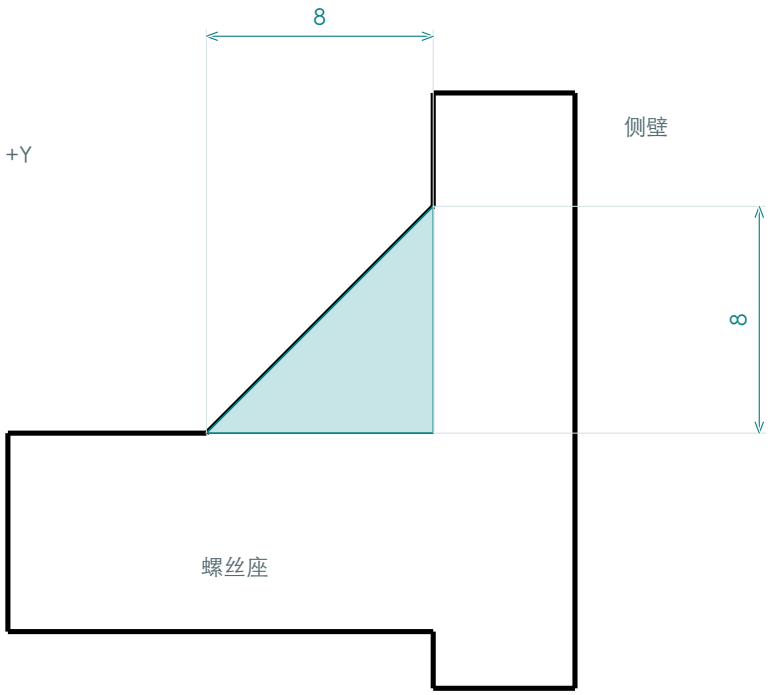
[picture p27: figure]
螺丝座

完整件试打 / CAD 静态几何 · 整机装配、声学与强度待实测 | 单位 mm | 内侧正视 1:1 · 局部 4:1 | DC-V4-GA-10 · 2026-11-15 · 10/12

### P2 内侧正视 / 沿 +Y 观察

### 右上座水平剖面 / Z=124

前方 -Y

后方 +Y

筋条侧视 | 4

四处相同

两直角边各外露 8

Z 向厚 4

四条筋坐标范围

1 | 左下 | X -80 至 -72 | Y 14 至 22 | Z 25 至 29
2 | 右下 | X 72 至 80 | Y 14 至 22 | Z 25 至 29
3 | 左上 | X -80 至 -72 | Y 14 至 22 | Z 122 至 126
4 | 右上 | X 72 至 80 | Y 14 至 22 | Z 122 至 126

拆下前壳、断线并卸除四颗 P3 固定螺钉后，当前 P3 总成沿 -Y 前移 140 mm 连续保守扫掠无干涉。

尺寸为 CAD 名义值。打印配合与锁紧强度待实物验证。

# DISCORA 后斜面背锁深孔座加强筋

P2 内侧正视与右侧孔座轴向剖面 · 两条筋关于 X=0 镜像

## V4 / 11 彩色版

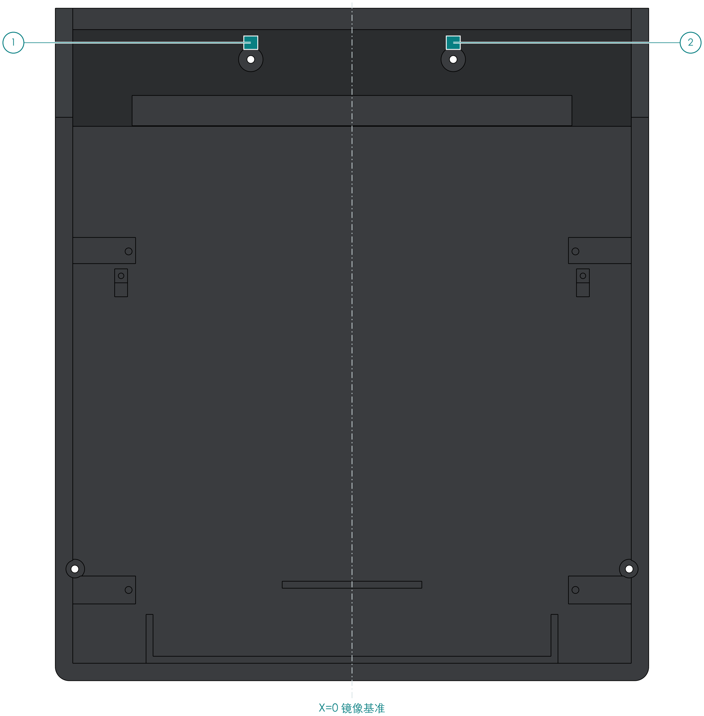
[picture p28: figure]
X=0 镜像基准
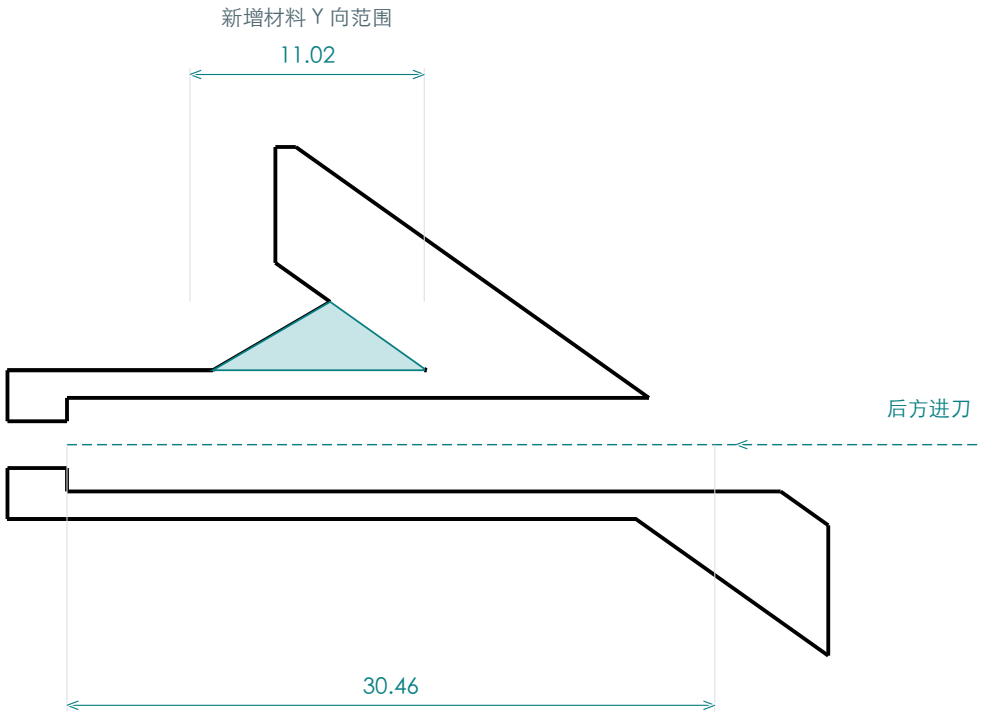
[picture p29: figure]
新增材料 Y 向范围; 后方进刀

完整件试打 / CAD 静态几何 · 整机装配、声学与强度待实测 | 单位 mm | 内侧正视 1:1 · 轴向剖面 3:1 | DC-V4-GA-11 · 2026-11-15 · 11/12

### P2 内侧正视 / 沿 +Y 观察

### 右侧孔座轴向剖面 / X=29

螺钉承压面至斜面外表面轴心

两条加强筋坐标与尺寸

1 | X -31 至 -27 | Y 44.98 至 56 | Z 181.87 至 185.72
2 | X 27 至 31 | Y 44.98 至 56 | Z 181.87 至 185.72

每条 X 向宽 4，融合后新增材料的 Z 向包络高 3.85。

螺丝刀通路

Ø4 刀杆通过 Ø4.4 工具孔，距新增筋最近 1.50 mm。

前壳抽出净空

断线并卸除四颗背锁螺钉后，沿 -Y 抽出 140 mm。

距新增筋最小采样净距 2.878 mm，连续净距下界 2.378 mm。

净空采用 CAD 刚体包络。实际批头配合、打印精度和锁紧强度待实物验证。

# DISCORA P2 开放侧口与 P3 独立导管

ADR-0045 / ADR-0046 · 左右按 X=0 镜像 · 已试装的喇叭安装座保留

## V4 / 12 彩色版

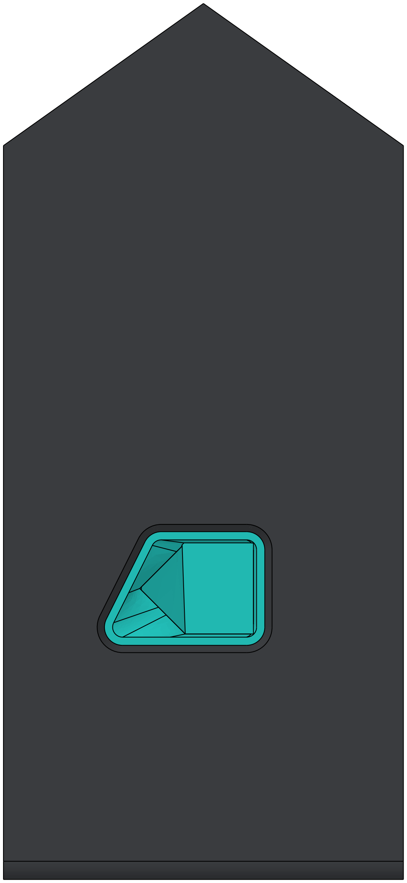
[picture p30: figure]

完整件试打 / CAD 静态几何 · 整机装配、声学与强度待实测 | 单位 mm | 侧视 1:1 · 导管剖视 2:1 | DC-V4-GA-12 · 2026-11-15 · 12/12
P2 / P3 实际装配侧视 | P3 导管截面 X=-70 | 声道与装配名义尺寸
P2 外口包络 | 38.48 × 28.20 mm
P2 外圆角 | R5.6；内圆角 R4
P2 渐收段 | 4.85 mm + 0.15 mm 直段
P3 主通路 | 400 mm²；一转弯回路
P3 短渐扩段 | 长 4 mm；末端 R2.2
P3 末端净面积 | 587.22 mm²
P3 末端口沿 | 横截面名义厚 1.8 mm
P2 / P3 间隙 | 0.7 mm；不跨件粘接

P3 背面朝下：双背板首层直接贴板。

P3：仅底板支撑 ON，关键区域 ON。

P2：仅底板支撑 OFF，关键区域 OFF。

P2 支撑由敞开正面和侧口清理。

P3 声腔、导管内未生成支撑走线。

喇叭座外周与出线处采用可移除封堵。

P2 为外壳，不承担 P3 导管密封。

左图保留真实遮挡；中图仅按标注剖切真实 P3 实体。没有为图示移动导管或扩大通道。

当前为完整件试打版本；喇叭安装座试片已通过。整机装配、拆撑、气密、承载与声学仍待实测。
