miclle/discora/docs/records/2026-11-09-read-speed-probe.md

# CD 读取限速对照实验

日期：2026-11-09 至 2026-11-10（跨午夜）。目标：验证 UJ-898／HC10 是否接受降低 CD 读取速度的请求，以及读取与播放控制是否仍正常；噪声变化须单独记录用户听感。

## 实现与软件验证

- 源码版本 `0.12.8-read-speed-probe`；新增默认关闭的 4×／2× profile，通过 `SET CD SPEED` 请求 708／354 kB/s。零数据阶段，在 TOC 校验后、播放器目录发布前执行。参数、回退边界和协议参考见 [ADR-0027](../decisions/0027-cd-read-speed-probe.md)。
- 完整 `python3 firmware/tests/run_host_tests.py` 通过，包括 ASan／UBSan、协议字节与限速流程异常测试，以及既有 100 种子／500000 步播放器检查。`player_bench_test.py` 的 17 项检查通过。
- 默认查询、4×、2× 三种独立配置均通过 ESP-IDF **v5.4**、ESP32-S3 的 `set-target esp32s3` 和 `build`。首次误用系统默认 v5.5.1，两个有声配置被既有 USB 诊断版本保护拒绝；切回项目保存的 v5.4 后通过，未绕过保护，未烧录 v5.5.1 产物。
- 保持 2 MiB PSRAM、3 秒预填、8 扇区读取、GPIO15／16／7 I²S、25% 增益、四键 GPIO1／2／42／41、SH1106 GPIO10／11，以及一次寻道恢复预算不变。CD-Text 探测关闭。

## 设备、介质与写入边界

串口重新枚举为 `1a86:55d3`、serial `5CF9109063`；烧录工具再次确认 MAC `7c:4f:ad:1d:0e:18`，Secure Boot／Flash Encryption 均关闭。光驱启动识别为 MATSHITA DVD-R UJ-898／HC10，桥接器 `13fd:0840`、USB Full-Speed（此 VID:PID 不作为桥接芯片型号已确认的证据）。当前 CD 为 13 条音频轨、lead-out LBA 252645；没有新增光盘标题、压片／CD-R 类型或表面状态鉴定。

4× 写入前备份 `[0, 0x110000)`，应用与已部署的 0.12.6 镜像逐字节匹配，分区表与候选构建一致。备份 SHA-256：`481f5fbd87f9f4b44a8a7f234be03926ed3bdf9035003a3bc90f05b722b5d3bc`。只写入 `0x10000` 的应用，并独立验证新应用及原前 65536 字节，未修改 bootloader、分区表、NVS 或 eFuse。

| 候选 | 应用字节数 | 应用 SHA-256 |
| --- | --- | --- |
| 原部署 0.12.6 | 404752 | `d16f1de46f543e5ff93dc755fcf34a7fd68ce31bbda7b3509fef7a4fafcb6215` |
| 0.12.8 请求 4× | 405744 | `2b560e9cd28f84563840f0b8234ef78602899827a4b3debb206fe3d06af4ee9e` |
| 0.12.8 请求 2× | 405744 | `44f18dec4e4fbc61d4156d6a3eeae4c7cc29909816871347cf05affdb1196439` |

## 对照方法与边界

原部署固件先运行一次短对照，随后分别测试 4×、2×。每轮启动采集 15 秒，选择第 1 曲播放 20 秒、暂停约 3 秒、恢复约 9 秒，然后第 7／13 曲各播放约 22 秒，最后停止并查询状态；总窗口约 100 秒，包含初始化、预填和控制间隔。每条 `track N` 从对应轨首开始，末曲短测不代表盘尾 EOF 验证。脚本保留串口原文和带时间的命令记录，不保存 PCM。

原部署为 0.12.6，限速候选为当前 0.12.8；4× 和 2× 使用相同源码，仅速度配置不同。各轮起始机械状态／光驱缓存不保证完全相同，首读延迟和平均读取耗时不能直接换算为主轴倍速。最低缓存统计包含刚结束预填时的约 3 秒水位，不等于稳定播放阶段的最低余量。

4× 命令返回 `CSW=0`、零 residue，用时约 6 ms；启动 ELF 摘要与候选一致。用户反馈：**“噪声差别不明显，音乐正常”**。这只支持该短窗口音乐正常，4× 请求尚无明显降噪收益，不据此判断光驱是否实际变速。

2× 命令同样返回 `CSW=0`、零 residue，用时约 6 ms；启动 ELF 摘要 `8ec852dd…` 与候选一致。2× 写入前再次备份并确认当前应用与 4× 镜像匹配，备份 SHA-256 为 `7f0ab15b511aed9f8475859af00399f8cfe82ee1787a1e1d1abe37c38d9c17fb`。仅更新应用，独立校验新应用和原前 65536 字节通过。

用户对 2× 的反馈：**“噪声明显降低，音乐正常”**。因此保留 2× 候选供继续使用，记为本硬件／当前盘短窗口降噪 bench-tested；没有主轴转速或 dB(A) 测量，未完成限速后的整盘验证。仓库默认仍关闭限速。

| 模式 | 总采集秒数 | 完成读取 / 接受入队 | 平均 / 最大读取耗时（ms） | 旧代次丢弃 |
| --- | --- | --- | --- | --- |
| 原部署（未发送限速） | 99.711 | 1015 / 1015 | 18.280 / 329.610 | 0 |
| 请求 4× | 99.763 | 980 / 979 | 25.128 / 3310.843 | 1 |
| 请求 2× | 99.804 | 985 / 985 | 24.595 / 2811.263 | 0 |

三轮均观察到第 1／7／13 曲实际 `playing`、第 1 曲 `paused` 及恢复后的 `playing`。读取失败、软件欠载、自动重缓冲、I²S 写入错误、DMA 事件溢出和 USB transport error 均为 0；缓存最低记录均为 535080 字节（约 3.03 秒，含预填后初始水位）。4× 的一次 rejected 与 stale 均来自换曲时旧代次读取正常拒收，不计为源读取失败。

2× 最终 `state=stopped`、`media=1`、`track=13`、`continuous=0`，I²S `tx=closed`、`handle=0`；没有继续后台播放。串口已关闭，后续可用实体播放键启动当前所选曲目。这是本轮结束快照，不推断后续用户操作状态。

## 保留版本与回退

设备保留 0.12.8 的 2× 实验配置。停止／换曲时不重新申请速度；重启固件后再次取得有效 TOC 时会重新申请。若换盘或长时播放出现异常，应保留日志并对照原配置，不把降噪反馈扩展为稳定性修复。

原 0.12.6 完整备份在 `4x/deploy/before-flash.bin`，应用分区切片为 `4x/deploy/before-factory.bin`；`4x/deploy/restore.py` 可在重新核对同一串口身份与备份摘要后仅恢复应用并验证备份区。恢复原固件不会主动撤销光驱内已接受的速度设置；要重新取得默认机械状态，需要关闭光驱供电再启动，不能只复位 ESP32。

## 提交前审查（2026-11-10）

审查当时的 10 个固件变更文件（含未跟踪的两档 profile 和限速流程测试），核对限速报文、失败回退、介质失效保护及 TOC 发布时序，未发现可确认、需要修复的缺陷。审查轮重新运行完整主机测试，ASan／UBSan、100 种子／500000 步状态序列检查通过；复核此前默认查询／4×／2× 的 v5.4 构建日志、镜像摘要和配置值。审查没有修改固件源码或重新烧录。

整盘播放、换盘、冷启动和长时间运行仍未验收；待办已同步至[路线图](../roadmap.md)。文档更新只补充配置入口、审查证据和验证边界，不改变 2× 部署或默认关闭策略。

## 原始证据

本地忽略目录 `.local/bench/2026-11-09-read-speed/` 保存：`host-tests.log`、三种构建与 sdkconfig、`build-manifest.json`、`compare.py`、各模式的 `playback/serial.log` 与 `report.json`，以及 `deploy/` 中的备份、写入和独立校验。早期 v5.5.1 构建日志另行保留，不能作为部署版本证据。原始备份不得随构建产物清理。
