miclle/discora/docs/records/2026-11-09-usb-offline-recovery.md

# 2026-11-09：恢复边界离线修复

## 范围

用户允许继续修复／优化，并明确要求先不操作光驱。本轮仅检查源码、编辑文档、运行主机测试和构建；没有打开串口、复位主控、烧录、读取光盘或执行退碟。源码版本为 **0.12.5-usb-recovery-guard**，该离线阶段状态为 **implemented／build-tested，未部署**，当时板上仍为上轮恢复的 0.12.3；后续授权烧录见文末，不能把离线结果记为实机修复成功。

此前真实 DATA STALL／`03/02/00` 及一次恢复成功见[诊断记录](2026-11-09-usb-stall-diagnostic.md)。下面两项是可从代码和离线回归确认的软件问题，不是对历史 STALL、CSW 超时或具体硬件根因的新结论。

## 修复一：停止／换曲后不再恢复旧读取

原有 `recovery_healthy()` 只检查 USB 连接、故障、transfer 所有权及 TOC。若长时间读取或 REQUEST SENSE 期间用户停止或换曲，播放器代次已改变，但设备仍健康，恢复流程仍可能等待、TUR 并再次 READ CD 旧位置。最终 PCM 有代次保护，不会混入新曲；问题是无用的再次读取、延迟新曲和消耗一次恢复预算。

当前同步 `read_audio()` 调用期间记录对应播放器请求，恢复健康检查同时查询加锁的请求身份。新 `cd_player_read_current()` 与完成接收共用 pending／generation／serial 条件，使“可以继续恢复”和“可以接收结果”的身份判定一致。

- 恢复开始前已失效：拒绝进入，不消耗预算。
- 恢复等待期间或 TUR 后观察到失效：不再启动后续恢复命令；已经消耗的预算不退款。
- 暂停保留原在途逻辑读取；独立 CD-DA bench 没有播放器请求，不受此检查影响。
- 检查之后已经提交的 USB 命令仍正常等待回调，结果按代次隔离；不承诺强制取消、瞬时停止光驱或硬件级原子取消。

## 修复二：超时清理期间的断连正确分类

原 `transfer_wait()` 仅在开始取消／清理前保存 disconnected。若 100 ms 截止先触发、140 ms 才观察到设备断开、160 ms 归还 transfer，原函数仍返回 TIMEOUT，掩盖随后观察到的断连。

清理结束时再次检查 gone，设备失联优先返回 DISCONNECTED。无回调的 transfer 仍保持 owned，清理期限不延长，也不伪造完成或解除隔离。原 timeout 事件日志仍保留，最终结果补充“随后确实断连”的事实。

## 验证

完整 `python3 firmware/tests/run_host_tests.py` 通过，包含 ASan／UBSan、77 组引脚检查及 100 固定种子／500000 步播放器状态检查。

新增恢复组合使用实际 `cd_player_core` 与 `cdda_recovery_attempt`：在恢复前、等待中、TUR 中分别触发停止／换曲／fault／介质失效／暂停，共 15 组；核对是否调用 TUR／重放、预算是否退款，以及旧失败结果不会破坏新请求。同代次错误 serial 拒绝，暂停保留请求。

等待回归覆盖截止后才断连且回调归还、截止后断连但回调始终未归还；已有 3／30 秒迟到回复、EP0 隔离、长期等待时停止／换曲等检查保持通过。这些是合成事件，未生成或冒充光驱错误反馈。

ESP-IDF v5.4 下三个独立配置均执行 `idf.py set-target esp32s3` 和 `idf.py build`：

| 配置 | app 字节数 | ELF SHA-256 |
| --- | --- | --- |
| 四键有声／OLED／PSRAM／一次恢复，CSW 默认 3 秒 | 403424 | `812197c31b9e9ecdc85c9744ae7ee51ab591c69eda0a1e0ee6e5f6e64063d8fc` |
| 默认查询，不启用播放器／CD-DA 实验 | 299280 | `86a86977b5a48e0dc289e7f71eebc51d2531bfe597af7077e60f331150f4ce83` |
| 独立 CD-DA 寻道／恢复实验，不启用播放器 | 315008 | `27afee5a285e114919f3a34f2c038a2dec93da01f4a1601add38e4b0f931512d` |

生成配置已核对，构建后源码摘要一致，差异空白检查通过。日志、独立配置、产物和摘要保存在忽略目录 `.local/bench/2026-11-09-usb-offline/`，未提交构建产物。

## 交付边界

保留上一轮 STALL／clear／CSW 诊断及可选 30 秒对照；生产默认 CSW 仍为 3 秒，没有扩展重试预算或加入无限恢复。两项离线修复待用户恢复实机测试后再验证。此次没有修改外壳相关文件，也没有提交或推送。

## 后续用户授权烧录（09:06，Asia/Shanghai）

用户明确要求“烧录”后，重新核对源码与此前三配置构建的摘要一致，选择四键有声／OLED／PSRAM／单次恢复配置；READ CD CSW 保持默认 3000 ms，没有启用 30 秒诊断对照或自动 CD-DA 实验。

目标 USB-UART 为 `1a86:55d3`、序列号 `5CF9109063`，芯片 MAC `7c:4f:ad:1d:0e:18`；Secure Boot／Flash Encryption 均关闭。备份 `[0, 0x110000)` 并确认原应用逐字节匹配 0.12.3、分区表一致。备份 SHA-256 为 `0c67aa311e00f5a7c2a69dcebc840463da6c02eb71bbccb0030ff4781282035b`。

仅在 `0x10000` 写入 403424 字节的 0.12.5 应用，写入校验和独立 verify_flash 均通过；原前 65536 字节独立校验一致，未写 bootloader、分区表、NVS 或 eFuse。应用 SHA-256 为 `f7f971ae1d409bb915b2b38ddf115e443c8fa40311d0e8fd92e4cad4b9651e75`。

09:06:31 结束 25.096 秒启动采集，版本 `0.12.5-usb-recovery-guard`、IDF v5.4、完整 ELF `812197c31b9e9ecdc85c9744ae7ee51ab591c69eda0a1e0ee6e5f6e64063d8fc` 一致。GPIO1／2／42／41 四键、SH1106 0x3c 初始化正常；识别 UJ-898／HC10、13fd:0840 Full-Speed 和有效 13 轨目录，无 transport error 或 panic。

### 采集期间出现按键操作

脚本仅发送一次 status，没有发送播放、换轨或退碟命令。但日志出现 `button=toggle`、`button=next`、`button=prev` 和 GPIO41 退碟按键事件：首曲开始播放，换到第 2 曲，再回第 1 曲。约 19.9 秒的最后状态快照为第 1 曲 PLAYING、reads=436、underruns=0，确有音频读取，不能把安静模式下 `command=READ CD` 文本计数为 0 解释为没有读盘。

约 24.1 秒退碟键被接受，ALLOW MEDIUM REMOVAL 成功，随后发出 START STOP UNIT；25 秒采集截止前未记录到退碟 CSW。因此最后 PLAYING 快照早于退碟事件，不作为采集结束后的当前状态，也不能据此宣称机械退碟成功。用户随后确认“是，我正在测试四个按键”，因此上述事件记录为人工试机触发，不是脚本播放或已确认的意外触发。该次回复仅确认操作来源，当时未据此判定功能效果；后续用户的基本操作验收反馈见下节。

串口已关闭并由 lsof 确认释放，没有为追加观察再次打开 COM 或复位。烧录／启动通过不替代真实故障恢复取消分支验收，原始寻道故障根因仍待验证。

部署备份、脚本、写入／校验及启动日志位于 `.local/bench/2026-11-09-usb-offline/deploy/`。`boot.log` SHA-256：`f5fb5d2d823637a725a1414fd6829cea97b85b5fbd4429bc69f6ac39b6eadc18`。没有提交或推送。

## 四键基本操作验收（2026-11-09，用户实测反馈）

用户随后明确反馈：“四个按键测试都正常，播放、暂停、上一曲、下一曲和退碟都没问题”。据此，将当前已部署 **0.12.5-usb-recovery-guard** 的以下五项基本操作记为 **bench-tested（用户实测通过）**。

沿用上述部署的 9063 主控、ESP-IDF v5.4、ELF `812197c3…`、UJ-898／HC10、桥接器 `13fd:0840` 和同一张 13 曲音乐 CD；本次仅整理用户反馈，没有重新连接串口或操作设备。

| 操作 | 按键 | 验收结果与证据 |
| --- | --- | --- |
| 播放 | GPIO1 | 用户确认正常；此前启动日志另有 toggle 被接受及首曲 PLAYING／实际读取证据 |
| 暂停 | GPIO1 | 用户确认正常；此前 25 秒日志窗口未覆盖暂停，不补记串口状态或 I²S 计数 |
| 上一曲 | GPIO2 | 用户确认正常；此前日志另有 prev 被接受及第 2 曲回到第 1 曲 |
| 下一曲 | GPIO42 | 用户确认正常；此前日志另有 next 被接受及第 1 曲切至第 2 曲 |
| 退碟 | GPIO41 | 用户确认退碟正常，作为实体退碟效果证据；此前日志仅覆盖按键接受、允许移除成功及退碟命令发出，未捕获退碟 CSW |

该结论覆盖四个实体按键的五项基本操作，不等于完整验收清单全部通过。长按／上电按住／组合按键、无盘与重插盘、暂停中及首尾循环的实体按键场景仍待专项验证；已有 UART 共用核心的首尾循环和盘尾复位证据单独保留。本次没有新增 OLED 各状态、采样级暂停连续性、长时稳定性或最终设备状态的观测。

新增的故障恢复取消分支尚未在真实故障中验收；历史 USB STALL／超时及其根因未因基本按键测试通过而关闭。本次仅更新文档，没有烧录、提交或推送。
