miclle/discora/docs/records/2026-11-08-track13-followup.md

# 2026-11-08：第 13 轨单测、电脑对照与单次恢复实验

## 当前进度

**继续验证完成**：15:36:23 开始的断电重接后整盘测试已自然完成 13 轨、594221040 字节和 31586 次读取，零原始失败、恢复、掉线、欠载和写入错误。当前 stopped、I²S 关闭、串口释放，未再次烧录。加上此前两轮，同一候选已有三轮整盘完成记录，实际恢复分支仍未触发。用户确认的 10 秒完全断电没有独立电压／温度测量；本轮不是充分冷却后的温度对照，也不是从电源上升沿同步采集。Mac 对照因缺少另一套已验证数据连接而保留未完成。

用户授权按建议依次推进：保持现有配置单独播放第 13 轨，做同盘同区段电脑读取对照，验证已有单次寻道恢复，再按结果做整盘复测。

第 13 轨原配置单测在另一 LBA 再次返回 `03/02/00`，未到 EOF。改接 Mac 后，保持供电重插及完全断电 10 秒仍未枚举到桥接器，三次电脑检查均未读取音频，电脑区段对照保留为未完成。

用户确认接回 MCU 后，单次恢复候选已备份、部署并独立校验；第 13 轨单测与随后第 1～13 轨整盘复测均自然结束，**两轮均没有触发原始读取错误或恢复**。整盘提交 594221040 字节，与逐轨目录长度一致，零掉线、软件欠载和写入错误。已停止并释放串口，当前保留恢复候选。此次光驱经历过用户报告的完全断电，不能把成功归因于恢复开关，也不能将单轮完整播放扩大为反复运行稳定性或真实恢复分支通过。

## 第 13 轨原配置单测

2026-11-08 **12:51:07（Asia/Shanghai）** 开始采集。打开前确认主控序列号 `5CF9109063`、VID:PID `1a86:55d3` 且串口未被占用。仍为 `0.11.3-usb-ab` / IDF v5.4 / I²S，完整 ELF SHA-256 `362084e8a952bc8bcc0cc5c6498eae16ca60cd925c76aebba79e6235b7b9056e` 与前轮相同；未烧录或要求改线。打开 COM 捕获一次 MCU 启动，不能将本轮称为光驱完全断电冷启动。

现场确认 UJ-898 / HC10、桥接器 `13fd:0840`、13 轨目录和 lead-out LBA 252645。只发一次 `track 13`，连续模式为 0；计划播放到本轨自然 EOF，600 秒保护截止，故障即停止，不由控制器重播。

| 指标 | 结果 |
| --- | --- |
| 总采集窗口 | 284.980 秒，含启动、错误查询和停止确认 |
| I²S PCM 提交 | 47774412 字节，按 176400 bytes/s 折算 270.830 秒；不是独立听感计时 |
| 成功读取 / 完整 read_audio 调用 | 2546 / 2547 |
| 失败位置 | 第 13 轨 LBA **244135**，8 扇区、18816 字节 |
| 原整盘失败位置 LBA 233783 | 本次已成功读过，随后继续至新失败位置 |
| READ CD 失败 | DATA 回调 STALL，随后有效 CSW=1、received=0、residue=18816；命令耗时 9.696447 秒 |
| REQUEST SENSE | 成功返回 `03/02/00`；命令耗时 1.292563 秒 |
| 最长完整 read_audio 耗时 | 11.026366 秒，包含 READ CD、sense 及外围开销 |
| ≥1 秒完整读取调用 | 13 次，含最终失败；9.696 秒的 READ CD 与 1.293 秒的 sense 不算两次源读取 |
| failed / rejected / stale | 1 / 1 / 0；前两项对应同一次源失败 |
| USB 根端口掉线 / 软件欠载 / 自动重缓冲 | 0 / 0 / 0 |
| I²S 写入错误 / 完成事件溢出 | 0 / 0；本轨未到自然 EOF |
| 非 EOF 最低队列采样 | 131124 字节，约 0.743 秒；不是精确故障瞬间快照 |
| I²S opens / closes | 1 / 1 |
| 最终空闲堆 / 历史最低堆 / 报告丢失 | 6556600 / 6548540 字节 / 0 |

故障后仅发送一次 `stop`，最终 stopped、continuous=0、queued=0、pending=0、tx=closed、handle=0；串口已释放。控制器没有重试播放。

这次说明同一类失败**不只发生在固定 LBA 233783，也不必先从第 1 轨连续播放约 52 分钟**。但光驱未重新冷启动，不能因此排除热机状态或此前运行的影响；也不能凭 sense 认定光盘、机械、桥接器或供电中的某一个就是根因。新结果不覆盖[上一轮整盘失败](2026-11-08-full-disc-read-failure.md)。

证据目录为 `.local/bench/2026-11-08-track13-baseline/`，包含控制器、setup、状态快照、原始日志和 `analysis.json`。`track13.log` 共 49584 字节，SHA-256 为 `bb66684b4f93fcc39864a3b7b617da25f15ef72b227634f7f39b36b9ab2ae521`，与控制器关闭时的摘要一致。没有保存音频。

## 电脑只读对照准备

保持光盘、光驱、桥接器及辅助供电，改接 Mac 数据上游；必须实时确认桥接器、光驱身份和完整 TOC，不能复用旧枚举实例。准备的两个窗口为：

| 失败 LBA | 读取窗口（右端不含） | 每轮范围 |
| --- | --- | --- |
| 233783 | [233183, 234383) | 1200 扇区，16 秒音频等价 |
| 244135 | [243535, 244735) | 1200 扇区，16 秒音频等价 |

每个窗口计划 3 轮，每次应用读取 8 扇区；总量上限 16934400 字节。单次操作 30 秒截止、整体读取 180 秒保护，首个错误或 USB 枚举变化即停止。记录逐次耗时、每个窗口和失败点 8 扇区的 SHA-256，检查同窗口重复摘要，仅在内存处理 PCM。

工具使用 macOS cddafs 的 AIFF-C / sowt 只读文件及 F_NOCACHE，重新核对轨长。操作系统和光驱仍可能缓存或重试；应用层 8 扇区读取不能等同于总线上的一条 READ CD，也不能从 Mac 成功直接断言 MCU 固件错误。Mac High-Speed 与 S3 Full-Speed 的差异保留。脚本在 `.local/bench/2026-11-08-mac-window/read_window.py`；当前没有本轮成功的电脑读取结果。

### 首次改接 Mac：未枚举，零音频读取

用户确认已将光驱数据端接到 Mac，辅助供电保持不变。13:13:36（Asia/Shanghai）启动工具，身份检查未找到 `13fd:0840`，在任何音频文件打开或读取前退出，`bytes_read=0`、`read_calls=0`，没有后台读取。随后 `drutil list/status` 均未列出光驱，外置物理盘列表为空；USB 树仅见当前主控 COM，未见光驱桥接器。另做约 25 秒、25 次只读 USB 枚举观察，每次均无目标桥接器。

该结果属于连接／枚举准备失败，不能记录为 READ CD 失败、坏扇区或 sense 复现。未改变辅助供电、烧录、退盘或自动重播；已请用户仅重插 Mac 端数据连接后再核对。首次失败的 `result.json`、`controller.log` 和 `enumeration-observation.json` 保留在上述目录，后续尝试使用独立目录，避免覆盖失败证据。

用户确认重插后，13:16:00 的第二次检查仍未找到桥接器，音频读取为零；覆盖等待／重插的约 40 秒观察也未捕获目标。证据独立保存于 `.local/bench/2026-11-08-mac-window-replug/`。用户说明 Mac 数据端经过 USB-A 转 USB-C 转接头，是否与此前电脑成功读取时相同尚未确认。随后请求一次受控的完全断电 10 秒：同时断开 Mac 数据和光驱辅助供电，再先恢复辅助供电、后接数据。该动作改变连续供电条件，将作为单独的冷启动对照记录，不与前两次失败混合。

### 完全断电后的 Mac 检查仍未枚举

用户确认“已完全断电 10 秒并接回 Mac”。13:20:19 的第三次工具检查仍未发现 `13fd:0840`，后续约 25 秒、25 次 USB 采样也均未出现目标；`drutil list` 为空。数据读取次数和字节数均为 0，没有读盘错误码可供比较。断电时长与接法来自用户反馈，没有独立电压测量。

结果独立保存在 `.local/bench/2026-11-08-mac-window-cold/`，包括用户确认、失败结果、控制器日志和枚举采样。此时不能宣称 Mac 读盘成功／失败，也不能将三次“未枚举”作为三个坏扇区样本。数据转接路径尚待用已验证的连接做对照；不继续重复同样的拔插。已建议先接回 MCU 推进准备好的单次恢复实验，电脑对照明确保留为未完成。恢复实验将处在此次光驱断电之后的新状态，与前面的热机失败分别记录。

## 单次恢复候选构建与部署

新增独立叠加配置 [cd-player-seek-recovery.defaults](../../firmware/bench/cd-player-seek-recovery.defaults)，只开启 `DISCORA_CDDA_SEEK_RECOVERY`。在现有 I²S / PSRAM / USB diagnostics 配置后叠加，生成配置与原运行候选逐项比较，**唯一差异为该开关 n → y**。引脚、增益、队列、故障注入、A/B 和其余参数保持一致。

- 独立 build / sdkconfig 下 `idf.py set-target esp32s3` 与 `idf.py build` 通过，ESP-IDF v5.4；未更改固件生产源码。
- `python3 firmware/tests/run_host_tests.py` 完整通过，包括实际共用的恢复编排、预算、等待断连、TUR 失败、重读失败／成功及重连预算检查。这些是主机脚本化证据，不是实机恢复成功。
- 应用大小 377152 字节；app SHA-256 `5b0579c257ed28777e6731b3f508f40b117e4713fe06964466573c9954a5b050`；ELF SHA-256 `f764a9eabcf7fda32ac283be3f5e17316f236363a4b902154955286950321d72`。
- 用户确认接回 MCU 后，核对 9063 串口和芯片 MAC `7c:4f:ad:1d:0e:18`，Secure Boot / Flash Encryption 均关闭。读取 `[0, 0x110000)` 共 1114112 字节备份，SHA-256 为 `22d2975d97fc7a771bfdc110a91137d53541f1d7fc4e384f919fd3f096a67ebf`；原应用与 `301f3cf4…` 候选逐字节相同，分区表与候选一致。
- 仅在 `0x10000` 更新 factory app；写入摘要校验通过，另一次 verify_flash 确认候选应用和 `[0, 0x10000)` 原前缀均匹配。未写 bootloader、分区表、NVS 或 eFuse，未执行回退。当前应用 SHA-256 为上列 `5b0579c2…`，启动完整 ELF 身份与 `f764a9ea…` 一致。
- 原始错误日志必须保留；每次 MCU 启动最多一次同位置恢复，条件与停止行为见 [ADR-0007](../decisions/0007-bounded-seek-recovery.md)。没有实际触发就不能将恢复分支记为 bench-tested。

构建、配置差异、源码摘要、主机检查、备份、写入及独立校验日志位于 `.local/bench/2026-11-08-seek-recovery/`。默认播放 profile 未启用恢复。

## 恢复候选第 13 轨：自然结束，未触发恢复

13:27:21（Asia/Shanghai）开始采集。接回 MCU 后即取得 `13fd:0840`、UJ-898 / HC10 及相同 13 轨目录，启动为 stopped。仅发送一次 `track 13`；没有故障注入、跳过扇区或音频内容替换。

| 指标 | 结果 |
| --- | --- |
| 自然 EOF | track=13、next_lba=252645、eof=1、queued=0、pending=0、continuous=0 |
| 读取 / PCM 提交 | 3610 次成功，67921056 字节，等于 28878 扇区 × 2352；未做本轮 PCM 摘要对照 |
| 原始 READ CD 失败 / 恢复预留／重读／成功 | 全部为 0；不能称为实机恢复分支通过 |
| 两个历史失败位置 | LBA 233783 和 244135 本轮均已读过 |
| 软件欠载 / 自动重缓冲 / 写入错误 / 报告丢失 | 全部为 0 |
| USB 根端口断开 / client DEV_GONE / MCU 额外启动 | 全部未观察到 |
| 最大完整读取耗时 | 9.287912 秒，LBA 230255；该 READ CD 返回 CSW=0 |
| ≥1 秒完成读取 | 8 次；均成功，不是恢复后的成功统计 |
| 非 EOF 最低队列采样 | 438648 字节，约 2.487 秒 |
| I²S opens / closes | 1 / 1，EOF 后关闭 |
| 完成事件队列溢出 | 2 次，均在 57717 μs 的轨尾排空窗口；供数阶段为 0 |
| 控制器播放观察 / 全部采集窗口 | 394.397 / 407.244 秒，包含状态轮询；PCM 等价时长为 385.040 秒 |

已追加一次 stop 并确认最终 stopped、tx=closed、handle=0，串口释放。日志 `track13.log` 为 63188 字节，SHA-256 `41ccac676120d68c860612f75b707fa64e9837d74a4f7c16639c5735ad2f9abb`，与控制器记录一致；EOF 长度、单次启动和关闭状态已复核。

这一轮说明该配置在本次条件下可完整完成第 13 轨，9.29 秒慢读取被缓冲覆盖。因为实际恢复次数为 0，且中间有光驱完全断电与主机切换，不能把成功解释为恢复功能修好了此前失败。随后保持候选做一轮整盘复测；控制器只发一次 play-disc，固件每次启动最多一次符合条件的同位置重读，最终故障即停止，不由主机重播。

## 恢复候选整盘复测：13 轨自然结束，未触发恢复

13:34:34（Asia/Shanghai）开始采集，约 14:31 完成停止确认。与上节相同的 9063 板、UJ-898 / HC10、`13fd:0840` Full-Speed 桥接器和候选 ELF；没有再次烧录或要求改线。打开 COM 捕获一次 MCU 启动并重新核对完整 ELF、TOC 和停止状态；这是 MCU 新启动后的独立单次预算，不是光驱重新断电冷启动。仅发送一次 `play-disc`，由固件顺序完成第 1～13 轨，最终自然 EOF 后追加一次 `stop`。

| 指标 | 结果 |
| --- | --- |
| 完整轨次 / PCM 提交 | 1～13 全部结束，594221040 字节，等于 252645 扇区 × 2352；每轨字节数与 TOC 一致 |
| 名义音频 / 播放观察 / 总采集窗口 | 3368.600 / 3376.608 / 3390.866 秒；后两者包含控制器轮询，不作为精确声学时长 |
| 成功读取 / 完整 read_audio 调用 | 31586 / 31586 |
| 原始 READ CD 失败 / 恢复预留／重读／成功 | 全部为 0；两个历史失败位置 LBA 233783、244135 均已成功读过 |
| failed / rejected / stale | 0 / 0 / 0 |
| 根端口连接 / 断开／错误／过流 | 1 / 0 / 0 / 0；DEV_GONE、transport error、应用 BOT reset 均未观察到 |
| 软件欠载 / 自动重缓冲 / I²S 写入错误 | 全部为 0 |
| 最长完整读取耗时 | 3.830761 秒，首轨 LBA 0；READ CD 本身 3.830493 秒，CSW=0 |
| ≥1 秒完整读取 | 14 次，全部成功；其中轨 12 两次、轨 13 十一次，缓冲覆盖 |
| 非 EOF 最低队列采样 | 535080 字节，约 3.033 秒；该指标包含初始供数阶段，不等于各次慢读取瞬间最小值 |
| I²S opens / closes | 13 / 13；无额外重开，padding=0、bad_dma_sizes=0 |
| 完成事件队列溢出 | 26 次，逐轨均为 EOF 排空阶段 2 次；每轨约 57.729～57.748 ms，供数阶段增量均为 0 |
| 资源与报告 | 每次轨尾关闭后空闲堆均 6556600 字节，历史最低堆 6548540 字节；report_dropped=0 |
| 最终自然结束 | track=13、next_lba=252645、eof=1、queued=0、pending=0、continuous=0、tx=closed |

自然结束后 `stop` 重置了所选轨的游标和 delivered；因此长度核对采用逐轨 EOF 与累计 pcm_submitted，而不把最终 stop 后的 delivered=0 当成未播放。停止确认时 state=stopped、tx=closed、handle=0、queued=0、pending=0，串口已关闭，并确认控制器退出。当前设备保留 app `5b0579c2…` / ELF `f764a9ea…` 单次恢复候选，未回退。

独立分析对原始日志确认：只发一次 play-disc 和一次 stop；13 个自然 EOF、各轨长度、总 PCM、单次 MCU 启动、I²S 打开／关闭配对及停止状态全部符合预期。原始失败、sense、STALL 和恢复日志均为空，不能只凭 player failed=0 判定这一点。26 次轨尾完成事件溢出仍作为单独观察保留，不称为所有诊断计数为零，也不据此推断轨尾听感。

证据目录 `.local/bench/2026-11-08-recovery-full-disc/` 包含控制器、setup、状态快照、逐轨分析及原始日志。`full-disc.log` 共 432409 字节，SHA-256 为 `04088a8338fe5e67608f7a573c414a854e934ab59145f6fc5c05ac9f327b7a64`，独立计算与控制器关闭时摘要一致。没有保存 PCM，也没有本轮独立音频摘要或全程听感验收；此前约 61 秒左右声道清晰的反馈不扩大到整盘。

结论为：**本配置、本次条件下，一轮整盘读取与 I²S 提交完成，未发生读取失败、掉线、欠载或写入错误**。恢复分支未被真实错误触发，仍不能记为实机恢复验证通过；此前间歇性 `03/02/00` 与 USB 掉线没有被证明修复。Mac 区段对照仍因未枚举而未完成。后续应先用已验证的数据转接路径补齐 Mac 对照，并在明确记录冷／热机条件下做重复整盘观察；无需据此次无错误结果扩大重试次数或添加更多恢复动作。

## 同配置热机整盘重复：第二轮完整结束

用户授权继续推进热机重复、断电启动和可行时的 Mac 对照。14:36:59（Asia/Shanghai）开始本轮采集，约 15:33 完成停止确认；不烧录，不请求改变光盘、光驱供电或接线。再次实时确认 9063 串口、候选 ELF `f764a9ea…`、`13fd:0840`、同盘 13 轨 TOC 及初始停止状态后，只发一次 `play-disc`。

“热机”指会话中沿用上一轮光驱供电条件，没有要求重新断电；没有独立温度或供电测量。COM 打开时捕获一次 MCU 启动，因此两轮各有一次固件恢复预算，不能称为跨两轮 MCU 不重启的连续运行。

| 指标 | 首轮整盘（13:34） | 热机重复（14:36） |
| --- | --- | --- |
| 完整轨次 / PCM 提交 | 13 / 594221040 字节 | 13 / 594221040 字节 |
| 成功读取 / 完整 read_audio 调用 | 31586 / 31586 | 31586 / 31586 |
| 播放观察 / 总采集窗口 | 3376.608 / 3390.866 秒 | 3376.494 / 3389.310 秒 |
| 原始失败 / 恢复预留／重读／成功 | 全部 0 | 全部 0 |
| 根端口断开 / transport error / BOT reset | 全部未观察到 | 全部未观察到 |
| 欠载 / 自动重缓冲 / 写入错误 / 报告丢失 | 全部 0 | 全部 0 |
| ≥1 秒完整读取 | 14 次 | 9 次：第 1 轨 2 次、第 12 轨 2 次、第 13 轨 5 次 |
| 最长完整读取 | 3.830761 秒，LBA 0 | 3.550992 秒，LBA 768；READ CD 本身 3.550632 秒 |
| 非 EOF 最低队列采样 | 535080 字节，约 3.033 秒 | 535080 字节，约 3.033 秒 |
| I²S opens / closes | 13 / 13 | 13 / 13 |
| 轨尾完成事件溢出 | 26，供数阶段 0 | 26，供数阶段 0 |
| 每次轨尾关闭后空闲堆 / 历史最低堆 | 6556600 / 6548540 字节 | 6556600 / 6548540 字节 |

热机轮逐轨 EOF 长度与 TOC 均匹配，总量等于 252645 扇区 × 2352；两个历史失败位置均读过。9 次秒级 READ CD 均为 CSW=0；另有一条约 114.971 ms 的非 READ CD 慢查询，未计入 9 次完整音频读取。每轨 EOF 排空发生 2 次完成事件溢出，排空时长 56.562～57.743 ms；轨间空闲堆一致，没有本轮可观察的累积下降。上述指标不替代声学或长期资源验收。

最终自然 EOF 为 track=13、next_lba=252645、queued=0、pending=0、continuous=0、tx=closed。追加一次 stop 后确认 stopped、handle=0、queued=0、pending=0，控制器退出，独立 lsof 检查串口无人占用。原始失败、sense、STALL、恢复、panic 和 reset 日志均为空；只观察到初始一次 MCU 启动与一次根端口连接。当前保留同一恢复候选，没有再次烧录或回退。

证据独立保存在 `.local/bench/2026-11-08-recovery-warm-repeat/`。`full-disc.log` 为 431600 字节，SHA-256 `bfb0520878f80734db319d62d4a1a75971c6a9dfe267ec11cec0684454174883`，独立分析与控制器摘要一致。逐轨长度、总量、启动／播放命令次数、EOF 事件归属及最终资源关闭检查通过；没有保存音频，未新增全程听感结论。

热机轮结束时，同一候选已有两轮完整整盘记录，均未复现错误，支持本条件下播放结果可重复，但仍没有真实恢复触发证据，也不足以消除此前间歇性故障。当时已准备下一轮断电启动控制器并请求用户物理断电；后续执行结果见下节。用户确认目前只有此前未枚举的 Mac 转接头，故本次不继续重复该连接尝试，Mac 区段读取保持未完成。

## 完全断电重接后整盘：第三轮完整结束

用户明确回复“已完全断电 10 秒并接回 MCU”，对应操作为同时断开光驱 MCU Host 数据线与辅助供电，等待后先恢复辅助供电、再接回数据线。记录确认后才解除采集脚本的断电确认门槛；本轮没有烧录、改配置或更换介质。

15:36:23（Asia/Shanghai）开始采集，约 16:33 完成停止确认。重新核对 9063 串口、候选完整 ELF `f764a9ea…`、桥接器 `13fd:0840`、同盘 13 轨目录及停止状态；只发一次 play-disc，固件逐轨播放到自然 EOF。断电时长与接法来自用户报告，没有独立电压或温度测量；采集在用户重接后开始，未测量上电到采集的间隔，不覆盖此前可能发生的最早枚举瞬态。打开 COM 捕获一次 MCU 启动，不能把本轮称为从光驱电源上升沿同步记录的启动或充分冷却后的热学对照。

| 指标 | 断电重接后整盘结果 |
| --- | --- |
| 完整轨次 / PCM 提交 | 1～13 全部自然结束，594221040 字节，逐轨长度与 TOC 一致 |
| 成功读取 / 完整 read_audio 调用 | 31586 / 31586 |
| 播放观察 / 总采集窗口 | 3376.382 / 3390.503 秒；名义音频时长仍为 3368.600 秒 |
| 原始读取失败 / 恢复预留／重读／成功 | 全部为 0；两个历史失败位置均已成功读过 |
| 掉线 / 根端口错误／过流 / transport error / BOT reset | 全部未观察到；只有初始一次连接 |
| 软件欠载 / 自动重缓冲 / 写入错误 / 报告丢失 | 全部为 0；failed、rejected、stale 也均为 0 |
| 秒级读取 | 只有首轨 LBA 0 一次，完整调用 3.568422 秒；READ CD 本身 3.568152 秒，CSW=0 |
| 非 EOF 最低队列采样 | 535080 字节，约 3.033 秒，包含初始供数阶段 |
| I²S opens / closes | 13 / 13；padding=0、bad_dma_sizes=0 |
| 完成事件溢出 | 26 次，每轨 EOF 排空阶段各 2 次，供数阶段均为 0；排空约 57.720～57.744 ms |
| 空闲堆 | 每次轨尾关闭后均 6556600 字节，历史最低堆 6548540 字节 |

自然结束时 track=13、next_lba=252645、eof=1、queued=0、pending=0、continuous=0、tx=closed。随后仅追加一次 stop，确认 stopped、handle=0、无在途／排队数据；控制器正常退出，串口关闭并以 lsof 确认无人占用。完整原始日志没有失败命令、sense、STALL、恢复、panic 或应用 reset 记录，启动次数为 1。没有自动重播，当前保留同一恢复候选。

证据目录 `.local/bench/2026-11-08-recovery-cold-disc/` 保存用户断电确认、setup、控制器、状态快照、原始日志和独立分析。`full-disc.log` 共 429985 字节，SHA-256 `3f509f68e7b5bafbe2ceea3b63714d0b1951d1dda3f325d8b05d393470467aed`，独立计算与控制器关闭时摘要一致。逐轨长度、总量、命令次数、EOF 事件归属及资源关闭检查通过；未保存 PCM，没有本轮音频内容摘要对照或新增全程听感验收。

### 三轮整盘结论

| 实验条件 | 播放观察 | ≥1 秒完整读取 | 最长完整读取 | 原始失败 / 恢复 |
| --- | --- | --- | --- | --- |
| 首轮候选整盘，13:34 | 3376.608 秒 | 14 | 3.830761 秒 | 0 / 0 |
| 沿用供电条件热机重复，14:36 | 3376.494 秒 | 9 | 3.550992 秒 | 0 / 0 |
| 用户确认完全断电后重接，15:36 | 3376.382 秒 | 1 | 3.568422 秒 | 0 / 0 |

三轮每轮均完整提交 13 轨、594221040 字节，成功读取 31586 次，无掉线、欠载和写入错误；每轮 26 次完成事件溢出均局限于轨尾排空。结果支持同一配置在本次重复与断电重接条件下完成整盘播放链路的日志层验证，不能证明故障已修复、恢复开关有效、任意冷启动可靠或全程听感通过。慢读取次数 14→9→1 的变化也不足以单独归因于断电或温度。

当前授权的热机重复与断电重接整盘测试均已结束，设备保持 stopped、I²S 关闭、串口释放。真实 `03/02/00` 恢复验证仍等待故障实际触发，Mac 区段对照等待另一套已验证的数据连接；没有因未复现而增加重试次数、制造设备错误或继续无限循环播放。
