miclle/discora/docs/records/2026-11-07-full-disc-usb-disconnect.md

# 2026-11-07：两轮整盘播放尝试的 USB 失联

## 范围与结果

用户要求沿用当前有声配置，从第 1 轨到盘尾，保持供电和接线不变，掉线即停止、不自动重试。2026-11-07 19:29:01（Asia/Shanghai）开始记录；只发送一次 `play-disc`。目录成功识别，但第 1 轨 LBA 0 的首次 READ CD 在 DATA 阶段发生 USB 根端口断开，尚未完成预填或打开 I²S。**本轮没有进入音乐输出，整盘稳定性未通过。**

播放器先进入 fault、continuous=0；控制器随后发送一次 stop，确认 stopped、pending=0、tx=closed、handle=0，释放串口。包含启动、故障和停止确认的控制器窗口为 11.462 秒，不是音乐播放时长。未重新播放、烧录、要求断电或改动接线。

## 配置与证据身份

- 主控 COM 序列号尾号 8636；GPIO15→BCK、GPIO16→LRCK、GPIO7→DIN，PCM5102A → TPA3118D2，原接线不变。
- UJ-898 / HC10、桥接器 `13fd:0840`，ESP32-S3 Host 下 Full-Speed；13 条音频轨，lead-out LBA 252645。光驱辅助供电保持充电宝 USB-A 直供；未测量负载端电压，不将辅助供电与数据口 VBUS 等同。
- 继续使用上一轮通过约 10 分钟有声对照的 `0.11.3-usb-ab` 应用：I²S、USB 诊断开启，查询 A/B 关闭，2 MiB PSRAM、3 秒预填、自动重缓冲、25% 数字幅度保留。没有改动固件源码或配置。
- 本次启动完整 ELF SHA-256 为 `362084e8a952bc8bcc0cc5c6498eae16ca60cd925c76aebba79e6235b7b9056e`，与原部署产物一致；原部署 app SHA-256 为 `301f3cf488d1cf030875c3d5d658e44c7c27f04ca50271f6904b9c0180455d5b`。本轮未重新读取 Flash 校验。
- 打开 COM 前预设 DTR/RTS=false，日志仍捕获一次 MCU 启动；没有主动 reset，也不能把打开串口视为完全无扰动采集。本轮不是光驱完全断电后的冷启动实验。

本地证据位于 `.local/bench/8636-full-disc-20261107/`：控制器、setup、state、snapshots、analysis 和完整串口日志。`full-disc.log` 为 17075 字节，SHA-256 为 `6be0778c6360fe27cb040a4ba8d8110353e1e67930638ef780e3c8051853ba43`。没有保存 CD PCM。

## 事件顺序

下表采用诊断字段 `observed_us`、`start_us`、`callback_us`、`event_us`，不能用异步输出行前缀的打印时间替代事件时间。

| 事件时间（秒） | 观察 |
| --- | --- |
| 0.413754 | 初次根端口 CONNECTION；随后枚举、INQUIRY、TUR 与两次 READ TOC 成功 |
| 4.094615 | 首次 READ CD 开始，tag=5、track=1、LBA=0、8 扇区，共请求 18816 字节 |
| 4.095126 | DATA 阶段开始，CBW 已完成 |
| 5.556930 | 根端口 DISCONNECTION，距 READ CD 开始 1.462315 秒 |
| 5.557441 | DATA 回调 status=7、actual=0；本机 ESP-IDF v5.4 对应 `USB_TRANSFER_STATUS_NO_DEVICE` |
| 5.557460 | client DEV_GONE，比根端口断开晚 530 微秒 |
| 5.558515 | 播放器 READ_TRANSPORT_ERROR，仍处于 prefill、queued=0、underruns=0 |
| 6.873749 | 根端口重新 CONNECTION，距断开约 1.316819 秒 |
| 7.014321 | 同一 VID:PID 以 epoch=2/address=2 重新打开；播放器没有重新开始读取音频 |

READ CD 返回 `ESP_ERR_INVALID_STATE`，USB 命令总耗时 1.463764 秒，主要在 DATA 阶段，未到 CSW。完整 `read_audio` 调用耗时 1.529040 秒；这是不同层级的计时，不能当作第二次读取。

重连后固件正常识别设备，首次 TUR 的 CSW=1，REQUEST SENSE 返回 `06/29/00`。这是重新连接后的状态证据，不能凭它断言发生了供电中断。USB 自动重新枚举与自动重播是不同动作；日志中只有一次 `play-disc`、一次 READ CD 失败，没有再次启动音频读取。

## 完整窗口统计

| 指标 | 结果 |
| --- | --- |
| 根端口 CONNECTION / DISCONNECTION | 2 / 1（含初次连接及故障后重连） |
| 根端口 ERROR / OVERCURRENT | 0 / 0 |
| client DEV_GONE / READ CD transport error | 1 / 1 |
| 应用 BOT reset | 0 |
| 完整读取调用 / 成功接收读取 | 1 / 0 |
| failed / rejected | 1 / 1，是同一次失败完成及拒收，不是两次失败读取 |
| I²S opens / PCM submitted / DMA blocks | 均 0 |
| 软件欠载 / 自动重缓冲 / I²S 写入错误 | 均 0 |
| 完成事件溢出 / 诊断报告丢失 | 均 0 |
| MCU 启动 | 仅记录开头 1 次，故障时没有再次启动或 panic |

## 结论与边界

1. 这次故障发生在 USB 数据读取层，I²S 尚未打开；不是音频输出已运行后发生的软件欠载，也没有先行应用 BOT reset。扩大 PCM 缓冲不能覆盖尚未读到任何数据时的设备失联。
2. [此前相同应用的约 10 分钟有声窗口](2026-11-07-usb-read-clock-comparison.md)通过，本轮却在首次读取即失败。该组合仍存在间歇性连接问题，不能因短测通过标记为修复，也不能把失败限定为长时间播放或第 13 轨。
3. 当前诊断定位到 Host 观察到连接消失，仍不能区分供电瞬态、USB 信号／连接路径、桥接器／光驱内部复位或 Host 底层异常。没有 ERROR／OVERCURRENT 或 MCU 重启不等于排除这些原因。
4. 本轮按要求结束，不追加同配置重播，也不重复测量已确认的音频接线。若继续定位，应针对 USB 连接丢失补充能区分上述原因的新证据，而非以自动重试掩盖故障。

本次仅保存日志分析并更新工程状态，未修改固件。

## 用户重新授权后的第二轮：第 6 轨失联

用户再次要求保持当前有声配置、供电和接线，从第 1 轨播放到盘尾，掉线停止且不自动重试。本轮是新的显式授权，不是上一轮失败后的自动重播。

2026-11-07 19:33:23（Asia/Shanghai）开始捕获。同一 COM、光驱、13 轨目录及完整启动 ELF SHA-256 均与上文一致；未烧录、未修改配置，也未要求重新接线或断电。打开 COM 仍捕获一次 MCU 启动，不能称为无扰动或光驱冷启动测试。

本轮只发送一次 `play-disc`，成功进入 I²S 输出。第 1～5 轨完整提交并正常跨曲；**约 23 分 20 秒后，在第 6 轨发生根端口断开，未到盘尾。** 控制器立即终止本轮、发送一次 stop，最终 stopped、continuous=0、pending=0、tx=closed、handle=0，串口释放。总捕获窗口为 1411.449 秒，含启动与停止确认；约 23 分 20 秒是依据首次 running 与断开日志估计的输出窗口，不是独立声学测量。

### 全程统计

| 指标 | 结果 |
| --- | --- |
| 成功 READ CD / 完整读取调用 | 均为 13200 次 |
| 第 1～5 轨提交字节 | 45565296、37838976、52607184、48578208、32535216；逐轨等于 TOC 扇区数 × 2352 |
| 第 6 轨最后成功读取 | LBA 105579，8 扇区；下一个位置 105587 |
| 累计 I²S PCM 提交 | 246259104 字节；不是声学输出或参考摘要验证 |
| 软件欠载 / 自动重缓冲 / 读取失败 / 拒收 / stale | 均为 0 |
| I²S 写入错误 / 异常 DMA 长度 / 补零计数 | 均为 0 |
| 根端口 DISCONNECTION / client DEV_GONE | 各 1 次 |
| 根端口 ERROR / OVERCURRENT / BOT reset / transport error | 均为 0 |
| MCU 再次启动 / panic / 诊断报告丢失 | 均未观察到；开头只有一次启动 |
| 完整读取平均 / 最大耗时 | 18.264 ms / 6995.894 ms；最大位于第 6 轨 LBA 104875 |
| ≥100 ms / ≥500 ms / ≥1 s 完成读取 | 均为 3 次；LBA 0、768、104875 |
| I²S opens / closes | 6 / 6，最终输出已关闭 |

三次慢 READ CD 均成功返回 CSW=0。USB 命令耗时依次约 2.302、3.557、6.996 秒，主要在 DATA 阶段；完整读取调用包含外围开销，不能与命令计时混用。缓冲覆盖了本轮这些等待，未触发欠载或自动重缓冲。

完成事件队列溢出累计 10 次。五个 `eof_trace` 显示每个轨尾均在约 57.71～57.74 ms 的排空窗口内增加 2 次，正常轨中和最后故障停止没有新增；这是前序对照已观察到的轨尾行为，与软件 PCM 欠载分开记录，不能据此声称轨间无缝或每个样本均被实际重放。本轮没有收到用户对全程听感的单独反馈。

### 断开前后的精确顺序

仍使用事件自身的微秒字段，避免异步打印时间混淆：

| 事件时间（秒） | 观察 |
| --- | --- |
| 1397.173711 | 第 6 轨 LBA 104875 的慢 READ CD 开始，tag=13394 |
| 1404.169272 | 该命令完成，耗时 6.995561 秒、CSW=0；之后又完成一次 TUR 和 88 次 READ CD |
| 1406.581018 | 最后一条 READ CD（tag=13483、LBA 105579）成功完成，耗时 17.309 ms |
| 1406.618933 | 根端口 DISCONNECTION，距最后命令成功完成约 37.915 ms，距慢读取结束约 2.450 秒 |
| 1406.623722 | client DEV_GONE，active=0、owned=0：此时没有在途 USB 命令 |
| 1406.624257 | 播放器故障快照：track=6、pending=0、queued=2085048、underruns=0；剩余队列相当于 11.82 秒 PCM |
| 1407.933755 | 根端口重新 CONNECTION，距断开约 1.314822 秒 |

最后 transfer 快照是已成功完成的 CSW（actual=13、status=0），不是超时、STALL 或未归还的 DATA transfer。本轮虽有断开，但没有在途 READ CD 因此失败，所以 `failed=0` 与根端口断开并不矛盾。

`state.json` 的 `before_stop` 是约 10 秒轮询留下的最后普通状态，尚处在慢读取中，并非断开瞬间；定位故障使用上表的 `player event=DEV_GONE` 专用快照。停止后清空队列并重置轨号／游标，不能拿最终 `next_lba` 作为实际读取终点。

重连后自动识别设备，TUR 返回 CSW=1，REQUEST SENSE 为 `06/29/00`；没有第二次 `play-disc`，读取计数未增加，也未恢复音频。停止策略与用户要求一致，正常 USB 重新枚举不等于自动重播。

### 新增结论与未决问题

- **缓冲策略覆盖了约 7 秒的慢读取，但没有解决 USB 失联。** 断开时仍有 11.82 秒 PCM，停止来自设备失联处理，不是数据耗尽。
- 本次连接在最后一条命令成功结束后才消失，且没有应用 BOT reset。这与上一轮在途读取失败有所不同，不能将所有失联都归因为 READ CD 超时、I²S 写入失败或完成事件队列溢出。
- 慢读取出现在断开前，值得保留为时序线索；但随后还有成功读取，当前证据不能证明慢读取导致了掉线。约 1.315 秒后重连与此前两次约 1.32 秒的间隔接近，也不能据此直接认定桥接器内部复位或供电问题。
- 问题仍定位在 USB 连接消失这一层；供电瞬态、信号／连接路径、设备内部行为与 Host 底层原因尚未区分。当前音频线路不需要重复检查；本轮没有再发起任何播放或硬件对照。

本轮原始记录独立保存于 `.local/bench/8636-full-disc-20261107-193311/`，包含 setup、控制器、snapshots、state 和独立汇总 `analysis.json`。日志 `full-disc.log` 为 186977 字节，SHA-256 为 `ea7dcbd7feea12d46cb9c0616fb445423deee30c0a4b68c0a6c6dc62a2425cb2`。仅保存日志与统计，没有保存 CD PCM；原始日志留在本地忽略目录，版本库仅收录分析与状态摘要。
