miclle/discora/docs/records/2026-11-07-buffer-usb-review.md

# 2026-11-07：缓冲与 USB 诊断的审查、分阶段交付

## 审查范围与结论

以 `332b384` 为基线，检查本地暂存、未暂存和相关未跟踪文件，按播放器改进、USB 诊断、对照实验三组拆分。共享文件按功能拆分；每组从实际 Git index 导出独立固件源码快照进行验证，工作目录保留最终版本。没有将本地构建输出、串口原始日志、Flash 备份或 CD PCM 加入提交。

**未发现可确认的、需要阻止本次提交的代码缺陷。** 本轮未修改播放器或 USB 算法；补齐 USB 诊断、120 秒／零等待查询和无声读取的 CI 构建配置，修正 README／播放说明中的过时部署与验收描述。审查重点如下：

- 自动重缓冲保留源游标、代次、在途读取和未消费 PCM，输出 owner 先关闭 I²S；暂停、停止、换轨、介质失效及真实源／输出故障可阻止恢复。测试覆盖在途读取在重缓冲前后返回以及短 EOF。
- USB transfer 只由真实回调归还所有权；诊断快照不将超时后的迟到回调改判为成功，也不新增重放或端口复位。记录命令各阶段与真实错误前的播放器快照。
- 根端口链接包装限制到 ESP-IDF 5.4；离线测试与实际诊断 ELF 均确认原 HCD 处理函数只被调用一次、事件值原样返回。关闭诊断时不启用该链接包装。
- A/B 实验默认关闭，只允许识别／就绪／sense／目录查询；停止、失败和完成为锁定终态，重连不重新授权。控制台禁用播放／换轨，零等待不会缩短后续 120 秒查询窗口。
- 2 MiB 队列仅用于普通 PCM，USB／I²S DMA 与 ISR 计数器仍保留内部 RAM；无 PSRAM 的默认配置保留原队列。故障注入默认关闭，正常模式启动仍为 stopped。

## 分组与验证

| 组 | 内容 | 本轮独立源码快照验证 |
| --- | --- | --- |
| 1 | PSRAM 缓冲、自动恢复、读取耗时、增益、相关测试与文档 | 主机 ASan/UBSan 全套、15 项 bench 工具测试；默认与 PSRAM I²S 的 set-target/build |
| 2 | USB 事件／命令耗时／源快照、SDK 包装、测试与记录 | 主机 ASan/UBSan 全套、15 项工具测试；默认与 USB 诊断 I²S 的 set-target/build；实际 ELF 调用链检查 |
| 3 | 查询阶段、零等待和无声读取配置、对照结果与工程状态 | 主机 ASan/UBSan 全套、15 项工具测试；默认、120 秒查询、零等待查询、无声读取的 set-target/build |

ESP-IDF 均为 v5.4、target 均为 esp32s3。主机回归包含 100 个固定种子、500000 步独立 FIFO 模型检查。每组暂存 diff 的空白检查、范围核对及文档本地链接检查通过；构建、测试和暂存树标识保存在本地忽略目录 `.local/bench/delivery-20261107/`。CI 矩阵增至 11 个固件配置，远端运行结果应按最终提交另行核对，本地通过不替代远端 CI 结果。

## 实机证据与剩余限制

本次是代码审查与 Git 交付，没有重新烧录或启动播放。已有实机记录分别保留：

- [受控欠载恢复及缓冲播放](2026-11-07-buffered-playback.md)：软件暂停供数后自动恢复通过；随后约 55 分钟发生 USB 失联。
- [长时失联分析](2026-11-07-buffered-continuous-log-review.md)与[USB 诊断](2026-11-07-usb-disconnect-diagnostics.md)：保留失败现场，未将电压／物理根因判为已定位。
- [启动查询对照](2026-11-07-usb-enum-query-comparison.md)：等待 120 秒和零等待窗口都通过，不据此引入永久延迟。
- [无声／有声 10 分钟对照](2026-11-07-usb-read-clock-comparison.md)：均无 USB 失联或软件欠载；有声轮 4 次完成事件队列溢出均在轨尾排空阶段，用户早期反馈左右清晰。

记录中的“当轮未提交／未推送”等文字描述实验发生时的状态，不表示本次 Git 交付尚未执行。长时 USB 自发失联仍未修复，10 分钟窗口、构建和离线测试都不能替代整盘稳定性、物理信号或音质验收。
