miclle/discora/docs/records/2026-11-07-usb-read-clock-comparison.md

# 2026-11-07：持续 READ CD 与 I²S 播放对照

## 假设与范围

[启动查询对照](2026-11-07-usb-enum-query-comparison.md)中，冷启动后等待 120 秒和不额外等待的查询窗口均未复现 USB 断开。本轮增加真实 READ CD 负载，同时关闭 I²S，观察读盘期间是否仍出现根端口断开；不是再次检查音频接线。

使用已有播放器的 `software-clock-no-I2S` 消费模式，按约 176400 字节／秒消费并丢弃队列数据，保留相同 READ CD 生产路径、2 MiB PSRAM 队列、3 秒预填、自动重缓冲及 USB 诊断。没有新增固件算法或恢复策略，不保存 CD PCM。本轮不启用逐轨摘要计算，因此不将读取完成计数表述为音频数据与电脑摘要一致。

## 配置、部署与停止条件

- 在新构建目录依次叠加 `sdkconfig.defaults`、`bench/cd-player-i2s.defaults`、`bench/cd-player-psram.defaults`、`bench/usb-diagnostics.defaults`、`bench/usb-read-clock.defaults`。最后一个配置关闭 I²S、枚举／查询 A/B 状态机、摘要校验及故障注入；按键和 OLED 仍关闭。
- ESP-IDF v5.4 `set-target esp32s3` 和 build 通过，生成配置逐项确认。源码版本字符串仍为 `0.11.3-usb-ab`，本次以配置、启动 sink 和二进制 SHA-256 区分，不能仅凭版本字符串认为仍在运行 A/B。
- 主控 COM 序列号 `5C82128636`，烧录器核实 MAC `b8:1f:3f:d6:08:88`；仅写 app，写前校验旧 app，写后独立校验新 app 及启动／配置前缀。
- 新 app SHA-256：`e3def0fe708a45e53747efda942eaefdfb8f3a6a54671fa4056d3edab51330d9`。旧零等待诊断 app `431e484e…` 备份为本轮 `previous-app.bin`，正常有声播放应用另有前序备份。
- 接线和充电宝 USB-A 供电保持原样。目标仍为 UJ-898 / HC10、桥接器 `13fd:0840`、Full-Speed，音乐 CD 13 轨、lead-out LBA 252645。没有要求再次完全断电，本轮是烧录后的运行观察，不是冷启动或独立电压测量。
- 上电 stopped，控制器核对软件时钟 sink、目录与缓冲后发送 `play-disc`。从观察到消费开始起约 600 秒后发送 stop；根端口掉线／错误、介质失效或播放器 fault 提前终止，不重启重试。600 秒边界由电脑控制器执行，并非固件内部硬截止；在途 USB 命令遵守既有超时／所有权规则。
- 全程捕获串口和状态，约 10 秒采样一次队列／耗时；发生异常保留现场。预设 DTR/RTS=false，仍不能排除打开串口影响 MCU 复位。

本地证据目录：`.local/bench/8636-usb-read-clock-20261107/`，包括构建、配置核对、部署校验、控制器及完整日志。实机结果如下。本轮未提交／推送。

## 实机结果：约 10 分钟完成

2026-11-07 18:35:56（Asia/Shanghai）开始串口捕获，完整启动日志确认 `sink=software-clock-no-I2S`，目录就绪后显式发送 `play-disc`。控制器从观察到消费开始至截止状态查询完成为 **601.328 秒**，随后发送 stop；包含准备与停止确认的日志总窗口约 614.141 秒。

| 指标 | 结果 |
| --- | --- |
| 真实 READ CD 完成调用 | 5750 次；最终读取耗时统计 count 同为 5750 |
| 覆盖范围 | 第 1、2 轨完整消费，自动进入第 3 轨并继续读取；不是整盘 |
| 轨尾消费字节 | 第 1 轨 45565296，第 2 轨 37838976，与目录轨长乘 2352 一致；摘要未启用，不代表参考内容校验 |
| USB 连接 | 同一 epoch=1/address=1；1 次根端口连接，无重连 |
| 根端口 DISCONNECTION / ERROR / OVERCURRENT | 全部 0 |
| client DEV_GONE / BOT reset / transport error | 全部 0 |
| 软件欠载 / 自动重缓冲 / 读取失败 / 拒收 / stale | 全部 0 |
| 报告丢失 | 0 |
| 完成读取平均 / 最长耗时 | 18.258 ms / 3541.884 ms；最长起始 LBA=768 |
| ≥100 ms / ≥500 ms / ≥1 s 的完成读取 | 均为 2 次，发生在起读阶段 |
| 队列低水位 | 543900 字节，约 3.08 秒 PCM；未发生欠载 |
| 最终状态 | stopped、continuous=0、pending=0，串口已释放 |

两次慢 READ CD 的 USB 命令记录：LBA=0 约 2.223 秒，LBA=768 约 3.541 秒，主要时间位于 DATA 阶段，最终 result=0/CSW=0。USB 命令计时与表中完整读取调用计时范围不同，不混为同一个指标。后续未增加慢读取，缓冲覆盖了读取等待。

截止前最后一份状态中 reads=5742；控制器接收该状态、再发送 stop 的间隙内继续完成 8 次读取，最终 reads=5750，且 failed/rejected/stale 均为 0。这是正常停止边界内的继续读取，不是重复计数或故障。停止后的 `next_lba` 重置到第 3 轨起点，不能拿它代表最后实际读盘位置。

日志 `read-clock.log` 为 75874 字节，SHA-256 `d7c08150dbbae15d95f30123140ce667c6d0b398bf6e5011f40801613e42059a`；`state.json` 保存截止前／停止后的快照，`analysis.json` 独立汇总根端口事件、读取统计、慢命令和轨尾记录。没有输出或保存 CD PCM。

## 结论与后续边界

当前供电／接线条件下，持续读取而关闭 I²S 的约 10 分钟窗口未复现掉线，覆盖两次正常跨曲。结合前序查询通过，可以继续转入有声播放的同长度对照；不能因此排除偶发 USB／供电问题，也不能把原先约 55 分钟的失联归因于 I²S。不同运行窗口和时长不构成确定因果证据。

该无声窗口结束时仍安装上述**无声音的软件时钟配置**并保持 stopped；当时尚未恢复有声播放或开始下一轮。无需重新验证已经确认过的音频接线。后续若恢复 I²S，应保留同样 USB 诊断、缓冲和停止条件，分别记录有声短窗口与长时间稳定性。

## 同长度 I²S 有声对照：配置与部署

用户明确要求恢复 I²S，做相同约 10 分钟有声播放并在结束后分析日志。保持接线、电源、CD 与主控不变，沿用同一 `0.11.3-usb-ab` 源码；本轮没有修改固件算法，只在新的构建目录恢复 I²S profile。

- ESP-IDF v5.4 `set-target esp32s3` / build 通过。与上一轮生成的 sdkconfig 逐项对比，仅 `DISCORA_CD_PLAYER_I2S` 从 n 改为 y，并启用其依赖的 GPIO15/16/7 和数字幅度 25% 四个值；其余配置相同。A/B、故障注入、摘要校验仍关闭，2 MiB PSRAM、自动重缓冲、USB 诊断和超时策略保留。
- 新 app SHA-256：`301f3cf488d1cf030875c3d5d658e44c7c27f04ca50271f6904b9c0180455d5b`。在同一 8636 / MAC `b8:1f:3f:d6:08:88` 上仅写 app，写前验证旧软件时钟应用，写后独立校验新 app 和原启动／配置前缀；旧应用保存为本轮 `previous-app.bin`。
- 2026-11-07 18:53:22（Asia/Shanghai）开始串口捕获；启动确认 I²S sink、目录与缓冲，发送 `play-disc`，实际观察到 tx=running 且 PCM 提交量增加后开始约 600 秒计时。控制器和停止边界沿用上一轮，并要求最终 tx=closed、handle=0。轨尾短暂 stopped 且 continuous=1 属于正常排空／跨曲，控制器不会误判为提前退出。
- 此轮仍是烧录后的运行观察，不是冷启动。软件日志确认输出提交，实际喇叭听感单独请求用户反馈；未收到反馈前不宣称听感验收通过。

本轮证据目录 `.local/bench/8636-usb-i2s-compare-20261107/`，含构建、`config-comparison.json`、部署、控制器与串口日志；实机结果如下。没有 CD PCM 文件，无提交／推送。

## I²S 实机结果与并排分析

有声对照完整运行 **601.404 秒**（从控制器确认 I²S 输出开始，到截止状态查询完成），随后按计划发送 stop，最终 stopped、continuous=0、pending=0、tx=closed、handle=0，I²S opens=closes=3；串口已释放。没有异常触发提前终止。总日志窗口约 614.330 秒，包含准备和停止确认。

用户在播放早期反馈“左右都有连续、清晰音乐”，已单独保存到 `user-feedback.json`。这是实听证据，但不是用户对最后一秒或轨尾无缝性的单独确认；整段运行是否有软件异常以完整日志为准。

| 指标 | 软件时钟，无 I²S | I²S 有声 |
| --- | --- | --- |
| 控制器观察窗口 | 601.328 秒 | 601.404 秒 |
| 完成 READ CD | 5750 次 | 5749 次 |
| 覆盖轨道 | 第 1、2 轨完整消费，进入第 3 轨 | 第 1、2 轨完整提交，进入第 3 轨 |
| 根端口断开／ERROR／OVERCURRENT | 均 0 | 均 0 |
| DEV_GONE／BOT reset／transport error | 均 0 | 均 0 |
| 读取失败／拒收／stale | 均 0 | 均 0 |
| 软件欠载／自动重缓冲 | 均 0 | 均 0 |
| 报告丢失 | 0 | 0 |
| 最长完整读取调用 | 3541.884 ms，LBA 768 | 3565.342 ms，LBA 768 |
| 平均完整读取调用 | 18.258 ms | 18.322 ms |
| ≥100 ms／≥500 ms／≥1 s 次数 | 均 2 | 均 2 |
| 队列低水位 | 543900 字节，约 3.08 秒 | 535080 字节，约 3.03 秒 |
| I²S 写入错误／异常 DMA 长度 | 不适用 | 均 0 |
| I²S 完成事件队列溢出 | 不适用 | 4，全在两处轨尾排空，各 2 |

两轮都按墙钟时间停止，不是固定读取次数／LBA 截止；相差一次 READ CD 不能解释成丢失数据。I²S 轮截止前快照 reads=5741，收到快照再发 stop 的间隙完成 8 次读取，最终 5749；failed/rejected/stale 均为 0。两轮前两轨的消费／提交字节分别为 45565296、37838976，与 TOC 轨长一致；摘要关闭，未证明逐字节内容与电脑一致。

本轮两条慢 READ CD 位于 LBA 0、768，USB 命令耗时约 2.416、3.565 秒，主要在 DATA 阶段，最终 CSW=0。相比无声轮没有增加新的慢读取位置或次数；两轮不是同步的相同缓存／机械状态，不根据几十毫秒差异推断 I²S 造成读盘退化。

### 4 次完成事件队列溢出的解释

`eof_trace` 显示第 1 轨 generation=3，最后 PCM 写入至 drain_start 的溢出数均为 0，约 57.710 ms 后 before_close/closed 为 2；第 2 轨 generation=4 对应从 2 增至 4，排空约 57.734 ms。两个窗口各增加 5 个 DMA 完成计数，后续正常供数和最终主动 stop 未新增溢出。

代码核对：`audio_i2s_eof()` 在 EOF 后设置 50 ms 排空期限，输出任务期间不再调用 I²S write；本机 ESP-IDF v5.4 的 TX DMA 回调在内部完成消息队列满时调用 `on_send_q_ovf`，适配器只累加此计数。结合时间戳，本次 4 次计数定位在 EOF 等待排空阶段，**不是 PCM 环形缓冲欠载，也不是 USB 断开**。不能将完成事件计数直接换算成丢音字节；DMA 回调也可能覆盖自动清零的静音。轨尾无缝／精确物理输出仍需独立验收，本轮不为了清零诊断计数而修改播放行为。

最终累计 PCM 提交 106073436 字节、DMA 完成 60131 次、补零计数 0；这些是软件提交与驱动事件证据，不能当作每一个样本均被喇叭完整重放的独立测量。

### 结果与当前状态

两种模式均完成约 10 分钟，没有复现原先的 USB 自发失联。当前没有证据将该问题归因于 I²S，也没有依据增加固定启动等待或盲目重试。此次只能确认这两个窗口通过，**不能代替原先约 55 分钟问题的长时稳定性验证**。后续若继续定位，应保持此有声配置和供电，观察覆盖原故障时长的整盘过程，保留同一组根端口、慢读取和播放器日志；本轮没有自动启动该长测。

当前安装有声 I²S 配置 `301f3cf4…`，已停止、输出关闭；启动默认仍为 stopped，接线 GPIO15/16/7 和 25% 数字幅度保持。没有再次修改固件源码、没有提交或推送。

本轮 `i2s-play.log` 为 87445 字节，SHA-256 `28fdbcd2cb5ff4383fe00d5f51cc35de3ebe2c09116bdaa2cd8f695e60849d49`；`analysis.json` 保存统计与两处 EOF 时间点，`state.json` 保存截止前／停止后状态。生成配置的独立比对保存在 `config-comparison.json`。
