miclle/discora/docs/records/2026-11-07-buffered-continuous-log-review.md

# 2026-11-07：2 MiB 缓冲连续播放日志分析

## 结论

本轮在约 55 分钟后、第 13 轨后段因 USB 光驱失联停止，**没有自然播到盘尾，整盘稳定性未通过**。前 12 轨完整结束；第 13 轨已提交约 5 分 24.70 秒音频，按 TOC 和提交量计算距整盘结束约剩 60.34 秒。

整个窗口软件欠载、I²S 写入错误和读取命令失败计数均为 0；4 次播放中的秒级慢读取未造成欠载。最终故障是 USB 设备失联，不能用 `read_timing failed=0` 宣称 USB 无异常。失联前缓冲尚充足，固件按既有策略关闭 I²S、清空队列、取消连续播放；重枚举后没有擅自重播。

用户在本轮结束后明确确认：失联前“完全没动”，没有操作光驱供电、USB 线或退盘。因此本轮按无人操作时发生的自发 USB 失联记录，而非人为中断。此反馈不排除供电波动或接触问题；供电、连接、桥接器、光驱自身及 USB Host 栈的具体根因仍未确定。

## 固件与证据范围

设备、接线与配置沿用[缓冲实现记录](2026-11-07-buffered-playback.md)：COM 尾号 8636、ESP32-S3，MATSHITA UJ-898 / HC10、桥接 `13fd:0840`、Full-Speed，同一张 13 轨音乐 CD，PCM5102A → TPA3118D2，GPIO15/16/7，25% 原始双声道输出。

- 最终应用 SHA-256：`bb4515852fdedf44ca9f05ff0ed1e7653e86ac18f3480136d2f786b1bb94e471`。
- 无测试注入；本轮仅一次 `play-disc`，异常发生后控制器发一次 `stop`。监视没有重启、烧录、换轨或改音量。
- 完整日志：`.local/bench/8636-buffered-20261107/continuous/play.log`；631771 字节，SHA-256 `aaa7697dc2c98a23851234ba03baba7d15099b63199faf7b78007c1a1bdfbd31`。
- 机器汇总：同目录 `analysis.json`、`monitor-result.json`、`state.json`。日志无 CD PCM 转储，均保留在忽略目录。
- 2026-11-07 16:07:52（Asia/Shanghai）观察到控制器已结束；最后确认 I²S closed、句柄释放，串口已释放。没有进入整盘循环。

## 最终计数

| 指标 | 本轮结果 |
| --- | --- |
| 完整结束轨数 | 12；第 13 轨中途停止 |
| USB 设备关闭／重新枚举 | 1 / 1；同一 VID:PID 与 INQUIRY 身份 |
| 软件欠载 / 自动恢复 | 0 / 0；本轮没有欠载需要恢复，受控恢复通过是前一轮独立证据 |
| 已完成读取 / 读取调用失败 / 拒收 | 31114 / 0 / 0 |
| I²S 提交字节 | 583577064；音频时长等价 3308.26 秒；整盘预期 594221040 字节 |
| I²S 写入错误 / DMA 块尺寸异常 / 补零 | 0 / 0 / 0 |
| I²S 通道 opens / closes | 13 / 13，结束关闭正常 |
| 完成事件队列溢出 | 24，前 12 轨各 2 次，均在 EOF 排空收尾发生 |
| 报告丢失 / stale | 0 / 0 |
| 平均 / 最大完成读取耗时 | 17733 μs / 3716408 μs（最大为首次 LBA 0 预填） |
| ≥100 ms / ≥500 ms / ≥1 s | 5 / 5 / 5；为同一组 5 次，不相加 |
| 非 EOF 消费后最低队列 | 535080 字节，约 3.03 秒；失联清队列不属于此计数 |
| 轨末空闲堆 | 前 12 轨均为 6557272 字节，无逐轨递减趋势 |
| 历史最低空闲堆 / 输出任务最低剩余栈 | 6549212 / 3788 字节；不等于覆盖了全部任务或所有内存能力类别 |
| MCU 启动 | 日志只有一次启动，失联时未见重启、panic 或看门狗记录 |

前 12 轨分别提交 45565296、37838976、52607184、48578208、32535216、45915744、27414912、64409520、59319792、45384192、26325936、40405008 字节，各自与 TOC 扇区数 × 2352 一致。此配置未开启整轨内容摘要，因此这里只确认长度与完成顺序，不宣称内容逐位一致或模拟输出全部无损。

## 关键时间线

以下时间来自 MCU 日志启动后时间戳；状态查询约每 5～6 秒一次，读取完成的精确时刻不一定等于报告时刻。

| 启动后时间 | 事实 |
| --- | --- |
| 4.915 s | 首次 play-disc 后进入 prefill |
| 9.345 s | 首次状态观察到 playing；LBA 0 读取耗时 3.716408 秒，发生在出声前预填阶段 |
| 第 9 轨 | 完整通过此前两次欠载所在区间，未欠载、未触发恢复；这不证明所有盘／重复运行稳定 |
| 3147.285 s | 第 13 轨累计慢读取数由 1 增至 2，即新增第一次播放中 ≥1 秒读取 |
| 3305.965 / 3317.875 s | 慢读取累计数升至 3 / 4；输出持续，缓冲随后补回 |
| 3323.855 s | 最后一个 playing 状态：队列 1805748 字节（约 10.24 秒），pending=1，underruns=0 |
| 3325.555 s | `device closed`，USB 设备关闭 |
| 3327.015 s | 同一 `13fd:0840` 以新 USB 地址 2 重新枚举，INQUIRY 身份相同 |
| 3327.125 s | sense `06/29/00` |
| 3329.745 s | state=fault、media=0、continuous=0；I²S 已关闭，underruns=0；慢读取累计增至 5 |
| 3330.545 s | 外部控制器发现 fault 后才发送 stop；失联在先，控制器 stop 在后 |
| 3331.365 s | stopped、I²S closed、handle=0，控制器随后退出 |

4 次播放中慢读取均达到 1 秒，均未超过全局最大 3.716408 秒；它们集中在第 13 轨。现有汇总没有逐次保存慢读取的准确耗时与 LBA，不能把每次慢读取都写成 3.716 秒，也不能断定慢读取导致掉线。可见的是后段慢读取增多，随后发生 USB 失联。

固件只有在收到匹配设备的 `USB_HOST_CLIENT_EVENT_DEV_GONE` 时才设置 `gone=true`；已打开设备的主循环据此关闭设备。对应源码为 `firmware/main/usb_probe.c` 的事件回调和主循环。此次无接口初始化错误或 READ CD transport 错误记录，随后重新枚举，证据支持运行中的 USB 设备失联。

`29/00` 的标准含义是上电、复位或总线设备复位，见 [T10 ASC/ASCQ 列表](https://t10.t10.org/lists/asc-num.htm)。重新枚举本身也可能伴随复位，故此 sense **不能单独证明 5V 掉电**，也不能排除 Host／连接／桥接问题。

## 缓冲与 EOF 事件的判断

这次停止前软件队列还有约 10 秒数据；停止后的 queued=0 是介质失效路径清空队列，不能解读为“缓冲耗尽”。因此继续扩大缓冲不能直接修复此次设备失联。真实读取抖动被缓冲覆盖，是本轮支持大缓冲有作用的证据，但实际光驱失联后继续播放／恢复是另一项策略，目前未实现。

24 次 `event_overflows` 逐轨核对为前 12 轨各 2 次：最后 PCM 写入时计数未增加，固定 EOF 排空到关闭期间增加；故障停止没有新增。它是驱动完成事件通知队列溢出，与软件 PCM 欠载不同，不能据此判断音乐损坏，也不能据此证明硬件完全无静音。保持原始计数，不隐藏该边界。

启动时仍有 16 MiB Flash 检测值大于保留启动镜像头 2 MiB 的提示，以及原生 USB 切换 Host 的提示。没有本次应用分区越界证据，也不能仅凭启动提示将本次运行约 55 分钟后的断开归因于 Flash。

## 后续定位建议

1. 已确认没有人为供电／USB／退盘操作，后续按自发失联定位，保留本轮完整日志作为对照基线。
2. 优先增加有界事件证据：USB 断开事件的时间／底层端口原因，及仅对慢读取记录 LBA、单次耗时和阶段；本轮仅有汇总，不足以区分驱动、桥接器、供电或光驱内部重试。
3. 针对光驱供电与 USB 路径做一次只改变单个条件的长时对照。需有负载下电压／连接或替代链路证据，才能进一步判定原因，不能先断定 DAC 损坏或电源不足。

本次任务只观察、停止后分析并保存证据；未修改固件、重播、自动恢复 USB 连接或替换硬件。
