miclle/discora/docs/records/2026-11-01-m3-autoplay.md

# 固件自主连续播放

状态：0.8.0-disc-sequence 已实现；第 12→13 轨自主切换与盘尾停止空载实测通过（bench-tested）。

2026-11-01，同一 ESP32-S3 N16R8、UJ-898 HC10、`13fd:0840` Full-Speed BOT 和 13 轨 CD，ESP-IDF v5.4。目标 COM `1a86:55d3` / `5CF9109063`，OTG / 辅助供电不变，GPIO4/5/6 空载，无 DAC。

`play-disc` 从当前轨起点播放到盘尾，换轨在旧输出关闭后由 MCU 发起，末轨停止且不循环；暂停保留模式，停止、手动换轨和错误取消。详细语义见 [ADR-0009](../decisions/0009-explicit-disc-sequence.md)。

8 组 C ASan/UBSan 检查通过，新增核心连续播放边界用例；原有 50 万步状态组合回归通过。15 项工具测试通过，新增仅一次启动、禁止把缺失 MCU advance 事件判为成功的脚本观察 fixture。默认、测试音、软件时钟、I²S、故障注入五配置及 I²S 摘要观察配置均完成独立 set-target / build。

实机选择第 12 轨后停止，再发送一次 play-disc；至完成检查前只发 status，目标依次完成第 12 / 13 轨并在盘尾停下。不是从第一轨开始的整盘自主播放验收，也没有模拟输出验收。部署 / 原始日志 / 工具 / 源码 / 配置 / 镜像证据位于 `.local/bench/2026-11-01-m3-autoplay/`，结束后恢复默认查询固件。

## 实机结果

场景耗时 621.381 秒（约 10 分 21 秒），一次 play-disc 后至完成检查前仅有 status 查询。固件报告 `sequence advance from=12 to=13 generation=6`，随后 `sequence complete from=13 to=13`；未由电脑发送 next / track 推进。

- 第 12 轨 40405008 字节、尾块 588；第 13 轨 67921056 字节、尾块 1764。两轨源/消费 SHA-256 均与前一轮 I²S 整盘对应轨相同，总 I²S 提交 108326064 字节。
- 最终 stopped、continuous=0、eof=1、queued=0、pending=0、handle=0，opens=closes=2；2 秒稳定观察无新增读取或 DMA 完成。
- 写入错误、坏 DMA 长度、软件欠载、报告丢弃均为 0。供数阶段事件溢出增量为 0，收尾每轨 2 次、总计 4 次完整保留。
- 累计 5758 次有效读取，启动准备阶段停止/重启造成 1 次旧代次拒收；不是读取错误。轨 12/13 自主段不跨轨发 READ CD。
- 最终 heap_free=159360、heap_min=151316、output_stack_min=3872 字节，无 USB 离线、传输错误或异常复位记录。

最后恢复并写入校验 0.4.3 查询模式，25.191 秒内取得有效目录和 5 次 TUR 成功、READ CD 数 0；串口已释放。原始报告、日志、构建配置核对、源码/工具快照及 SHA-256 清单保存于上述本地证据目录。场景结束的 finally 清理另发一次 stop，再关闭 COM，不参与自主切换证据。

本轮证明末两轨的正常自主切换和盘尾停止；从盘头开始的整盘自主模式、实际断连/冷启动、I²S 引脚波形和 DAC 声音仍未验收。前一轮 13 轨 I²S 空载结果对应 0.7.5、电脑逐轨选择，不能改记为 0.8.0 的整盘自主结果。
