miclle/discora/docs/records/2026-11-01-m2-seek-rounds.md

# 2026-11-01：有界多轮寻道与恢复分支覆盖

用户要求保持连接，继续复现间歇性错误并验证有界恢复。全程不要求用户拔插或改变供电，只通过明确匹配的 Discora COM 进行应用烧录和 RTS 复位。

## 环境和边界

ESP-IDF v5.4 (`67c1de1eeb`)，ESP32-S3 rev v0.2，COM `1a86:55d3` / `5CF9109063`；UJ-898 / HC10、桥接器 `13fd:0840`、Full-Speed BOT `08/02/50`、IN 0x81 / OUT 0x02、MPS 64、LUN 0。新 OTG 直接连接，辅助 USB-A 仍由充电宝供电，无 Hub；同一 13 轨音乐 CD，lead-out 252645。延续此前电脑初始化后的供电状态，不是冷启动实验。

0.5.3 增加轮数（默认 1，最大 20）和默认关闭的 seek-only 配置。每轮 12 位置，每位置两次 8 扇区读取；在短探测之后最多 480 次逻辑读取。不运行完整首轨和缓冲，日志明确标记 not_run。位置开始前检查 600 秒软截止，正在执行的命令仍按原截止结束；中途退出不能算作工作负载通过。

恢复策略没有放宽：每次 MCU 启动最多一次预算，只有有效 `03/02/00`、设备健康、等待 1 秒后再次 TUR 成功，才重放同一读取一次；断连、传输故障、无有效 sense、其它 sense 或未就绪时停止。重连和下一轮都不会重置预算。每个位置先记录轮次、步骤、轨道和 LBA，再发起读取，保留原始错误。

构建分别使用独立 sdkconfig 和 build 目录，执行 `idf.py set-target esp32s3 && idf.py build`；主机 ASan/UBSan 三组检查通过。默认配置不启用读取实验，协议准入检查不能代替实际恢复分支覆盖。

烧录前实时 `verify_flash` 核对当前 0.4.3 应用，复用此前 sense-control 的 `0x0–0x110000` 备份并核对 bootloader / 分区 / 应用；这不是新读出的备份，也不是全 16 MB Flash。仅写应用 `0x10000`，写入校验成功。每组结束恢复已保存的 0.4.3 默认关闭实验镜像并独立观察约 25 秒，只操作 Discora 的目标串口。

## 固定位置 20 轮

采用 [seek-rounds.defaults](../../firmware/bench/seek-rounds.defaults)，预等待 0 ms，sense 数据截止 30 秒，单次恢复允许。采集 91.591 秒，完整执行 20 轮、240 个位置访问、480 次逻辑读取，最长单次 read 668080 μs；全部重复读取一致，同一 LBA 的摘要跨轮也一致。共 12 个独立 8 扇区窗口，软件核对所有起点和结束边界均在轨内。

一次枚举、零 device closed、零 transport error、零 REQUEST SENSE，`failures=0 recovery_reserved=0 recovered=0`；未触发恢复。恢复 0.4.3 后 25.187 秒取得有效目录、5 次 TUR 成功、READ CD 数 0，未离线。

固定位置反复通过仍只有 12 个独立窗口，不能排除缓存或持续供电状态的影响。因此追加位置变化对照，继续保持原有次数、截止和恢复限制。

## 确定性变化位置 20 轮

源码 `0.5.4-seek-offsets`，默认和实验配置各自 set-target / build 通过。采用 [seek-offsets.defaults](../../firmware/bench/seek-offsets.defaults)：首轮沿用原位置，从第 2 轮起将原轨内偏移加上 `997 × (round - 1)`，再对 `span - 7` 取模。只扩大同一首/末/中间音轨内的取样范围，仍拒绝跨轨，且每位置重复两次。恢复条件、预算和截止不变；不声称确定绕过缓存。

完整执行 20 轮、240 个独立 8 扇区窗口、480 次逻辑读取，最长单次 read 664251 μs；每位置重复摘要一致。日志复核全部读取区间在有效音轨范围内，没有跨轨或盘尾读取。`failures=0 recovery_reserved=0 recovered=0`，没有实际恢复重放。

## 结论与覆盖边界

| 工作负载 | 完成轮数 | 位置访问 / 独立窗口 | 寻道逻辑读取 | 最长 read | 原始失败 / 实际恢复 |
| --- | --- | --- | --- | --- | --- |
| 固定位置，0.5.3 | 20 | 240 / 12 | 480 | 668080 μs | 0 / 0 |
| 变化位置，0.5.4 | 20 | 240 / 240 | 480 | 664251 μs | 0 / 0 |

两组共 40 轮、960 次寻道逻辑读取；另外各有原有短探测，不计入此表。相同窗口的重复读取均匹配。两组都未复现此前失败，不代表故障已修复，更不能将恢复开关已开启当作恢复成功。

实际 `03/02/00 → 等待 → TUR → 单次重读`、等待期间断连中止、重放失败后预算耗尽等分支均未在本轮触发；600 秒软截止也未触发。只有准入判断已有主机检查，正常多轮寻道有实机证据。没有人为伪造光驱错误或成功返回。

本轮结束后不自动继续扩大次数，恢复默认关闭读取实验的固件。之后仍需在真实故障出现时验证恢复/退出路径；持续供电状态、冷启动、独立电脑内容参考、I²S 和其它介质兼容性不由本轮替代。暂时不需要用户改变接线。

原始日志、配置、源码快照、应用、烧录验证、备份来源和分析结果保存在忽略目录 `.local/bench/2026-11-01-m2-seek-rounds/` 与 `.local/bench/2026-11-01-m2-seek-offsets/`。没有保存音乐 PCM，未提交或推送。

## 最终部署及证据校验

第二组实验窗口 87.607 秒，一次枚举、零关闭、零传输错误、零 REQUEST SENSE。最终恢复默认关闭实验的 0.4.3，25.189 秒独立观察中目录有效、5 次 TUR 成功、READ CD 数 0、零离线；采集完成，串口已释放。源码当前为 0.5.4，不能把它与最终上板的 0.4.3 混淆。

| 证据 | SHA-256 |
| --- | --- |
| `seek-rounds/direct.log` | `ee0a6e957583e2f9c7341314dd0360aa11f763eb549041d47b849e54b23cba11` |
| `seek-rounds/direct-build/discora.bin` | `10dce4811a050d6ac1984b59d5d57c7b2fd4c0b347f040ef3449da5a7d3eaa59` |
| `seek-rounds/final-default.log` | `376d0d52467d7f57a9cd791a517b72da87f6078f9efd775761408e83aee97f9c` |
| `seek-offsets/direct.log` | `dd70996336e850ea996fa4bcbe1dea8ff2edc8ab769f91283bf7fd87b71126a3` |
| `seek-offsets/direct-build/discora.bin` | `ec16577601dc912445ec8d37bf33a0db68c9ee1c564dd9bc952131c8044af618` |
| `seek-offsets/final-default.log` | `f97b9d55770639c88614cdf9e4ba4a5a4a937cb641305f4b60a8cf521ee4a4d2` |
