miclle/discora/docs/records/2026-10-31-m2-underrun.md

# 2026-10-31：欠载负向测试准备与提前离线

结论：新增默认关闭的欠载注入开关和直连对照配置，三种配置构建通过。本次负向实验在注入前收到设备离线事件，**欠载分支未验证通过**；消费端响应停止、环形缓冲释放已观察到。随后恢复默认关闭的 `0.4.3-underrun-bench`，目录有效，未发送 READ CD。

## 范围与前置证据

沿用 ESP32-S3 + UGREEN Hub `05e3:0610` + 桥接器 `13fd:0840`、UJ-898 / HC10、同一 13 轨音乐 CD。仅匹配 Discora COM 的 VID:PID 与序列号；其它项目串口未操作。现有供电、Y 线隔离及失联根因继续保留未验证边界。

此前 `0.4.2` 的 600 秒顺序实验、105840000 字节和电脑完整摘要对照仍为 [独立已完成记录](2026-10-31-m2-stream.md)；没有把该结果重新标记成当前版本已完成的实验。本次没有重跑远距离寻道或回读 LBA 0。

## 实现

- 新增 `CONFIG_DISCORA_CDDA_UNDERRUN_TEST`，默认关闭，仅允许在扩展实验开启、寻道/完整首轨阶段均关闭时选择。
- 使用真实 READ CD 数据和软件消费端，消费启动两秒后，计划暂停生产者 1200 ms。消费端继续按时钟读取，由实际队列不足触发原有欠载逻辑，不直接填写欠载统计，也不伪造设备返回。
- 正常流测试仍必须判失败；单独的 negative-control PASS 要求注入已发生、恰好一次真实欠载、缺失字节大于零、消费任务完成及源服务无故障。它不表示音频播放或正常流通过。
- 修正未能等待消费端停止的路径：保留缓冲并立即返回，不再读取仍可能变化的统计/摘要。该未退出分支本轮仅检查源码并构建，未人为阻塞消费任务以触发。
- 将消费任务栈余量扫描移出队列临界区。

## 本轮真实结果

ESP-IDF v5.4 (`67c1de1eeb`)，Xtensa GCC 14.2.0；分别执行目标设置与构建，默认关闭、负向实验、直连对照三种配置均通过。USB 接收和环形缓冲使用内部 RAM，不将 PSRAM 作为 USB DMA。

短探测通过后，从 LBA 414 顺序衔接，预填耗时 115155 μs。随后约 1.08 秒时，源服务报告设备离线，早于两秒注入点；没有出现暂停注入日志。

```text
I (5092) cdda_bench: buffer prefill complete elapsed_us=115155 free_internal_heap=170652
I (6172) cdda_bench: buffer failed seconds=60 produced=319872 consumed=188556 underruns=0 missing_bytes=0 low_active=111324 high=148368 longest_read_us=17291 sink_max_late_us=0 transitions=0 joined=1 sink_stack_free=1096
I (6192) cdda_bench: negative-control FAIL underruns=0 missing_bytes=0 joined=1 ring_released=1; not a normal streaming PASS
I (6202) cdda_bench: extended bench failed negative_control=1 seeks=not_run full_track=not_run (software sink only; not I2S playback)
I (6322) usb_probe: device closed; free internal heap=326368
```

- 60 秒是配置目标，不是完成时长；只运行约 1.08 秒消费。生产/消费字节数和摘要不一致是未完成窗口，不能判完整数据流通过。
- 主机采集 16.253 秒，单次 MCU 启动；欠载数 0、缺失 0，没有注入，负向结果正确保留 FAIL。
- 消费端已发布完成、不再访问环形缓冲，日志报告 `joined=1`、`ring_released=1`。这只覆盖本次源离线后的退出，不代表所有超时/隔离路径均通过。
- 本次未取得用户对期间物理操作的独立确认，也未测量供电；只记录设备离线事件，不推断自动故障原因。

## 默认恢复与明日对照

负向窗口结束后自动刷回默认关闭配置，25 秒采集确认 `0.4.3-underrun-bench`、`CDDA probe enabled=0`、有效 13 轨 TOC、READ CD 发送数 0。本轮按阶段本地提交，未推送。

用户预计 USB-C 公头 → USB-A 母口 OTG 数据转接头于 2026-11-01 到货。已准备 [直连配置](../../firmware/bench/otg-direct.defaults)：12 位置寻道、完整首轨、60 秒软件缓冲，负向注入关闭。该配置只构建通过，未烧录执行直连；到货并确认接法后再做一轮，不在现有 Hub 上反复触发已失败的寻道。

原始日志、配置、源码、Flash 备份和产物留在忽略的 `.local/bench/2026-10-31-m2-underrun/`。只保留元数据/摘要，不保存 PCM。烧录前 0x0–0x110000 备份已提取并匹配此前 0.4.2 默认应用，不称为全 Flash 备份。

## 校验快照

| 本地相对文件 | 字节数 | SHA-256 |
| --- | --- | --- |
| `negative-control.log` | 18593 | `b6467b2bb4313a3c480e0b1d951860bab1bcc6a9a81097ca90d7bc08bf367c68` |
| `final-default.log` | 8885 | `f0319121fc21fc27bcb389392bbfdae4c115081f9a5f4462d533eb6206986328` |
| `before-flash.bin` | 1114112 | `7c0a72fde33dc94495381ff67746d373670f826cf73e235490efe5caa01d5335` |
| `lab-build/discora.bin` | 298944 | `3c8f6d8b04b92d5576b18974751bb535cb68fefbe21d6bbcdb03ec65896675d2` |
| `lab-build/discora.elf` | 4550308 | `4a4d97793524b83343fa4ad3ea812afa1a0351b16e54075838ba4f9d62b0c667` |
| `default-build/discora.bin` | 279504 | `b1878225b49fdf2c07816343b0159f714d5fee29902b9b39337e9b6b340a5c7e` |
| `default-build/discora.elf` | 4301148 | `d3aa8460d48de35f8999bcae454d9ebea5e51af2512b8c5faef4191bb14a815f` |
| `direct-build/discora.bin` | 298288 | `b296e41087ef7b8793214c9dd483fe8b79022af0d56d41f52eadd5feea2141c9` |

| 当前源码 | SHA-256 |
| --- | --- |
| `firmware/main/cdda_bench.c` | `0036bc0674fe5cd11884d84f2361064388a4750aa5d0029871fc155ecd3e9e65` |
| `firmware/main/Kconfig.projbuild` | `7ec9740f930a74850949086e41f4df8d96c650a135dac6a61a6036a33ad4572a` |
| `firmware/CMakeLists.txt` | `484df81111191e0f47ebe984ab91df99531b2a53cf6f1cbdc440855ac68179d4` |
| `firmware/bench/otg-direct.defaults` | `2afb467aedef297edfb3698d5b11c394f2c64f7aa4f8740be661cea5b88ff956` |
