miclle/discora/docs/records/2026-10-31-m2-stream.md

# 2026-10-31：长时读取、寻道和缓冲实验

本轮实现完整音轨、12 位置寻道及软件时钟缓冲实验；所有实验默认关闭、每次 MCU 启动最多一次。首两轮已出现真实故障，保留原始日志。顺序缓冲完成 600 秒，生产/消费及电脑独立参考的整段摘要一致，零欠载；寻道及完整首轨回读未通过。

## 硬件、环境和证据边界

- ESP32-S3 rev v0.2，器件报告 16 MB Flash / 8 MB PSRAM；精确开发板版本未确认。只按 VID:PID、序列号核对并操作 Discora COM；不打开其它项目串口。
- UGREEN Hub `05e3:0610`，桥接器 `13fd:0840`，Full-Speed，class/subclass/protocol `08/02/50`，IN `81` / OUT `02`，MPS 64，LUN 0；MATSHITA UJ-898 / HC10。
- 同一 13 轨音乐 CD，lead-out LBA 252645。短探测的轨 1、LBA 150 / 8 扇区继续与此前电脑参考 SHA-256 相同。
- 连接延续前轮：COM 接电脑，native USB 接 Hub，光驱数据头接 Hub、辅助供电接充电宝。此次未要求用户插拔；未在读盘时测量电源，不能由症状判定电源正常或故障。Y 线隔离仍未验证。
- ESP-IDF v5.4 (`67c1de1eeb`)，Xtensa GCC 14.2.0；UART0 115200，main stack 8192。USB 接收及 PCM 环形缓冲均使用内部 RAM，不用 PSRAM DMA。
- 三轮是独立烧录/RTS 启动后的窗口，不拼成连续运行时长，也不计作真实断电冷启动验收。
- 原始日志、源码、sdkconfig、产物与回退备份存于 Git 忽略的 `.local/bench/2026-10-31-m2-stream/`，与构建清理目录分离。不保存或提交音乐 PCM。

## 离线检查

`python3 firmware/tests/run_host_tests.py` 通过：原协议 fixtures / 10,000 组输入，加上 20,000 次环形队列写读、独立递增帧顺序、回绕、满空拒绝、帧对齐及跨轨游标边界。开启 ASan/UBSan。合成 fixtures 不是光驱响应或播放结果。

默认关闭和本轮实验配置分别执行 `idf.py set-target esp32s3 && idf.py build`；构建结果及校验值在下方快照中记录。[ADR-0005](../decisions/0005-stream-and-buffer-bench.md) 说明每阶段、内存所有权和软件时钟模型。

## 第一轮：0.4.0，寻道失败

短探测成功，256 扇区短突发为 725783 bytes/s。之后：

```text
I (8741) cdda_bench: seek step=1/12 track=1 lba=150 sectors=8 elapsed_us=3797676 repeat=match
W (18421) usb_probe: USB status=4 ep=0x81 actual=0
I (18431) usb_probe: command=REQUEST SENSE tag=43 requested=18 LUN=0
E (21451) usb_probe: command=REQUEST SENSE transport error=ESP_ERR_TIMEOUT elapsed_ms=3020
W (21461) usb_probe: BOT recovery=ESP_OK; command probing stopped until reconnect
E (21481) cdda_bench: read failed track=13 lba=223917 sectors=8
I (21481) cdda_bench: extended bench failed (software sink only; not I2S playback)
```

- 12 个位置只完成第 1 个，轨 1、LBA 150 两次摘要一致，首次定位耗时 3.798 秒。
- 第 2 个位置是轨 13、LBA 223917，Data-In STALL 后 REQUEST SENSE 触及 3 秒截止。随后光驱离线重枚举；完整首轨与缓冲阶段未运行。
- 首版安静日志也隐藏了失败 READ CD 的 CSW 行；不补造原始 CSW。后续改为只隐藏成功行，失败状态始终记录。
- 主机采集 31.559 秒，单次 ESP 启动，光驱两次枚举；没有继续自动触发音频实验。

## 第二轮：0.4.1，完整首轨读取失败

单独关闭远距离寻道，短探测成功，256 扇区短突发 687477 bytes/s。尝试从完整首轨 INDEX 01 / LBA 0 开始：

```text
I (4811) cdda_bench: extended bench profile seeks=not_run paced_seconds=600
I (4811) cdda_bench: full-track start track=1 lba=0 sectors=19373
E (6711) usb_probe: command=READ CD transport error=ESP_FAIL elapsed_ms=1886
W (6731) usb_probe: CDDA failed track=1 lba=0 sectors=8 result=2
I (6741) cdda_bench: full-track failed track=1 bytes=0 commands=0 elapsed_us=1928868 bytes_per_sec=0 longest_read_us=0
I (6751) cdda_bench: extended bench failed seeks=not_run (software sink only; not I2S playback)
```

首个完整轨请求在 Data-In 收到 USB status=1、actual=0，EP0 恢复失败，光驱自动离线重枚举。完整轨收到的有效字节为 0；缓冲阶段未执行。主机采集 16.853 秒，单次 ESP 启动，光驱两次枚举。

这两轮表明短顺序区间可读，而改变位置后的读取失败；不能据此独断为介质、机械、电源、Hub、Full-Speed 或固件中的某一项原因。

## 第三轮：0.4.2，仅顺序衔接缓冲

明确关闭寻道和完整首轨两个阶段，日志应为 `seeks=not_run full_track=not_run`。从短探测末尾 LBA 414 接续，避免回跳到失败位置；目标是 600 秒 / 45000 扇区，不循环较短片段。单条命令仍不跨轨，目录连续时拆分后接下一轨。

缓冲容量 150528 字节（64 扇区，约 0.853 秒），预填 112896 字节（48 扇区，0.64 秒）后启动独立软件时钟任务，按实际单调时钟 176400 bytes/s 消费。两端分别 SHA-256，结束需字节数一致、摘要一致、零欠载、消费任务已结束。此处没有 DAC、I²S 或可听播放反馈。

### 第三轮结果

```text
I (605671) cdda_bench: buffer complete seconds=600 produced=105840000 consumed=105840000 underruns=0 missing_bytes=0 low_active=111460 high=148504 longest_read_us=112061 sink_max_late_us=0 transitions=2 joined=1 sink_stack_free=1096
I (605681) cdda_bench: buffer producer SHA256=ab78109b2d48ad667ce5dbe0b75412cc1ebb546e2a15f0b64b6e41b1120f6f17
I (605691) cdda_bench: buffer consumer SHA256=ab78109b2d48ad667ce5dbe0b75412cc1ebb546e2a15f0b64b6e41b1120f6f17
I (605701) cdda_bench: extended bench complete seeks=not_run full_track=not_run (software sink only; not I2S playback)
```

| 指标 | 实测 |
| --- | --- |
| 顺序区间 | LBA 414–45414（末地址排他），45000 扇区，不循环片段 |
| 软件消费时长 | 目标 600 秒，设备日志从消费启动约 5.661 秒至约 605.671 秒完成 |
| 字节数 | 生产和消费均为 105840000（105.84 MB），26,460,000 个 stereo PCM 帧 |
| 数据顺序和完整性 | 生产 / 消费完整 SHA-256 一致，所有进度快照的 produced − consumed = fill |
| 欠载 / 缺失 | 0 / 0 字节；没有补零或自动重缓冲 |
| 生产期间最低 / 全程最高水位 | 111460 / 148504 字节；最终正常排空不计入生产低水位 |
| 最长一次 READ CD 调用 | 112061 μs；不是寻道最坏延迟的界限 |
| 顺序跨轨 | 两次：轨 2 从 LBA 19373、轨 3 从 LBA 35461 开始 |
| 预填 | 112896 字节，耗时 115089 μs；启动消费前内部空闲 heap 170652 字节 |
| 消费任务退出 | joined=1；6144 字节任务栈最低余量 1096 字节 |
| 调度迟到 | 相对名义 10 ms 网格的最大正向迟到记录为 0 μs，不代表采样时钟无抖动或 I²S 精度通过 |
| 完整采集 | 620.798 秒，单次 ESP 启动，光驱枚举一次，无 USB 传输错误、离线、panic 或 brownout |

本轮满足已定义的 600 秒顺序数据流 / 软件缓冲门槛。它包含完整轨 2 的顺序区间，但不等于已通过从 LBA 0 开始的完整首轨实验。软件消费端不验证 I²S DMA、实际 44.1 kHz 时钟、左右声道或听感。后续加入音频处理时须重新核对消费任务栈余量。

## 电脑独立参考和失败位置对照

用户完全断开 Hub、等待 5 秒后改接电脑及光驱，`drutil list` 核对 UJ-898 / HC10。桥接器在电脑为 High-Speed 480 Mb/s；它与 MCU 的 Full-Speed、命令实现及供电路径不同。

通过 Audio CD 文件系统读取 AIFF-C `sowt` 数据，核对 2ch / 16-bit / 44.1 kHz；仅在内存中分块 SHA-256，不保存音乐转储。请求 `F_NOCACHE` 成功，但该路径仍不是直接 SCSI trace，也不排除光驱/桥接器自身缓存。

| PC 参考 | 实测 |
| --- | --- |
| LBA 0 / 8 扇区 | 18816 字节，399 ms，SHA-256 `c858b21ce4b78945461aee9c8afc83c58d75f20f0971d70b4407538abb3f8af6` |
| 轨 1、LBA 150 / 8 扇区 | 18816 字节，66 ms，摘要与既有参考相同 |
| 完整顺序窗口 | LBA 414–45414，105840000 字节，53032 ms，完整 SHA-256 与 MCU 生产端 / 消费端全部一致 |
| 轨 13、相对 150 / 绝对 LBA 223917 | 18816 字节，331 ms，SHA-256 `d638921c166885d310b28e6f9457c706d7c20f6d95299df64d865f3f7af90e91` |

完整 PC 参考由轨 1 相对 414 起的 18959 扇区、轨 2 的 16088 扇区、轨 3 的前 9953 扇区拼接，与 MCU 区间相同。三方完整 SHA-256 为 `ab78109b2d48ad667ce5dbe0b75412cc1ebb546e2a15f0b64b6e41b1120f6f17`。

这证明本次长区间内容和缓冲顺序正确，并确认两个失败位置在电脑路径可读；不能据此单独归因于 Hub、电源、Full-Speed、固件或某个指令参数。MCU 随机/回跳读取仍未通过，不反复复位冲击同一失败位置。

## 当前交付和下一步

固件 `0.4.2-stream-bench`，默认关闭音频及扩展实验；在电脑取样期间已刷回默认配置。用户随后恢复原 ESP32-S3 → Hub → 光驱接线，最终目录检查另在下方记录。未改变介质，没有写入、擦除、退盘或音乐转储。

用户确认当前没有 USB-C 公头 → USB-A 母口 OTG 转接头。下一次隔离实验需要这一转接头，绕过 Hub 后再对同一失败位置做受控对照；供电和接线变化需一并记录。若仍失败，再依据读盘时的实际电压/电流、桥接器/USB Host 行为决定后续，不由症状猜测根因。

当前不扩大到 I²S；首先把寻道失败隔离清楚。顺序长读及软件缓冲是本盘、本配置下的实测结果，不是整机、冷启动、故障恢复或其它介质的验收。

## 最终默认配置检查

恢复原连接后，45 秒独立采集确认 `0.4.2-stream-bench`、`CDDA probe enabled=0`，取得有效 13 轨目录；READ CD 发送数为 0，单次 ESP 启动，无传输错误。不是冷启动或长时播放验收。

## 文件与校验快照

以下相对文件均位于 `.local/bench/2026-10-31-m2-stream/`，不进入 Git。`first-run-source` / `second-run-source` / `buffer-source` 分别保存三轮源码；各自 sdkconfig 和构建目录保留，不能把后续源码回填成先前测试版本。构建路径/时间可能影响二进制，不承诺跨机器逐字节复现。

| 本地文件 | 字节数 | SHA-256 |
| --- | --- | --- |
| `stream-first.log` | 18492 | `5a20d4d9f2ce45cdacc7dbbdf0f5db34820f9f07ff5c002efb3196876a5eb5b3` |
| `stream-continuous.log` | 18439 | `7713a4234eba315b48523b48ee6fce56330d989e7cfcad1c3ec754c3c81ecbb4` |
| `stream-buffer.log` | 24208 | `75975500707d13d5efb7654b24621d6a5cc963c971bf455777c18ef07de59f54` |
| `pc-stream-reference.json` | 1856 | `65673c4ff46a13af968906e89cc93c06883e57e7484dabb7d22ed7af1d42a345` |
| `final-restored.log` | 9247 | `41b713d1f4f4ed180e58d1db6421c1047080632f7c064c054cc183c37d63a0bf` |
| `before-flash.bin` | 1114112 | `37b8994e04e675b468afb2ba196adcb7c5626f87273f842663d0fba1832f3efe` |
| `soak-build/discora.bin` | 297776 | `50f30c1bfe181a45f3336d26086b73ab2b07199d01d5b41c0dff93a6ac8f461d` |
| `continuous-build/discora.bin` | 298080 | `440c459efbc41613b1b9e843f877c3664f5e26b3e847c1a504d0194f0a704b1d` |
| `buffer-build/discora.bin` | 298272 | `d8eedadeeae335ac821e63b88733034c62e01bd64f465b0079c89b611454946f` |
| `buffer-build/discora.elf` | 4548420 | `8daee9ca28a2247900285e8918aaba1e59ff5d02ece26e0437d93c9f562e2017` |
| `final-default-build/discora.bin` | 279504 | `4b90f7f872933e463a9af916baff15702a81345610f30061444a16085487f62d` |
| `final-default-build/discora.elf` | 4301148 | `8f12c858c59e41ecb1411d6973170701d30dde49998f8549648d491abc018c7d` |

烧录前的 0x0–0x110000 回退备份已提取 279472 字节应用并匹配既有 0.3.1 默认关闭镜像的 SHA-256；本轮所有代码写入范围均在该备份范围内，不称其为整个 16 MB Flash 的备份。

| 当前源码 | SHA-256 |
| --- | --- |
| `firmware/main/usb_probe.c` | `b52f19ecfa7359c0a7e9fe6b3aa41de11e241c78b8bdc65ce7d8b8e6387e1efc` |
| `firmware/main/cdda_bench.c` | `0bc8cf258ee58a3861514514e5bae6ac69387c17f8fbeae407c8019340ce2d48` |
| `firmware/main/cdda_bench.h` | `6e90fff7d47fe70f5a3a17406b95829318be52f7069618e4853177313681ce05` |
| `firmware/main/cdda_cursor.c` | `ce1446372ef61b3001a3a5bfb86aa01fb33a40016f9be8252031d53e5b36574b` |
| `firmware/main/cdda_cursor.h` | `75166202eefbe89cef8dc183c67d5290914e38002110aae960650ce9aa3e7839` |
| `firmware/main/pcm_buffer.c` | `a4fcf7495916a2471267ce604234d57a2c67624c6186606ea7027250d1ef1cc6` |
| `firmware/main/pcm_buffer.h` | `36468888d80bc96801128e8c697bfc93cac7efa7dae080864e597245548eda4c` |
| `firmware/main/Kconfig.projbuild` | `a2300673d7b1554b417cf79aa9d2c81c950fb51e59d2e983f5376bbce81dbdcd` |
| `firmware/main/CMakeLists.txt` | `f225b9d419f464586efd045785f4bfd980fae9e197ee46532dd90e443769cea1` |
| `firmware/CMakeLists.txt` | `a733953dec38cd0d17ad4495feabded20816b00e0d213eede4670ac7bf453dde` |
| `firmware/tests/stream_core_test.c` | `f23040144fc4599f81f444b1eaa2edcb92362a6d4b11ee2d029a32c81bd9b633` |
| `firmware/tests/run_host_tests.py` | `0cdb54b29ec0b61a3abf03f2766bc515410c08f4ce5daf1eb7f9a175b121ddba` |
