miclle/discora/docs/records/2026-10-31-m2-toc.md

# 2026-10-31：M2 音乐 CD 曲目目录实测

结论：**READ TOC 在本次 UJ-898 / HC10 + `13fd:0840` 组合上 bench-tested**。用户确认介质为音乐 CD；取得 13 条音频轨、0 条数据轨和 lead-out LBA 252645。尚未实施 READ CD、参考 PCM 对比或 I²S，M2 未整体完成。

## 硬件与操作

- ESP32-S3 rev v0.2，芯片已报告 16 MB Flash / 8 MB PSRAM；精确开发板版本未确认。
- 仅匹配此前确认的 Discora USB Single Serial（`1A86:55D3`）并核对序列号后操作；其它项目串口未打开、复位或烧录。
- UGREEN 无独立电源 Hub：`05e3:0610`、Full-Speed；USB 桥接器：`13fd:0840`、Full-Speed、class/subclass/protocol `08/02/50`、IN `81` / OUT `02`、MPS 64、LUN 0。
- INQUIRY：`MATSHITA` / `DVD-R   UJ-898` / `HC10`，PDT 05、qualifier 0。
- 原连接保持：COM 接电脑，native USB 经已桥接 USB-OTG 的板卡连接 Hub；Y 线主头接 Hub，辅助头接已开启的充电宝。按用户要求暂缓 Y 线内部隔离测量；隔离、负载电压/电流仍未验证，不从本次查询成功推断电源路径安全或长期能力。
- CD 标签、版本和压盘编号未提供；以本次 TOC 元数据识别实验介质，不推断专辑或曲名。
- 烧录后在同一 COM 以 RTS 复位并采集 125 秒；不是断电冷启动验收。未要求拔插或换盘。

## 固件与离线检查

| 项目 | 结果 |
| --- | --- |
| 应用版本 | `0.2.0-toc-probe`，工作区未提交版本 |
| SDK / 编译器 | ESP-IDF v5.4（`67c1de1eeb`），Xtensa GCC 14.2.0 |
| 构建 | `idf.py set-target esp32s3 && idf.py build` 通过 |
| 应用大小 | 278,928 字节（`0x44190`）；1 MiB app 分区约 73% 空闲 |
| 配置 | UART0 115200，secondary console none，main stack 8192；外部 / 多级 Hub enabled |
| 主机侧测试 | C11 + ASan/UBSan 通过：命令字节、TOC 截断/畸形/99 轨/混合轨，以及 10,000 组边界输入；合成 fixtures，不替代实机 |
| 烧录 | esptool 460800，bootloader / partition / app 写入及校验成功 |

镜像仍声明 2 MB Flash，而器件检测为 16 MB；启动警告后使用 2 MB 映射。本轮无大容量存储需求，未扩大分区或改写其它区域；此警告不是容量已验证可用的证明。

## 真实响应和目录

两次 READ TOC 都使用格式 0、MSF=0，ATAPI CDB 补齐 12 字节。先请求 4 字节，返回头 `00 72 01 0d`；长度 `0x0072 + 2 = 116`，与 13 条轨道加一个 lead-out 一致。完整响应请求和收到均为 116 字节。两条命令均 CSW=0、residue=0、耗时 7 ms，两个响应头一致。完整目录通过序号、ADR、长度及 LBA 校验。

真实 UART 摘录：

```text
I (1435) usb_probe: command=READ TOC CSW=0 received=4 residue=0 elapsed_ms=7
I (1445) usb_probe: TOC header first=1 last=13 total_bytes=116
I (1455) usb_probe: command=READ TOC CSW=0 received=116 residue=0 elapsed_ms=7
I (1505) usb_probe: TOC validated first=1 last=13 tracks=13 audio=13 data=0 lead_out_lba=252645
I (1655) usb_probe: TOC metadata only; PCM audio not read
```

以下均为设备目录给出的 INDEX 01 起点及相邻区间。末 LBA 为排他边界；时长为 `MM:SS:FF`，每秒 75 帧，可能含轨间间隙，不等同于已经提取或听取的音频时长。所有曲目 CONTROL=02，音频/数据位未置位；尚未据此验证声道或音频质量。

| 曲目 | 起始 LBA | 末 LBA（排他） | 扇区数 | 分:秒:帧 |
| --- | --- | --- | --- | --- |
| 1 | 0 | 19373 | 19373 | 04:18:23 |
| 2 | 19373 | 35461 | 16088 | 03:34:38 |
| 3 | 35461 | 57828 | 22367 | 04:58:17 |
| 4 | 57828 | 78482 | 20654 | 04:35:29 |
| 5 | 78482 | 92315 | 13833 | 03:04:33 |
| 6 | 92315 | 111837 | 19522 | 04:20:22 |
| 7 | 111837 | 123493 | 11656 | 02:35:31 |
| 8 | 123493 | 150878 | 27385 | 06:05:10 |
| 9 | 150878 | 176099 | 25221 | 05:36:21 |
| 10 | 176099 | 195395 | 19296 | 04:17:21 |
| 11 | 195395 | 206588 | 11193 | 02:29:18 |
| 12 | 206588 | 223767 | 17179 | 03:49:04 |
| 13 | 223767 | 252645 | 28878 | 06:25:03 |

总区间为 252645 扇区，即 **56:08:45**（约 56 分 9 秒）。本轮没有独立 PC 参考目录，不能把一致的解析当作参考对照已完成。

## 连续观察结果

- 125 秒采集内只出现一次 ESP 启动；TUR 从启动后 1425 ms 到 124055 ms 连续 25 次成功，首尾跨度 122.630 秒，失败 0 次。
- Hub 和光驱各枚举一次，无光驱离线、BOT transport error、panic 或 brownout。Hub 的 `device closed` 是本探测 client 释放 Hub handle，底层 Hub 服务继续处理光驱。
- 一次成功目录读取后只轮询就绪，不在同一窗口反复读取 TOC；本次不是换盘、重复插拔、故障恢复或长时间播放测试。

## 原始文件、校验值与备份边界

本轮原始日志、摘要、源码/构建快照均保存在 Git 忽略的 `.local/bench/2026-10-31-m2-toc/`，与 build 目录分离，不提交可能含个人信息的原始文件。

| 本地相对路径 / 产物 | 字节数 | SHA-256 |
| --- | --- | --- |
| toc-first-capture.log | 12,540 | `8afc0b056b8919fd512b373c7a3bf1ec8564ec87b405b10801988a67fb295cf9` |
| 当前 M1 Flash 范围备份 0x0–0x110000 | 1,114,112 | `969e273bb8fb9102d3517eb5a33b1bbda9a1e5b125220f3a90967df34bd2ff6c` |
| 从 Flash 提取的 M1 app | 277,008 | `f9a7f0efa33ade4ec661927009ecf0d50a1973b82e49f87ac7070c6788648a38` |
| M2 app | 278,928 | `fb74f9e122c71c2a843449311e95df3bff04b7b912c40244214cbffdaafc02f7` |
| M2 ELF | 4,298,476 | `37ce6051dfcf6ea556cf805a8ecb3d594fae51b9f470f0462c65784b9763a340` |

**历史证据丢失更正**：本轮 `set-target` 触发 fullclean，误删了原来存放于 `firmware/build/` 的 M1 原始日志、统计文件、M1 ELF、首次烧录前备份及构建日志。此前文档中的摘录、统计和散列仍保留，但原始采集已无法重新核验，首次烧录前固件已不能恢复；没有重构或补造原始日志。

在本次 M2 烧录前，已从目标设备读取 1,114,112 字节（`0x0–0x110000`）作为当前 Discora M1 的回退备份，并从偏移 `0x10000` 提取 277,008 字节 M1 应用，其 SHA-256 与历史记录一致。这恢复了当前 M1 的应用镜像，**不能替代丢失的首次烧录前备份或原 M1 ELF**。该范围覆盖本次所有写入范围，不是整个 16 MB Flash 的备份。后续恢复仍需核对本项目串口身份，不会自动执行回退。

## 当前源码快照

该快照与本次 M2 构建相对应。时间、绝对构建路径等可能影响产物，不承诺跨机器逐字节复现。

| 文件 | SHA-256 |
| --- | --- |
| `firmware/main/usb_probe.c` | `af7ba4b49798a8719548a2d2e25eb5abcd80662e1b02efb4e1dfb54713fa2371` |
| `firmware/main/probe_protocol.c` | `2dd867102fd66110aa83dbfffdb5c9ab82b270d69b0d3cc4b2580d8f7f828856` |
| `firmware/main/probe_protocol.h` | `afb10ac7aa52b6ee831430d86dacffb63e861f47cfda7c546e7f3b86d5c95252` |
| `firmware/main/main.c` | `9760c76909e37482a4faaa3fcf4c6a34bf13bd32dba9aff0468fbb22fc0f5aac` |
| `firmware/main/usb_probe.h` | `ad4d0539894ac73e2b4f903196370ee2e71762361657469fa7ba55a3d558e8f7` |
| `firmware/main/CMakeLists.txt` | `b26bfbbe61c9b1d0e1f7a5a345f98f2c5c6882d5cb7c762654a1948dc324d9cd` |
| `firmware/CMakeLists.txt` | `f90e17e72dff67423394e32bea9e5c9280c24b5fce76ca2c4663c6bd65cc2d6b` |
| `firmware/sdkconfig.defaults` | `daa84db482dc21f12f4d27e71c660102dd21e6adcdab54cf332dc00adeb5f714` |
| `firmware/tests/probe_protocol_test.c` | `d324065f48b5be5ee83ace042bca10eb1f11052c42485a6853ff0359ec4d112e` |
| `firmware/tests/run_host_tests.py` | `258e5c0920e7b82a8c76a804154ad0584f307ed8ba33b1623d5bc038c4b96e21` |

## 下一步

在目录确认的音频轨边界内实现受限 READ CD，从少量 2352 字节扇区开始，记录 LBA、扇区数、实际长度、CSW/sense、耗时和非音频内容的摘要，再与独立参考提取核对。随后实测持续吞吐和最长停顿，不能以 USB 理论带宽或本次 TOC 成功代替音频读取验证。现有硬件足够继续该阶段；I²S 输出阶段才需要立体声 DAC 和监听设备。M1 的受控无盘/有盘、10 次插拔、5 次真实冷启动及故障恢复验收仍开放。

## 后续对照

后续电脑端逐轨起点和 lead-out 已与本次目录一致，并取得 READ CD 小片段及短突发结果；见 [M2 READ CD 记录](2026-10-31-m2-cdda.md)。以上保留为目录阶段的原始范围，不将后续测试回填为本次窗口内已完成。
