miclle/discora/hardware/enclosure/bottom-corners.png

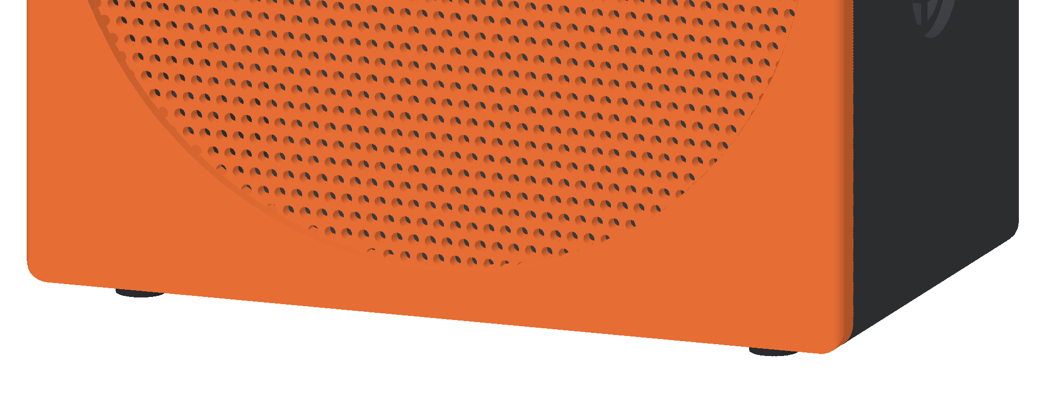
hardware/enclosure/bottom-corners.png
