miclle/discora/hardware/enclosure/controls.png

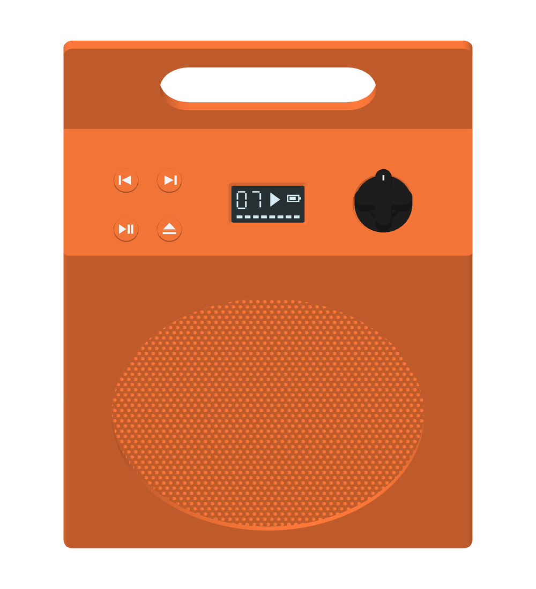
hardware/enclosure/controls.png
