miclle/discora/hardware/enclosure/drawings/exploded-core-color.png

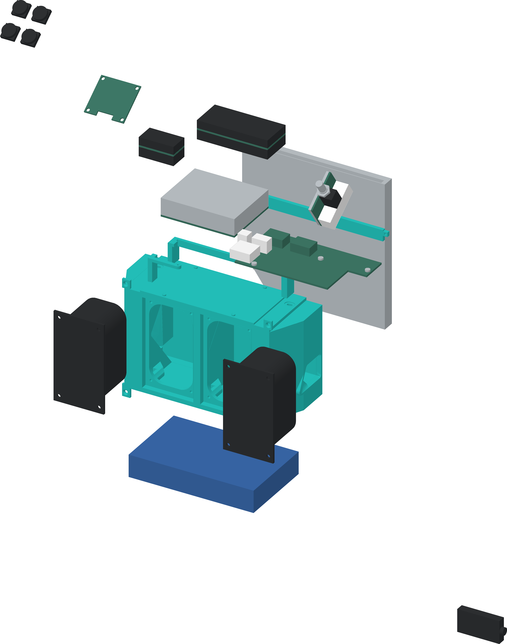
hardware/enclosure/drawings/exploded-core-color.png
