miclle/discora/hardware/enclosure/drawings/exploded-shell-color.png

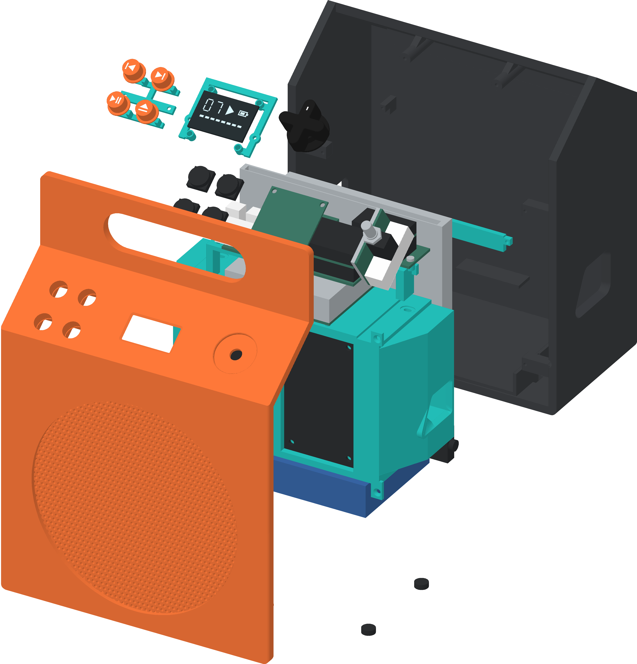
hardware/enclosure/drawings/exploded-shell-color.png
