miclle/discora/hardware/enclosure/drawings/front-color.png

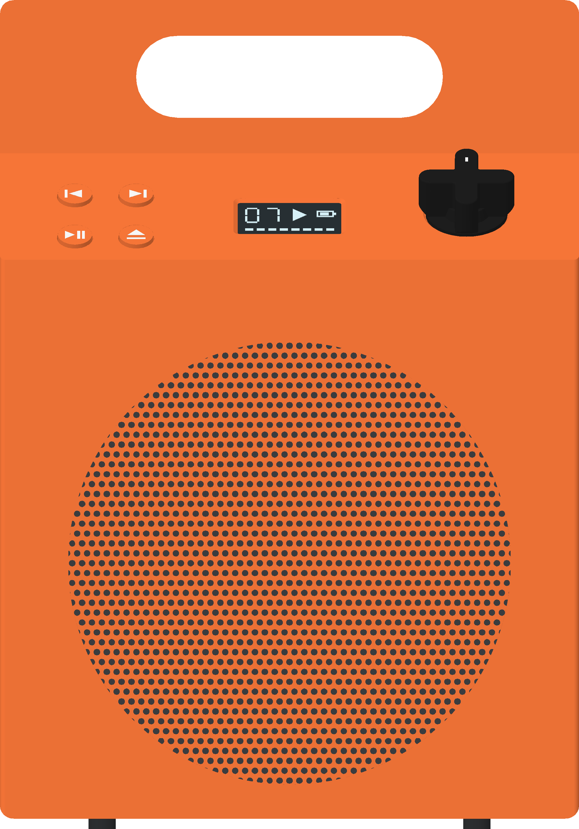
hardware/enclosure/drawings/front-color.png
