miclle/discora/hardware/enclosure/drawings/front-harness-preview.png

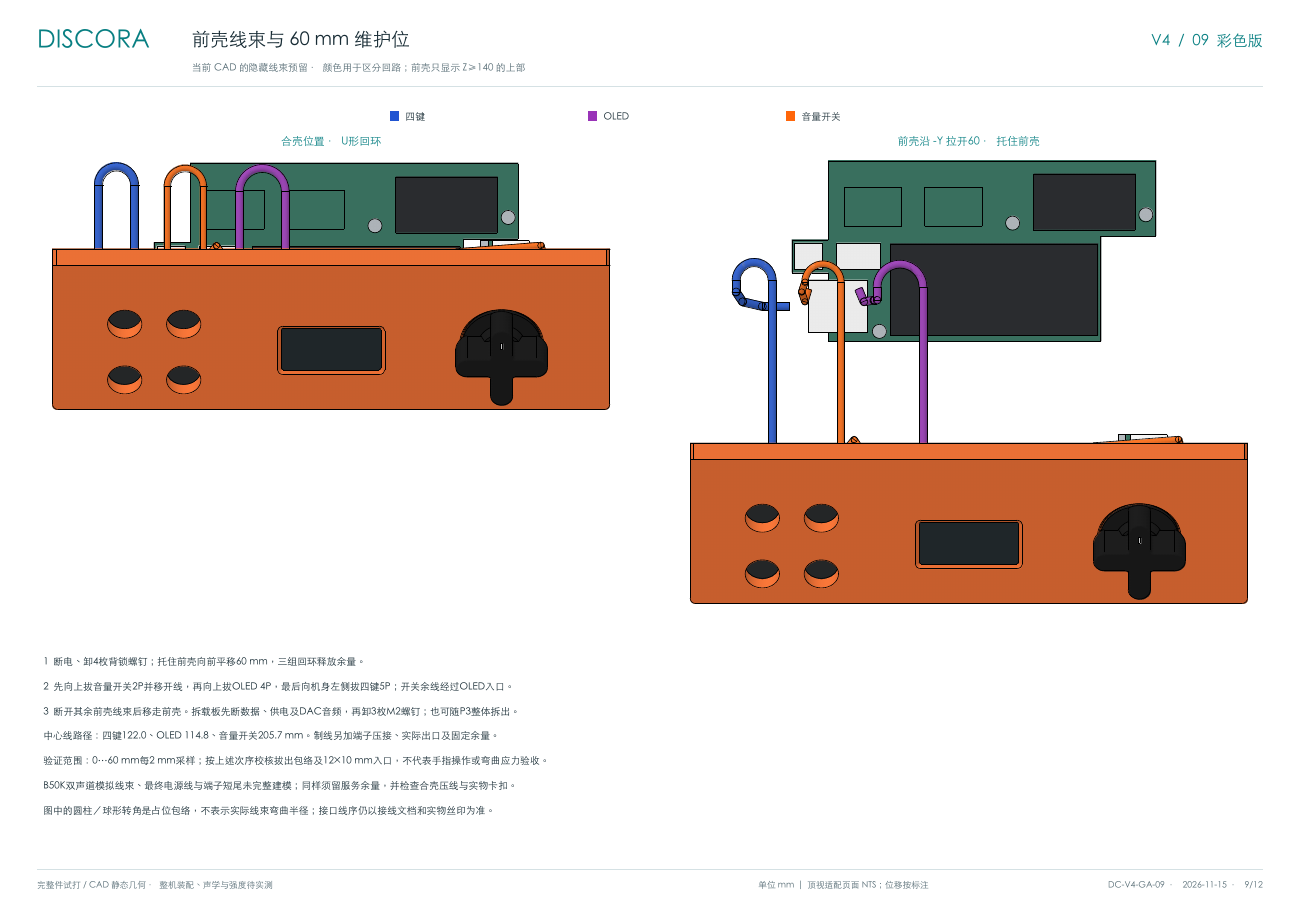
hardware/enclosure/drawings/front-harness-preview.png
