miclle/discora/hardware/enclosure/drawings/harness-closed-color.png

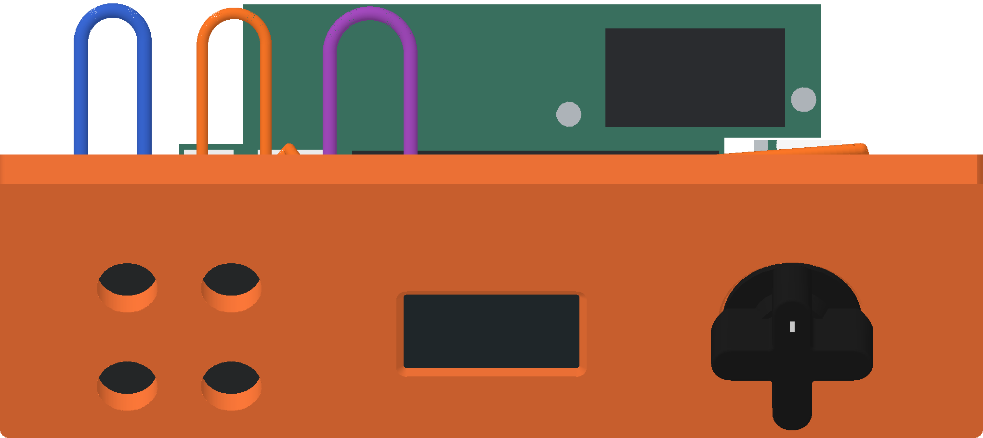
hardware/enclosure/drawings/harness-closed-color.png
