miclle/discora/hardware/enclosure/drawings/harness-open-color.png

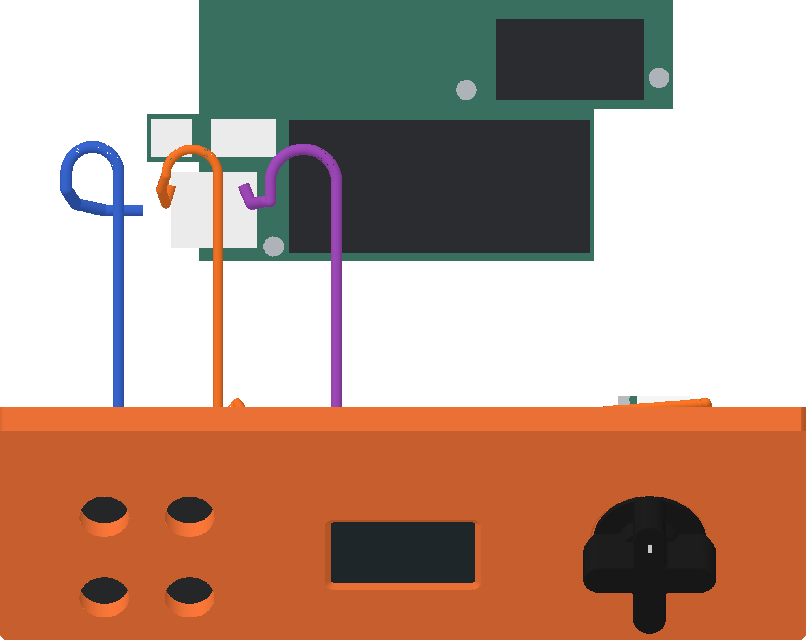
hardware/enclosure/drawings/harness-open-color.png
