miclle/discora/hardware/enclosure/drawings/oled-dimensions-preview.png

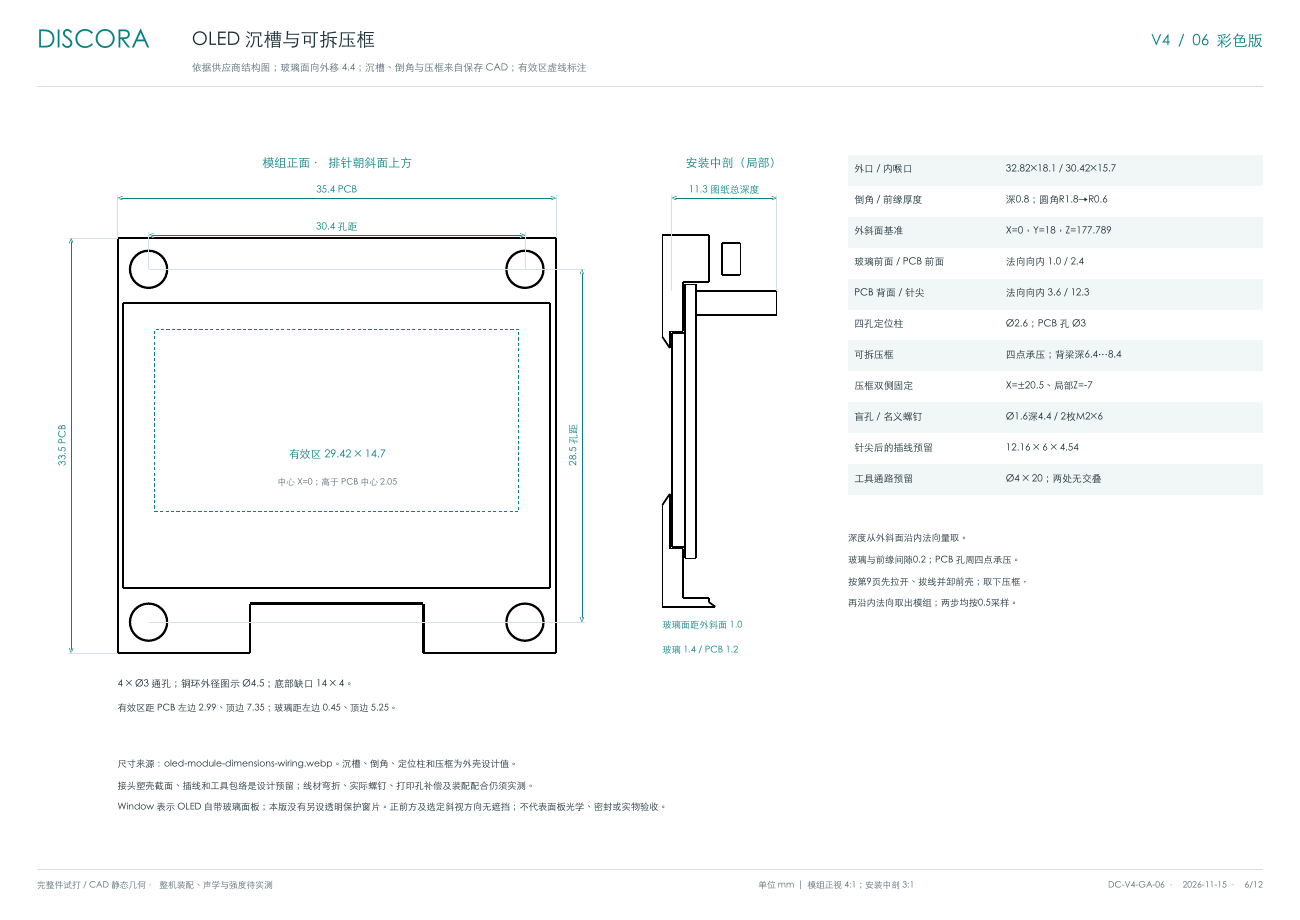
hardware/enclosure/drawings/oled-dimensions-preview.png
