miclle/discora/hardware/enclosure/drawings/p2-interior-color.png

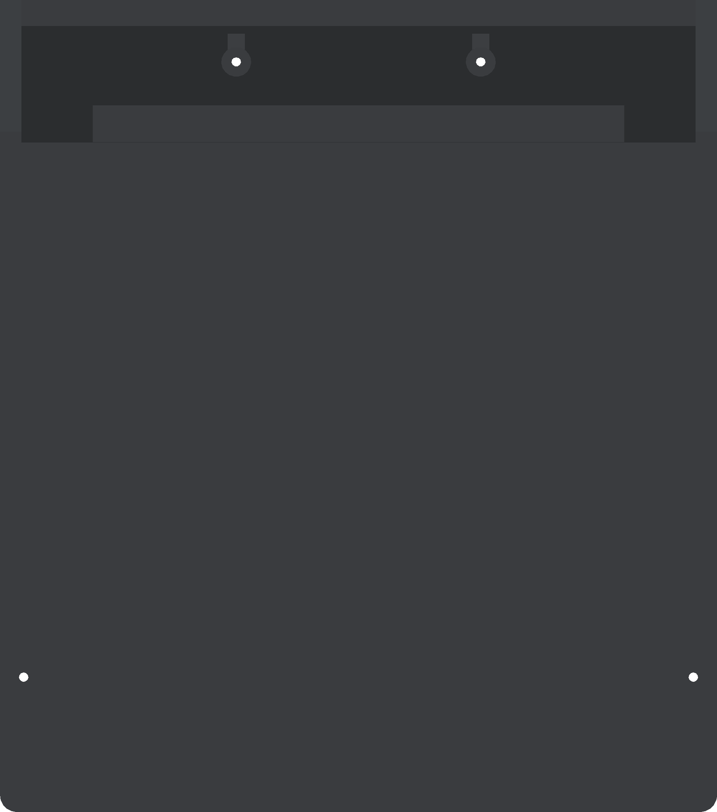
hardware/enclosure/drawings/p2-interior-color.png
