miclle/discora/hardware/enclosure/drawings/perfboard-layout-color.png

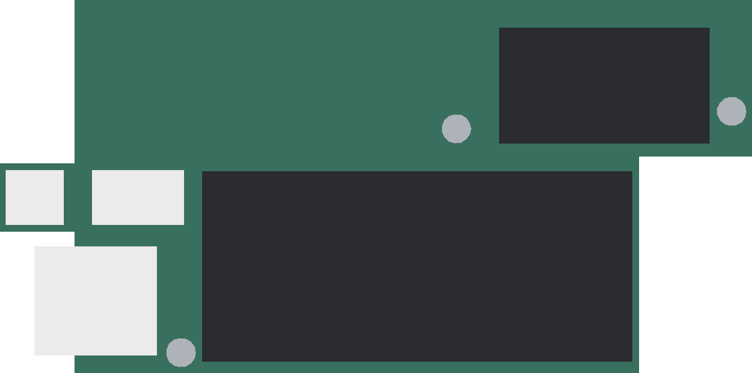
hardware/enclosure/drawings/perfboard-layout-color.png
