miclle/discora/hardware/enclosure/drawings/perfboard-layout-preview.png

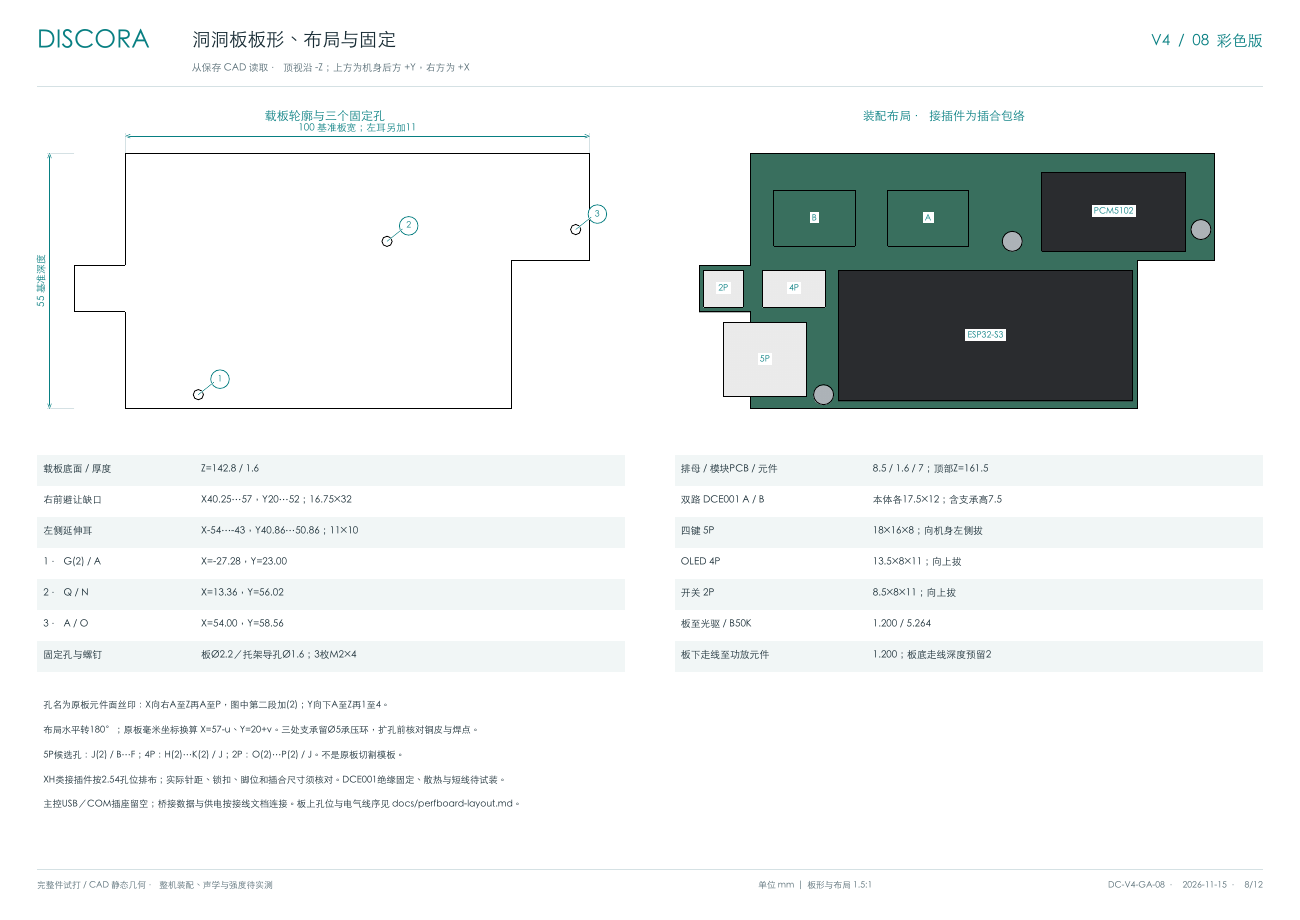
hardware/enclosure/drawings/perfboard-layout-preview.png
