miclle/discora/hardware/enclosure/drawings/rear-color.png

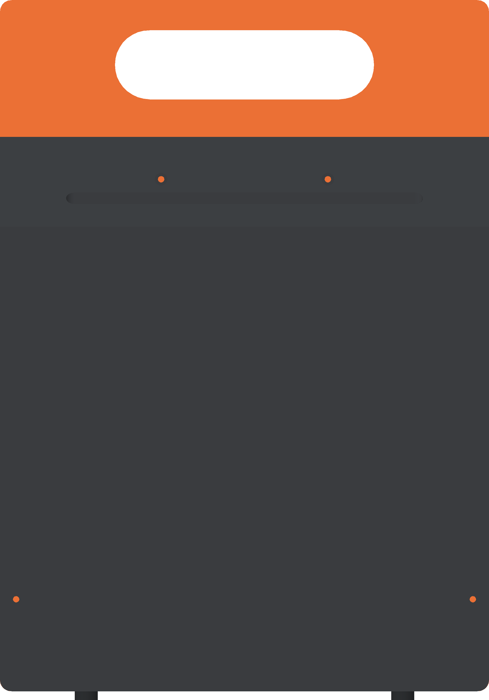
hardware/enclosure/drawings/rear-color.png
