miclle/discora/hardware/enclosure/drawings/right-color.png

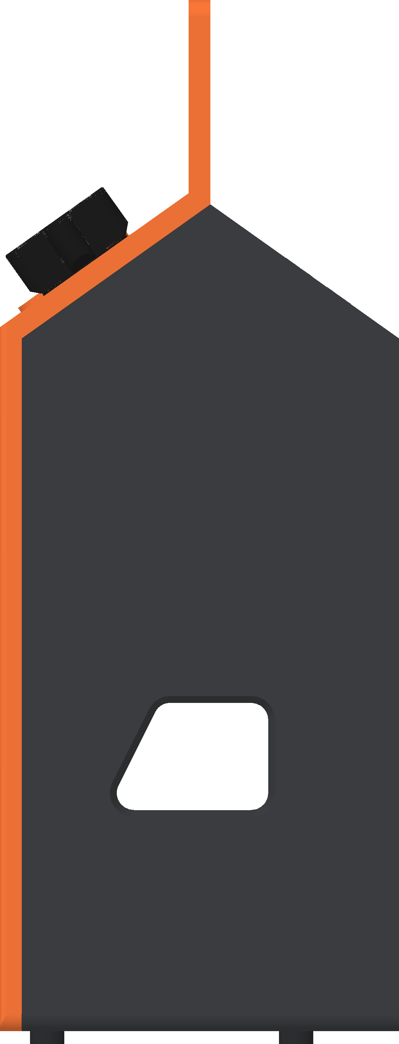
hardware/enclosure/drawings/right-color.png
