miclle/discora/hardware/enclosure/drawings/section-color.png

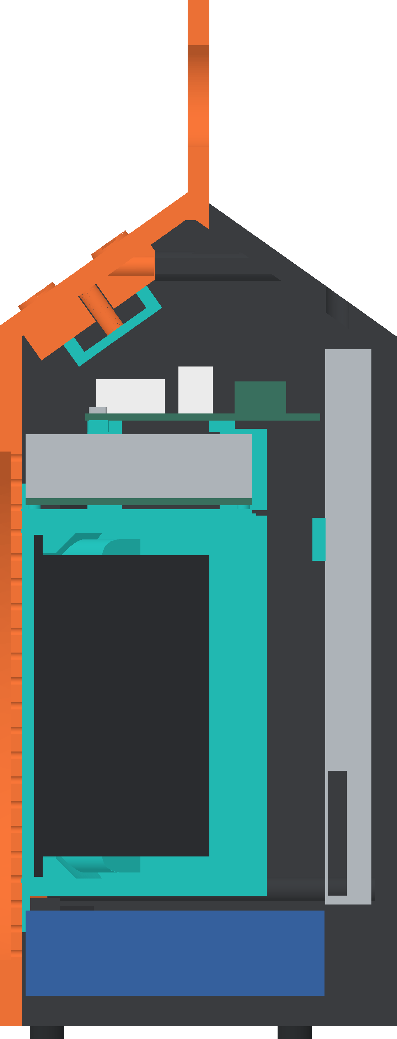
hardware/enclosure/drawings/section-color.png
