miclle/discora/hardware/enclosure/drawings/top-color.png

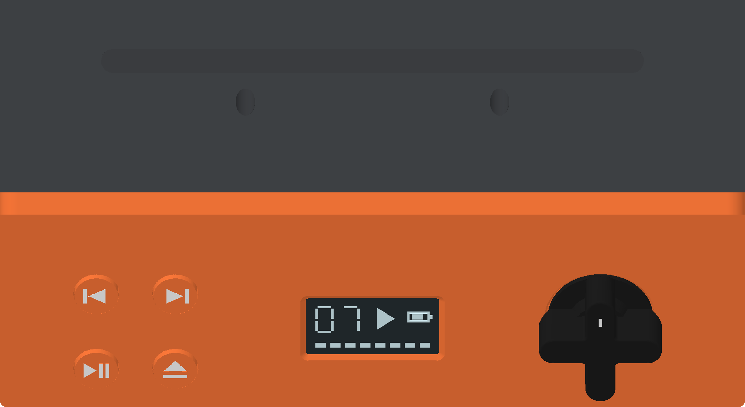
hardware/enclosure/drawings/top-color.png
