miclle/discora/hardware/enclosure/drawings/volume-module-preview.png

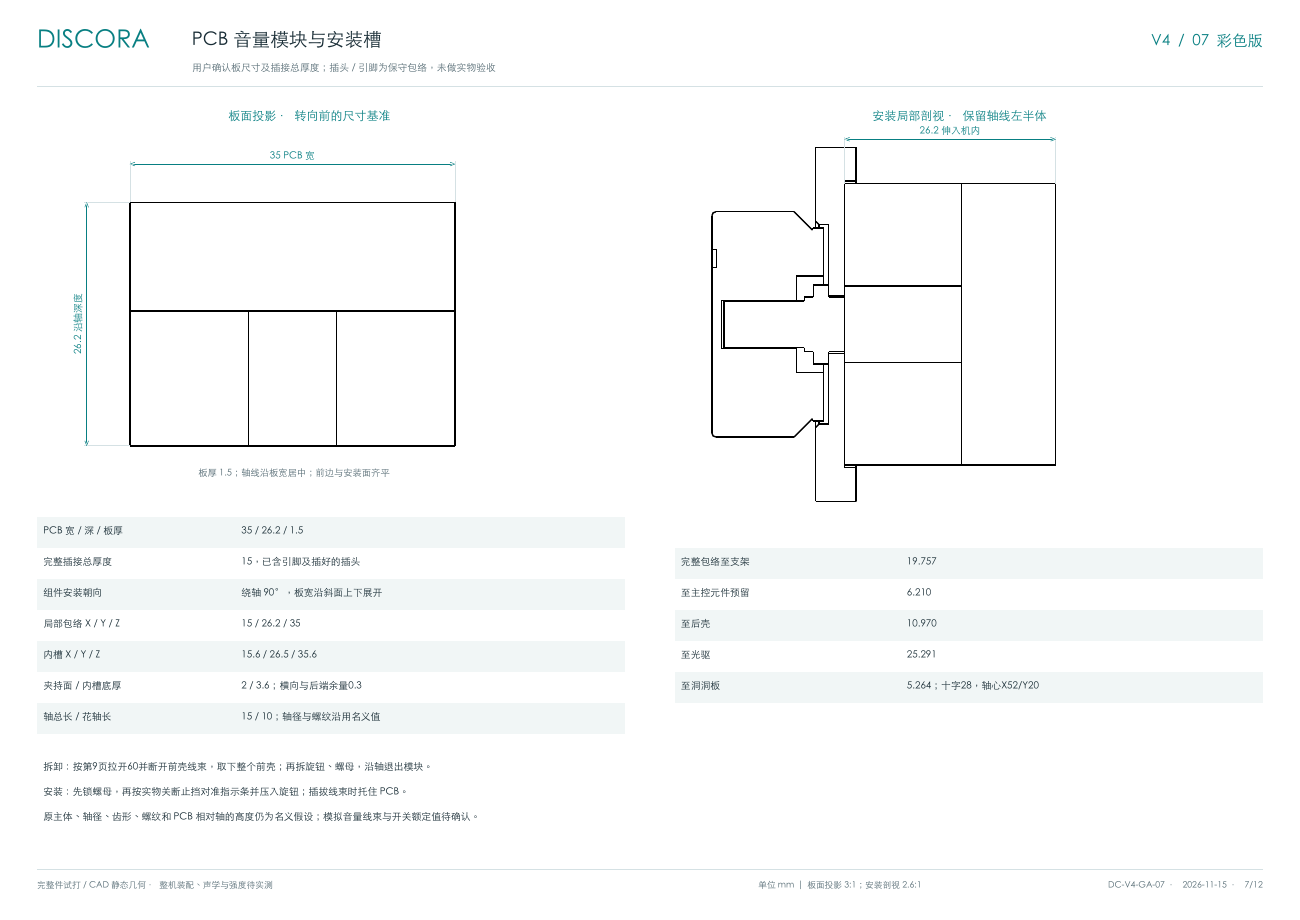
hardware/enclosure/drawings/volume-module-preview.png
