miclle/discora/hardware/enclosure/drive-mount.png

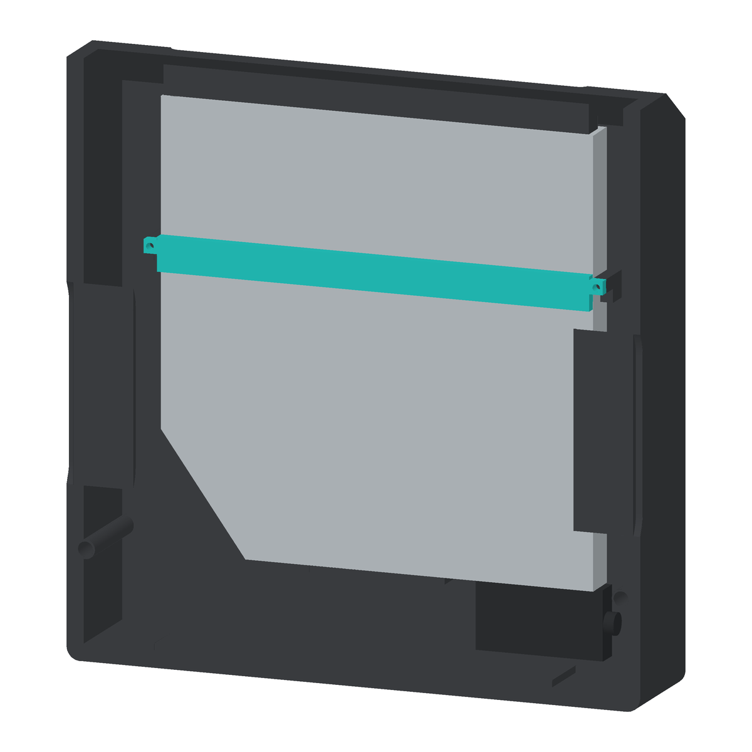
hardware/enclosure/drive-mount.png
