miclle/discora/hardware/enclosure/front.png

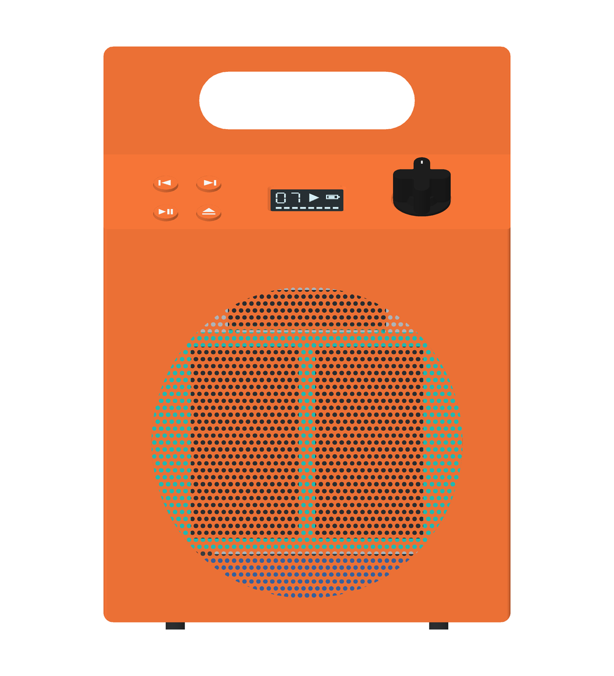
hardware/enclosure/front.png
