miclle/discora/hardware/enclosure/grille-detail.png

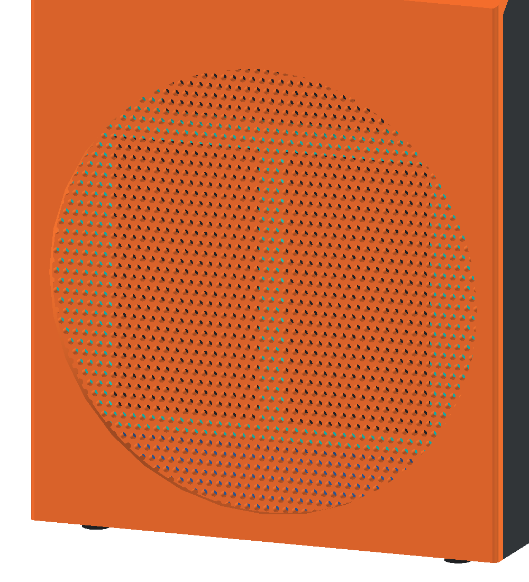
hardware/enclosure/grille-detail.png
