miclle/discora/hardware/enclosure/layout.png

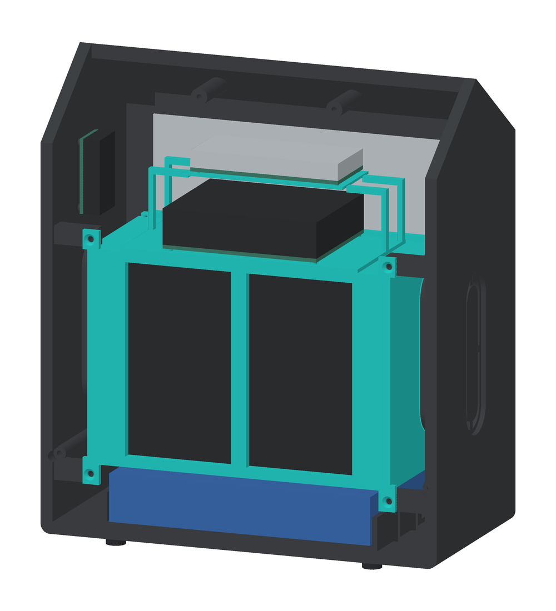
hardware/enclosure/layout.png
