miclle/discora/hardware/enclosure/oled-front-detail.png

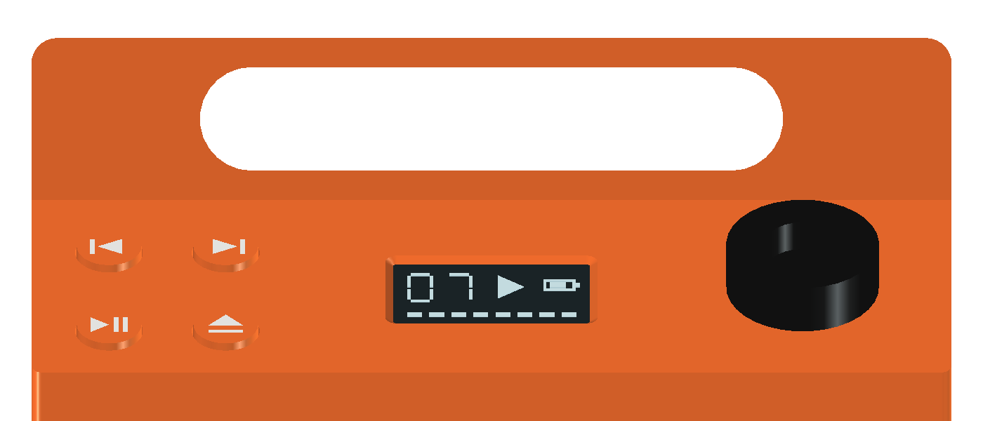
hardware/enclosure/oled-front-detail.png
