miclle/discora/hardware/enclosure/oled-mount.png

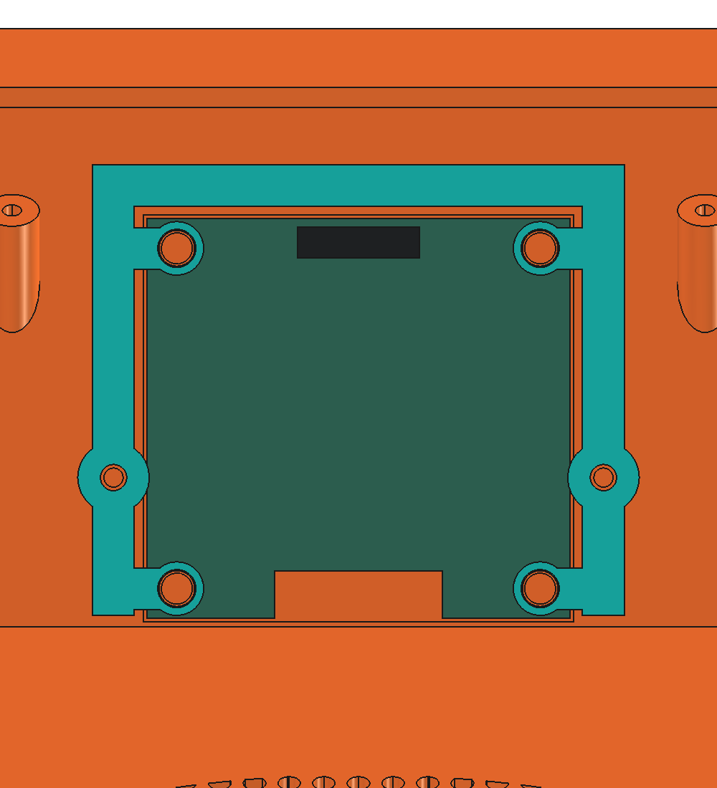
hardware/enclosure/oled-mount.png
