miclle/discora/hardware/enclosure/perfboard-service.png

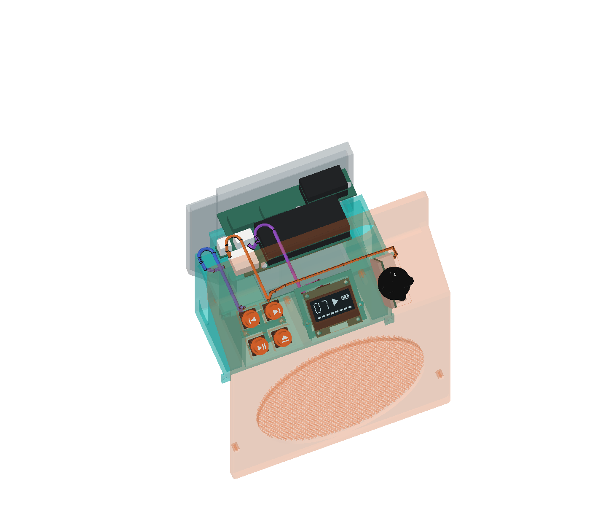
hardware/enclosure/perfboard-service.png
