miclle/discora/hardware/enclosure/section.png

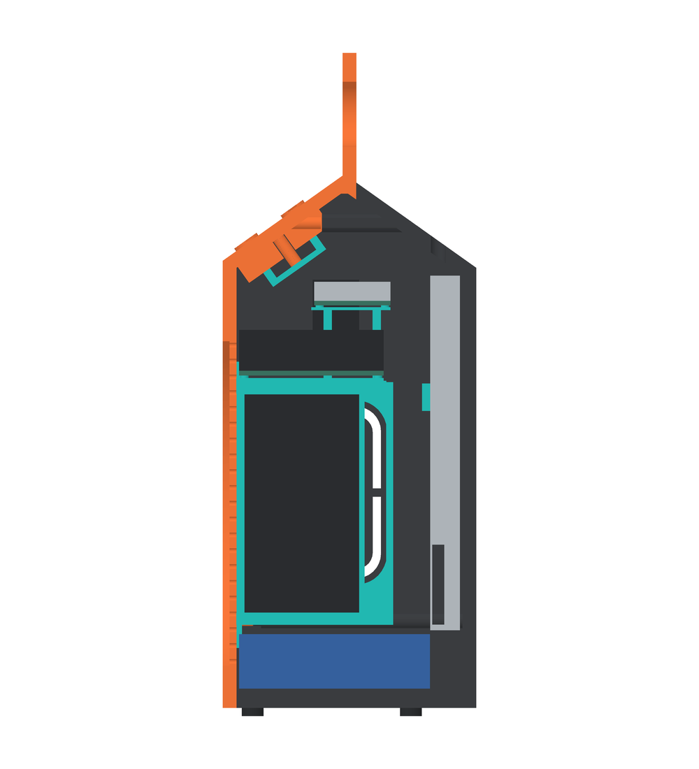
hardware/enclosure/section.png
