miclle/discora/hardware/enclosure/side-port-detail.png

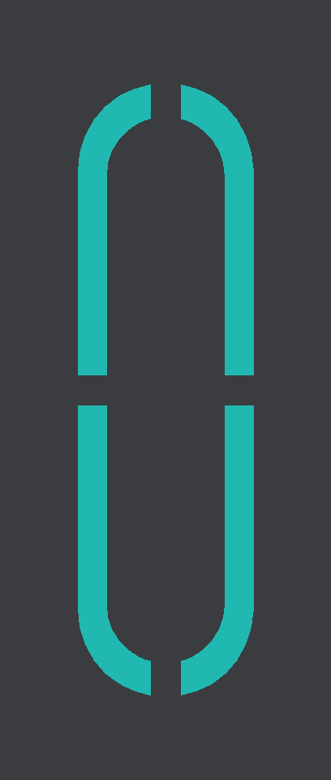
hardware/enclosure/side-port-detail.png
