miclle/discora/hardware/enclosure/side-seam-comparison.png

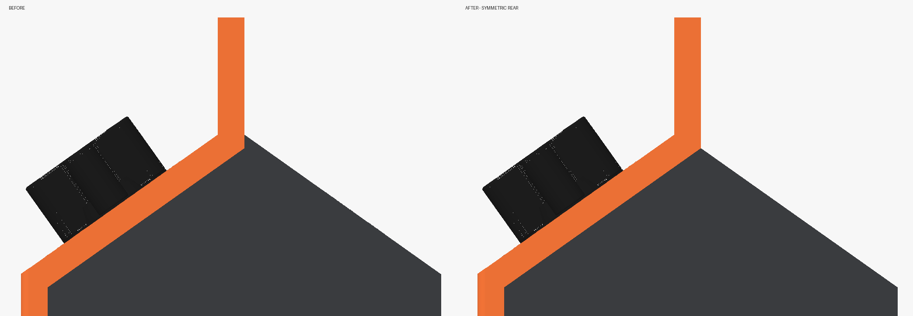
hardware/enclosure/side-seam-comparison.png
