miclle/discora/hardware/enclosure/side.png

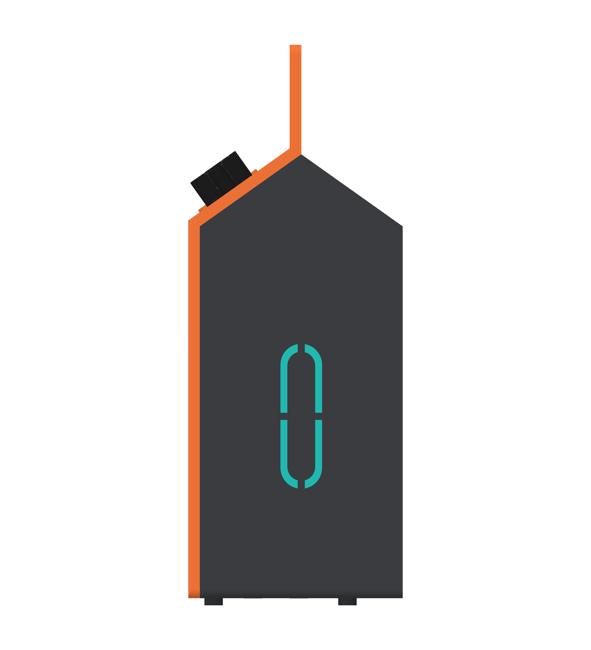
hardware/enclosure/side.png
