miclle/discora/hardware/enclosure/topload.png

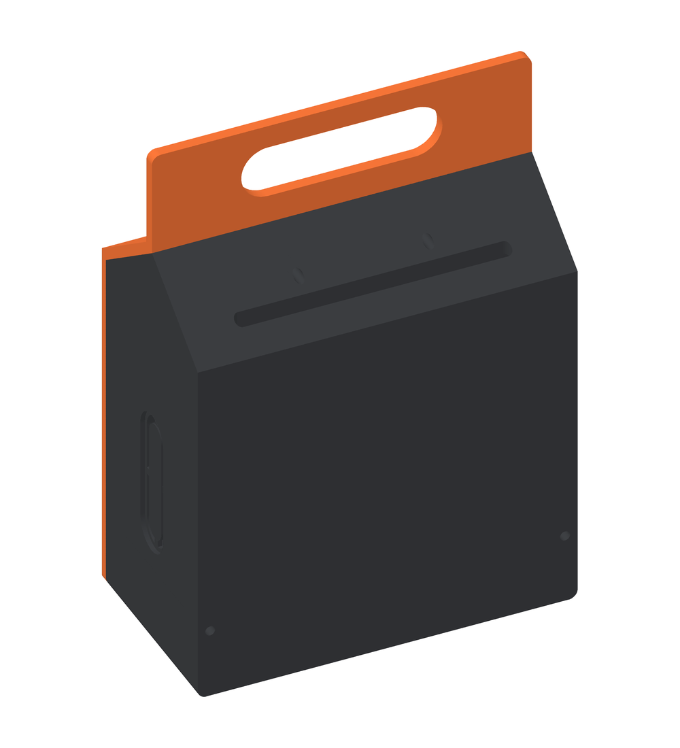
hardware/enclosure/topload.png
