miclle/discora/hardware/enclosure/volume-detail.png

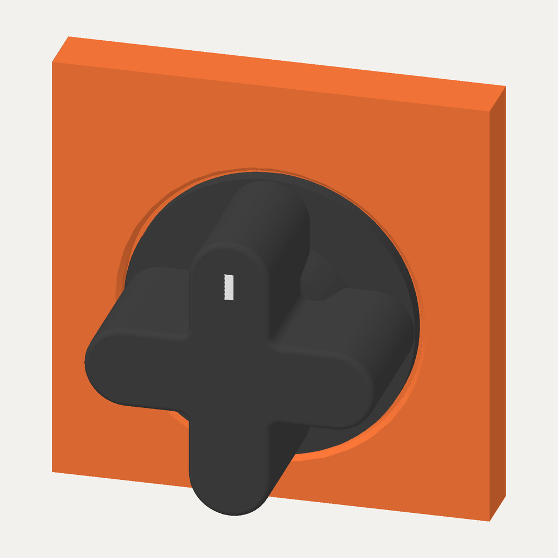
hardware/enclosure/volume-detail.png
