miclle/discora/hardware/enclosure/volume-mount.png

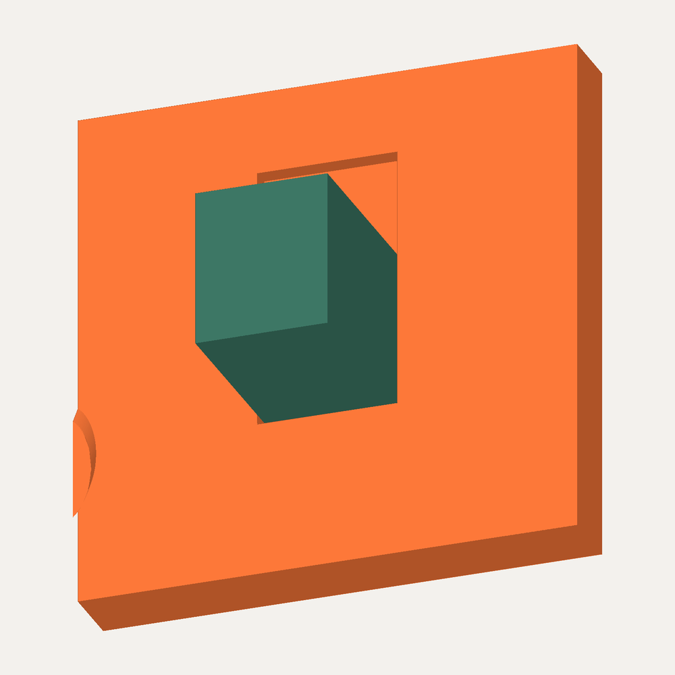
hardware/enclosure/volume-mount.png
