miclle/discora/hardware/enclosure/volume-pcb-mount.png

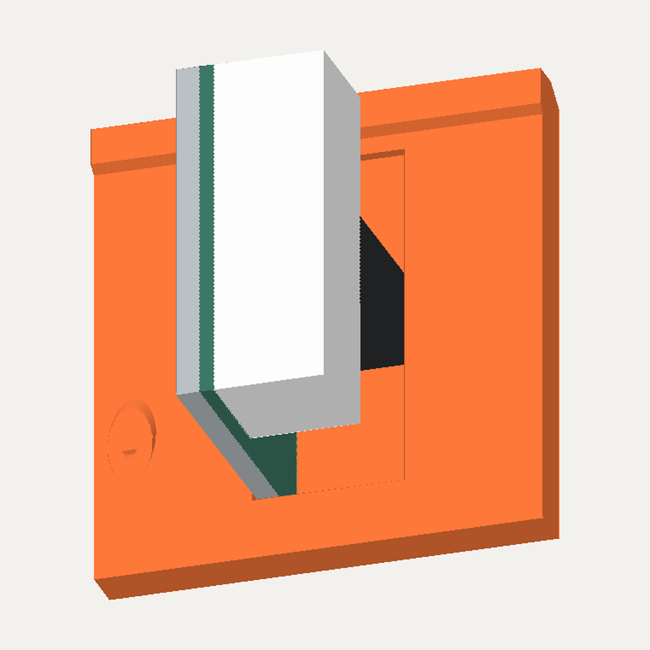
hardware/enclosure/volume-pcb-mount.png
