miclle/discora/hardware/OLED-1.3-128x64/oled-module-interfaces.webp

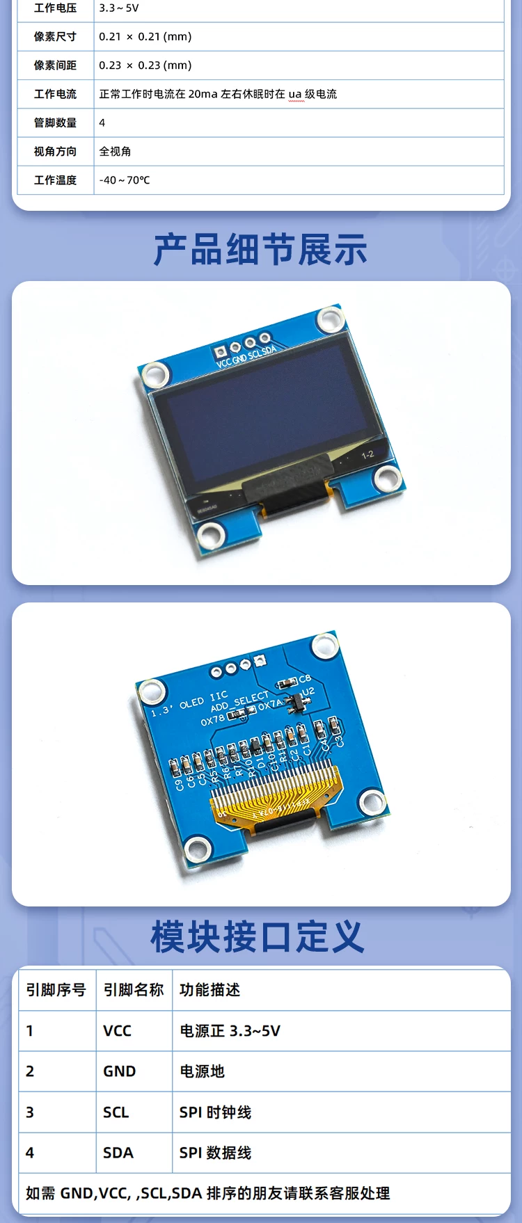
hardware/OLED-1.3-128x64/oled-module-interfaces.webp
