miclle/discora/hardware/Potentiometer-B50K-Switch/pcb-module-reference.jpg

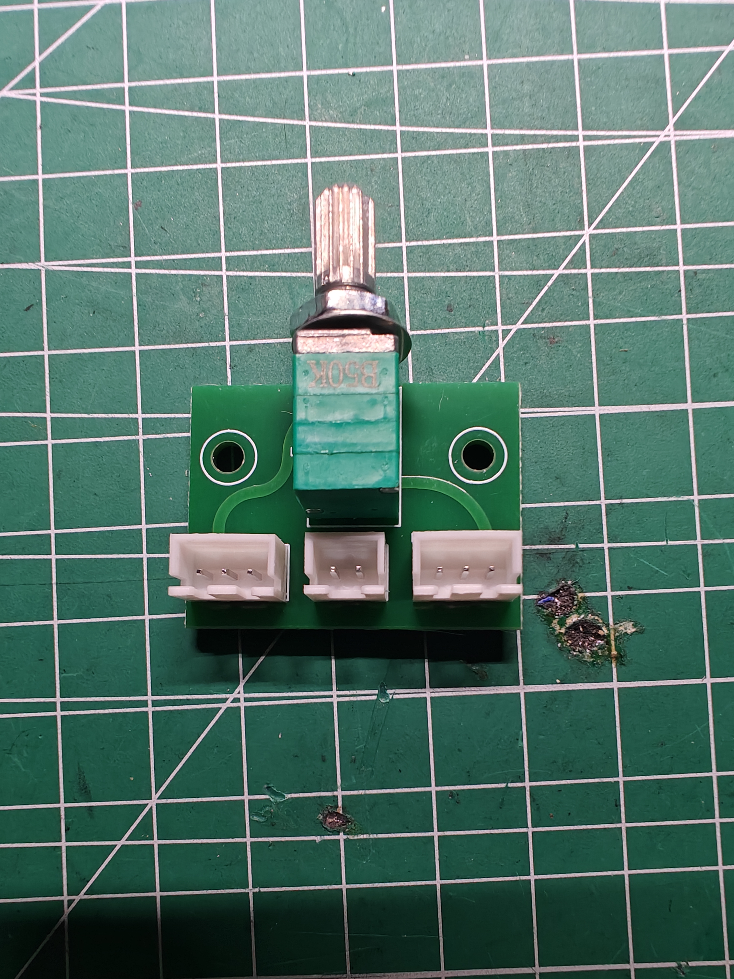
hardware/Potentiometer-B50K-Switch/pcb-module-reference.jpg
