miclle/discora/hardware/TPA3118D2/amplifier-back-dimensions.jpg

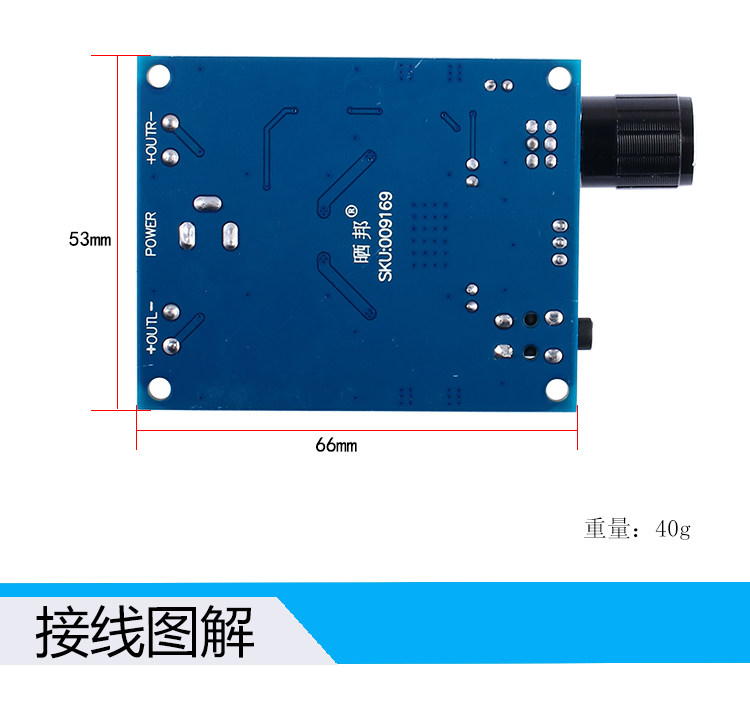
hardware/TPA3118D2/amplifier-back-dimensions.jpg
