miclle/discora/hardware/TPA3118D2/amplifier-front-connections.jpg

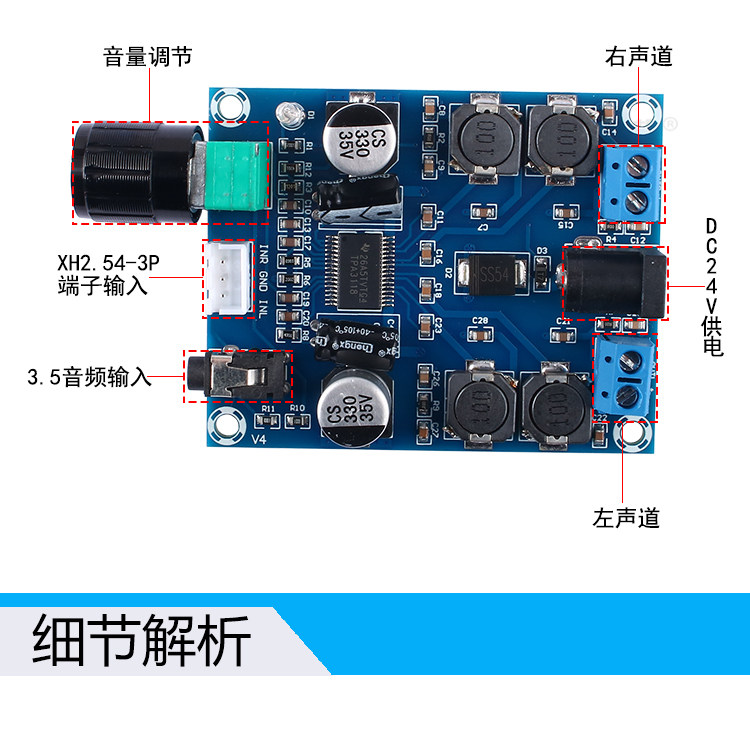
hardware/TPA3118D2/amplifier-front-connections.jpg
