miclle/discora/hardware/Potentiometer-B50K-Switch/supplier-reference.png

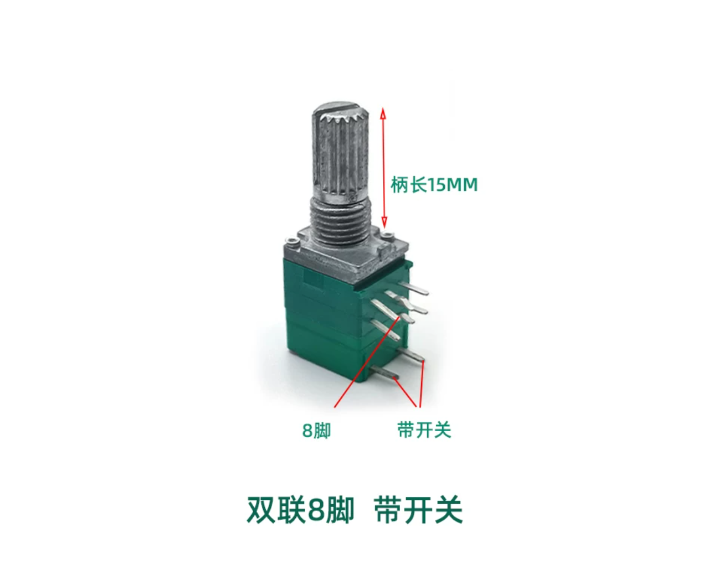
hardware/Potentiometer-B50K-Switch/supplier-reference.png
