miclle/discora/hardware/TPA3118D2/amplifier-supplier-specifications.jpg

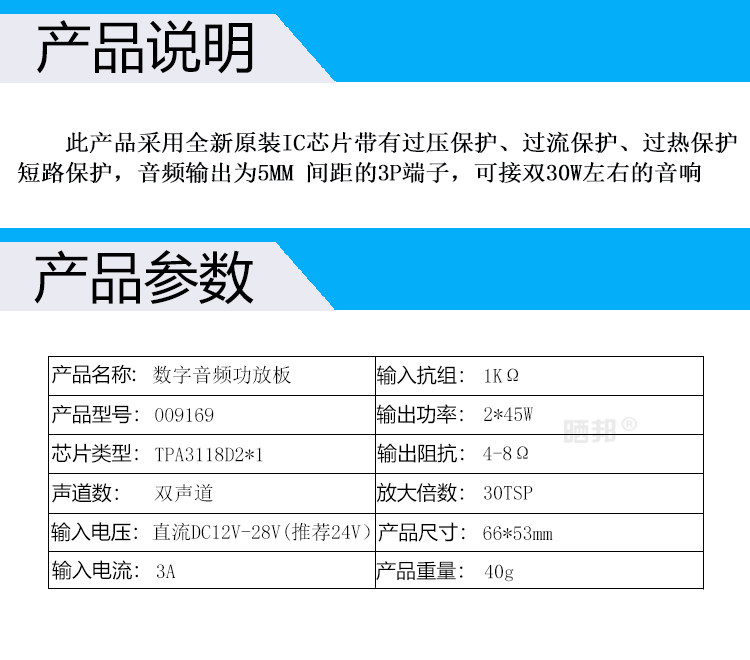
hardware/TPA3118D2/amplifier-supplier-specifications.jpg
