miclle/discora/hardware/enclosure/Discora.FCStd

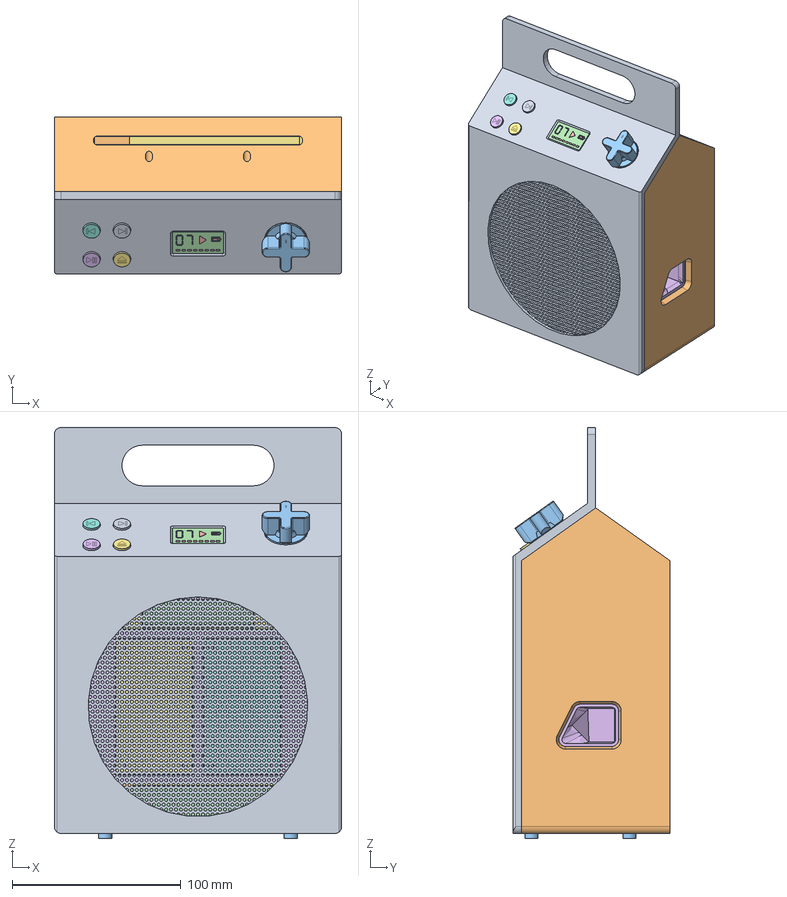
[picture p70: CAD file, 2026-11-14]
hardware/enclosure/Discora.FCStd
170.0 x 93.0 x 243.3 mm
P1 · 一体前壳／提手／护网
P2 · 一体后壳／左右圆角梯形开放出口
四个脚垫
OLED 玻璃面板 · 34.5×23×1.4
显示内容示意 · 曲目 07 / 播放 / 电量 / 音量
播放／暂停 · 双色键帽／白色功能标记
退碟 · 双色键帽／白色功能标记
上一曲 · 双色键帽／白色功能标记
下一曲 · 双色键帽／白色功能标记
四键焊线支架 · 两侧敞开／双点支承
音量旋钮 · 黑白双色／下沉细十字／压配
OLED 可拆压框 · 四点承压／两侧锁紧
光驱可拆压条 · 两枚名义M2×10／薄垫接触
P3 · 双声腔／功放托板／洞洞板支架
左声道 · 实测喇叭试装包络
右声道 · 喇叭试装包络关联镜像
播放／暂停 · 12×12×6；圆头 Ø12 保守包络
退碟 · 12×12×6；圆头 Ø12 保守包络
上一曲 · 12×12×6；圆头 Ø12 保守包络
下一曲 · 12×12×6；圆头 Ø12 保守包络
B50K · Ø6.8 螺纹／Ø5.8 花轴／9.8 六角螺母
B50K 插接模块 · PCB35×26.2×1.5／总厚15／绕轴90°
UJ-898 · 底面朝后／竖装向上退碟
Slimline SATA · 37.7×7／后伸20.4／根部Ø6.5×3
SH1106 PCB · 35.4×33.5×1.2／四孔与底部缺口
OLED 弯针接头预留 · 图纸深度11.3／2.54节距
TPA3118D2 · PCB 标称 66×53
功放元件高度 15 mm 预留
洞洞板 · 转 180°／右前缺口／左耳
ESP32-S3 N16R8 · PCB／USB 与 COM 插座留空
ESP32-S3 元件高度预留
ESP32-S3 排母高度预留
PCM5102 · PCB
PCM5102 元件高度预留
PCM5102 排母高度预留
DCE001 A · 主控 5Vin
DCE001 B · 光驱／桥接器 VBUS
XH2.54 · 四键 5 芯侧插／插合包络
XH2.54 · OLED 4 芯直插／插合包络
XH2.54 · 音量开关 2 芯直插／插合包络
洞洞板 M2×4 螺钉 1 · 名义包络
洞洞板 M2×4 螺钉 2 · 名义包络
洞洞板 M2×4 螺钉 3 · 名义包络
5600 mAh 平排电池包 · 商品标称 112×70×20
