miclle/discora/hardware/enclosure/print/Discora-P1-FrontShell.3mf

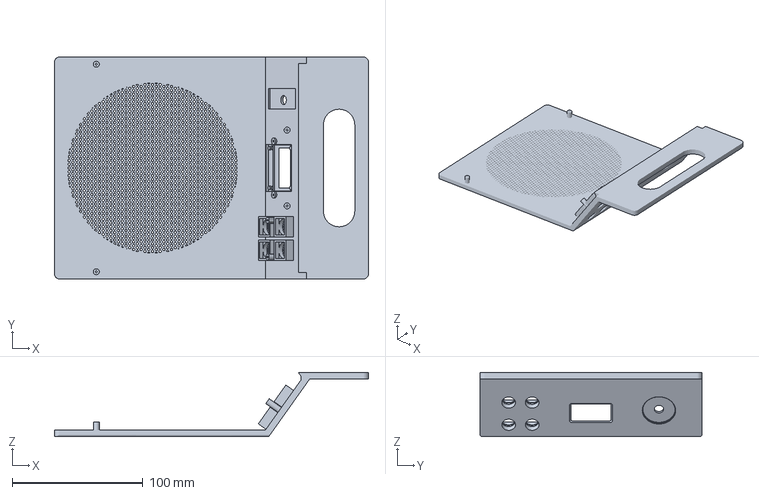
[picture p71: CAD file, 2026-11-14]
hardware/enclosure/print/Discora-P1-FrontShell.3mf
240.3 x 170.0 x 49.0 mm
