miclle/discora/hardware/enclosure/print/Discora-Knob-Black-White.3mf

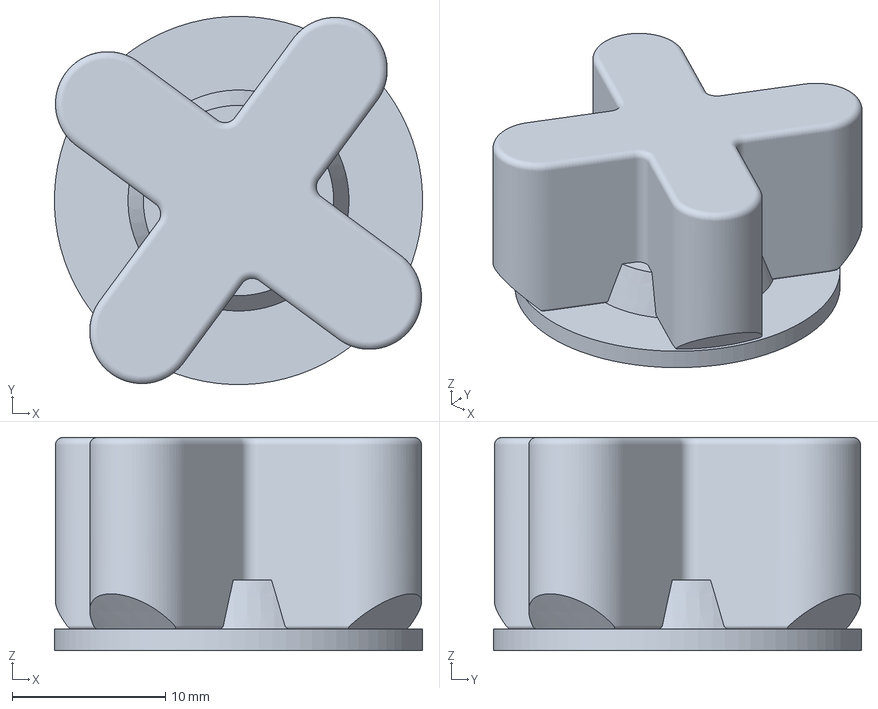
[picture p72: CAD file, 2026-11-14]
hardware/enclosure/print/Discora-Knob-Black-White.3mf
24.0 x 24.0 x 13.9 mm
