miclle/discora/hardware/enclosure/print/Knob.stl

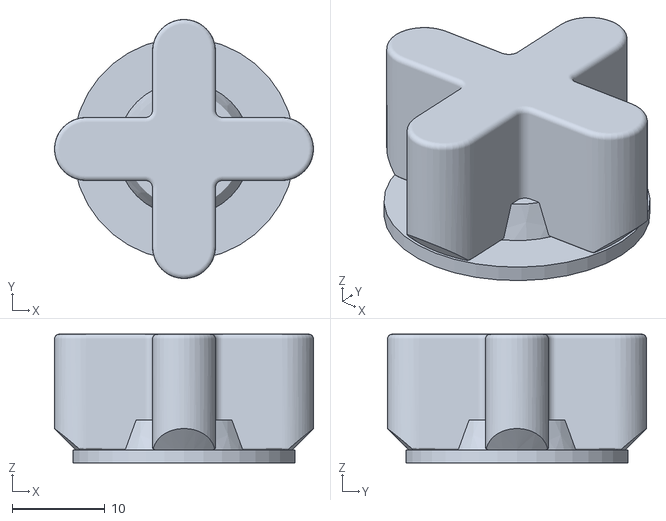
[picture p73: CAD file, 2026-11-14]
hardware/enclosure/print/Knob.stl
28.0 x 28.0 x 13.9
