miclle/discora/hardware/enclosure/print/Discora-P2-RearShell.3mf

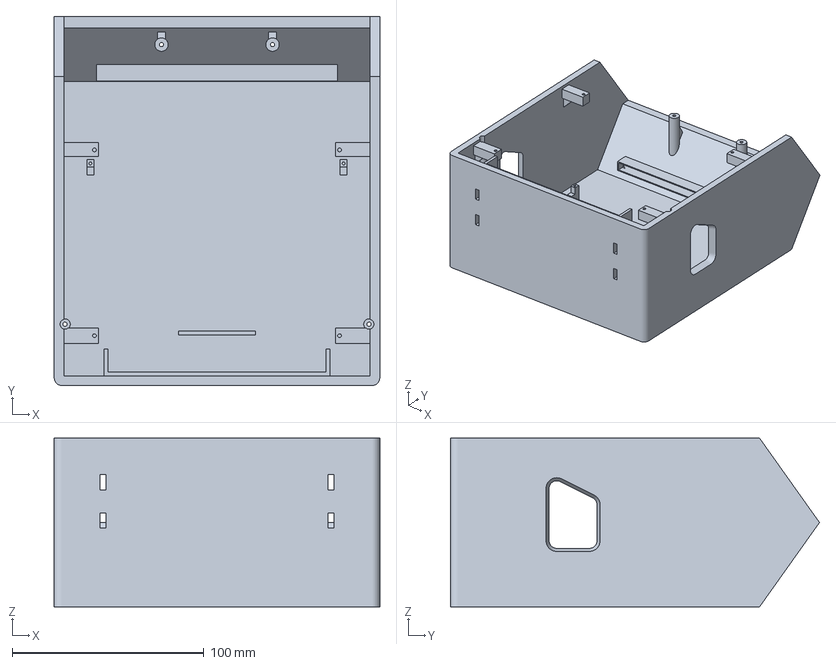
[picture p74: CAD file, 2026-11-14]
hardware/enclosure/print/Discora-P2-RearShell.3mf
170.0 x 192.7 x 88.0 mm
