miclle/discora/hardware/enclosure/print/EjectKey.stl

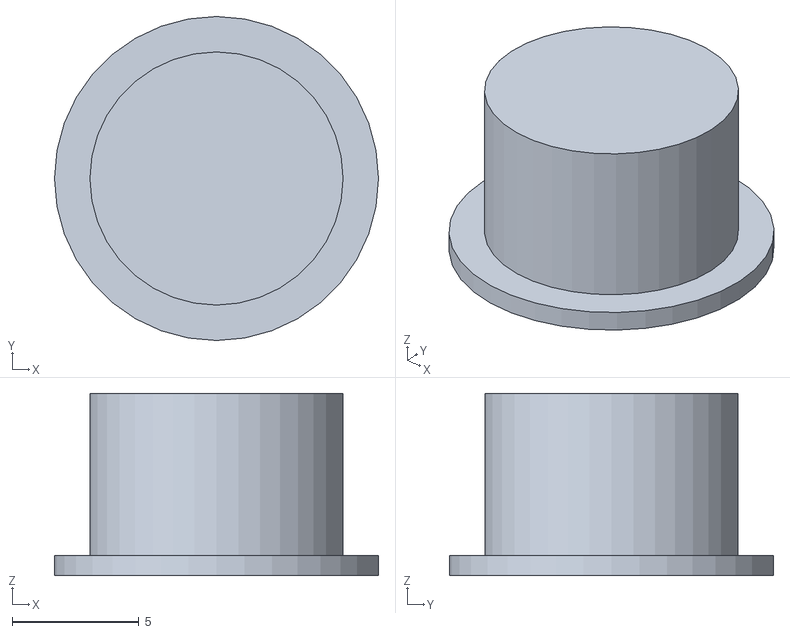
[picture p75: CAD file, 2026-11-14]
hardware/enclosure/print/EjectKey.stl
12.8 x 12.8 x 7.20
