miclle/discora/hardware/enclosure/print/ButtonRetainer.stl

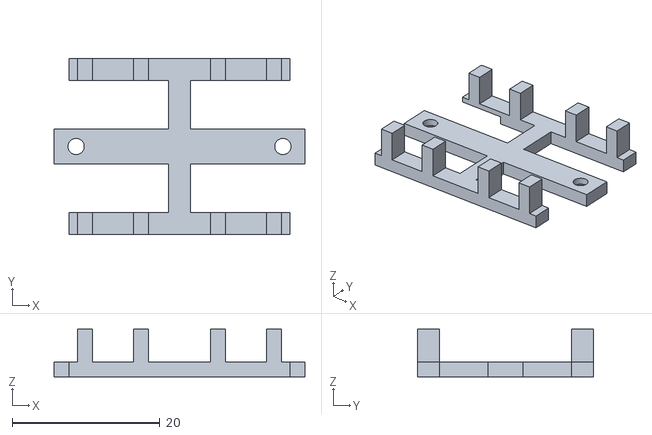
[picture p76: CAD file, 2026-11-14]
hardware/enclosure/print/ButtonRetainer.stl
34.0 x 23.9 x 6.50
