miclle/discora/hardware/enclosure/print/Discora-Keys-Orange-White.3mf

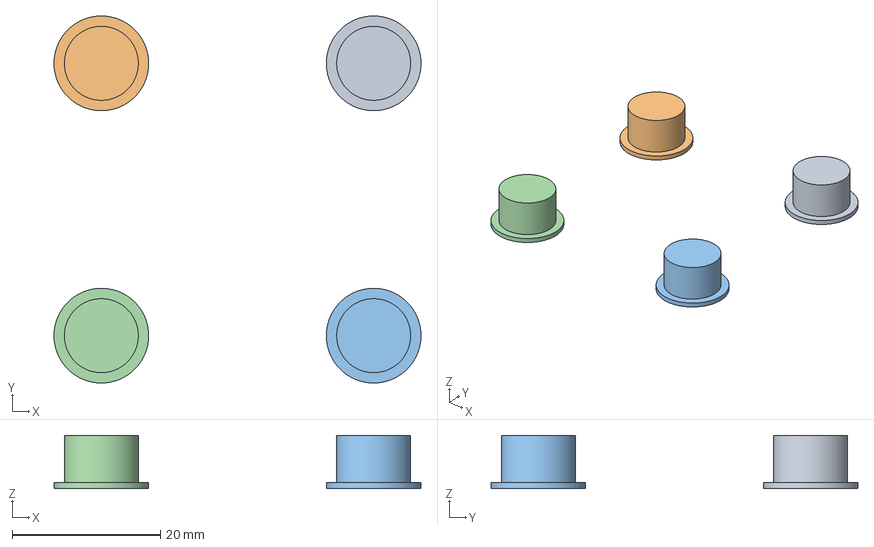
[picture p77: CAD file, 2026-11-14]
hardware/enclosure/print/Discora-Keys-Orange-White.3mf
49.6 x 49.6 x 7.20 mm
PlayPauseKey
EjectKey
PrevKey
NextKey
