miclle/discora/hardware/enclosure/print/DriveRetainer.stl

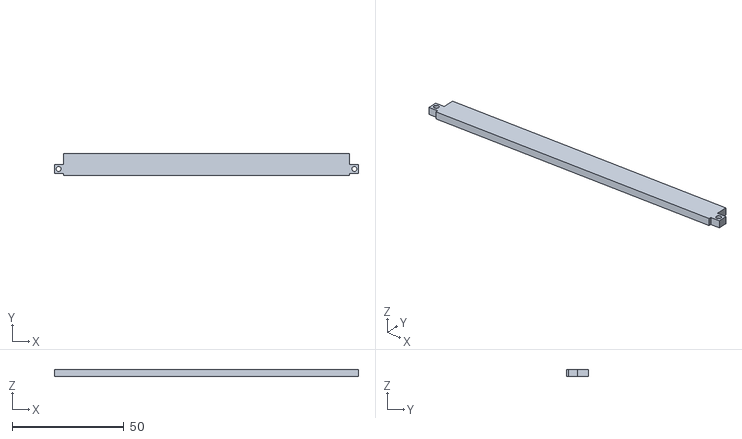
[picture p78: CAD file, 2026-11-14]
hardware/enclosure/print/DriveRetainer.stl
136.0 x 10.0 x 3.00
