miclle/discora/hardware/enclosure/print/DisplayRetainer.stl

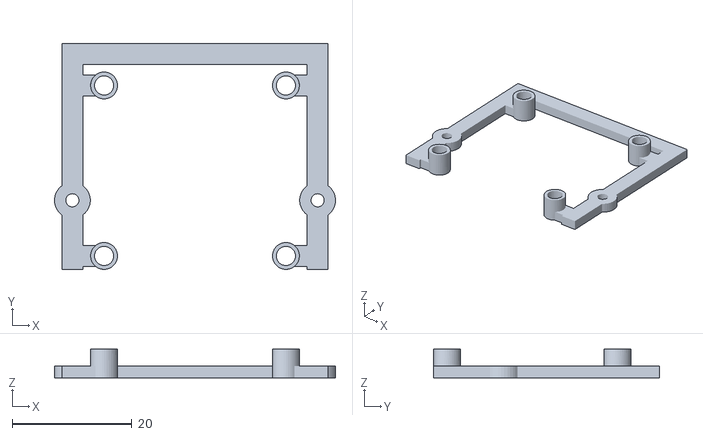
[picture p79: CAD file, 2026-11-14]
hardware/enclosure/print/DisplayRetainer.stl
47.0 x 37.8 x 4.80
