miclle/discora/hardware/enclosure/print/Discora-P3-SpeakerCarrier.3mf

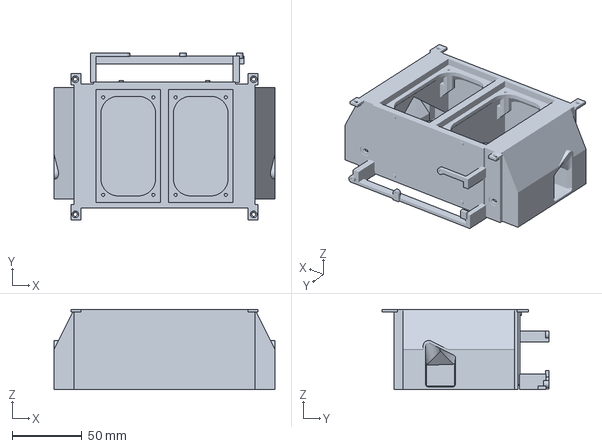
[picture p80: CAD file, 2026-11-14]
hardware/enclosure/print/Discora-P3-SpeakerCarrier.3mf
158.6 x 119.8 x 57.5 mm
