miclle/discora/hardware/enclosure/print/SpeakerCarrier.stl

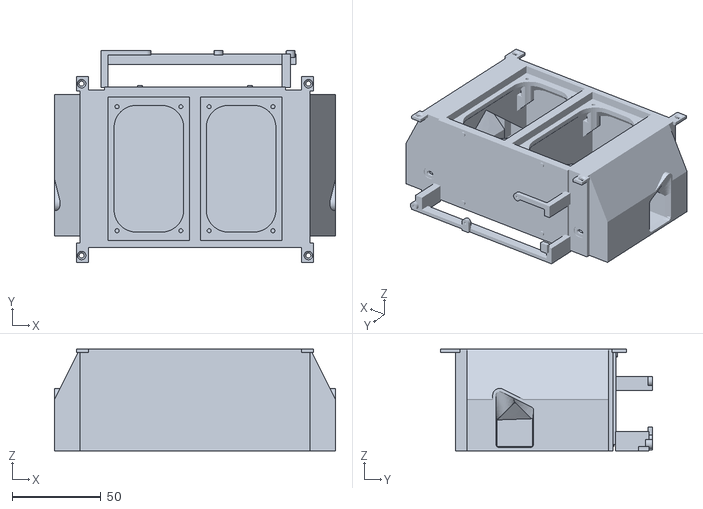
[picture p81: CAD file, 2026-11-14]
hardware/enclosure/print/SpeakerCarrier.stl
158.6 x 119.8 x 57.5
