miclle/discora/hardware/enclosure/print/Discora-Retainers.3mf

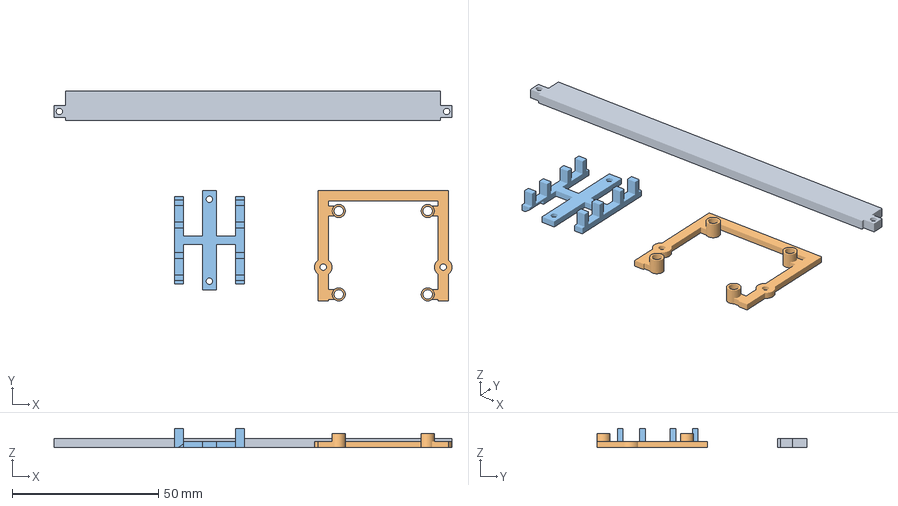
[picture p82: CAD file, 2026-11-14]
hardware/enclosure/print/Discora-Retainers.3mf
136.0 x 71.7 x 6.50 mm
DriveRetainer.stl
DisplayRetainer.stl
ButtonRetainer.stl
