miclle/discora/(list of files, cad)

Other CAD files:
hardware/enclosure/print/FrontShell.stl
hardware/enclosure/print/RearShell.stl
