miclle/discora/hardware/enclosure/print/README.md

# Discora 正式打印套件

当前操控布局为 ADR-0047（四键外移、28 mm旋钮）。主体配套版本：ADR-0046 P3 + ADR-0045 P2，来源为上一级 `Discora.FCStd`。11 件刚性 PLA 零件、11 个单色包络 STL、6 个带切片的 Bambu Studio 3MF。完整件实物验收待完成；已通过喇叭安装座试片装配。

| 打印盘 | 推荐打开的项目 | 预计耗材 |
| --- | --- | --- |
| P1 前壳 | [Discora-P1-FrontShell.3mf](Discora-P1-FrontShell.3mf) | 156.65 g |
| P2 后壳 | [Discora-P2-RearShell.3mf](Discora-P2-RearShell.3mf) | 286.84 g |
| P3 喇叭支架 | [Discora-P3-SpeakerCarrier.3mf](Discora-P3-SpeakerCarrier.3mf) | 181.00 g |
| 三个压框／支架 | [Discora-Retainers.3mf](Discora-Retainers.3mf) | 6.61 g |
| 四个橙白双色按键 | [Discora-Keys-Orange-White.3mf](Discora-Keys-Orange-White.3mf) | 7.54 g |
| 黑白双色旋钮 | [Discora-Knob-Black-White.3mf](Discora-Knob-Black-White.3mf) | 9.82 g |

P2 的“仅打印板支撑”和“仅关键区域”均关闭，P3 两项均开启。保持 3MF 保存姿态和支撑参数；四键与旋钮保留为双色对象，按实际 AMS 槽位映射材料。

STL 供其它切片器使用；四键和旋钮的单色 STL 不包含颜色分区。脚垫、电子模块、玻璃和紧固件另购。

[完整打印与装配说明](../../../docs/enclosure-printing.md) · [12 页装配图册](../drawings/Discora-V4-drawing-book-color.pdf) · [文件清单和 SHA-256](manifest.json) · [读回检查](../print-release-checks.json)
