miclle/discora/docs/decisions/0039-p3-flat-back-printing.md

# ADR-0039：P3 双声腔背面贴板打印

- 日期：2026-11-14
- 状态：CAD 已实现，Bambu Studio 首层检查通过，完整 P3 待实物试装

原洞洞板托架的后横梁到达 Y=65 mm，比双声腔的 Y=62.5 mm 背面凸出 2.5 mm。背面朝下切片时，横梁先触板，两块声腔背面下方均生成支撑。

将后横梁的后缘收到 Y=62.5 mm，截面从 5 × 4 mm 调整为 2.5 × 6 mm，并与两侧立筋连接。后侧 M2×4 固定孔朝机身前方移一格，改用洞洞板原丝印（A，O），落在 X=54、Y=58.56 mm。下延后的螺丝座与立筋、后横梁相接，导孔后侧至贴板平面留 3.14 mm，盲孔底留 1.35 mm。开孔前核对实物板上的铜箔和焊点。两只喇叭的安装座与试片对应的几何保持一致，左右声腔及侧导音孔保留镜像。

Bambu Studio 采用 P2S 0.4 mm 配置和 0.20 mm 层高，保持仅从底板生成的自动树状支撑。首层 Z=0.20 mm 的 G-code 在左右背板内部各有 392 条底面挤出移动、0 条支撑挤出移动。局部悬挑周边仍有支撑。预计 5 小时 27 分 30 秒、157.38 g。见 [P3 几何检查](../../hardware/enclosure/p3-flat-back-checks.json)、[洞洞板与线束复查](../../hardware/enclosure/p3-flat-back-perfboard-checks.json)和 [P3 切片检查](../../hardware/enclosure/p3-flat-back-print-checks.json)。
