miclle/discora/docs/records/2026-11-14-enclosure-print-release.md

# 2026-11-14 正式打印套件与图册交付

状态：本地文件生成和软件验证完成；完整件打印、装配、支撑清理、气密及声学未验收。喇叭安装座试片已由用户确认装配通过。

- 配套模型为 ADR-0046 P3 和 ADR-0045 P2；CAD SHA-256：`80eede1e85eafe8aca6ba6702cb2e169b6f7b4d1c368eeca10f1e6647bacebe0`。
- 正式入口为 `hardware/enclosure/print/README.md`：11 个刚性 PLA 单色包络 STL、6 个已切片 3MF，估计总耗材 648.14 g。
- P1、小件、四键、旋钮重新导出切片；P2/P3 保留已逐层审核的原 STL 和 G-code，项目仅整理名称及本机导入路径。包内 G-code 摘要与原审核文件一致。
- `print-release-checks.json` 读回全部文件：网格闭合、床面和尺寸、CAD/网格体积误差小于 1%、6 盘对象数、材料区域、零网格修复和 1180 层统计通过；P2/P3 支撑限制已持久保存。
- 当前洞洞板检查重新运行，三点固定、导线预留、0…60 mm 每 2 mm 的线束姿态与拔插包络通过。
- 图册更新为唯一 12 页彩色 A3；当前实体重新投影和彩色渲染，新声道页采用真实装配侧视与 X=−70 mm 实体剖切。删除旧侧口 22×67、中心 Z=80 等失效标注，改为实际梯形口尺寸。
- `drawing-baseline-checks.json` 对照上一图册真实模型：42 个其它成品几何不变，双色面序保持；P2/P3 和加强筋另按当前实体读取。
- 清理 241 个可再生成的旧迭代 3MF、重复图册页、自动备份、Python 缓存及根目录残留结果文件，约 133.5 MiB。保留基线 CAD、审核输入 STL、原始 G-code、报告、脚本、日志、GUI 截图及通过的喇叭试片；逐文件清理摘要留在本地 `tmp/print-release/cleanup-result.json`。
- 正式文件纳入版本控制；临时配置、完整切片日志与中间工作目录仍忽略。未发送打印、未修改或烧录固件。

当前打印设置、装配顺序和复现命令见[打印说明](../enclosure-printing.md)，图册与验证链见[图纸说明](../enclosure-drawings.md)。历史报告仍使用其实际基线摘要，不改写为当前版本。
