miclle/discora/docs/diagrams/discora-wiring.html

DISCORA / WIRING & PERFBOARD / 2026-11-10

# 整机接线与洞洞板装配图

机内实装候选的裁板、三点托架、三组 XH2.54 接插件及前壳维护位见当前洞洞板布局。下方机内图保留原模块落孔和历史包络试算。

音频接法为 GPIO15/16/7，原台架孔位、机内双路降压载板候选及四键 P3 线束保留。新增 USB 直连 GPIO19／20 与双 DCE001 防回灌方案，尚未改接或完成带载验收；播放、按键与 OLED 的最新实测结论见工程状态。

## 01 · 整机连接与供电

原台架模块级总览，保留 COM 与原生 USB 插头路径；不能与下方的双路 5V 改接方案混接。框内信号逐线连接，不表示短接；虚线支路须先确认规格。单独打开整机总览 SVG。

## USB 直连 · 双路 5V 与防回灌

A 只供主控，B 供桥接器与光驱；USB 的 5V 留在 B 支路，所有 GND 共地。

2026-11-10 改接方案：planned，未改实物、未做带载验收。 这一节替代原台架的 USB 插头与供电接法，仅在完成线束改造及检查后采用。按 ESP32-S3-COREBOARD V1.4 图纸核对；端子位置为示意，以实物丝印为准。

### ① USB 线怎样改

移除主控端原 USB 插头／OTG 转接头，保留通往光驱桥接器的一段线。桥接器侧的 VBUS（常见红线）接 B OUT+；D−、D+、GND 分别接 GPIO19、GPIO20、主控 GND。

不是把光驱的 VBUS 悬空：桥接器仍从 B 得到有效 5V。主控板 USB2 VBUS 不接这根红线，也不接 B。

保留 D+/D− 原双绞结构，剥开的末端尽量短；不经洞洞板长散线。用短、足额的独立正负电源线供光驱，其大电流回路直接回 B OUT−。

### ② 辅助电源怎样处理

拔掉原充电宝／充电器及辅助 USB 插头。若保留分叉线，将不用的插头移除或逐芯绝缘封住；不能留下带电裸触点或可误插电脑的插头。

断电测辅助 5V 与 USB VBUS 是否连通。若光驱还需要辅助入口，两入口都只能从同一个 B OUT+／OUT−分支供电；确认它们均为 5V 输入后再接。

原插头线芯若已剪断，两端分别绝缘。不要把屏蔽层／裸排流线当作唯一的 GND 回路。

### ③ 电脑与板载焊桥：明确两种工作状态

状态 | A / B 与直连线 | 电脑连接
电池独立播放 | 按上图；A、B 由同一总开关控制 | COM、原生 USB 均不插电脑；无外部辅助电源
只烧录主控 | 关总开关，拔开 A OUT+ → 5Vin；拔开光驱 D− / D+ / GND 三线接头 | 再连接 COM，由电脑单独供主控；原生 USB 留空

图示方案的目标焊桥状态：IN-OUT 断开、USB-OTG 断开；若 USB-OTG 已焊通，全部断电后移除焊桥并核对。IN-OUT 旁路 D3，USB-OTG 旁路 D2；两者都不是稳压器或限流器。

V1.4 图纸中，5Vin 经 D3 向板内 5V 供电；COM VBUS 经 D1 向板内 5V 供电，CH343P 还取电于 COM VBUS。本图用“拔开供电线／不同时接电脑”消除外部电源并接，不依赖未核验的实物二极管；不把“剪掉 COM 红线”作为通用调试办法。

烧录结束后先拔掉 COM，再恢复 A 供电线与光驱三线接头，最后打开总开关。边播放边调试需另行核对 COM 电源隔离及板载 CH343P 的供电／引脚状态；不能直接并接另一只 USB-UART 的 TX，以免与板载发送端争用或经信号线给断电器件供电。

### 上电前与首次验证

1. 全部断电：核对模块实物 IN± / OUT±，用通断档确认线芯及 GND；不得有 A OUT+ 与 B OUT+ 的直接导通路径，也不得让 B OUT+ 通到主控 5Vin、板内 5V 或 USB2 VBUS。二极管、电容会影响读数，不能只凭一次蜂鸣判断隔离。
2. 分支单独上电：先拔开 USB 数据三线，再分别只给 A、只给 B 输入供电，确认另一支输出没有被抬升至供电电压；分别测空载输出及主控板内 5V / 3V3。D3 有正向压降，板内电压需实测。
3. 恢复整机接线后同时供电：检查枚举、启动／进退碟、寻道及连续播放。测 B 输出和光驱端的最低电压、峰值电流与模块温升；DCE001 标称 3A，但供应商要求无散热时在 2A 内，当前负载能力未验收。

本方案避免的是 A、B 与电脑之间的外部 5V 回灌路径，不提供电气隔离，也不保证消除 USB 掉线。充电、功放和 DAC 支路未画入，不据此扩展接线。

核对依据：开发板 V1.4 原理图 · DCE001 供应商资料与待测项 · ADR-0018 · 乐鑫 USB 硬件设计说明（链接见整机接线文档）
图纸核对与建议接法，不代表实物已改装或验收。中文采用系统字体，离线可查看。

## 02 · 机内裁剪载板：ESP32＋DAC＋双路降压

新增两块 DCE001 固定 5V 模块，分别供主控和光驱；每块供应商标称 17.5 × 12 × 4.5 mm。候选板由约 90 × 55 mm 调整为 100 × 55 mm，功放仍单独固定。完整布局尺寸、接线边界与 CAD 试算。

这是机内安装候选，尚未通过装配验收。 原 120 × 80 mm 台架孔位保留在下一节；本候选需要重新布置排母。尚未确定裁剪线、固定孔和 DCE001 半孔针序，不按本图直接裁板或接电。

孔位总图：连续四键引出、排母、电源入口、双降压与 USB 留空区

按你确认的元件面方向：左上为原点，X 向右是 A～Z、再 A～P；Y 向下是 A～Z、再 1～4。 第二段 X 字母仅在图中加下标 ₂ 区分，实物仍印普通字母。下图展示完整 42 × 30 孔阵列；橙色圈为四键信号引出孔（M～P，A），地线在（J，A）；右侧放大 DAC 与 P1，表格统一按（X，Y）读孔。排母位置仍为待试插候选。

新候选连接 | 主控／入口孔（X / Y） | 目标端点／DAC 孔（X / Y）
BCK | GPIO15 / J1-8：X=Q / Y=K | X=N / Y=R
LCK | GPIO16 / J1-9：X=R / Y=K | X=N / Y=P
DIN | GPIO7 / J1-7：X=P / Y=K | X=N / Y=Q
公共地 | GND / J2-1：X=J / Y=A | X=N / Y=O
播放／暂停 | GPIO1 / J2-4：X=M / Y=A | P3-2 → 播放／暂停常开键；另一端接 P3-1 地
上一曲 | GPIO2 / J2-5：X=N / Y=A | P3-3 → 上一曲常开键；另一端接 P3-1 地
下一曲 | GPIO42 / J2-6：X=O / Y=A | P3-4 → 下一曲常开键；另一端接 P3-1 地
退碟 | GPIO41 / J2-7：X=P / Y=A | P3-5 → 退碟常开键；另一端接 P3-1 地
按键公共地 | GND / J2-1：X=J / Y=A | P3-1；四个按键的另一端共地
SCK 接地 | DAC SCK：X=N / Y=S | DAC GND：X=N / Y=O
DAC 独立 +5V | P1-1：X=Q / Y=Q | VIN：X=N / Y=N
DAC 电源 GND | P1-2：X=Q / Y=R | GND：X=N / Y=O

P1 只接原 DAC 独立 5V；不因增加两块降压模块而把 DAC 自动并入 A。新表是候选逐孔对应，尚未画出背面线束路径；旧台架 W1～W10 孔号不能套用。坐标依据与尺寸 · 展开历史台架孔位参考。

部件／区域 | 候选安排 | 安装与走线要求
ESP32 后排 | USB 朝右、天线朝左；20 mm 插头通道 | 保留两排可拔排母、BOOT／RST 操作；实际插头、天线净空和下方铜皮待核对
DAC 左前 | 与 A 本体相隔约 15.7 mm；模拟线向左离板 | 可拔排母＋绝缘支撑；保留原独立 5V 入口和音频线束，最终电池供电归属待定
DCE001 A／B 右前 | 本体相隔 7 mm；各留 25 × 22 mm 支撑／引线区 | 半孔不等于 2.54 mm 排针；按实物丝印焊短线，绝缘压持并留可拔线束，不在模块上钻孔
电池与光驱线束 | 输入在板外经总开关分支；B 沿右前缘离板 | 电机回路不走主控／DAC 信号地或洞洞板焊锡桥；两路 OUT+ 不直接或经 VBUS 并联

2026-11-07 历史几何复核：四个模块标称平面包络不重叠、未超出载板。按暂定排母、支撑与线束包络，现有机箱有碰撞；把前壳及显示／操控组件临时上移 20／22 mm 后，对所列保留部件无碰撞且净距不小于 1 mm，但旧电子托架仍碰撞，必须重做。临时平移不构成闭合机壳设计，也不证明最终只需加高 20 mm。当前 CAD 已在另一项工作中修改，本页未重算其包络，也未计入 P3 与四键线束。查看计算结果。

两块降压模块按供应商自然散热要求在 2A 内评估，封闭机壳温升与光驱启动峰值未测。USB VBUS／COM 防回灌、充电管理和功放稳压尚未定型；图中分区不意味着现有 USB 失联已经解决。

## 四键线束 · 连续排针与逐孔装配

采用 0.12.1-buttons-row 四键 profile。保留 I²S GPIO15／16／7、OLED GPIO10／11、USB Host 和 COM；四个按键均常开接地。如下五芯从已有 J2 排母底部焊脚引出，P3 接头在板外，不新增板面插座位置。

1. 全部断电，按模块 GPIO 丝印确认 J2-4／5／6／7 及 J2-1；不得用 GPIO 数字猜排针序号。
2. 按孔位总图，从（M，A）、（N，A）、（O，A）、（P，A）引出四根信号，从（J，A）引出公共地；排母顶面留给模块插拔。
3. 背面焊脚分别焊短绝缘线，沿后缘出板；不跨天线、USB 插头或 BOOT／RST。用 P3 连接前面板五芯，接头两侧标记芯号并做应力固定。
4. 检查每根信号到对应按键导通，松开到地不通、按下到地导通；相邻信号无短路。共地仅用于按键回路，不承载光驱／功放电流。
5. 接线、烧录和实体操作按用户安排留待后续；当前机内 CAD 包络未计入 P3 和完整线束，不据此裁板或确认装机。

固件配置与操作 · 候选孔位和装配边界

## 03 · 原台架 GPIO15/16/7 可拔插洞洞板

本节仅对应原 120 × 80 mm 台架板。 上方 100 × 55 mm 机内候选不沿用本节孔位或裁剪尺寸。

沿用 120 × 80 mm、30 列 × 42 行的洞洞板与原三条排母位置。ESP32 和 DAC 插在排母上；只焊载板侧导线。光驱、功放及电源模块保持板外，USB 继续使用板载接口与现有 USB 线。

当前接法：GPIO15→BCK、GPIO16→LCK、GPIO7→DIN。GPIO7 不接退盘键；GPIO4 留空，不再接临时测量线。当前有声配置关闭按键和 OLED，默认 GPIO4/5/6 固件不能直接用于本图。

图中 Y 均为第一段 A～Z；第二段 A₂～P₂ 只作位置参考。实心长焊盘不计入圆孔行列，也不默认作为公共电源轨。

历史台架参考：120 × 80 mm 原板孔位（不适用新版载板）

### 逐根导线清单（元件面坐标）

导线 | 一端 | 另一端
W1 · BCK | ESP32 GPIO15 / J1-8 X=Q / Y=K | DAC BCK X=N / Y=K
W2 · LCK | ESP32 GPIO16 / J1-9 X=Q / Y=L | DAC LCK / LRCK X=N / Y=I
W3 · DIN | ESP32 GPIO7 / J1-7 X=Q / Y=J | DAC DIN X=N / Y=J
W4 · GND | ESP32 GND / J2-1 X=1 / Y=D | DAC GND X=N / Y=H
W5 · SCK 接地 | DAC SCK X=N / Y=L | DAC GND X=N / Y=H
W6 · +5V | P1-1 / +5V X=N / Y=S | DAC VIN X=N / Y=G
W7 · 电源回流 | P1-2 / GND X=N / Y=T | DAC GND X=N / Y=H

地线：W4、W5、W7 汇入 DAC GND（N/H），用绝缘线在排母焊脚或附近可靠分接；中途经过的孔不焊接。DAC A3V3 留空；H1→L、H2→L、H3→H、H4→L 保持已验证设置。

### 插接件与拆换方式

部件 | 固定在载板的部分 | 可拆部分与约束
ESP32-S3 | 两条 1×22、2.54 mm 排母：Q/1 列，D～Y 行 | 主控向上拔出；保留 COM、原生 USB、BOOT / RST 的操作空间
PCM5102A | 一条 1×6、2.54 mm 排母：N 列，G～L 行 | DAC 向上拔出；另用绝缘支撑承托，输出短线经 P2 拔开
P1 · DAC 5V 输入 | 1×2、2.54 mm 排针：N/S 为 +5V，N/T 为 GND | 配套双孔插头接原独立 5V；两半标明极性。外壳及插拔空间预留 K～P / Q～V，若外壳不合适则改用板外接头，不硬挤
P2 · 音频线束 | 不固定洞洞板孔位；DAC 输出焊盘接短引线 | 三芯成套可拔接头：1=L、2=AGND、3=R；两半逐线配对，避免把 DAC 原九孔针序当作接头针序
USB / 光驱 / 功放电源 | 本轮不焊到洞洞板 | 保持现有接口和独立供电路径，不并接多个电源正极，不改 USB-OTG / IN-OUT 焊桥

P1 的排针与插头按同一配套规格选用，并作明显防反插标记；图不指定未经实物确认的锁扣外壳。P1 仅增加可拆连接，不改变 DAC 原供电来源。图中的 P1-1/2 是本载板定义，不是任意商品接头的默认针号。

音频导线 | DAC 短引线端 | P2 配对后到功放
W8 · 左声道 | LROUT / L | P2-1 → INL
W9 · 输入信号地 | AGND | P2-2 → 输入 GND
W10 · 右声道 | ROUT / R | P2-3 → INR

三芯接头在板外线束中，DAC 可以连短线一起拔出；不用 3.5 mm 同时并接。功放与左右喇叭保持原接线，BTL 的 L−、R− 不接地、不互连。功放及光驱大电流回路不经过载板的细信号地线。

### 安装顺序与保留空间

1. 全部断电，用模块定位排母，先点焊两端再试插；模块方向是 ESP32 天线朝上、USB 朝下，DAC 输入朝右、音频口朝左。
2. 只焊排母焊脚与 W1～W7；信号线走载板背面，尽量短，交叉处保留绝缘。模块保持可拔，不用焊锡将模块排针与排母封死。
3. 装 P1，按两端的 +5V / GND 标记连接原 DAC 电源；制作 P2 音频短线，按 L / AGND / R 对接原功放。线束作应力固定，避免拉扯 DAC 焊盘。
4. USB 下方保留整条插拔通道，先试插现有两根 USB 线；不用散线把 D+/D− 引到洞洞板。BOOT / RST 上方和 DAC 焊桥处保持可操作。
5. 在新焊接处检查 W1～W10 端点导通和相邻针无短路，再恢复原供电。本次装配后的检查针对新增焊点，不要求重做此前全部无声排查。

背面视角：所有坐标仍按元件面原孔身份。左右翻板、顶部朝上时，原 X=4 列在左侧；不按背面印字重新编号。先在两面标出同一个 X=4 / Y=A 孔。

扩展预留：左下区域先留空；按键、OLED、供电转换模块不在本次新增接线范围。顶部三行空孔可能被天线端投影覆盖，不代表已满足射频净空。

### 装配边界与依据

GPIO15/16/7 音频连接已通过台架播放，USB 长时仍有失联；本图不把载板装配当作 USB 故障修复。供应商 V1.4 图纸和参考照片给出 J1-7/8/9 对应 GPIO7/15/16；从排母首孔 Y=D 推导为 J/K/L，仍以手边模块丝印试插定位。

本节原台架板未纳入本次机内候选的 CAD 包络试算。现有机壳模型没有包含这整块 120 × 80 mm 载板及排母、P1、插头和线束包络，不能据此认定可直接装入机壳，也不据此钻最终安装孔。

板卡针序资料 · DAC 焊桥与电源 · 当前音频配置 · 实测状态 · 整机装配边界

维护入口：docs/diagrams/discora-wiring.html。原台架孔位与 docs/wiring.md 同步；机内候选见 docs/perfboard-layout.md；图稿更新不表示已焊接、烧录或通过整机装配验收。
