miclle/discora/hardware/enclosure/drawings/port-assembly-color.png

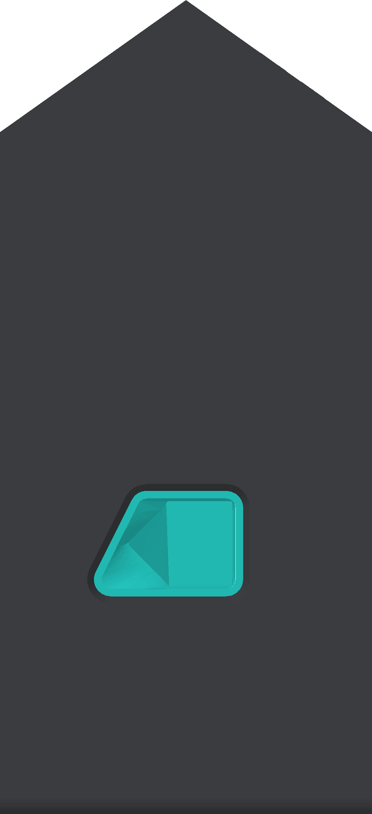
hardware/enclosure/drawings/port-assembly-color.png
