miclle/discora/docs/decisions/0038-measured-speaker-trial-mount.md

# ADR-0038：按实测尺寸制作 P3 喇叭试装座

- 日期：2026-11-14
- 状态：喇叭试片已打印并通过实物试装（`bench-tested`），完整 P3 待试装
- 来源：[喇叭和螺丝测量记录](../../hardware/Speaker-80x45-4ohm-10W/README.md)

双喇叭从 P3 正面插入，四孔固定边贴在 Y=10 的安装面，盆架穿过 3 mm 厚的承托板。安装面至喇叭前端、后端分别实测约 2、39 mm，模型 Y=8…49；距格栅背面、声腔后内壁分别留 3、11 mm 名义空间。左右中心保持 X=±26、Z=76，右侧安装座及喇叭占位关联镜像左侧。

| 部位 | 试装设计 |
| --- | --- |
| 喇叭固定边入口 | 81 × 46 mm（Z × X），按原名义外框 80 × 45 mm 每侧加 0.5 mm |
| 盆架开口 | 71.5 × 39.3 mm（Z × X），按实测最大 70.5 × 38.3 mm 每侧加 0.5 mm，四角 R12.5 暂定 |
| 每只四处孔位 | 按 70 × 36 mm（Z × X）居中布置，喇叭本体通孔实测约 Ø3.3 |
| 螺柱和底孔 | 柱外径 Ø8、轴向总长 11.5 mm；Ø2.3 盲底孔深 10.5 mm、孔底封闭 1 mm |
| 螺钉 | 实测螺纹外径约 Ø2.8、螺纹长 9.5、头高 1.9 mm；按从正面直接锁入 PLA 试装 |

角部真实轮廓未测，模型只用 R12 圆角截面表示 70.5 × 38.3 mm 试装包络，开口在其外侧预留 0.5 mm。两端孔边距复量 2.8～3 mm，支持长向孔阵居中；短向孔阵也按居中布置，实际对孔时确认。螺钉头径和牙型未测，CAD 用 Ø6 mm 头部及前向工具包络检查。夹紧叠厚包含固定耳和可能的密封垫，试装须核对有效咬合长度，螺钉与底孔的配合以样件为准。

试装时先不拧螺钉，检查盆架能否插到底、四处固定边能否贴平，再试四枚螺钉能否自然对孔及锁紧。合上前壳后检查振膜和悬边空间、螺钉头、密封垫压缩及出线。端子位置、实际折线路径、振膜行程及气密性待实物验收。

## 2026-11-14 试片结果

用户已打印 `Discora-P3-Speaker-Fit-Coupon.stl`（49 × 84 × 16.5 mm），并确认喇叭装配没有问题。试片包含单只喇叭的安装开口、贴合面及四处盲底孔，STL SHA-256 为 `f7e8615bb400d334bab746e30b49e3e4d09fa2aa026fd2d86d2b86236e2f6d31`。

完整 P3 试装时检查双喇叭固定、螺钉咬合和端子走线，再合壳核对与格栅的间隙、P3 与 P2 的固定及声腔密封。
