miclle/discora/docs/decisions/0035-measured-drive-rear-wall-mount.md

# ADR-0035：按 UJ-898 实测调整后壁贴靠安装

- 日期：2026-11-12
- 状态：implemented（CAD）；实物配合、夹持和进退碟尚未验收
- 来源：[用户照片与测量原始记录](../../hardware/MATSHITA-UJ-898/README.md)

## 决定

光驱竖装、碟口向上，带铭牌的底面朝后壳背板。后壁内面 Y=88，底盖较低基准面 Y=87，预留 1 mm 保护垫；用后壳一体的中央承托和一根可拆压条固定。压条只需两枚名义 M2×10 螺钉，不在光驱上钻孔，不依赖未测量的安装耳或原机孔位。压条覆盖区应使用软垫消除前后厚度差，避免挤压金属薄盖；垫片厚度、位置、压缩量和保持力须试装确认。

按用户最终选择，外宽 **170 mm**，左右壁各 5 mm，内宽 160 mm。光驱宽 128，居中后每侧可用 16；覆盖实测线缆侧向外伸 14.5 后余 1.5。不采用把自然外伸压到 12.5 的紧凑试算。外轮廓、碟口、提手、导音孔和声腔保持 X=0 左右对称；SATA 与 DAC 为内部不对称硬件。

外深 **93 mm**；前后主体仍厚 5。7 mm 厚 SATA 接头虽未高过光驱，但其在后端 9.5 mm 内的上下偏置未测，因此独立净空覆盖完整 9.5。模型接头居中显示只是示意，不将 7 mm 直接当作已确定的全部纵深占位。保护垫和接头净空共同确定深度，底板内面 Z=6 保持。

## 几何与测量边界

- 主体最大包络 128×10.8×130（机箱 X/Y/Z），Y=76.2…87，Z=29.5…159.5。实测前端 10.8、后端 9.5，前端加厚长度未知，因此按全长 10.8 做保守碰撞检查，不假设线性变薄。
- 以碟口朝人、盘面朝上的平放姿态为测量基准：左深 130、右深 95，右后斜边。竖装后，测量左侧映射至机箱 +X；斜边在机箱 -X、SATA 在 +X。
- 斜边用宽 128/103、深 130/95 的端点近似。底面右侧 25.2 宽、抬高 4.5 的带状区仅表示测得台阶，纵向范围未知。另用填满的最大长方体检查安装间隙，避免借用未确认缺口获取净空。
- 碟口 F 的共同基准采用 `(5.9+10)/2=7.95`，得到机箱 Y=79.05。壳体开口居中，水平投影 124×5.5；光驱口保留 121.6×4.5。D/E/F 原始读数的 0.6/0.4 差值保留在测量记录。
- SATA 外壳按 37.7×7、向后突出 20.4 建模；护线环 Ø6.5、轴向突出 3。接头两侧定位的跨度 38.8 与宽度 37.7 差 1.1，净空取能覆盖两端的 38.8，不改写实测值。
- 线缆侧向 14.5 为实测值；沿机箱 Y 方向的 26 mm 和 Z 方向的 6.5 mm 走线区域是设计预留，完整三维弯曲半径及路径未测。护线环直径不等于线径；不能据预留盒认定实际线材已装配通过。

## 关联调整

- 总外形 **170×93×243.263 mm**，包括提手和脚垫；不含脚垫高 240.263。前后斜肩水平宽均为 44、斜角约 35.395°；后壳侧视对称轴 Y=49。
- 下方前壳背锁移至 X=±79.4、Z=33，避开接头和线缆；下方刀杆有效伸入深度 78.8，建议至少 79 mm。上方锁点不变。
- DAC 随侧内壁向左移 12，仍留 1 mm 侧隙；显示、四键、旋钮、电池、主控、功放和喇叭位置保持。
- 原上部桥接器托架取消；SATA 接头直接位于光驱下端。电池托盘后部 20 mm 侧栏开放，用于光驱接头维护路径。
- 为使侧孔随后壳轮廓居中，声腔深度从 52 增至 57.5，左右短管延长、管口至声腔仍留 0.3。几何通路不等于声学调谐，旧腔容和声学判断不直接继承。
- 三个连续主体加四键帽、按键支架、OLED 压框、旋钮、光驱压条，共 **11 件刚性 PLA**。

## 装配和维护

装配时先在后壁选取底盖较低平面对应的承压区域布置保护垫，避开铭牌下方局部起伏及悬空台阶。光驱和接头按以下拆卸路径的反向放入，落在中央底托上，装压条后再装电池和 P3。不要用拧紧压条强行矫平底盖。

拆卸条件：取下前壳、P3、光驱压条和电池，断线并释放线缆余量。光驱与接头先前移 12，再前移 3 同时抬高 9.5；在这个维护位置将接头向下退出 10、向内移 14 后从前方取出。10 是设计拔出预留，未测真实插拔行程。光驱再前移 13，绕 Z 转 -30°并同步前移 20，最后向前取出。压条只需两螺钉，但整机维护仍受 P3 和电池位置限制。

## 验证与剩余边界

[整机检查](../../hardware/enclosure/validation.json)核对有效实体、接触以外的干涉、主体连续性、壁厚、左右镜像、退碟及侧通路；[光驱检查](../../hardware/enclosure/drive-mount-checks.json)核对最大填充包络、后壁保护垫间隙、接头和线缆净空、压条螺钉工具通路以及未改零件差集。

[拆装报告](../../hardware/enclosure/assembly-paths.json)分别标明连续保守扫掠与离散姿态：按填满的 128×10.8×130 最大包络检查抬升 31 个姿态、侧转 61 个姿态、前壳 1 mm 步长。离散检查不是连续运动证明。打印网格、切片和图册按当前保存模型生成；没有发送打印任务。实际保护垫、接头偏置、线材弯曲、孔补偿、螺钉保持力、薄盖变形、散热和进退碟仍待实物样件验证。
