miclle/discora/hardware/Potentiometer-B50K-Switch/supplier-characteristics.png

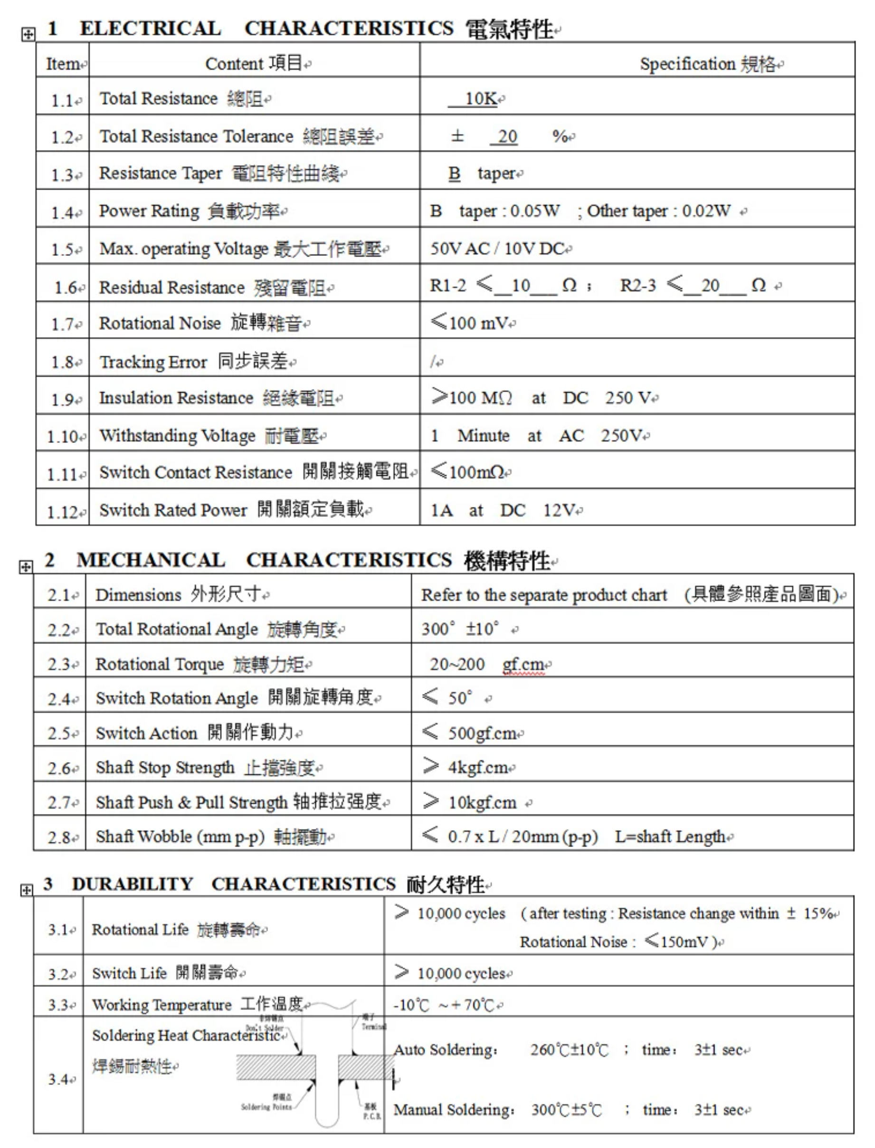
hardware/Potentiometer-B50K-Switch/supplier-characteristics.png
