miclle/discora/docs/records/2026-11-08-full-disc-read-failure.md

# 2026-11-08：整盘播放在第 13 轨读取失败

## 结果

用户要求播放整张 CD，结束或停止后分析稳定性日志。本轮于 **10:28:15（Asia/Shanghai）** 开始采集，只发送一次 `play-disc`。前 **12 轨完整提交并正常跨曲**，第 13 轨输出约 **2 分 13 秒**对应的 PCM 后，LBA **233783** 的 READ CD 失败，播放器进入 fault，未到盘尾。**本轮整盘稳定性未通过。**

首次 running 状态至首次 fault 状态日志相隔 **3125.480 秒（约 52 分 5 秒）**；它是状态采样窗口，不是独立声学计时。控制器总采集时间 **3138.310 秒**，含启动、停止和确认。第 13 轨提交量为 23383584 字节，按 176400 bytes/s 折算 132.560 秒；故障 LBA 是源读取位置，不等于扬声器播放位置。

故障后控制器发送一次 `stop`，确认 `stopped`、`continuous=0`、`queued=0`、`pending=0`、`tx=closed`、`handle=0`，串口已释放。没有重播、烧录、修改固件或执行介质写入。

## 设备与证据身份

- 本轮实际识别主控串口序列号 **5CF9109063**、VID:PID **1a86:55d3**，不同于 2026-11-07 记录的尾号 8636。打开前核对身份及占用；不能把两块板的运行结果视为完全相同的硬件条件。
- 启动实读为 `0.11.3-usb-ab` / ESP-IDF v5.4，完整 ELF SHA-256 为 `362084e8a952bc8bcc0cc5c6498eae16ca60cd925c76aebba79e6235b7b9056e`，与此前 I²S 对照候选一致。本轮没有读回 Flash 或重新进行写入校验。
- 实读 `sink=I2S-unverified`、PSRAM 队列 2097152 字节、预填 529200 字节、`auto_recover=1`；查询 A/B 未启用。对应候选配置为 GPIO15/16/7、25% 数字幅度。本轮没有重新测量引脚或供电，也未更改接线。
- 光驱 INQUIRY 为 MATSHITA DVD-R UJ-898 / HC10，桥接器 `13fd:0840`，Full-Speed。现场 TOC 为 13 条音频轨、lead-out LBA 252645，整盘期望 PCM 594221040 字节；未核实光盘商业名称。
- 打开 COM 前预设 DTR/RTS=false，仍捕获一次 MCU 启动；没有主动复位，不称为无扰动采集或光驱完全断电冷启动测试。
- 同日此前约 61 秒短测中，用户确认“左右声道正常、清晰”。该反馈只覆盖短测，不能扩大为本轮全程听感验收。

## 全程统计

| 指标 | 结果 |
| --- | --- |
| 完整结束音轨 | 1–12；每轨 delivered 与 TOC 扇区数 × 2352 一致 |
| 完整 12 轨提交量 | 526299984 字节 |
| 累计 I²S PCM 提交 | 549683568 字节；包括第 13 轨部分数据，不是声学测量或独立摘要校验 |
| 成功 READ CD / 完整读取调用 | 29228 / 29229；最后一次失败 |
| failed / rejected / stale | 1 / 1 / 0；前两项对应同一次源失败和拒收 |
| 软件欠载 / 自动重缓冲 | 0 / 0 |
| I²S 写入错误 / 异常 DMA 长度 / padding | 0 / 0 / 0 |
| 根端口 CONNECTION / DISCONNECTION | 1 / 0；仅初始枚举，无重连 |
| 根端口 ERROR / OVERCURRENT / client DEV_GONE | 0 / 0 / 0 |
| READ_TRANSPORT_ERROR / 应用 BOT reset | 0 / 0；DATA 阶段有一次 STALL，随后取得有效失败 CSW，见下文 |
| MCU 启动 / panic / 报告丢失 | 1 / 0 / 0 |
| I²S opens / closes | 13 / 13，最终输出已关闭 |
| 完整读取平均 / 最大耗时 | 18.550 ms / 10783.588 ms；最大值包含 READ CD 与 REQUEST SENSE |
| ≥100 ms / ≥500 ms / ≥1 s 读取调用 | 各 10 次，包括最后一次失败；阈值包含关系，不可相加 |
| 非 EOF 消费后最低队列采样 | 174048 字节，约 0.987 秒；不是源失败瞬间的独立快照 |
| 完成轨末空闲堆 | 12 次均为 6556600 字节；运行时采样为 6548540 字节 |
| 输出任务最低剩余栈 | 3788 字节 |

## 失败顺序

失败命令为第 13 轨、LBA 233783、8 扇区，请求 18816 字节。使用诊断事件自身的微秒字段排序；异步日志前缀不能替代事件时间。

| 事件时间（秒） | 观察 |
| --- | --- |
| 3120.703458 | READ CD 开始，tag=29854 |
| 3120.703676 | DATA 等待开始，CBW 已完成 |
| 3130.376079 | DATA 回调 `status=4`、actual=0；本机 IDF v5.4 中为 `USB_TRANSFER_STATUS_STALL`，不是 `NO_DEVICE` |
| 3130.394970 | 命令结束：有效 `CSW=1`、received=0、residue=18816；总耗时 9.691512 秒，DATA 9.672698 秒 |
| 3130.403074 | REQUEST SENSE 开始，tag=29855 |
| 3131.457358 | REQUEST SENSE 完成，CSW=0、18 字节、residue=0；命令耗时 1.054284 秒 |

REQUEST SENSE 返回 `key=0x03 ASC=0x02 ASCQ=0x00`。其中 ASC/ASCQ `02h/00h` 的标准说明是 **NO SEEK COMPLETE（寻道未完成）**，见 [T10 ASC/ASCQ 分配表](https://www.t10.org/lists/asc-num.txt)。这是一条实际设备返回，不能仅凭它断定光盘损坏、光头故障或供电异常。

源码的 DATA STALL 分支清除端点 halt 后继续读取 CSW；本轮随后取得有效失败 CSW 和成功的 sense，未走应用 BOT reset 路径。`control_us=449` 与这次端点处理相符，不能把它称为整机 USB 复位。日志随后明确 `no further read retry`，源结果被拒收，播放器清队列并关闭 I²S。故障后的两次 TEST UNIT READY 都成功，`media=1` 保留，但没有再次读取音频。

这是 **SCSI 读取失败触发停止**，与此前根端口 DISCONNECTION 的失败类型不同；没有证据将它们合并为同一根因。软件欠载为 0，不能把此次停止解释为缓冲先耗尽；fault 后的 `queued=0` 是清队列结果。没有独立的故障瞬间队列快照，不把最低采样值当作精确剩余量。

## 慢读取与轨尾事件

9 次耗时超过 1 秒但成功返回的 READ CD 分布如下，另外第 10 次是最终失败。耗时是 USB 命令级测量，不含外围 read_audio 开销。

| 轨号 | LBA | 命令耗时（秒） |
| --- | --- | --- |
| 1 | 0 | 2.333567 |
| 1 | 768 | 3.546225 |
| 12 | 209180 | 2.968065 |
| 12 | 220436 | 2.993741 |
| 12 | 221716 | 2.604192 |
| 12 | 222348 | 2.980787 |
| 13 | 225727 | 3.590340 |
| 13 | 232903 | 2.564072 |
| 13 | 233431 | 2.933682 |

这些成功等待未造成软件欠载。末两轨慢读取更密集，是后续对照的线索；当前不能推断由温升、盘面位置、机械或供电导致。另有一次 TUR 约 114.902 ms，以及失败后的 sense 约 1.054 秒，不计入上述成功 READ CD 数量。

24 次 I²S 完成事件队列溢出全部由前 12 个轨尾解释：每轨排空增加 2 次，供数阶段增量为 0；排空窗口为 57712–57736 μs。第 13 轨故障关闭未新增溢出。此项与软件 PCM 欠载分开记录，仍不能宣称轨间无缝或每个样本都已经从 DAC 输出。

## 结论与后续方向

1. 本轮前 12 轨、12 次自动跨曲及约 52 分钟运行已有真实日志；整盘播放仍失败，不能标为 verified。
2. 本轮没有复现此前根端口断开，新增的是有效失败 CSW 与 `03/02/00`。主控串口身份也不同，不能据此宣布此前失联已修复。
3. 2 MiB 缓冲覆盖了多次秒级等待，最终停止来自真实源失败；增大缓冲或仅开启欠载自动恢复不会改变该失败返回。
4. 若继续定位，优先围绕同盘 LBA 233783 附近做有界只读对照，比较电脑与 MCU 的实际结果，再考虑另一张盘的对照以区分介质位置与设备路径。此为后续建议，本轮未执行重读、换盘、自动重试或固件修改。

## 证据与校验

本地忽略目录 `.local/bench/2026-11-08-full-disc-9063/` 保存 setup、完整串口日志、约 10 秒间隔状态快照、控制器最终状态、可重跑分析脚本及 `analysis.json`。没有保存 CD PCM。

- `full-disc.log`：402519 字节，SHA-256 `64a003108be896f435b5e703f3d3ff3945f98797bbcbce70f346abb7732b7a1c`，与控制器关闭后记录一致。
- 复核 12 轨逐轨长度、单次 play-disc / stop、24 次轨尾溢出归属、唯一失败 LBA、最终停止及串口释放，均一致。
- 本轮不修改固件，没有重新运行构建或主机测试；验证对象是实机日志和分析结果。
