miclle/discora/firmware/main/track_buttons_core.c

#include "track_buttons_core.h"

void track_buttons_init(track_buttons_core_t *b, int64_t now_ms)
{
    button_init(&b->prev, now_ms);
    button_init(&b->next, now_ms);
    button_init(&b->play, now_ms);
    b->chord = false;
}
int track_buttons_sample(track_buttons_core_t *b, bool available,
                         bool prev_pressed, bool next_pressed, bool play_pressed, int64_t now_ms)
{
    if (!available) { track_buttons_init(b, now_ms); return 0; }
    if ((unsigned)prev_pressed + (unsigned)next_pressed + (unsigned)play_pressed > 1) b->chord = true;
    button_enable(&b->prev, !b->chord);
    button_enable(&b->next, !b->chord);
    button_enable(&b->play, !b->chord);
    button_sample(&b->prev, prev_pressed, now_ms);
    button_sample(&b->next, next_pressed, now_ms);
    button_sample(&b->play, play_pressed, now_ms);
    bool prev = button_take(&b->prev), next = button_take(&b->next), play = button_take(&b->play);
    if (b->chord) {
        if (!prev_pressed && !next_pressed && !play_pressed &&
            now_ms - b->prev.changed_ms >= BUTTON_DEBOUNCE_MS &&
            now_ms - b->next.changed_ms >= BUTTON_DEBOUNCE_MS &&
            now_ms - b->play.changed_ms >= BUTTON_DEBOUNCE_MS) b->chord = false;
        return 0;
    }
    return prev ? PLAYER_BUTTON_PREV : next ? PLAYER_BUTTON_NEXT : play ? PLAYER_BUTTON_TOGGLE : PLAYER_BUTTON_NONE;
}
