miclle/discora/(commit log)

2026-10-31 chore: initialize Discora ESP32-S3 optical disc project
2026-10-31 feat(usb): add read-only BOT and TOC probe
    Implement bounded native USB transfers, optical identification and formatted TOC parsing. Add host protocol tests and CI coverage; preserve bench artifacts outside build output.
2026-10-31 docs: record assembly and optical bench results
    Document UART and VBUS wiring, UJ-898 queries and the 13-track TOC experiment. Preserve earlier failures and disclose lost M1 raw evidence and backup limitations.
2026-10-31 feat(cdda): add bounded READ CD bench probe
    Default the audio experiment off and latch one attempt per boot. Use a 30-second audio data deadline and verify guarded sector requests. Record PC-matched sample hashes, the successful short burst and earlier transport failures.
    [probe_protocol.c, probe_protocol.h, probe_protocol_test.c]
2026-10-31 feat(cdda): add paced streaming validation
    Add track-bounded reading, seek probes and an internal PCM ring with a clocked software sink. Record the 600-second PC-matched stream and retain failed seek and full-track experiments.
    [cdda_bench.c, cdda_bench.h, cdda_cursor.c, cdda_cursor.h, pcm_buffer.c, pcm_buffer.h, run_host_tests.py, stream_core_test.c]
2026-10-31 fix(cdda): guard sink shutdown and add fault probe
    Avoid reading shared state when the consumer has not stopped. Add an opt-in underrun control and OTG comparison profile, preserving the pre-injection disconnect as an incomplete test.
    [cdda_bench.c]
2026-10-31 feat(audio): add playback core and test tones
    Add prefill, pause, stop, underrun and fault states with stale-generation rejection. Generate explicit PCM16LE diagnostic tones and cover state transitions, channel isolation and sample layout with host tests.
2026-10-31 feat(audio): add opt-in I2S tone diagnostic
    Add UART-controlled stereo test tones with explicit start, DMA preload and reset on pause or source changes. Keep USB probing as the default and provide a separate diagnostic profile; hardware output remains unverified.
    [audio_diag.c, audio_i2s.c, audio_i2s.h, main.c]
2026-10-31 docs(audio): document wiring and validation limits
    Describe diagnostic commands, candidate GPIO wiring and DAC arrival checks. Record offline tests and three successful builds while keeping hardware audio and CD-source integration explicitly unverified.
2026-10-31 docs(hardware): curate ESP32-S3 board references
2026-11-01 feat(hardware): add V4 FreeCAD enclosure concept
    Model the approved enclosure with a vertical optical drive, side speakers and separate internal component envelopes. Include a FreeCAD macro for revising estimated dimensions.
    [Discora-V4.FCStd]
2026-11-01 docs(hardware): document V4 model and layout
    Add CAD previews, estimated dimensions, editing guidance and validation limits. Link the enclosure documentation from the project README.
2026-11-01 docs(usb): record OTG direct-drive comparisons
    Preserve failed MCU readiness and seek windows alongside PC reference reads. Record the unchanged power path and limits of the comparison.
2026-11-01 feat(usb): add REQUEST SENSE phase diagnostics
    Expose the data-stage deadline separately while preserving transfer ownership and transport recovery limits. Record the three comparison windows and the observed 03/02/00 response.
2026-11-01 feat(cdda): add guarded single-read recovery
    Allow one opt-in recovery per boot only for valid 03/02/00 after a serviced wait and successful TUR. Preserve failures and record wait/recovery comparison results.
    [cdda_bench.c, cdda_retry.h, probe_protocol_test.c]
2026-11-01 feat(cdda): add bounded multi-round seek probes
    Add seek-only runs with a 20-round cap, soft deadline and optional deterministic offsets. Preserve the per-boot recovery limit and record 960 successful reads without claiming recovery coverage.
    Summarize current validation and prioritize underrun fault testing, offline recovery flow checks and CD-to-audio integration.
2026-11-01 test(cdda): exercise shared recovery control flow
    Run the actual recovery sequencer with scripted wait, readiness and replay outcomes. Keep the per-boot budget and guard against loss after TUR without claiming physical recovery validation.
2026-11-01 feat(audio): connect CD source to playback control
    Add opt-in UART playback with a serialized USB producer, independent output task and generation-safe queue. Support pause, stop, track selection, explicit underrun restart and bounded track EOF.
    Verify real-CD controls, two stale-result rejections and 60.47 seconds of software-clock consumption at 1x. Build the I2S adapter configuration without claiming DAC or audible output validation.
2026-11-01 test(audio): verify full-track playback EOF
2026-11-01 fix(audio): resume and drain short track tails
    [audio_i2s.c, audio_i2s.h, audio_i2s_test.c, cd_player.c, cd_player_core.c, cd_player_core_test.c, run_host_tests.py]
2026-11-01 test(usb): share bounded transfer wait flow
2026-11-01 test(bench): verify each track in a full disc
2026-11-01 fix(audio): defer EOF reports and trace drain
    Separate PCM supply, verification, and drain observations. Preserve completion queue overflow evidence while removing synchronous EOF logging from the output task.
    [cd_player.c]
2026-11-01 test(bench): guard unloaded I2S disc runs
    Require an explicit I2S sink and retain EOF phase evidence. Check submitted bytes, steady-supply overflows, channel closure, and bounded drain observations per track.
2026-11-01 feat(player): add bounded disc sequence
    Advance tracks on the MCU only after EOF verification and output closure. Preserve explicit startup, pause/resume, cancellation, and terminal stop semantics; record the final-two-track unloaded I2S test.
2026-11-01 feat(control): add GPIO7 eject button
    Add debounced press handling and serialized optical eject, waiting for
    player output closure and discarding requests on disconnect or faults.
    Document wiring, five-profile builds, nine host checks, deployment, and
    user-confirmed physical ejection; retain remaining acceptance limits.
2026-11-01 feat(hardware): retain final top-loading enclosure
    Keep the sloped status display and central stereo layout as the sole enclosure design. Remove the obsolete V4 model and update the entry link and geometry validation evidence.
    [Discora-V4-Topload.FCStd, Discora-V4.FCStd]
2026-11-01 feat(control): add previous and next track buttons
    Add GPIO8/GPIO9 navigation through the player output owner and reuse
    the eject debounce core. Preserve GPIO7 eject, reject held or conflicting
    presses, and discard gestures when media is unavailable or faulted.
    Document wiring, ten host checks, four-profile builds, and the verified
    software-clock deployment. Keep physical button and audible-output
    acceptance separate from startup and software evidence.
2026-11-03 docs(hardware): record audio and display selections
    Record PCM5102 and display product references and select the existing TPA3118D2 board for initial integration. Keep physical specifications and hardware test results explicitly pending.
2026-11-03 chore(git): ignore local build and CAD artifacts
    Exclude CI build outputs, FreeCAD backups, temporary files and root-level worktrees while preserving source configurations and hardware references.
2026-11-03 docs(hardware): document complete player wiring
2026-11-03 docs(hardware): add OLED wiring plan to diagram
2026-11-03 docs(hardware): clarify 5Vin power routing
2026-11-04 feat(display): add SH1106 playback status
    Show track and player state on GPIO10/11 without blocking audio. Add native I2C integration, offline coverage and wiring documentation; physical display acceptance remains pending.
2026-11-04 docs(display): record OLED firmware deployment
    Record verified software-clock flashing and retained button initialization. Preserve the OLED timeout and the user's confirmation that the display was not connected or powered; update deployment status without claiming screen acceptance.
2026-11-04 docs(power): record 5600mAh battery selection
    Record the selected SKU, quoted price, supplier dimensions and planned power conversion. Keep capacity, load, charging and fit validation explicitly pending.
2026-11-04 docs(power): link battery choice to BOM and layout
    Add the selected pack to the hardware list and flag the old enclosure placeholder as incompatible. Leave the independent CAD redesign outside this commit.
2026-11-05 feat(cad): compact and mirror the enclosure
    Fit the 80 x 45 x 42 mm speaker envelopes in a 142 x 74 x 202 mm concept while preserving the control layout. Link paired parts with native mirrors and record the enclosure symmetry rule.
    Rename the model to hardware/enclosure/Discora.FCStd and update previews, scripts, references, and saved-model checks. Physical fit, the selected battery pack, and acoustic tuning remain unverified.
    [Discora-V4-Topload.FCStd, Discora.FCStd]
2026-11-05 docs(cad): add color assembly drawing book
    Document exterior dimensions, foot-height references, exploded views and component envelopes in one five-page A3 booklet. Include reproducible CAD export and rendering scripts while retaining concept-design limitations.
2026-11-05 feat(cad): adapt battery and unify PLA enclosure
    Fit the selected 112 x 70 x 20 mm flat battery and reduce the enclosure
    to three main PLA parts. Align removable side ports with the handle at Y=40.5.
    Refresh the model, color drawings, previews and assembly/printing notes.
    Record matching interference, symmetry, assembly-path and slicer checks;
    physical print, fastening and acoustic acceptance remain pending.
    [Discora.FCStd]
2026-11-05 docs(wiring): integrate perfboard layout
    Add silkscreen coordinates, socket placement and W1–W7 endpoints to the complete wiring diagram and guide. Preserve the system overview and distinguish bench assembly from enclosure fit.
2026-11-07 feat(audio): add I2S clock diagnostics
    Add opt-in 64fs slots and PCNT pad readback to isolate audio faults. Keep PCM16 DMA sizing, CD playback and default pins unchanged.
    Cover slot isolation and probe failure paths with host tests, plus an ESP-IDF CI profile for both diagnostic options.
    [audio_clock_probe.c, audio_clock_probe.h, audio_clock_probe_test.c, audio_diag.c, audio_i2s.c, audio_i2s.h, audio_i2s_test.c]
2026-11-07 docs(audio): record stereo playback validation
    Record the DIN connection isolation and 60-second stereo CD result. Distinguish tested wiring and temporary firmware from repository defaults, retaining failed trials and stability limits.
    Refresh related audio, wiring and status pages and record local review and build evidence.
2026-11-07 feat(usb): trace disconnects and BOT timing
    Capture root-port events, transfer ownership and source snapshots without changing recovery policy. Guard the private hook to ESP-IDF 5.4 and cover it in tests and CI.
2026-11-07 docs(wiring): align removable perfboard layout
2026-11-07 docs(power): select two DCE001 buck modules
    Record separate 5V supplies for the controller and optical drive, with supplier specifications and the original parameter image. Keep load capacity and USB power isolation pending validation.
2026-11-07 docs(wiring): plan dual-buck perfboard layout
    Add a removable in-case carrier proposal for the MCU, DAC and two buck modules. Align the hole map with the board silkscreen and retain the bench layout as historical reference.
    Record reproducible envelope checks and unresolved enclosure, connector and power-routing constraints.
2026-11-08 feat(enclosure): unify shoulders and shell panels
    Match the top shoulders, move the rear roof into the rear shell, and use 5 mm front panels with an 80 mm body depth. Preserve native colors and update CAD, assembly, slicing and drawing evidence.
    [Discora.FCStd]
2026-11-08 docs(hardware): record four tactile switches
2026-11-08 feat(player): add four-button controls and OLED
    Add play/pause and pause-preserving continuous track navigation,
    with adjacent GPIO assignments and optional SH1106 status output.
    Document wiring, deployment evidence, and remaining hardware checks.
    Validate host sanitizer tests, 77 pin configurations, 15 bench checks,
    and ESP32-S3 builds; confirm OLED no-media display on the board.
2026-11-08 fix(player): rewind at disc end and wrap tracks
    Return to the first playable track after natural disc completion and keep playback stopped. Wrap manual track navigation while preserving pause and stale-read isolation.
    Update host tests, bench completion checks, control documentation and hardware validation records.
    [cd_player.c, cd_player_core.c, cd_player_core.h, cd_player_core_test.c, oled_panel_test.c, player_bench.py, player_bench_test.py, track_buttons_test.c]
2026-11-08 feat(enclosure): add four keys and rear fasteners
    Fit four tactile switches with separate caps and a removable retainer. Move front-cover screws to rear access wells for a clean front face.
    Update the native model, drawings, printing guidance and CAD checks. Physical switch fit, tool access and fastener strength remain unverified.
    [Discora.FCStd]
2026-11-09 fix(usb): guard recovery and diagnose stalls
    Stop recovery for superseded player reads and classify disconnects during timeout cleanup. Add bounded CSW diagnostics and regression coverage while retaining the default deadlines and recovery budget.
    Record USB investigation, deployment and user-confirmed basic button acceptance. Host tests and three ESP-IDF configurations passed; physical fault-cancellation validation remains pending.
    [cd_player.c, cd_player.h, cd_player_core.c, cd_player_core.h, cdda_recovery_test.c, run_host_tests.py, transfer_wait.c, transfer_wait_test.c]
2026-11-09 docs: consolidate status and refresh guidance
    Replace duplicated experiment histories with a record index and update deployment, wiring and validation guidance to match current evidence.
    Document artifact retention and ignore generated profile builds and temporary review files. Preserve dated records, firmware sources and CAD artifacts.
2026-11-09 fix(player): use unsigned track wrap arithmetic
    Cast the track count to size_t before subtracting so GCC does not reject backward navigation under -Werror=sign-compare. Preserve existing wrap behavior and warning checks.
    Verify the old/new GCC diagnostic, host sanitizer suite, 17 bench tests and ESP-IDF v5.4 four-button OLED build. Record the CI failure and validation without changing the deployed firmware.
    [cd_player_core.c]
2026-11-09 fix(enclosure): open button retainer for wiring
    Replace the solid backing plate with an open support frame and two pads per switch. Preserve the mounting screws and reserve clearance for directly soldered leads.
    Update the CAD model, switch reference, drawings and validation reports. CAD and slicing checks pass; physical bearing contact and soldered fit remain unverified.
    [Discora.FCStd]
2026-11-09 feat(oled): add Chinese progress and CD-Text probe
    Replace static labels with Chinese playback state and per-track progress.
    Keep curve numbers when CD-Text is absent, and reject stale TOC metadata
    if the optional probe observes media loss or a unit attention.
    Add protocol and publication regressions, a CD-Text CI build, font
    licensing and device evidence. The probe stays disabled by default.
    [cd_player_core.c, cd_player_core.h, cdtext_probe_test.c, generate_oled_font.py, oled_display.c, oled_panel.c, oled_panel_test.c]
2026-11-09 feat(enclosure): add recessed speaker grille
    Extend the perforated sheet beneath the circular front opening
    and recess its face by 2.5 mm while preserving internal clearances.
    Refresh the saved CAD, drawings, previews and geometry/print checks.
    [Discora.FCStd]
2026-11-09 feat(player): add optional CD read speed limits
    Add disabled-by-default 2x/4x requests before publishing the TOC to
    reduce drive noise. Preserve playback policy for unsupported commands
    and reject stale media after source or transport failures.
    Document verified app-only deployment and short playback comparisons:
    2x reduced audible noise; host tests and three IDF 5.4 builds passed.
    Full-disc stability remains unverified.
    [probe_protocol.c, probe_protocol.h, probe_protocol_test.c, read_speed_test.c, run_host_tests.py]
2026-11-09 fix(enclosure): fit OLED close to sloped face
    Match the module drawing, keep the display centered, and add a recessed seat, flared opening and removable retainer.
    Refresh CAD checks, assembly paths, print evidence and the six-page drawing book for the 1 mm glass setback.
    [Discora.FCStd]
2026-11-10 docs(wiring): integrate USB direct-power diagram
    Consolidate GPIO19/20 wiring and dual DCE001 power guidance in the main wiring page. Document backfeed boundaries and flashing transitions while retaining planned hardware validation status.
2026-11-10 fix(enclosure): match colors to Bambu filaments
    Use PLA Lite Orange for the front shell and PLA Basic Gray for the buttons and volume knob.
    Preserve geometry and refresh previews, the drawing book, and saved-color verification.
    [Discora.FCStd]
2026-11-10 feat(enclosure): add dual-color PLA keys
    Use orange key bodies with flush white PLA symbols and a black volume knob for clearer controls.
    Add multipart 3MF export and slicing evidence, preserve the mounting geometry, and refresh drawings and print guidance.
    [Discora.FCStd]
2026-11-10 feat(enclosure): integrate and brace side ports
    Fuse the mirrored side ports into the rear shell and add four-point inset supports to reduce printing and assembly parts while preserving carrier removal.
    Update printable parts, drawings and geometry/slicing evidence. Keep acoustic tuning and physical strength unverified.
    [Discora.FCStd]
2026-11-10 feat(enclosure): raise and thicken handle
    Raise the handle 20 mm and use a centered 90 x 24 mm opening, leaving
    10.5 mm upper and lower rails while preserving the remaining assembly.
    Refresh CAD checks, previews, the drawing book and print guidance.
    Validate symmetry, clearance and slicing; physical load testing remains open.
    [Discora.FCStd]
2026-11-10 feat(enclosure): add B50K dual-color cross knob
    Record the selected switched potentiometer and supplier characteristics. Fit the front shell and recessed press-fit cross knob to the supplied shaft, body and nut dimensions.
    Add a flush white index and two-material 3MF export with verified white toolpaths. Refresh geometry checks, print records, previews and the drawing book; physical fit remains unverified.
    [Discora.FCStd]
2026-11-11 fix(enclosure): make rear profile symmetric
    Keep the front rim at 5 mm and meet the rear roof without a
    protruding step. Center the side ports and matching carrier outlets
    on the symmetric rear housing.
    Refresh CAD, drawings and geometry, assembly and slicing evidence.
    Physical fit and load testing remain pending.
    [Discora.FCStd]
2026-11-11 feat(enclosure): thicken rear shell to 5 mm
    Expand the shell to retain internal clearances, carry forward the R4 bottom corners, and update the drive removal path and drawing book.
    [Discora.FCStd]
2026-11-12 feat(enclosure): fit measured rear-wall drive mount
    Use a centered 170 mm enclosure and a two-screw retainer for the measured
    UJ-898, reserving space for its SATA adapter and natural cable bend.
    Update CAD, drawings, assembly guidance and geometry/slicing evidence.
    [Discora.FCStd]
2026-11-12 docs(enclosure): refresh drive mount handoff
    Align enclosure docs with the measured drive model and preserve baseline comparison evidence in recheck commands. Add a closeout handoff with verified Git state, report hashes, and physical validation limits.
2026-11-12 docs: streamline CD playback acceptance
    Record repeated end-to-end playback and retire scope-dependent and duplicate tests.
    Keep power, USB recovery, and physical integration checks in scope.
2026-11-13 feat(enclosure): fit PCB volume control module
    Rotate the B50K PCB module to clear the controller and enlarge the inner mounting pocket while preserving the knob position.
    Record interference, symmetry, assembly and front-shell slicing checks, and document service order and nominal hardware dimensions.
    [Discora.FCStd]
2026-11-14 docs(enclosure): sync PCB volume drawing book
    Add the PCB volume module detail page and refresh exploded views, previews, and printing data against the saved module CAD revision.
    Verify all seven rendered pages, model hashes, geometry checks, and drawing script syntax.
2026-11-14 feat(enclosure): integrate perfboard and harness
    Mount the controller, DAC and dual bucks on a shared perfboard with three-point support and removable front-cover harnesses.
    Update the nine-page drawing book, wiring and assembly documentation, and CAD, service-path and slicing evidence. Physical fit remains unverified.
    [Discora.FCStd]
2026-11-14 feat(enclosure): fit measured speaker mounts
    Add trial basket openings and four blind screw pilots per driver using the measured dimensions. Update the CAD drawing book and record fit and slicing checks.
    [Discora.FCStd]
2026-11-14 feat(enclosure): reinforce rear screw seats
    Brace the four P3 mounts and two upper rear-access wells. Check driver access and front extraction, and document the ribs and clearances in the color drawing book.
    [Discora.FCStd]
2026-11-14 docs(enclosure): record speaker coupon fit
2026-11-14 feat(enclosure): finalize ducts and print package
    Preserve the fitted speaker seats while adding printable independent ducts,
    serviceable wire exits and paired trapezoid outlets.
    Publish eleven STL parts and six verified 3MF plates, refresh the twelve-page
    drawing book, and consolidate printing and assembly guidance. Full-part fit
    and acoustic acceptance remain pending.
    [ButtonRetainer.stl, Discora-Keys-Orange-White.3mf, Discora-Knob-Black-White.3mf, Discora-P1-FrontShell.3mf, Discora-P2-RearShell.3mf, Discora-P3-SpeakerCarrier.3mf, Discora-Retainers.3mf, Discora.FCStd]
2026-11-14 feat(enclosure): space controls and enlarge knob
    Move the four-button group outward by 4 mm and shift the volume
    module outward by 4 mm and toward the handle by 2 mm. Enlarge the
    knob cross to 28 mm while preserving the shaft interface.
    Update harness routing, CAD checks, print packages and drawings.
    Geometry, assembly paths, harness travel and slicing checks pass;
    full physical assembly remains unverified.
    [Discora-Knob-Black-White.3mf, Discora-P1-FrontShell.3mf, Discora.FCStd, FrontShell.stl, Knob.stl]
